slacshan/MIDI-Projects/Documentation/S25/Images/hex switch.jpg

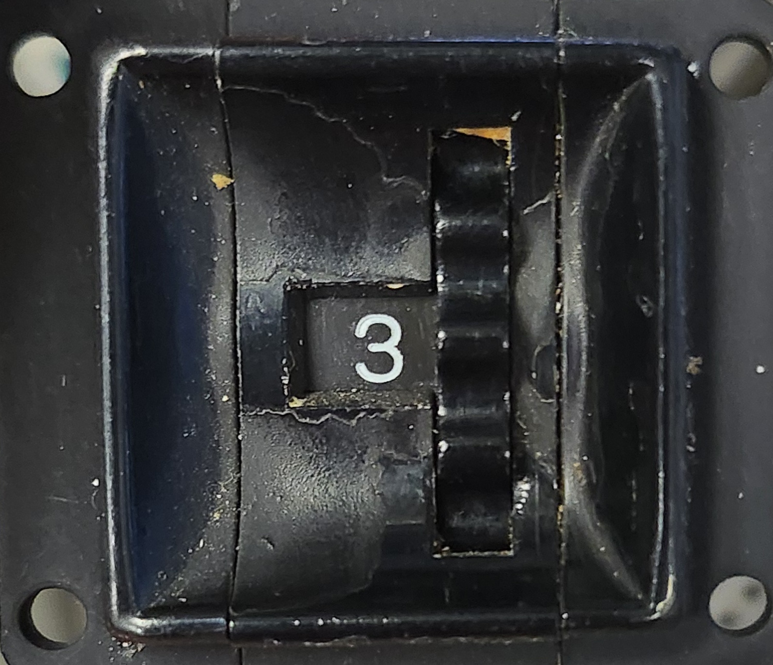
Documentation/S25/Images/hex switch.jpg
