slacshan/MIDI-Projects/Documentation/F25/BOMPt1.pdf

Category | Item Name | Quantity | Unit | Price | Subtotal | CWT Price
| Diode, 0805 | 27 | Each | 0.20 $ | 5.40 $ | 540.00 $
| Diode, LED, 0805 | 37 | Each | 0.91 $ | 33.67 $ | 3,367.00 $
| Diode, IR LED, | 4 | Each | 2.83 $ | 11.32 $ | 1,132.00 $
| Connector, RJ11 | 8 | Each | 1.02 $ | 8.16 $ | 816.00 $
| Connector, MIDI, DIN 5 | 4 | Each | 4.98 $ | 19.92 $ | 1,992.00 $
| Connector, Locking 2 Pin Molex, Board THT F | 53 | Each | 1.67 $ | 88.51 $ | 8,851.00 $
| Connector, Locking 2 Pin Molex, Crimp F | 12 | Each | 0.33 $ | 3.96 $ | 396.00 $
| Connector, Locking 2 Pin Molex, Crimp M | 46 | Each | 0.34 $ | 15.64 $ | 1,564.00 $
| Connector, Locking 8 Pin Molex, Board SMD F | 14 | Each | 3.69 $ | 51.66 $ | 5,166.00 $
| Connector, Locking 8 Pin Molex, Crimp M | 12 | Each | 0.54 $ | 6.48 $ | 648.00 $
| Pin, Molex, F | 188 | Each | 0.10 $ | 18.80 $ | 1,880.00 $
| Pin, Molex, M | 24 | Each | 0.10 $ | 2.40 $ | 240.00 $
| Capacitor, 10µF, Radial THT | 3 | Each | 0.29 $ | 0.87 $ | 87.00 $
| Header, 100mils | 28 | Row of 30 | 4.51 $ | 4.51 $ | 451.00 $
| Resistor, 2Ω, 2W | 8 | Each | 5.87 $ | 46.96 $ | 4,696.00 $
| Resistor, 330Ω, 0805 | 5 | Each | 0.33 $ | 1.65 $ | 165.00 $
| Resistor, 330Ω, SIP | 4 | Each | 4.28 $ | 17.12 $ | 1,712.00 $
| Resistor, 1KΩ, 0805 | 48 | Each | 0.25 $ | 12.00 $ | 1,200.00 $
| Resistor, 1KΩ, SIP | 1 | Each | 2.43 $ | 2.43 $ | 243.00 $
| Resistor, 2.2KΩ, 0805 | 6 | Each | 0.10 $ | 0.60 $ | 60.00 $
| Resistor, 10KΩ, 0805 | 4 | Each | 0.49 $ | 1.96 $ | 196.00 $
| Resistor, 10KΩ, SIP | 1 | Each | 2.53 $ | 2.53 $ | 253.00 $
| MOSFET, IRF540N, TO-220 | 24 | Each | 1.75 $ | 42.00 $ | 4,200.00 $
| MOSFET, MCP14E3, SOIC | 2 | Each | 2.35 $ | 4.70 $ | 470.00 $
| Switch, Push Button, THT | 3 | Each | 0.31 $ | 0.93 $ | 93.00 $
| Switch, SPST, 8 Pin DIP | 2 | Each | 0.59 $ | 1.18 $ | 118.00 $
| Crystal, 1MHz, DIP | 1 | Each | 3.45 $ | 3.45 $ | 345.00 $
| Opto-Isolator, LTV-247 | 6 | Each | 1.10 $ | 6.60 $ | 660.00 $
| Microprocessor, PIC16F1788, SOIC | 3 | Each | 2.63 $ | 7.89 $ | 789.00 $
| Wire, 22AWG, Solid | 110 | Feet | 1.17 $ | 128.70 $ | $ 12,870.00
| PCB, Universal Master | 1 | Each | 3.36 $ | 3.36 $ | 336.00 $
| | 2 | Each | 2.99 $ | 5.98 $ | 598.00 $

PCB, Universal Slave Electrical Page 89
