slacshan/MIDI-Projects/Documentation/F25/BOMPt2.pdf

Category | Item Name | Quantity | Unit | Price | Subtotal | CWT Price
| PCB, Universal Solenoid Relay | 6 | Each | 3.14 $ | 18.84 $ | 1,884.00 $
| PCB, MIDI IR Tx | 1 | Each | 3.79 $ | 3.79 $ | 379.00 $
| 2020 Extrusion Aluminnium, Black | 14 | Feet | 4.50 $ | 63.00 $ | 6,300.00 $
| Bolt, M5 x 10mm | 72 | Pack of 25 | 9.96 $ | 29.88 $ | 2,988.00 $
| Nut, M5 2020 extrusion nut | 72 | Pack of 100 | 9.99 $ | 9.99 $ | 999.00 $
| Bolt, M4 x 6mm | 48 | Pack of 100 | 11.71 $ | 11.71 $ | 585.50 $
| Bolt, M3 x 5mm | 24 | Pack of 100 | 11.91 $ | 11.91 $ | 297.75 $
| Insert, M3 | 40 | Pack of 100 | 20.44 $ | 20.44 $ | 1,022.00 $
| Insert, 1/4"-20 | 4 | Pack of 25 | 6.67 $ | 6.67 $ | 133.40 $
| Bolt, 1/4"-20 x 3/4" | 4 | Pack of 100 | 6.90 $ | 6.90 $ | 34.50 $
| Solenoid, 25N | 24 | Each | 28.44 $ | 682.56 $ | $ 68,256.00
| Solenoid, 5N | 12 | Each | 5.00 $ | 60.00 $ | 6,000.00 $
| Bass Guitar | 1 | Each | 122.99 $ | 122.99 $ | $ 12,299.00
| Payden Hardware Filament, 1.75mm | 324 | Grams, 1Kg Spool | 15.99 $ | 15.99 $ | 1,599.00 $
| Bolt, M2 x 12mm | 24 | Pack of 100 | 16.79 $ | 16.79 $ | 402.96 $
| Nut, M2 | 24 | Pack of 50 | 7.35 $ | 7.35 $ | 367.50 $
| Weather stripping, 3/8" | 3.5 | Feet, 20ft Roll | 9.49 $ | 9.49 $ | 56.94 $
| | 3 | Feet, 1000ft Roll | 364.86 $ | 364.86 $ | 364.86 $
| Cable, 4 Wire, 18 AWG Labor Justin | 174 | Hours | 50.00 $ | $ 8,700.00 | $ 8,700.00
| Brandon | 66 | Hours | 50.00 $ | $ 3,300.00 | $ 3,300.00
| Jason | 84 | Hours | 50.00 $ | $ 4,200.00 | $ 4,200.00
| | 104 | Hours | 50.00 $ | $ 5,200.00 | $ 5,200.00

Electrical Page 90
