slacshan/MIDI-Projects/BassGuitar/Programming/F25/Pluck&MuteFlowCharts.png

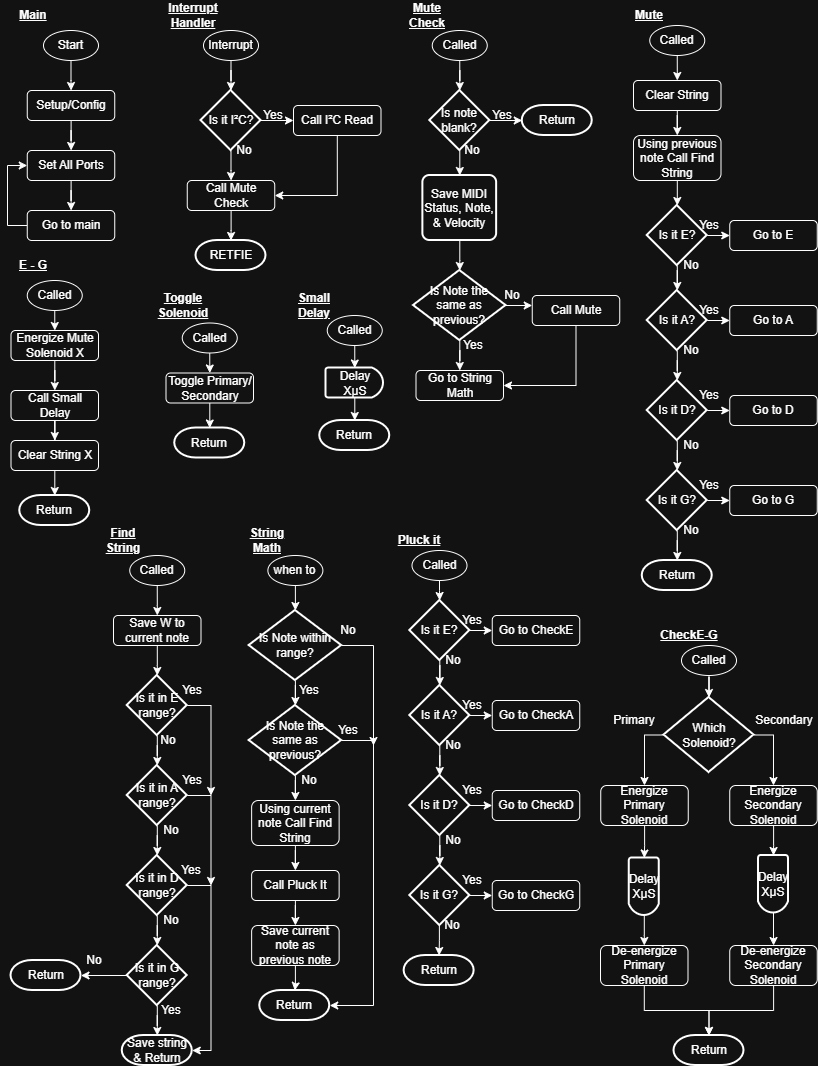
BassGuitar/Programming/F25/Pluck&MuteFlowCharts.png
