slacshan/MIDI-Projects/Documentation/F25/Time Sheet Jason Permann.png

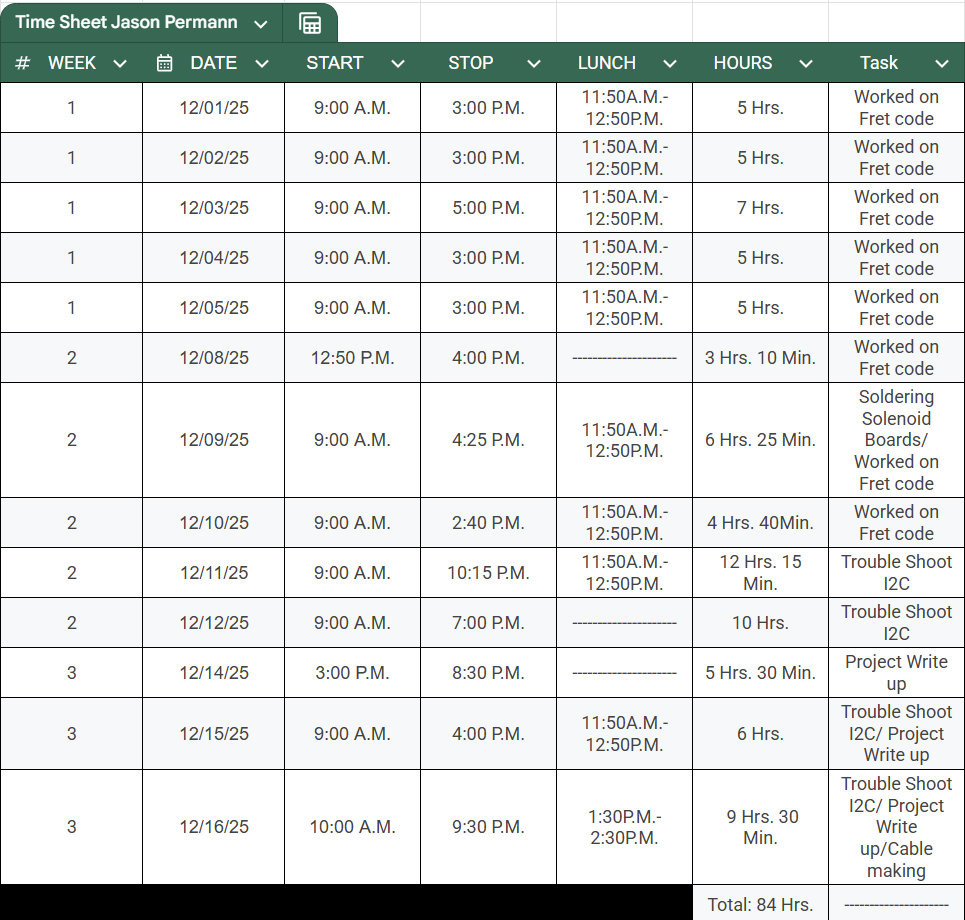
Documentation/F25/Time Sheet Jason Permann.png
