slacshan/MIDI-Projects/Documentation/S25/Images/I2C TP.png

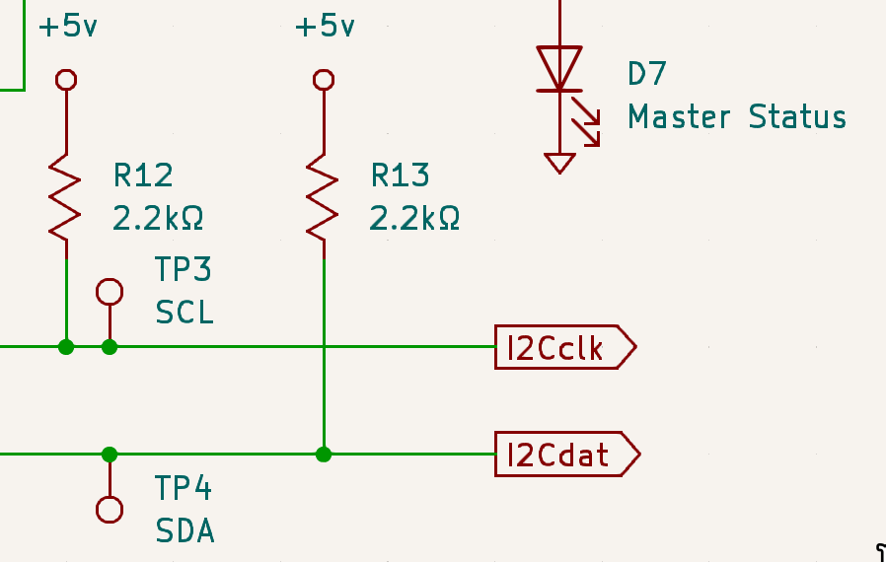
Documentation/S25/Images/I2C TP.png
