slacshan/MIDI-Projects/Documentation/S25/Images/I2C waveform.jpg

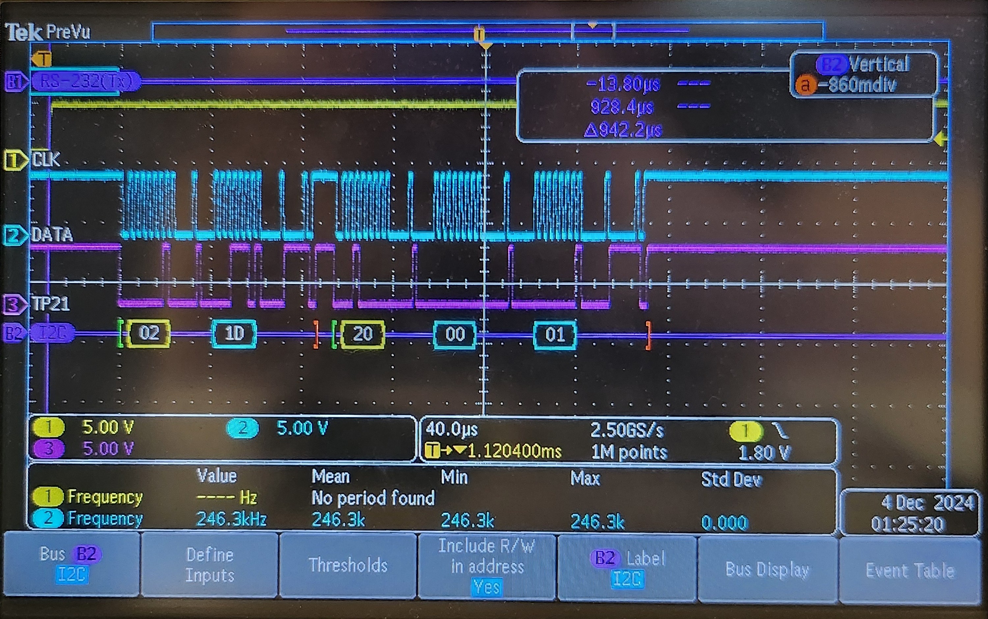
Documentation/S25/Images/I2C waveform.jpg
