slacshan/MIDI-Projects/Documentation/S25/Images/MIDI TP.png

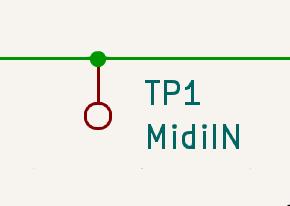
Documentation/S25/Images/MIDI TP.png
