slacshan/MIDI-Projects/Documentation/S25/Images/Midi Waveform.jpg

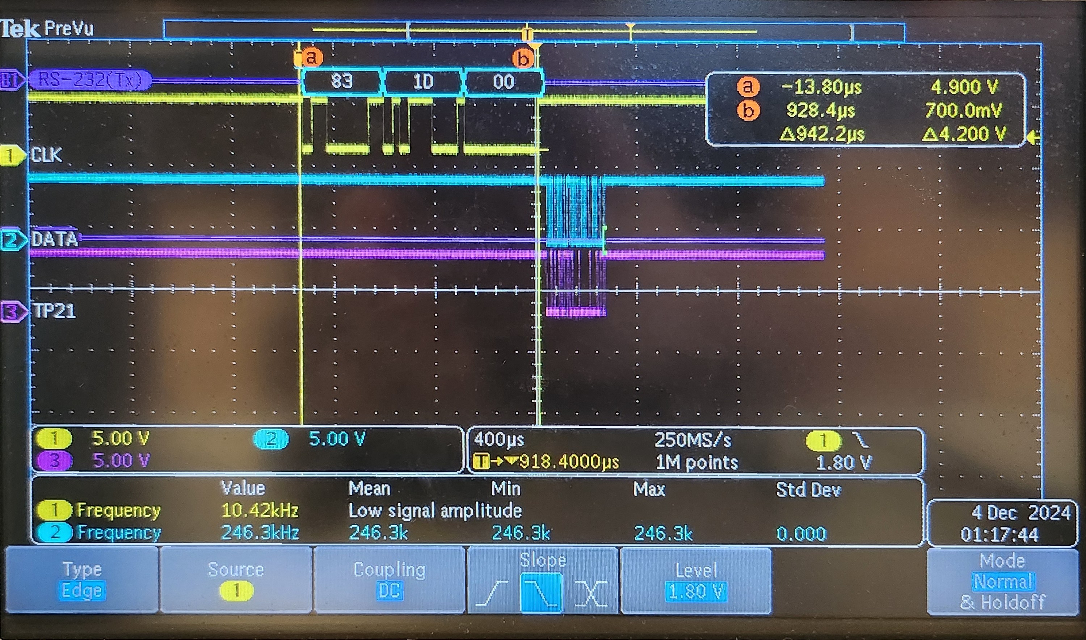
Documentation/S25/Images/Midi Waveform.jpg
