slacshan/MIDI-Projects/Documentation/S25/Images/P-bass CAD asm.png

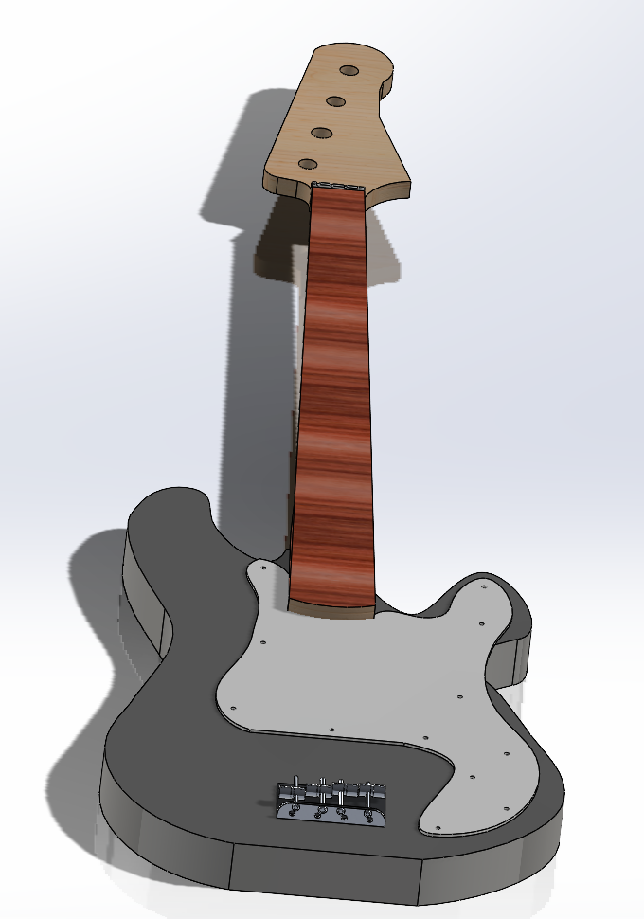
Documentation/S25/Images/P-bass CAD asm.png
