slacshan/MIDI-Projects/Documentation/S25/Images/Plucking Output.png

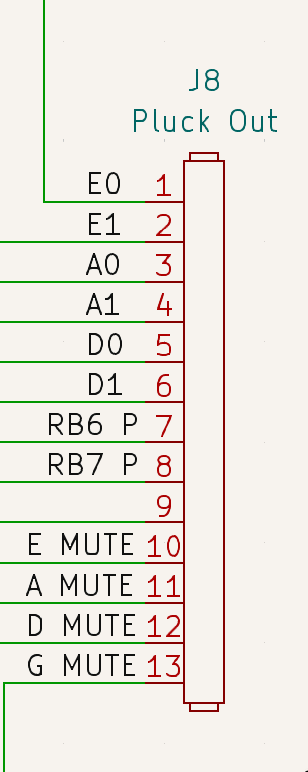
Documentation/S25/Images/Plucking Output.png
