slacshan/MIDI-Projects/Documentation/S25/Images/Plucking Program Flowchart.png

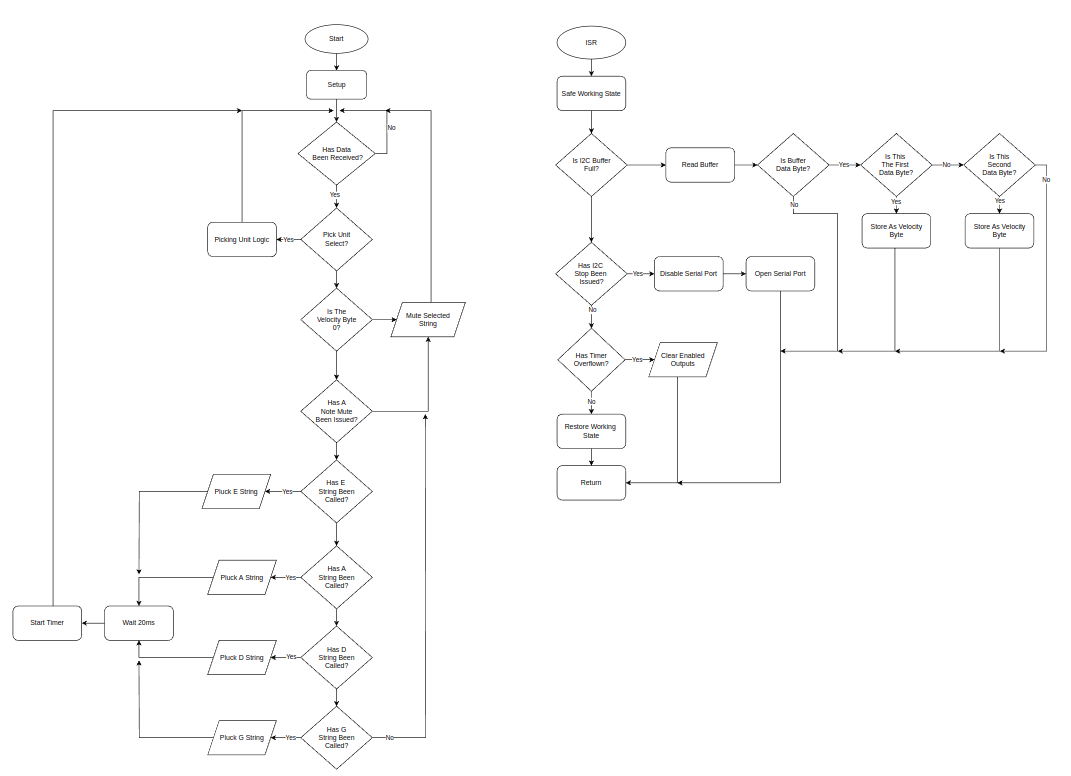
Documentation/S25/Images/Plucking Program Flowchart.png
