slacshan/MIDI-Projects/Documentation/S25/Images/Plucking Unit Flowchart.png

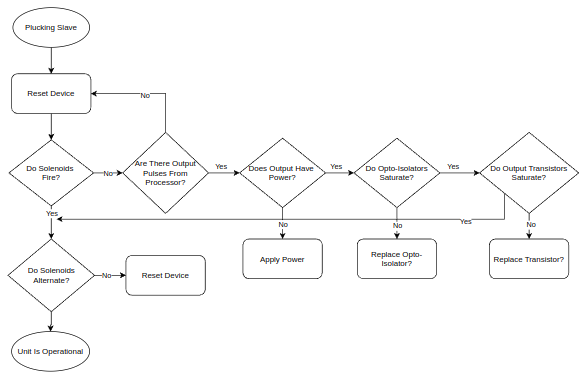
Documentation/S25/Images/Plucking Unit Flowchart.png
