slacshan/MIDI-Projects/Documentation/S25/Images/String Output.png

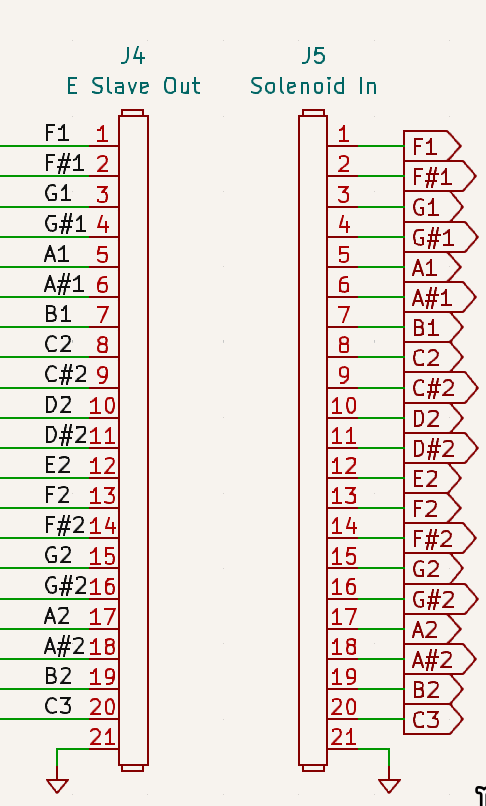
Documentation/S25/Images/String Output.png
