slacshan/MIDI-Projects/Documentation/S25/Images/String Slave Flowchart.png

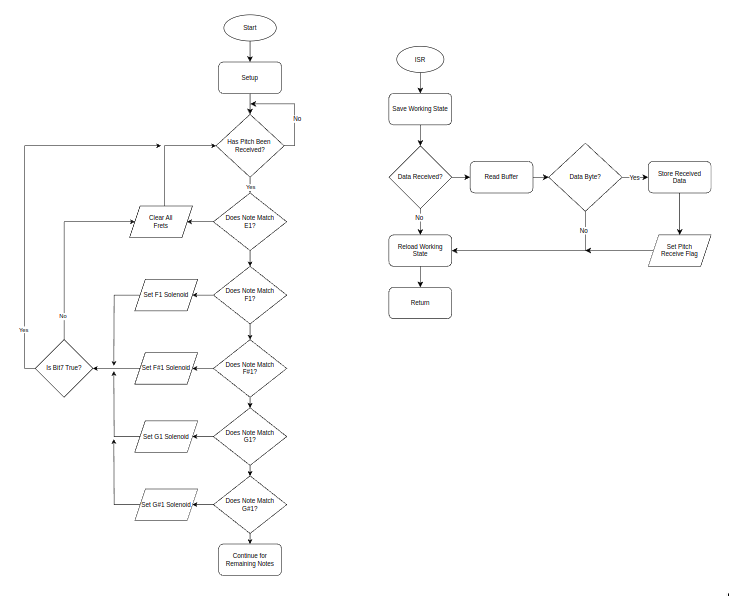
Documentation/S25/Images/String Slave Flowchart.png
