slacshan/MIDI-Projects/Documentation/F25/BOM.xlsx

Sheet: Sheet1
Category | Item Name | Quantity | Unit | Price | Subtotal | CWT Price | Vender Name/ID | Vendor | Item Link
 | Diode, 0805 | 27 | Each | $0.20 | $5.40 | $540.00 | 478-SD0805S040S1R0CT-ND | Digikey | https://www.digikey.com/en/products/detail/kyocera-avx/SD0805S040S1R0/13557251
 | Diode, LED, 0805 | 37 | Each | $0.91 | $33.67 | $3367.00 | 607-CMDA5AR7D1S | Mouser | https://www.mouser.com/ProductDetail/VCC/CMDA5AR7D1S?qs=sGAEpiMZZMvVL5Kk7ZYykXsk1Jcl2Lhjdx6FZebcgbk%3D
 | Diode, IR LED, | 4 | Each | $2.83 | $11.32 | $1132.00 | 78-VSMA1094250 | Mouser | https://www.mouser.com/ProductDetail/Vishay-Semiconductors/VSMA1094250?qs=pBJMDPsKWf2rcBfgrt%252BzqQ%3D%3D
 | Connector, RJ11 | 8 | Each | $1.02 | $8.16 | $816.00 | 710-615004141121 | Mouser | https://www.mouser.com/ProductDetail/710-615004141121
 | Connector, MIDI, DIN 5 | 4 | Each | $4.98 | $19.92 | $1992.00 | 502-57PC5F | Mouser | https://www.mouser.com/ProductDetail/Switchcraft/57PC5F?qs=MW%252B0w7tSdpkWuZd7MBoFPA%3D%3D
 | Connector, Locking 2 Pin Molex, Board THT F | 53 | Each | $1.67 | $88.51 | $8851.00 | WM1819-ND | Digikey | https://www.digikey.com/en/products/detail/molex/0430450202/252532
 | Connector, Locking 2 Pin Molex, Crimp F | 12 | Each | $0.33 | $3.96 | $396.00 | WM2761-ND | Digikey | https://www.digikey.com/en/products/detail/molex/0430200201/1132437
 | Connector, Locking 2 Pin Molex, Crimp M | 46 | Each | $0.34 | $15.64 | $1564.00 | WM1783-ND | Digikey | https://www.digikey.com/en/products/detail/molex/0430250200/252496
 | Connector, Locking 8 Pin Molex, Board SMD F | 14 | Each | $3.69 | $51.66 | $5166.00 | WM1828CT-ND | Digikey | https://www.digikey.com/en/products/detail/molex/0430450809/3660014
 | Connector, Locking 8 Pin Molex, Crimp M | 12 | Each | $0.54 | $6.48 | $648.00 | WM1786-ND | Digikey | https://www.digikey.com/en/products/detail/molex/0430250800/252499
 | Pin, Molex, F | 188 | Each | $0.10 | $18.80 | $1880.00 | WM1837CT-ND | Digikey | https://www.digikey.com/en/products/detail/molex/0430300001/467796
 | Pin, Molex, M | 24 | Each | $0.10 | $2.40 | $240.00 | WM1841CT-ND | Digikey | https://www.digikey.com/en/products/detail/molex/0430310001/467798?s=N4IgTCBcDaIOoFkCMAOALEgwgFQLQDkAREAXQF8g
 | Capacitor, 10µF, Radial THT | 3 | Each | $0.29 | $0.87 | $87.00 | 1189-2322-ND | Digikey | https://www.digikey.com/en/products/detail/rubycon/50YXJ10M5X11/3562914
 | Header, 100mils | 28 | Row of 30 | $4.51 | $4.51 | $451.00 | 612-TS-130-T-A-1-ND | Digikey | https://www.digikey.com/en/products/detail/samtec-inc/TS-130-T-A-1/9774113
Electrical | Resistor, 2Ω, 2W | 8 | Each | $5.87 | $46.96 | $4696.00 | 652-PWR220T-20-2R00F | Mouser | https://www.mouser.com/ProductDetail/Bourns/PWR220T-20-2R00F?qs=sGAEpiMZZMtlubZbdhIBIIFas8kKGM5fidmq4iLVFG8%3D
 | Resistor, 330Ω, 0805 | 5 | Each | $0.33 | $1.65 | $165.00 | 594-MCU08050C3300FP5 | Mouser | https://www.mouser.com/ProductDetail/Vishay-Beyschlag/MCU08050C3300FP500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
 | Resistor, 330Ω, SIP | 4 | Each | $4.28 | $17.12 | $1712.00 | 652-4309R-1LF-330 | Mouser | https://www.mouser.com/ProductDetail/Bourns/4309R-101-331LF?qs=RXY66VkWzhTIgmSSRT6%2FDg%3D%3D
 | Resistor, 1KΩ, 0805 | 48 | Each | $0.25 | $12.00 | $1200.00 | 667-ERA-6AED102V | Mouser | https://www.mouser.com/ProductDetail/Panasonic/ERA-6AED102V
 | Resistor, 1KΩ, SIP | 1 | Each | $2.43 | $2.43 | $243.00 | 71-CSC09A011K00FEK | Mouser | https://www.mouser.com/ProductDetail/Vishay-Dale/CSC09A011K00FEK?qs=OgjFRtkRU9G%252B5xvKRBL7NA%3D%3D
 | Resistor, 2.2KΩ, 0805 | 6 | Each | $0.10 | $0.60 | $60.00 | 667-ERA-6AED222V | Mouser | https://www.mouser.com/ProductDetail/Panasonic/ERA-6AED222V?qs=sGAEpiMZZMvdGkrng054t5mej2KPdPuFyxnSeBnKqrg%3D
 | Resistor, 10KΩ, 0805 | 4 | Each | $0.49 | $1.96 | $196.00 | 594-MCU0805MD1002BP5 | Mouser | https://www.mouser.com/ProductDetail/Vishay-Beyschlag/MCU0805MD1002BP500
 | Resistor, 10KΩ, SIP | 1 | Each | $2.53 | $2.53 | $253.00 | 71-CSC09A0110K0GEK | Mouser | https://www.mouser.com/ProductDetail/Vishay-Dale/CSC09A0110K0GEK?qs=Jzz%252BfO4IBMfusae2i1IhQQ%3D%3D | For Presentation
 | MOSFET, IRF540N, TO-220 | 24 | Each | $1.75 | $42.00 | $4200.00 | IRF540NPBF-ND | Digikey | https://www.digikey.com/en/products/detail/infineon-technologies/IRF540NPBF/811869 | Electronics | $583.97
 | MOSFET, MCP14E3, SOIC | 2 | Each | $2.35 | $4.70 | $470.00 | MCP14E3-E/SN-ND | Digikey | https://www.digikey.com/en/products/detail/microchip-technology/MCP14E3-E-SN/1680842 | Hardware | $1440.53
 | Switch, Push Button, THT | 3 | Each | $0.31 | $0.93 | $93.00 | 506-FSM2JSMAATR | Mouser | https://www.mouser.com/ProductDetail/TE-Connectivity-Alcoswitch/FSM2JSMAATR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 | Labor | $21400.00
 | Switch, SPST, 8 Pin DIP | 2 | Each | $0.59 | $1.18 | $118.00 | CT2104MS-ND | Digikey | https://www.digikey.com/en/products/detail/cts-electrocomponents/210-4MS/2503781 | Total | $23424.50
 | Crystal, 1MHz, DIP | 1 | Each | $3.45 | $3.45 | $345.00 | 110-MXO45HST-3C-1M000000-ND | Digikey | https://www.digikey.com/en/products/detail/cts-frequency-controls/MXO45HST-3C-1M000000/1801908
 | Opto-Isolator, LTV-247 | 6 | Each | $1.10 | $6.60 | $660.00 | 160-2255-1-ND | Digikey | https://www.digikey.com/en/products/detail/liteon/LTV-247/4307982?s=N4IgTCBcDaIDYBcBuBaMAWA7CAugXyA
 | Microprocessor, PIC16F1788, SOIC | 3 | Each | $2.63 | $7.89 | $789.00 | PIC16F1788-I/SO-ND | Digikey | https://www.digikey.com/en/products/detail/microchip-technology/PIC16F1788-I-SO/4080106
 | Wire, 22AWG, Solid | 110 | Feet | $1.17 | $128.70 | $12870.00 | 566-83049-100-06 | Mouser | https://www.mouser.com/ProductDetail/Belden-Wire-Cable/83049-006100?qs=OVCqYLLnee0zC1gM5G5Wqw%3D%3D
 | PCB, Universal Master | 1 | Each | $3.36 | $3.36 | $336.00 | JB_MIDI_Master | All PCB | N/A
 | PCB, Universal Slave | 2 | Each | $2.99 | $5.98 | $598.00 | JB_MIDI_Slave | PCB way | N/A
 | PCB, Universal Solenoid Relay | 6 | Each | $3.14 | $18.84 | $1884.00 | JB_Solenoid | PCB way | N/A
 | PCB, MIDI IR Tx | 1 | Each | $3.79 | $3.79 | $379.00 | JB_IR_Tx | PCB way | N/A
Hardware | 2020 Extrusion Aluminnium, Black | 14 | Feet | $4.50 | $63.00 | $6300.00 | B08Y8M383Q | Amazon | https://www.amazon.com/Aluminum-Extrusion-European-Standard-15-75inch/dp/B08Y8M383Q
 | Bolt, M5 x 10mm | 72 | Pack of 25 | $9.96 | $29.88 | $2988.00 | 92137A414 | McMASTER-CARR | https://www.mcmaster.com/92137A414/
 | Nut, M5 2020 extrusion nut | 72 | Pack of 100 | $9.99 | $9.99 | $999.00 |  | Amazon | https://www.amazon.com/Yaocom-European-Standard-Aluminum-Extrusion/dp/B0DX7B5ZNN
 | Bolt, M4 x 6mm | 48 | Pack of 100 | $11.71 | $11.71 | $585.50 | 91290A139 | McMASTER-CARR | https://www.mcmaster.com/91290A139/
 | Bolt, M3 x 5mm | 24 | Pack of 100 | $11.91 | $11.91 | $297.75 | 91290A110 | McMASTER-CARR | https://www.mcmaster.com/91290A110/
 | Insert, M3 | 40 | Pack of 100 | $20.44 | $20.44 | $1022.00 | 94180A331 | McMASTER-CARR | https://www.mcmaster.com/94180A331/
 | Insert, 1/4"-20 | 4 | Pack of 25 | $6.67 | $6.67 | $133.40 | 92105A208 | McMASTER-CARR | https://www.mcmaster.com/92105A208/
 | Bolt, 1/4"-20 x 3/4" | 4 | Pack of 100 | $6.90 | $6.90 | $34.50 | 91309A540 | McMASTER-CARR | https://www.mcmaster.com/91309A540/
 | Solenoid, 25N | 24 | Each | $28.44 | $682.56 | $68256.00 | B0DJVL6MHG | Amazon | https://www.amazon.com/AARTERZZA-JF-1039B-Push-Pull-Solenoid-Electromagnet/dp/B0DJVL6MHG?th=1
 | Solenoid, 5N | 12 | Each | $5.00 | $60.00 | $6000.00 | B07V3JRDLJ | Amazon | https://www.amazon.com/JF-0530B-gangbei-0530B-Electromagnet-keepping-Solenoid/dp/B07V3JRDLJ?th=1
 | Bass Guitar | 1 | Each | $122.99 | $122.99 | $12299.00 | B09CTHDSCM | Amazon | https://www.amazon.com/GLARRY-Electric-Beginner-Exquisite-Accessories/dp/B09CTHDSCM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
 | Filament, 1.75mm | 324 | Grams, 1Kg Spool | $15.99 | $15.99 | $1599.00 | B0C3J1X41K | Amazon | https://www.amazon.com/SUNLU-Printer-Filament-Dimensional-Clear/dp/B0C3J1X41K
 | Bolt, M2 x 12mm | 24 | Pack of 100 | $16.79 | $16.79 | $402.96 | 91290A019 | McMASTER-CARR | https://www.mcmaster.com/91290A019/
 | Nut, M2 | 24 | Pack of 50 | $7.35 | $7.35 | $367.50 | 90593A024 | McMASTER-CARR | https://www.mcmaster.com/90593A024/
 | Weather stripping, 3/8" | 3.5 | Feet, 20ft Roll | $9.49 | $9.49 | $56.94 | B0DHZ3M2PP | Amazon | https://www.amazon.com/Weather-Stripping-Adhesive-Silicone-Shaped/dp/B0DHZ3M2PP
 | Cable, 4 Wire, 18 AWG | 3 | Feet, 1000ft Roll | $364.86 | $364.86 | $364.86 | CE2204SN-41-1000-ND | Digikey | https://www.digikey.com/en/products/detail/encore-wire/E2204S-41-86/618553
Labor | Justin | 174 | Hours | $50.00 | $8700.00 | $8700.00 | N/A | N/A | N/A
 | Brandon | 66 | Hours | $50.00 | $3300.00 | $3300.00 | N/A | N/A | N/A
 | Jason | 84 | Hours | $50.00 | $4200.00 | $4200.00 | N/A | N/A | N/A
 | Payden | 104 | Hours | $50.00 | $5200.00 | $5200.00 | N/A | N/A | N/A

Sheet: Print1
Page 89 | Category | Item Name | Quantity | Unit | Price | Subtotal | CWT Price
 | Electrical | Diode, 0805 | 27 | Each | $0.20 | $5.40 | $540.00
 |  | Diode, LED, 0805 | 37 | Each | $0.91 | $33.67 | $3367.00
 |  | Diode, IR LED, | 4 | Each | $2.83 | $11.32 | $1132.00
 |  | Connector, RJ11 | 8 | Each | $1.02 | $8.16 | $816.00
 |  | Connector, MIDI, DIN 5 | 4 | Each | $4.98 | $19.92 | $1992.00
 |  | Connector, Locking 2 Pin Molex, Board THT F | 53 | Each | $1.67 | $88.51 | $8851.00
 |  | Connector, Locking 2 Pin Molex, Crimp F | 12 | Each | $0.33 | $3.96 | $396.00
 |  | Connector, Locking 2 Pin Molex, Crimp M | 46 | Each | $0.34 | $15.64 | $1564.00
 |  | Connector, Locking 8 Pin Molex, Board SMD F | 14 | Each | $3.69 | $51.66 | $5166.00
 |  | Connector, Locking 8 Pin Molex, Crimp M | 12 | Each | $0.54 | $6.48 | $648.00
 |  | Pin, Molex, F | 188 | Each | $0.10 | $18.80 | $1880.00
 |  | Pin, Molex, M | 24 | Each | $0.10 | $2.40 | $240.00
 |  | Capacitor, 10µF, Radial THT | 3 | Each | $0.29 | $0.87 | $87.00
 |  | Header, 100mils | 28 | Row of 30 | $4.51 | $4.51 | $451.00
 |  | Resistor, 2Ω, 2W | 8 | Each | $5.87 | $46.96 | $4696.00
 |  | Resistor, 330Ω, 0805 | 5 | Each | $0.33 | $1.65 | $165.00
 |  | Resistor, 330Ω, SIP | 4 | Each | $4.28 | $17.12 | $1712.00
 |  | Resistor, 1KΩ, 0805 | 48 | Each | $0.25 | $12.00 | $1200.00
 |  | Resistor, 1KΩ, SIP | 1 | Each | $2.43 | $2.43 | $243.00
 |  | Resistor, 2.2KΩ, 0805 | 6 | Each | $0.10 | $0.60 | $60.00
 |  | Resistor, 10KΩ, 0805 | 4 | Each | $0.49 | $1.96 | $196.00
 |  | Resistor, 10KΩ, SIP | 1 | Each | $2.53 | $2.53 | $253.00
 |  | MOSFET, IRF540N, TO-220 | 24 | Each | $1.75 | $42.00 | $4200.00
 |  | MOSFET, MCP14E3, SOIC | 2 | Each | $2.35 | $4.70 | $470.00
 |  | Switch, Push Button, THT | 3 | Each | $0.31 | $0.93 | $93.00
 |  | Switch, SPST, 8 Pin DIP | 2 | Each | $0.59 | $1.18 | $118.00
 |  | Crystal, 1MHz, DIP | 1 | Each | $3.45 | $3.45 | $345.00
 |  | Opto-Isolator, LTV-247 | 6 | Each | $1.10 | $6.60 | $660.00
 |  | Microprocessor, PIC16F1788, SOIC | 3 | Each | $2.63 | $7.89 | $789.00
 |  | Wire, 22AWG, Solid | 110 | Feet | $1.17 | $128.70 | $12870.00
 |  | PCB, Universal Master | 1 | Each | $3.36 | $3.36 | $336.00
 |  | PCB, Universal Slave | 2 | Each | $2.99 | $5.98 | $598.00

Sheet: Print2
Page 90
 | Category | Item Name | Quantity | Unit | Price | Subtotal | CWT Price
 | Electrical | PCB, Universal Solenoid Relay | 6 | Each | $3.14 | $18.84 | $1884.00
 |  | PCB, MIDI IR Tx | 1 | Each | $3.79 | $3.79 | $379.00
 | Hardware | 2020 Extrusion Aluminnium, Black | 14 | Feet | $4.50 | $63.00 | $6300.00
 |  | Bolt, M5 x 10mm | 72 | Pack of 25 | $9.96 | $29.88 | $2988.00
 |  | Nut, M5 2020 extrusion nut | 72 | Pack of 100 | $9.99 | $9.99 | $999.00
 |  | Bolt, M4 x 6mm | 48 | Pack of 100 | $11.71 | $11.71 | $585.50
 |  | Bolt, M3 x 5mm | 24 | Pack of 100 | $11.91 | $11.91 | $297.75
 |  | Insert, M3 | 40 | Pack of 100 | $20.44 | $20.44 | $1022.00
 |  | Insert, 1/4"-20 | 4 | Pack of 25 | $6.67 | $6.67 | $133.40
 |  | Bolt, 1/4"-20 x 3/4" | 4 | Pack of 100 | $6.90 | $6.90 | $34.50
 |  | Solenoid, 25N | 24 | Each | $28.44 | $682.56 | $68256.00
 |  | Solenoid, 5N | 12 | Each | $5.00 | $60.00 | $6000.00
 |  | Bass Guitar | 1 | Each | $122.99 | $122.99 | $12299.00
 |  | Filament, 1.75mm | 324 | Grams, 1Kg Spool | $15.99 | $15.99 | $1599.00
 |  | Bolt, M2 x 12mm | 24 | Pack of 100 | $16.79 | $16.79 | $402.96
 |  | Nut, M2 | 24 | Pack of 50 | $7.35 | $7.35 | $367.50
 |  | Weather stripping, 3/8" | 3.5 | Feet, 20ft Roll | $9.49 | $9.49 | $56.94
 |  | Cable, 4 Wire, 18 AWG | 3 | Feet, 1000ft Roll | $364.86 | $364.86 | $364.86
 | Labor | Justin | 174 | Hours | $50.00 | $8700.00 | $8700.00
 |  | Brandon | 66 | Hours | $50.00 | $3300.00 | $3300.00
 |  | Jason | 84 | Hours | $50.00 | $4200.00 | $4200.00
 |  | Payden | 104 | Hours | $50.00 | $5200.00 | $5200.00
