slacshan/MIDI-Projects/BassGuitar/Circuitry/S25/MotherBoard/KicadBOM.ods

Reference | Value | Datasheet | Footprint | Qty | DNP
C1,C2,C3,C4,C5,C6 | 10uF |  | Capacitor_SMD:C_0805_2012Metric_Pad1.18x1.45mm_HandSolder | 6
C7,C9 | 100uF |  |  | 2
C8,C10 | 0.1uF |  |  | 2
D1 | LED | ~ | Diode_SMD:D_0805_2012Metric_Pad1.15x1.40mm_HandSolder | 1
D2 | 8 | ~ | Diode_SMD:D_0805_2012Metric_Pad1.15x1.40mm_HandSolder | 1
D3 | 4 | ~ | Diode_SMD:D_0805_2012Metric_Pad1.15x1.40mm_HandSolder | 1
D4 | 2 | ~ | Diode_SMD:D_0805_2012Metric_Pad1.15x1.40mm_HandSolder | 1
D5,D8,D11,D14,D17,D20 | 4148 |  | Diode_SMD:D_0805_2012Metric_Pad1.15x1.40mm_HandSolder | 6
D6 | 1 | ~ | Diode_SMD:D_0805_2012Metric_Pad1.15x1.40mm_HandSolder | 1
D7 | Master Status | ~ | Diode_SMD:D_0805_2012Metric_Pad1.15x1.40mm_HandSolder | 1
D9 | E Status | ~ | Diode_SMD:D_0805_2012Metric_Pad1.15x1.40mm_HandSolder | 1
D10 | E Active | ~ | Diode_SMD:D_0805_2012Metric_Pad1.15x1.40mm_HandSolder | 1
D12 | Pluck Status | ~ | Diode_SMD:D_0805_2012Metric_Pad1.15x1.40mm_HandSolder | 1
D13 | Pluck Active | ~ | Diode_SMD:D_0805_2012Metric_Pad1.15x1.40mm_HandSolder | 1
D15 | A Status | ~ | Diode_SMD:D_0805_2012Metric_Pad1.15x1.40mm_HandSolder | 1
D16 | A Active | ~ | Diode_SMD:D_0805_2012Metric_Pad1.15x1.40mm_HandSolder | 1
D18 | D Status | ~ | Diode_SMD:D_0805_2012Metric_Pad1.15x1.40mm_HandSolder | 1
D19 | D Active | ~ | Diode_SMD:D_0805_2012Metric_Pad1.15x1.40mm_HandSolder | 1
D21 | G Status | ~ | Diode_SMD:D_0805_2012Metric_Pad1.15x1.40mm_HandSolder | 1
D22 | G Active | ~ | Diode_SMD:D_0805_2012Metric_Pad1.15x1.40mm_HandSolder | 1
J1 | DIN-5 | http://www.mouser.com/ds/2/18/40_c091_abd_e-75918.pdf |  | 1
J2 | Master ISCP |  | Connector_PinHeader_2.54mm:PinHeader_1x06_P2.54mm_Vertical | 1
J3 | E SLAVE ISCP |  | Connector_PinHeader_2.54mm:PinHeader_1x06_P2.54mm_Vertical | 1
J4 | E Slave Out |  |  | 1
J5 | Solenoid In |  |  | 1
J6,J10 | A SLAVE ISCP |  | Connector_PinHeader_2.54mm:PinHeader_1x06_P2.54mm_Vertical | 2
J7 | Pick Unit |  |  | 1
J8 | Pluck Out |  |  | 1
J9 | Pluck IN |  |  | 1
J11 | D SLAVE ISCP |  | Connector_PinHeader_2.54mm:PinHeader_1x06_P2.54mm_Vertical | 1
J12 | G SLAVE ISCP |  | Connector_PinHeader_2.54mm:PinHeader_1x06_P2.54mm_Vertical | 1
J13 | Power In |  |  | 1
L1,L2,L3,L4,L5,L6,L7,L8,L9,L10,L11,L12,L13,L14,L15,L16,L17,L18,L19,L20,L21,L22,L23,L24,L25,L26,L27,L28,L29,L30,L31,L32,L33,L34,L35,L36,L37,L38,L39,L40,L41,L42,L43,L44,L45,L46,L47,L48,L49,L50,L51,L52,L53,L54,L55,L56,L57,L58,L59,L60,L61,L62,L63,L64,L65,L66,L67,L68,L69,L70,L71,L72,L73,L74,L75,L76,L77,L78,L79,L80,L81,L82,L83,L84,L85,L86,L87,L88,L89,L90,L91,L92 | Solenoid | ~ |  | 92
L93 | 10uH | ~ |  | 1
Q1,Q2,Q3,Q4,Q5,Q6,Q7,Q8,Q9,Q10,Q11,Q12,Q13,Q14,Q15,Q16,Q17,Q18,Q19,Q20,Q21,Q22,Q23,Q24,Q25,Q26,Q27,Q28,Q29,Q30,Q31,Q32,Q33,Q34,Q35,Q36,Q37,Q38,Q39,Q40,Q41,Q42,Q43,Q44,Q45,Q46,Q47,Q48,Q49,Q50,Q51,Q52,Q53,Q54,Q55,Q56,Q57,Q58,Q59,Q60,Q61,Q62,Q63,Q64,Q65,Q66,Q67,Q68,Q69,Q70,Q71,Q72,Q73,Q74,Q75,Q76,Q77,Q78,Q79,Q80,Q81,Q82,Q83,Q84,Q85,Q86,Q87,Q88,Q89,Q90,Q91,Q92 | BDW93C | ~ | Package_TO_SOT_THT:TO-220-3_Vertical | 92
R1,R15,R58,R62,R66 | 10Ω |  | Resistor_SMD:R_0805_2012Metric_Pad1.20x1.40mm_HandSolder | 5
R2,R26,R27,R28,R29,R30,R31,R32,R33,R38,R39,R40,R41,R42,R43,R44,R45,R50,R51,R52,R53,R54,R55,R56,R57,R76,R77,R78,R79,R80,R81,R82,R83,R84,R85,R86,R87,R94,R95,R96,R97,R98,R99,R100,R101,R102,R103,R104,R105,R110,R111,R112,R113,R114,R115,R116,R117,R122,R123,R124,R125,R126,R127,R128,R129,R136,R137,R138,R139,R140,R141,R142,R143,R144,R145,R146,R147,R154,R155,R156,R157,R158,R159,R160,R161,R162,R163,R164,R165,R170,R171,R172,R173,R174,R175,R176,R177,R182,R183,R184,R185,R186,R187,R188,R189,R196,R197,R198,R199,R200,R201,R202,R203,R204,R205,R206,R207,R214,R215,R216,R217,R218,R219,R220,R221,R222,R223,R224,R225,R230,R231,R232,R233,R234,R235,R236,R237,R242,R243,R244,R245,R246,R247,R248,R249,R256,R257,R258,R259,R260,R261,R262,R263,R264,R265,R266,R267,R274,R275,R276,R277,R278,R279,R280,R281,R282,R283,R284,R285,R290,R291,R292,R293,R294,R295,R296,R297,R302,R303,R304,R305,R306,R307,R308,R309 | 1kΩ |  | Resistor_SMD:R_0805_2012Metric_Pad1.20x1.40mm_HandSolder | 185
R3,R4,R8,R11,R14,R17,R18,R20,R21,R60,R61,R64,R65,R68,R69 | 330Ω |  | Resistor_SMD:R_0805_2012Metric_Pad1.20x1.40mm_HandSolder | 15
R5,R6,R7,R9,R10,R16,R19,R59,R63,R67 | 10kΩ |  | Resistor_SMD:R_0805_2012Metric_Pad1.20x1.40mm_HandSolder | 10
R12,R13 | 2.2kΩ |  | Resistor_SMD:R_0805_2012Metric_Pad1.20x1.40mm_HandSolder | 2
R22,R23,R24,R25,R34,R35,R36,R37,R46,R47,R48,R49,R70,R71,R72,R73,R74,R75,R88,R89,R90,R91,R92,R93,R106,R107,R108,R109,R118,R119,R120,R121,R130,R131,R132,R133,R134,R135,R148,R149,R150,R151,R152,R153,R166,R167,R168,R169,R178,R179,R180,R181,R190,R191,R192,R193,R194,R195,R208,R209,R210,R211,R212,R213,R226,R227,R228,R229,R238,R239,R240,R241,R250,R251,R252,R253,R254,R255,R268,R269,R270,R271,R272,R273,R286,R287,R288,R289,R298,R299,R300,R301 | 4.7kΩ |  | Resistor_SMD:R_0805_2012Metric_Pad1.20x1.40mm_HandSolder | 92
SW1 | ~ |  | Connector_PinHeader_2.54mm:PinHeader_1x05_P2.54mm_Vertical | 1
SW2 | Master Reset | ~ | Button_Switch_THT:SW_PUSH_6mm_H5mm | 1
SW3 | E-slave Reset | ~ |  | 1
SW4 | A-slave Reset | ~ |  | 1
SW5 | D-slave Reset | ~ |  | 1
SW6 | G-slave Reset | ~ |  | 1
TP1 | MidiIN | ~ | Connector_PinHeader_2.54mm:PinHeader_1x01_P2.54mm_Vertical | 1
TP2 | Master CLKOUT | ~ | Connector_PinHeader_2.54mm:PinHeader_1x01_P2.54mm_Vertical | 1
TP3 | SCL | ~ | Connector_PinHeader_2.54mm:PinHeader_1x01_P2.54mm_Vertical | 1
TP4 | SDA | ~ | Connector_PinHeader_2.54mm:PinHeader_1x01_P2.54mm_Vertical | 1
TP5 | E CLKOUT | ~ |  | 1
TP6 | PLUCK CLKOUT | ~ |  | 1
TP7 | A CLKOUT | ~ |  | 1
TP8 | D CLKOUT | ~ |  | 1
TP9 | G CLKOUT | ~ |  | 1
TP10 | P-IN | ~ |  | 1
TP11 | 5v | ~ |  | 1
U1 | PIC16F1788 | http://ww1.microchip.com/downloads/en/DeviceDoc/41291D.pdf | OF footprints:SSOP-28 | 1
U2,U3,U8,U9,U10 | PIC16F1789 |  |  | 5
U4,U5,U6,U7,U11,U12,U13,U14,U15,U16,U17,U18,U19,U20,U21,U22,U23,U24,U25,U26,U27,U28,U29,U30 | LTV-247 | http://optoelectronics.liteon.com/upload/download/DS70-2009-0014/LTV-2X7%20sereis%20Mar17.PDF | Package_SO:SOP-16_4.4x10.4mm_P1.27mm | 24
U31 | LM1117MP-1.8 | http://www.ti.com/lit/ds/symlink/lm1117.pdf | Package_TO_SOT_SMD:SOT-223-3_TabPin2 | 1
