slacshan/MIDI-Projects/Documentation/F25/JustinHours.xlsx

Week# | Date | In | Out | Time | Description
1 | 2025-10-20 | 11:00:00 | 12:00:00 | 1 | IR Tx Board Design
1 | 2025-10-20 | 12:30:00 | 14:50:00 | 2.333 | IR Tx Board Design | Part | Link
1 | 2025-10-21 | 11:00:00 | 11:33:00 | 0.550 | IR Tx Board Design | 2Ω Power Resistor | https://www.mouser.com/ProductDetail/Bourns/PWR220T-20-2R00F?qs=sGAEpiMZZMtlubZbdhIBIIFas8kKGM5fidmq4iLVFG8%3D
1 | 2025-10-21 | 13:00:00 | 16:30:00 | 3.500 | IR Tx Board Design
1 | 2025-10-22 | 11:00:00 | 12:00:00 | 1.000 | IR Rx Circuit Design | 8Pin Molex | 430450810
1 | 2025-10-22 | 13:00:00 | 14:50:00 | 1.833 | IR Rx Circuit Design | 2Pin Molex | 430450200
1 | 2025-10-23 | 13:00:00 | 15:00:00 | 2.000 | IR Tx Board Design
1 | 2025-10-24 | 10:00:00 | 12:00:00 | 2.000 | IR Tx Board Design
2 | 2025-10-27 | 11:00:00 | 12:00:00 | 1.000 | IR Rx Circuit Design
2 | 2025-10-27 | 13:00:00 | 14:30:00 | 1.500 | IR Rx Circuit Design
2 | 2025-10-28 | 10:30:00 | 12:00:00 | 1.500 | IR Rx Circuit Design
2 | 2025-10-28 | 12:30:00 | 14:30:00 | 2.000 | IR Rx Circuit Design
2 | 2025-10-29 | 13:00:00 | 15:00:00 | 2.000 | IR Tx Board Design
2 | 2025-10-29 | 10:00:00 | 12:00:00 | 2.000 | IR Tx Board Design
2 | 2025-10-30 | 11:00:00 | 12:00:00 | 1.000 | IR Rx Circuit Design
2 | 2025-10-30 | 13:00:00 | 14:30:00 | 1.500 | IR Rx Circuit Design
2 | 2025-10-31 | 10:30:00 | 12:00:00 | 1.500 | IR Rx Circuit Design
2 | 2025-10-31 | 12:30:00 | 14:30:00 | 2.000 | IR Rx Circuit Design
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
8 | 2025-12-16 | 18:30:00 | 22:30:00 | 4.000 | Documentation
8 | 2025-12-16 | 13:00:00 | 16:30:00 | 3.500 | Documentation
8 | 2025-12-16 | 18:30:00 | 20:30:00 | 2.000 | Documentation
8 | 2025-12-16 | 22:15:00 | 1:30:00 | 3.250 | Documentation
 |  |  | Total | 173.45
