slacshan/MIDI-Projects/BassGuitar/CAD/F25/Fret/STLs/FretBar.stl

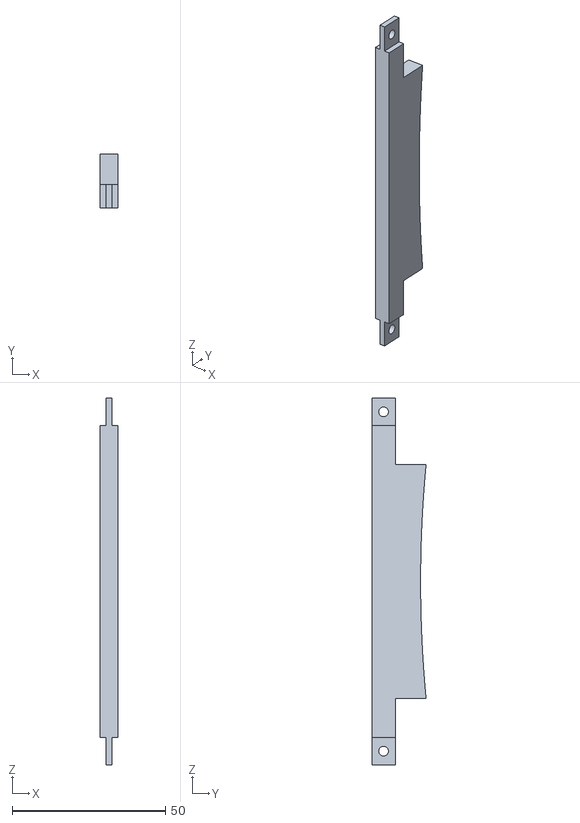
[picture p15: CAD file, 2025-12-16]
BassGuitar/CAD/F25/Fret/STLs/FretBar.stl
5.71 x 17.7 x 119.7
