slacshan/MIDI-Projects/BassGuitar/CAD/F25/PluckMute/STLs/PluckTool.stl

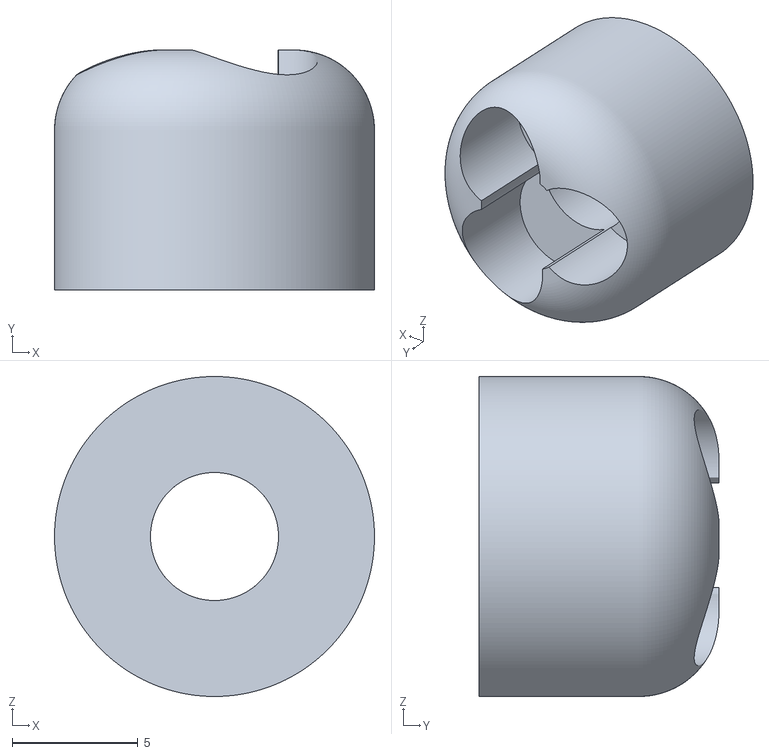
[picture p16: CAD file, 2025-12-16]
BassGuitar/CAD/F25/PluckMute/STLs/PluckTool.stl
12.7 x 9.52 x 12.7
