slacshan/MIDI-Projects/BassGuitar/CAD/S25/Electronics/PCBStandoff.SLDPRT

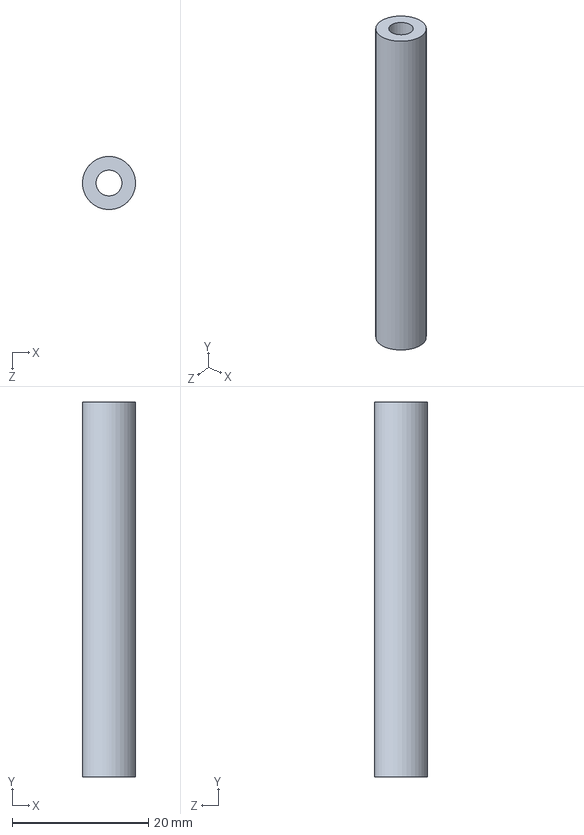
[picture p17: CAD file, 2025-11-19]
BassGuitar/CAD/S25/Electronics/PCBStandoff.SLDPRT
7.79 x 55.0 x 7.80 mm
