slacshan/MIDI-Projects/BassGuitar/CAD/S25/FretBars/10thFretBar.SLDPRT

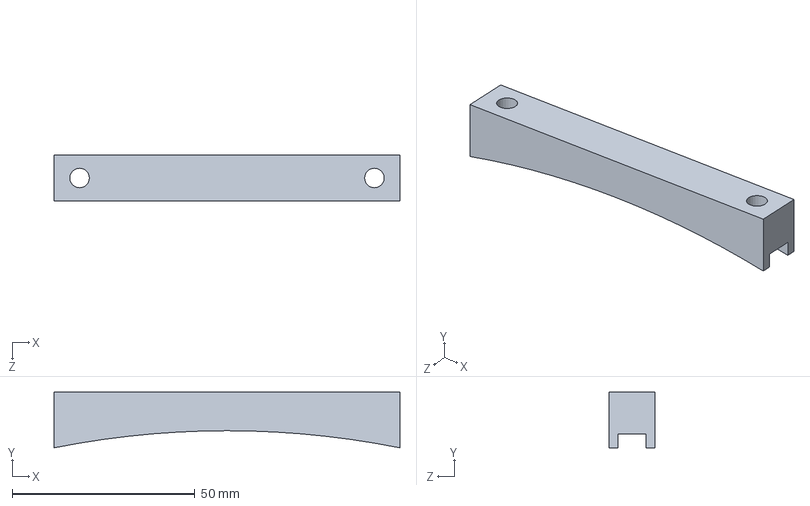
[picture p18: CAD file, 2025-11-19]
BassGuitar/CAD/S25/FretBars/10thFretBar.SLDPRT
94.7 x 15.2 x 12.7 mm
