slacshan/MIDI-Projects/BassGuitar/CAD/S25/STLs/8thFretBar.STL

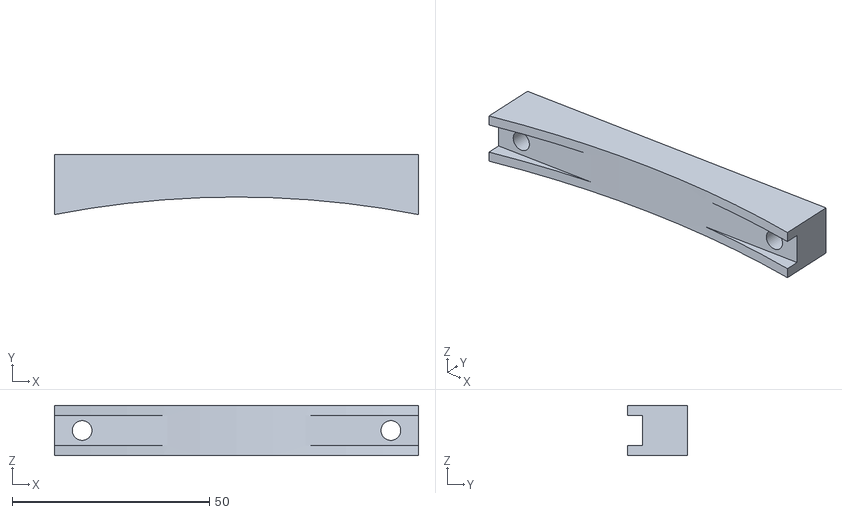
[picture p19: CAD file, 2025-11-19]
BassGuitar/CAD/S25/STLs/8thFretBar.STL
92.2 x 15.2 x 12.7
