slacshan/MIDI-Projects/BassGuitar/CAD/S25/TopCrossSupport.SLDPRT

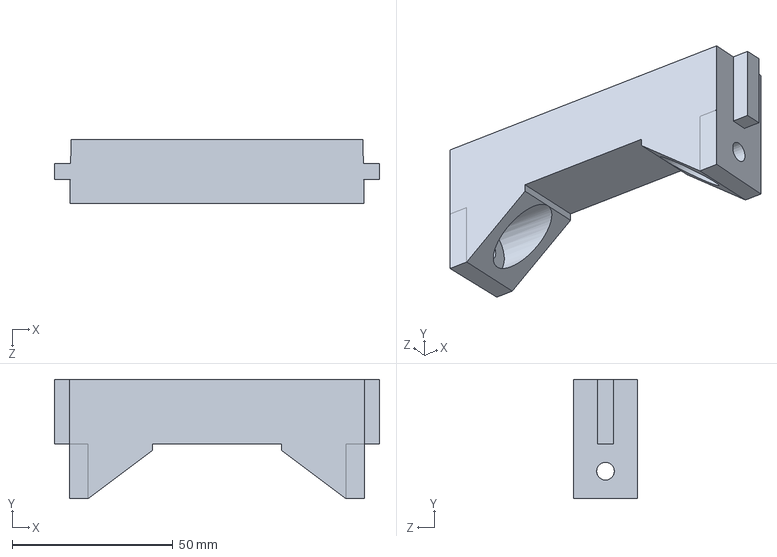
[picture p20: CAD file, 2025-11-19]
BassGuitar/CAD/S25/TopCrossSupport.SLDPRT
100.9 x 37.0 x 20.0 mm
