slacshan/MIDI-Projects/BassGuitar/CAD/F25/Fret/STLs/NeckRest.stl

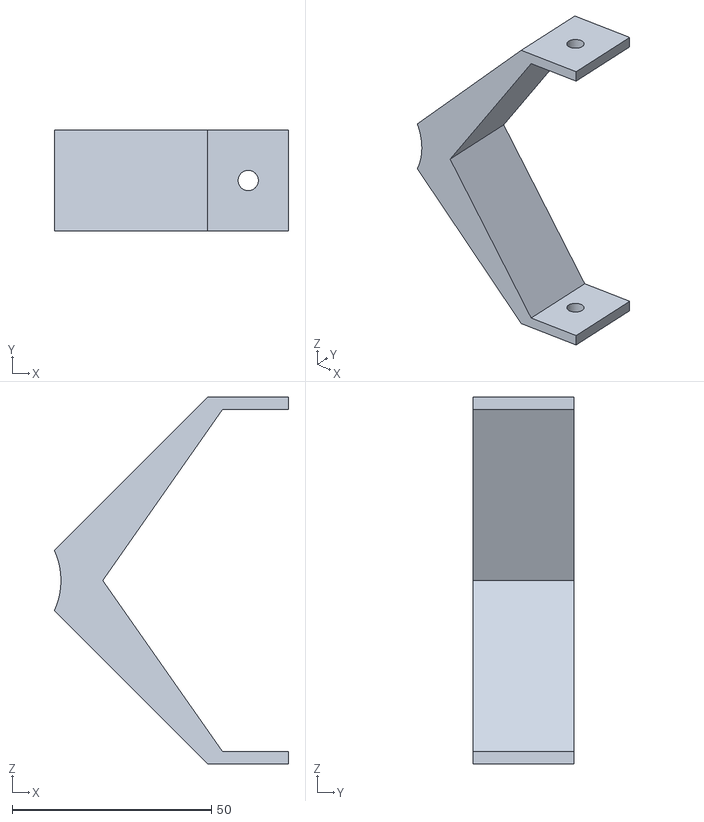
[picture p21: CAD file, 2025-12-08]
BassGuitar/CAD/F25/Fret/STLs/NeckRest.stl
58.8 x 25.4 x 92.1
