slacshan/MIDI-Projects/BassGuitar/CAD/F25/PluckMute/STLs/LongPluckMount.stl

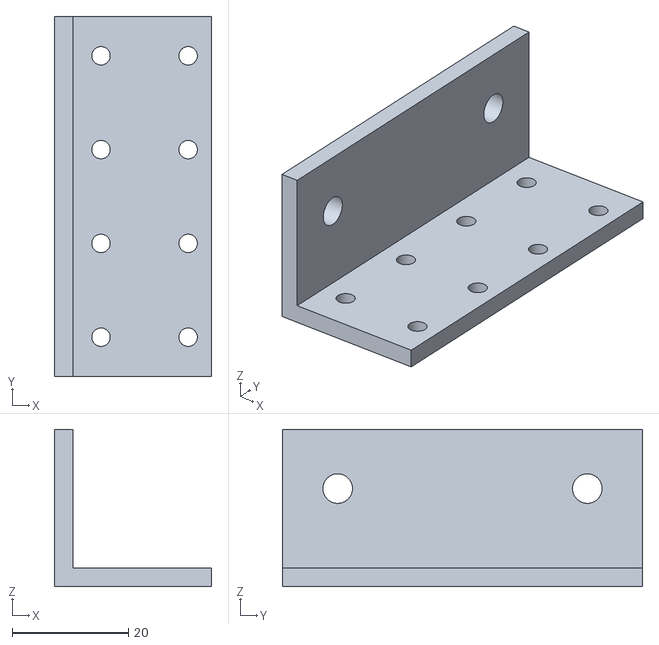
[picture p22: CAD file, 2025-12-08]
BassGuitar/CAD/F25/PluckMute/STLs/LongPluckMount.stl
27.0 x 62.0 x 27.0
