slacshan/MIDI-Projects/BassGuitar/CAD/S25/Electronics/FretBoardCage.SLDPRT

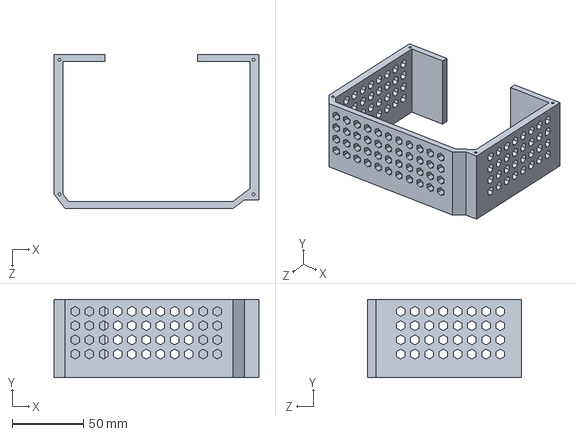
[picture p23: CAD file, 2025-11-19]
BassGuitar/CAD/S25/Electronics/FretBoardCage.SLDPRT
144.1 x 55.0 x 108.4 mm
