slacshan/MIDI-Projects/BassGuitar/CAD/S25/FretBars/SpongeBlank.SLDPRT

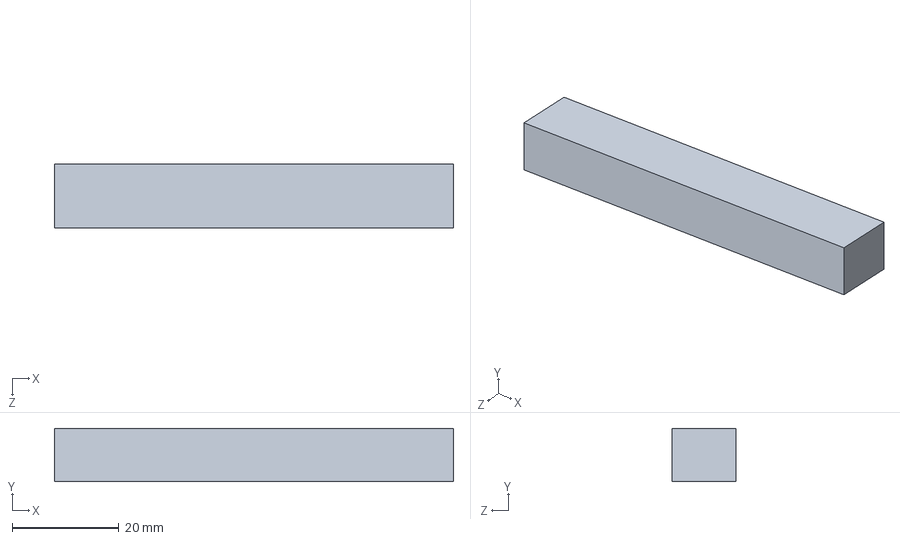
[picture p24: CAD file, 2025-11-19]
BassGuitar/CAD/S25/FretBars/SpongeBlank.SLDPRT
74.8 x 10.0 x 12.0 mm
