slacshan/MIDI-Projects/BassGuitar/CAD/S25/STLs/SolenoidHoriMount.STL

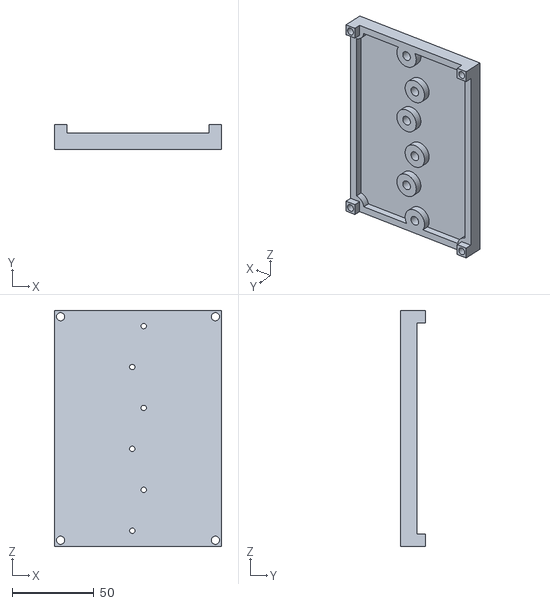
[picture p25: CAD file, 2025-11-19]
BassGuitar/CAD/S25/STLs/SolenoidHoriMount.STL
102.2 x 15.0 x 144.1
