slacshan/MIDI-Projects/BassGuitar/CAD/F25/2020DoubleT.stl

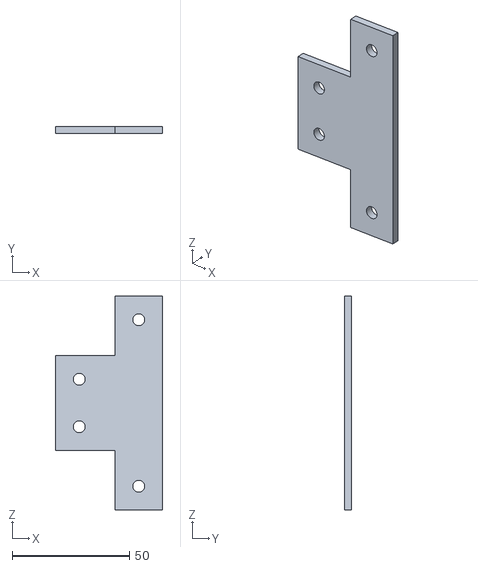
[picture p26: CAD file, 2025-12-09]
BassGuitar/CAD/F25/2020DoubleT.stl
45.7 x 3.17 x 91.4
