slacshan/MIDI-Projects/BassGuitar/CAD/F25/Fret/STLs/SolenoidMount.stl

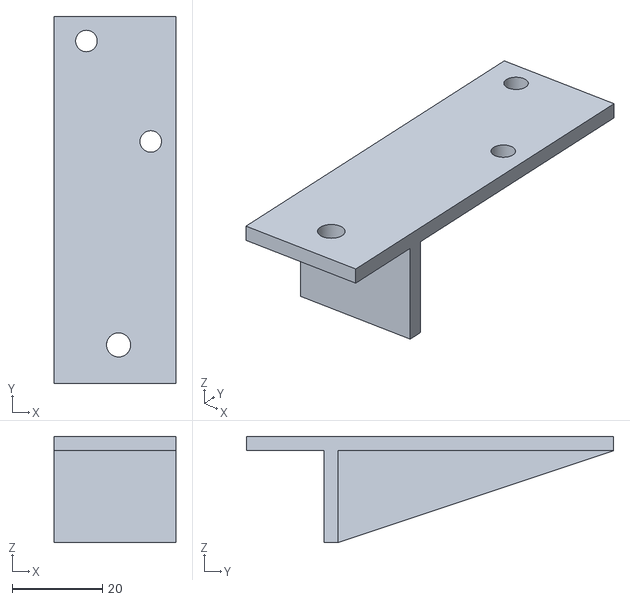
[picture p27: CAD file, 2025-12-01]
BassGuitar/CAD/F25/Fret/STLs/SolenoidMount.stl
27.0 x 81.3 x 23.5
