slacshan/MIDI-Projects/BassGuitar/CAD/F25/PluckMute/STLs/PluckMount.stl

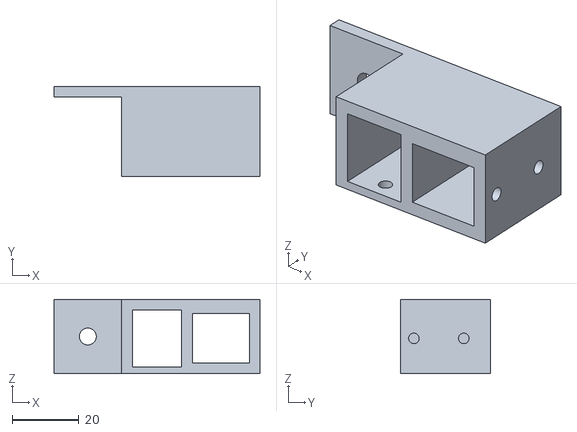
[picture p28: CAD file, 2025-12-08]
BassGuitar/CAD/F25/PluckMute/STLs/PluckMount.stl
61.8 x 27.0 x 22.4
