slacshan/MIDI-Projects/BassGuitar/CAD/S25/Electronics/2.54mmHeaderSingle.SLDPRT

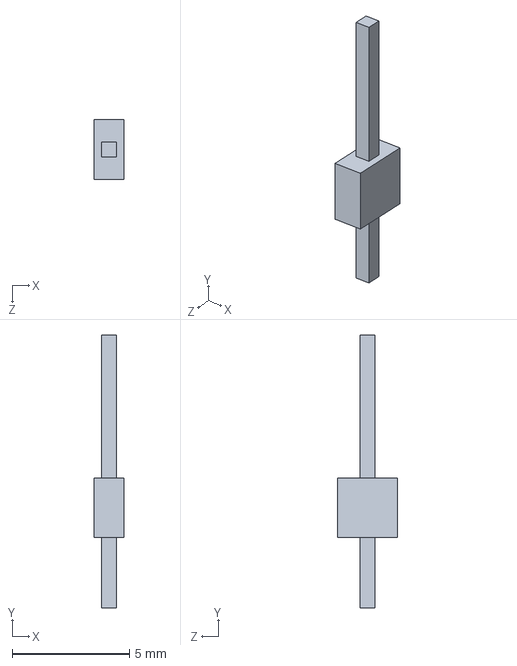
[picture p29: CAD file, 2025-11-19]
BassGuitar/CAD/S25/Electronics/2.54mmHeaderSingle.SLDPRT
1.27 x 11.6 x 2.54 mm
