slacshan/MIDI-Projects/BassGuitar/CAD/S25/FretBars/4thFretBar.SLDPRT

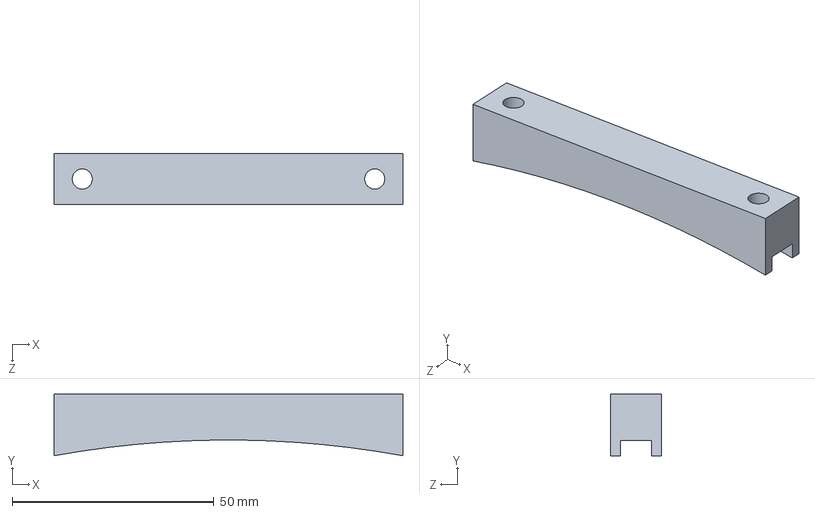
[picture p30: CAD file, 2025-11-19]
BassGuitar/CAD/S25/FretBars/4thFretBar.SLDPRT
86.4 x 15.2 x 12.7 mm
