slacshan/MIDI-Projects/BassGuitar/CAD/S25/Solenoid2020Mount.SLDPRT

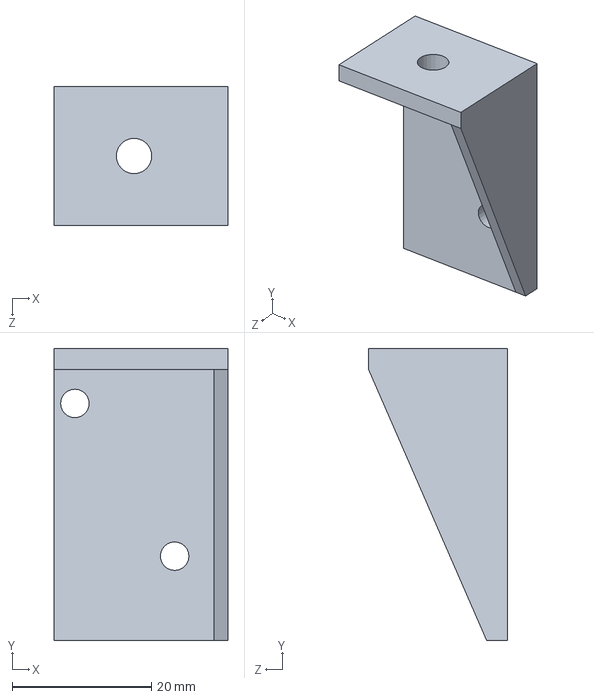
[picture p31: CAD file, 2025-11-19]
BassGuitar/CAD/S25/Solenoid2020Mount.SLDPRT
25.0 x 42.0 x 20.0 mm
