slacshan/MIDI-Projects/BassGuitar/CAD/F25/2020T.stl

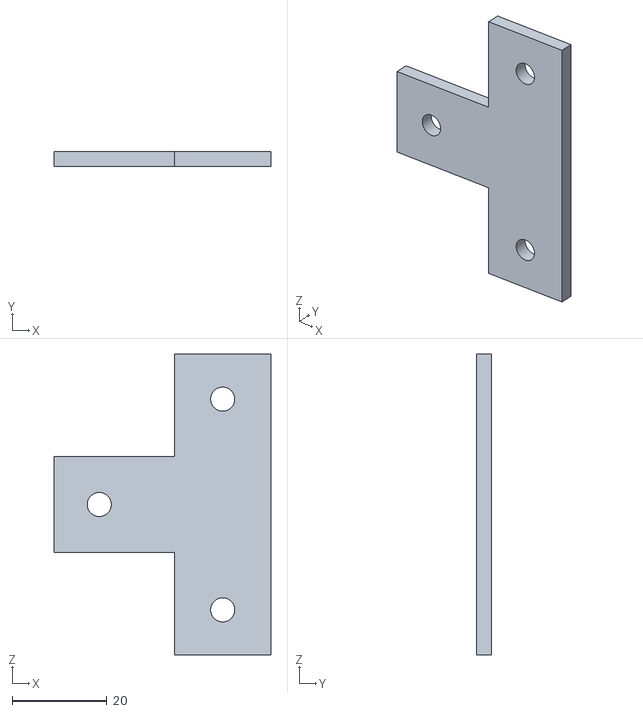
[picture p32: CAD file, 2025-12-08]
BassGuitar/CAD/F25/2020T.stl
45.7 x 3.17 x 63.5
