slacshan/MIDI-Projects/BassGuitar/CAD/F25/Fret/STLs/GenrealBar.stl

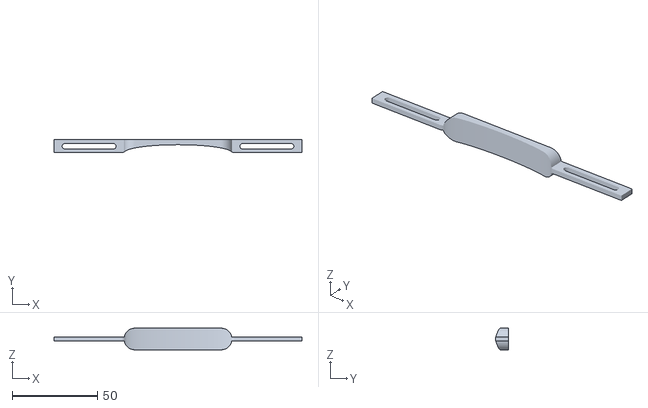
[picture p33: CAD file, 2025-11-19]
BassGuitar/CAD/F25/Fret/STLs/GenrealBar.stl
145.7 x 7.92 x 12.7
