slacshan/MIDI-Projects/BassGuitar/CAD/F25/PluckMute/STLs/MuteMount.stl

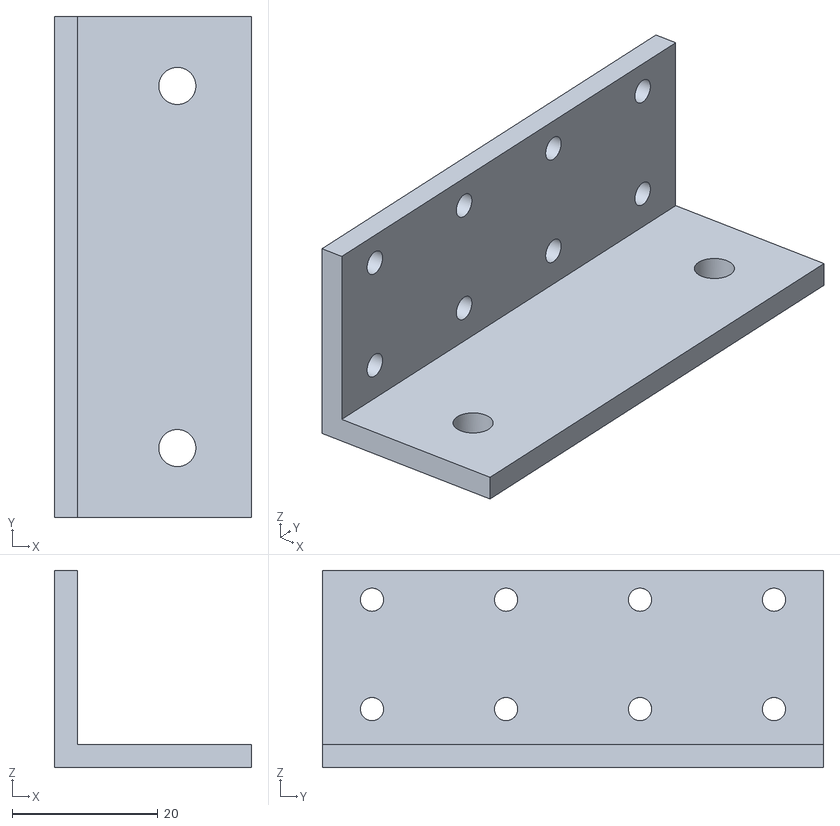
[picture p34: CAD file, 2025-12-01]
BassGuitar/CAD/F25/PluckMute/STLs/MuteMount.stl
27.0 x 68.7 x 27.0
