slacshan/MIDI-Projects/BassGuitar/CAD/S25/Electronics/SolenoidPCBBlank.SLDPRT

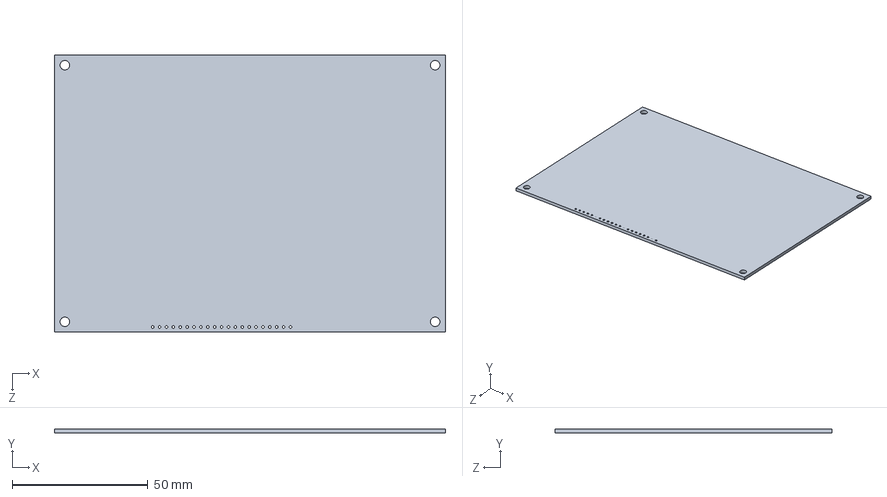
[picture p35: CAD file, 2025-11-19]
BassGuitar/CAD/S25/Electronics/SolenoidPCBBlank.SLDPRT
144.1 x 1.60 x 102.2 mm
