slacshan/MIDI-Projects/BassGuitar/CAD/S25/FretBars/18thFretBar.SLDPRT

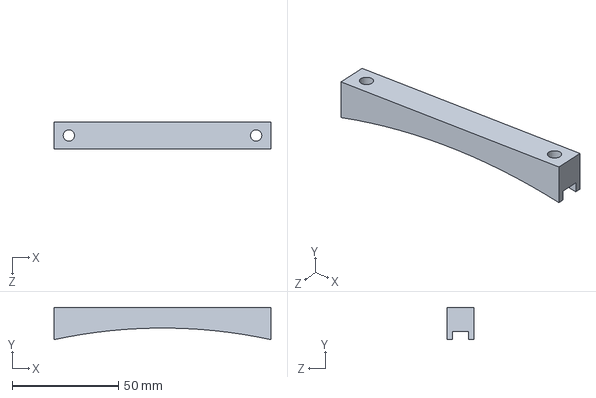
[picture p36: CAD file, 2025-11-19]
BassGuitar/CAD/S25/FretBars/18thFretBar.SLDPRT
102.3 x 15.2 x 12.7 mm
