slacshan/MIDI-Projects/BassGuitar/CAD/S25/P-BassBody.SLDPRT

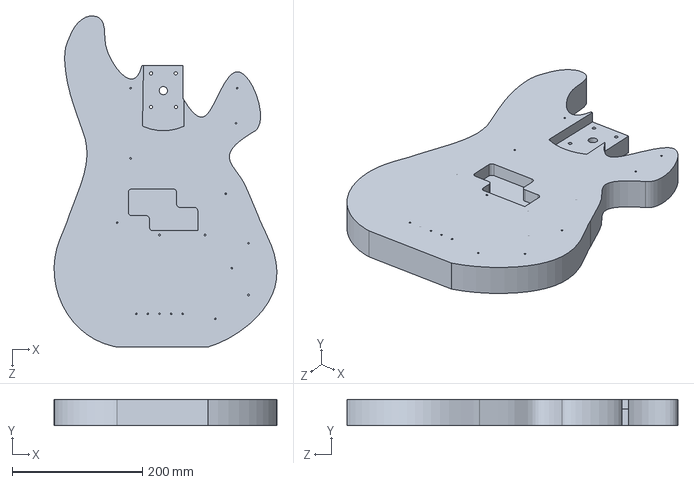
[picture p37: CAD file, 2025-11-19]
BassGuitar/CAD/S25/P-BassBody.SLDPRT
341.8 x 40.0 x 507.9 mm
