slacshan/MIDI-Projects/BassGuitar/CAD/S25/Electronics/DINMountingRail.SLDPRT

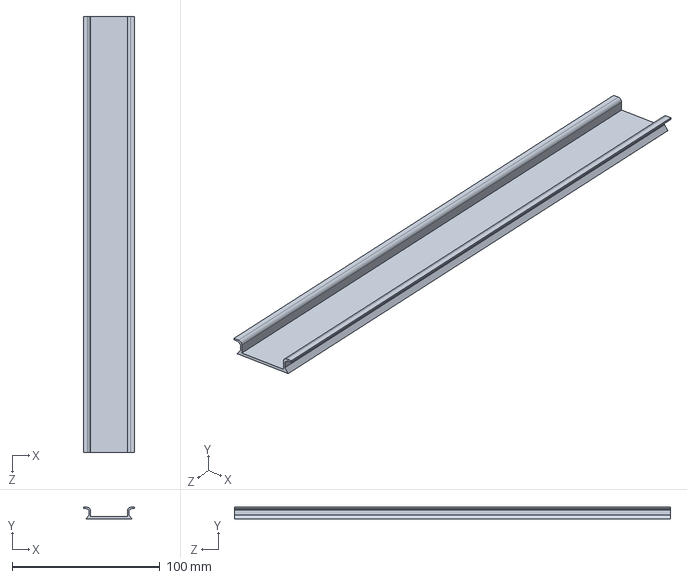
[picture p38: CAD file, 2025-11-19]
BassGuitar/CAD/S25/Electronics/DINMountingRail.SLDPRT
34.8 x 7.82 x 295.0 mm
