slacshan/MIDI-Projects/BassGuitar/CAD/S25/FretBars/12thFretBar.SLDPRT

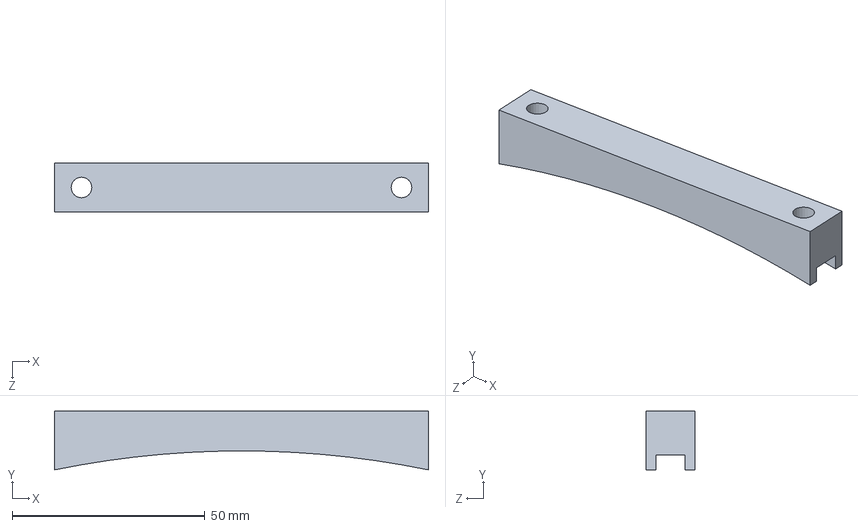
[picture p39: CAD file, 2025-11-19]
BassGuitar/CAD/S25/FretBars/12thFretBar.SLDPRT
97.0 x 15.2 x 12.7 mm
