slacshan/MIDI-Projects/BassGuitar/CAD/S25/SmallMountingBracketD.SLDPRT

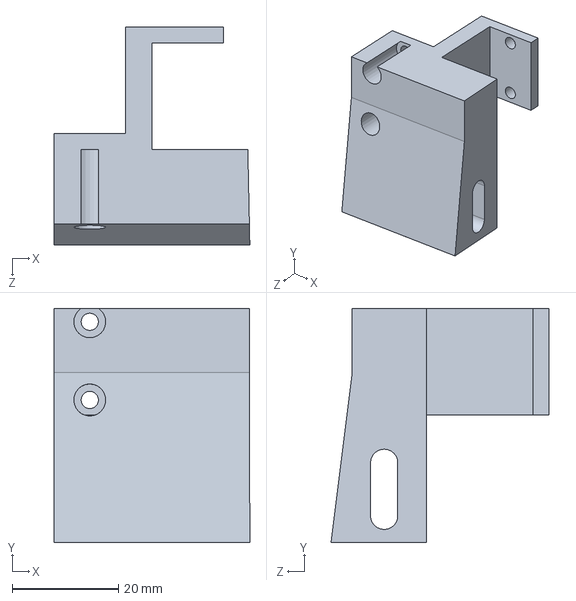
[picture p40: CAD file, 2025-11-19]
BassGuitar/CAD/S25/SmallMountingBracketD.SLDPRT
36.8 x 44.0 x 41.0 mm
