slacshan/MIDI-Projects/BassGuitar/CAD/S25/STLs/6thFretBar.STL

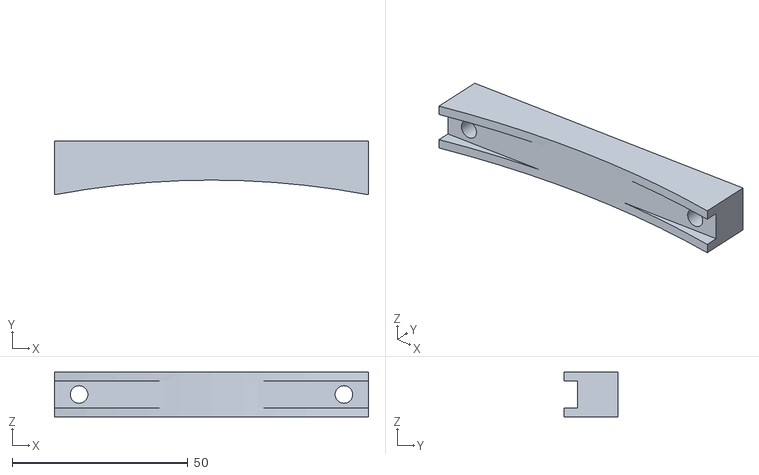
[picture p41: CAD file, 2025-11-19]
BassGuitar/CAD/S25/STLs/6thFretBar.STL
89.4 x 15.2 x 12.7
