slacshan/MIDI-Projects/BassGuitar/CAD/S25/4nSolenoidBody.SLDPRT

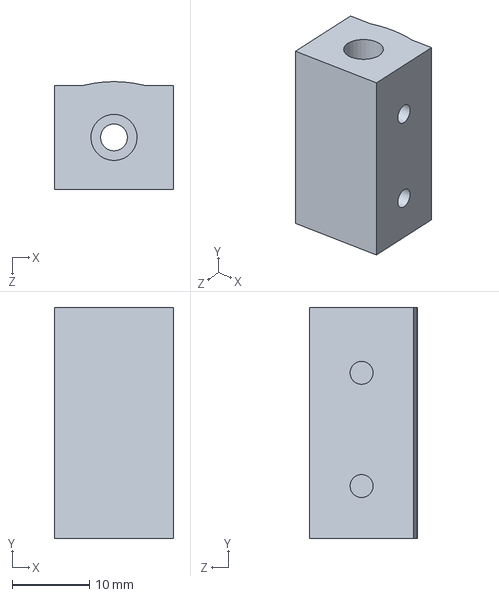
[picture p42: CAD file, 2025-11-19]
BassGuitar/CAD/S25/4nSolenoidBody.SLDPRT
15.5 x 30.0 x 14.0 mm
