slacshan/MIDI-Projects/BassGuitar/CAD/S25/STLs/DINRailMounts.STL

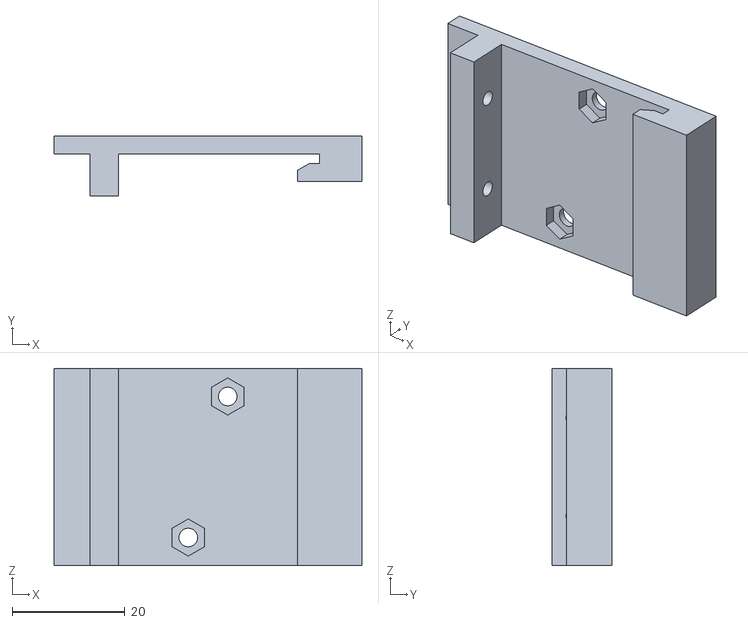
[picture p43: CAD file, 2025-11-19]
BassGuitar/CAD/S25/STLs/DINRailMounts.STL
54.6 x 10.7 x 35.0
