slacshan/MIDI-Projects/BassGuitar/CAD/S25/BassMountLeft.SLDPRT

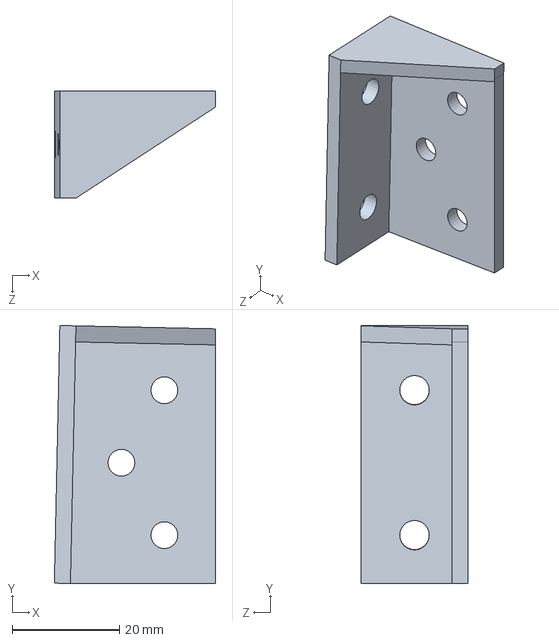
[picture p44: CAD file, 2025-11-19]
BassGuitar/CAD/S25/BassMountLeft.SLDPRT
30.1 x 48.1 x 20.0 mm
