slacshan/MIDI-Projects/BassGuitar/CAD/S25/Electronics/PCBMount.SLDPRT

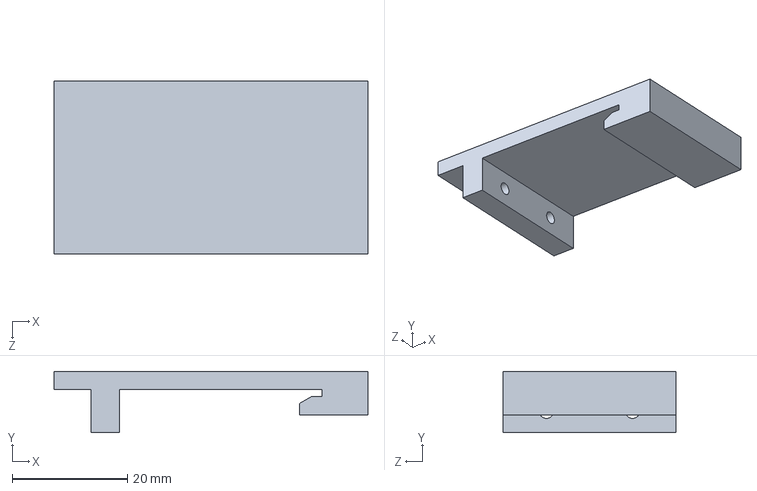
[picture p45: CAD file, 2025-11-19]
BassGuitar/CAD/S25/Electronics/PCBMount.SLDPRT
54.6 x 10.7 x 30.0 mm
