slacshan/MIDI-Projects/BassGuitar/CAD/S25/2020ExtrusionShort.SLDPRT

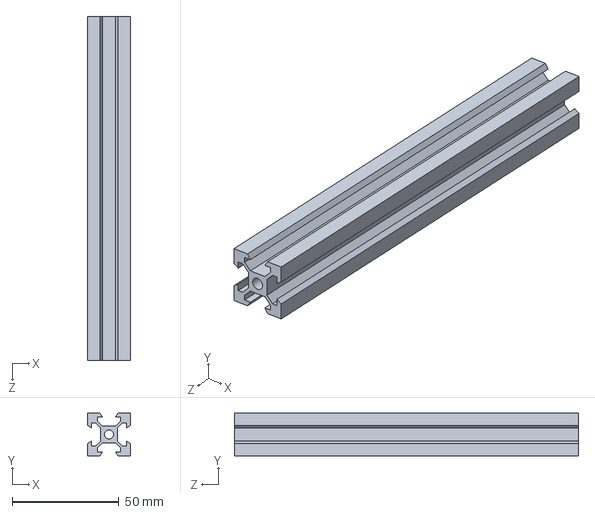
[picture p46: CAD file, 2025-11-19]
BassGuitar/CAD/S25/2020ExtrusionShort.SLDPRT
20.0 x 20.0 x 161.5 mm
