slacshan/MIDI-Projects/BassGuitar/CAD/S25/Electronics/2.54mmHeader21-pin.SLDPRT

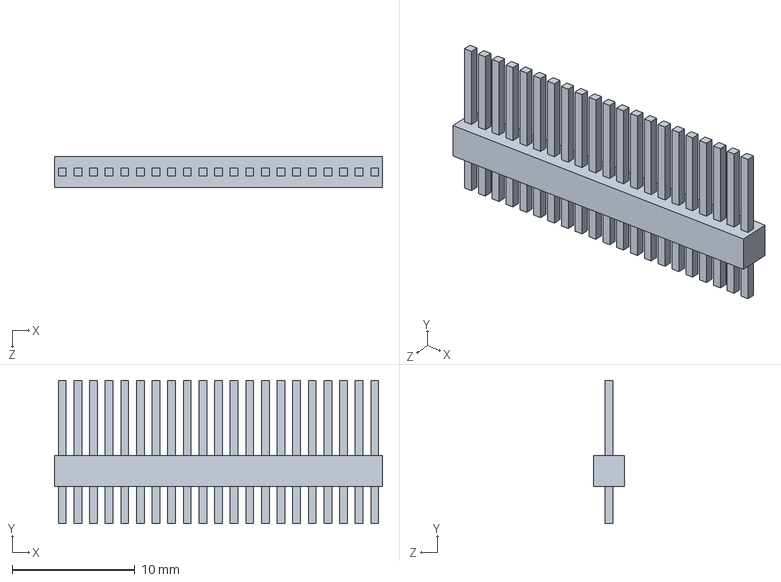
[picture p47: CAD file, 2025-11-19]
BassGuitar/CAD/S25/Electronics/2.54mmHeader21-pin.SLDPRT
26.7 x 11.6 x 2.54 mm
