slacshan/MIDI-Projects/BassGuitar/CAD/S25/FretBars/3rdFretBar.SLDPRT

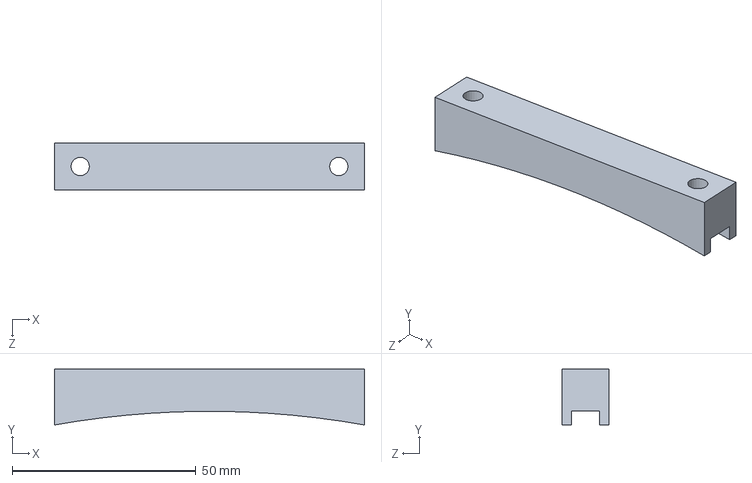
[picture p48: CAD file, 2025-11-19]
BassGuitar/CAD/S25/FretBars/3rdFretBar.SLDPRT
84.4 x 15.2 x 12.7 mm
