slacshan/MIDI-Projects/BassGuitar/CAD/S25/STLs/7thFretBar.STL

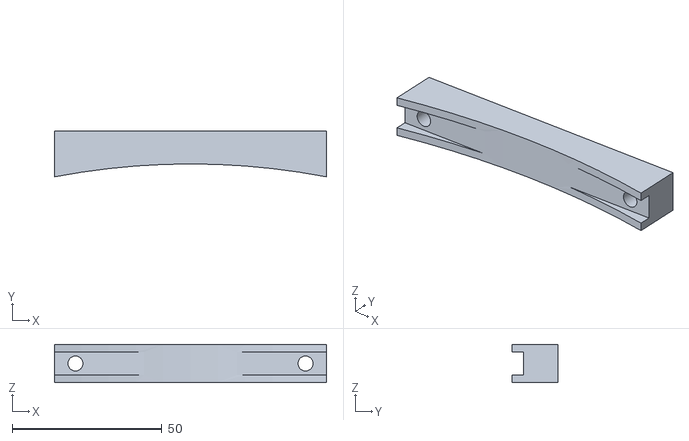
[picture p49: CAD file, 2025-11-19]
BassGuitar/CAD/S25/STLs/7thFretBar.STL
90.8 x 15.2 x 12.7
