slacshan/MIDI-Projects/BassGuitar/CAD/S25/90Angle2020Bracket.SLDPRT

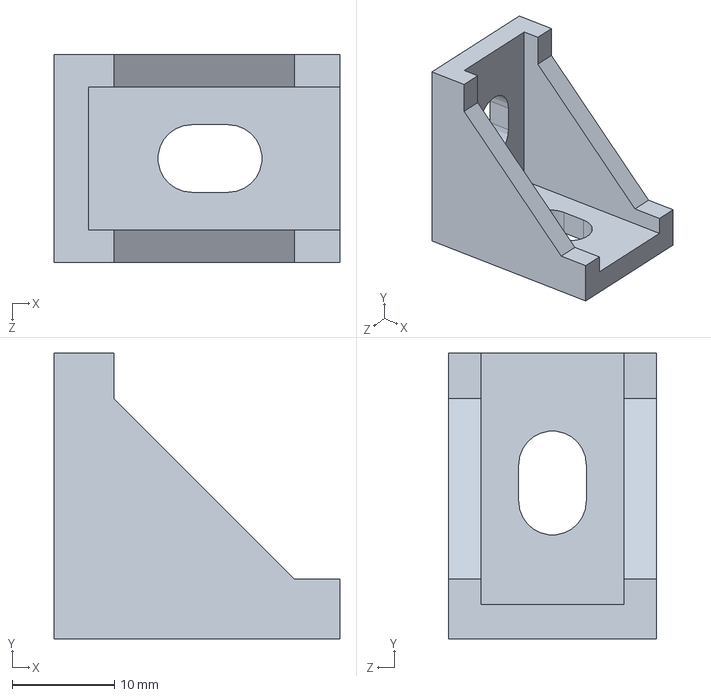
[picture p50: CAD file, 2025-11-19]
BassGuitar/CAD/S25/90Angle2020Bracket.SLDPRT
27.9 x 27.9 x 20.3 mm
