slacshan/MIDI-Projects/BassGuitar/CAD/S25/Electronics/MotherboardPCBBLANK.SLDPRT

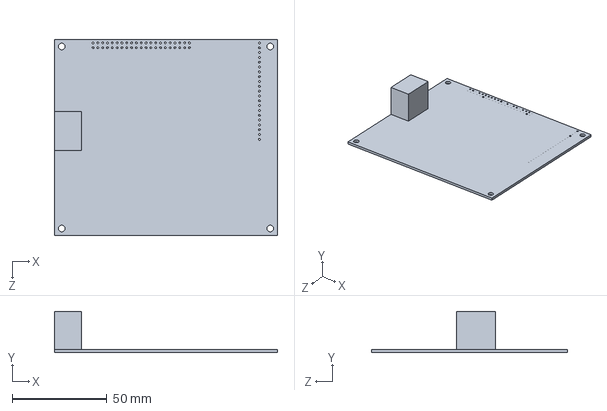
[picture p51: CAD file, 2025-11-19]
BassGuitar/CAD/S25/Electronics/MotherboardPCBBLANK.SLDPRT
117.5 x 21.6 x 103.5 mm
