slacshan/MIDI-Projects/BassGuitar/CAD/S25/FretBars/5thFretBar.SLDPRT

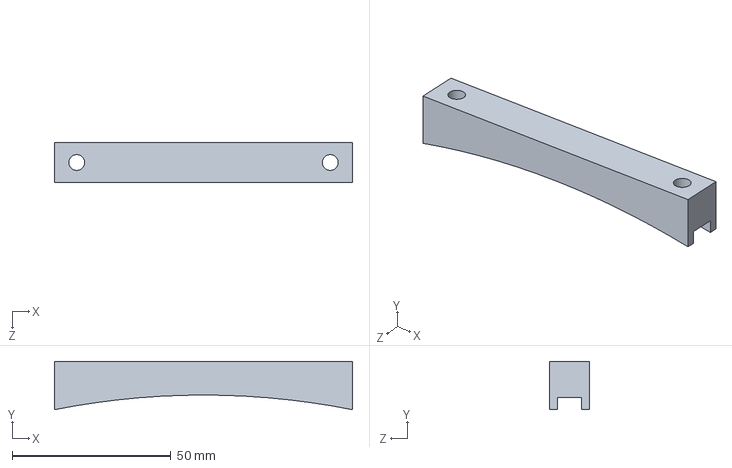
[picture p52: CAD file, 2025-11-19]
BassGuitar/CAD/S25/FretBars/5thFretBar.SLDPRT
93.9 x 15.2 x 12.7 mm
