slacshan/MIDI-Projects/BassGuitar/CAD/S25/STLs/FirstFretBar.STL

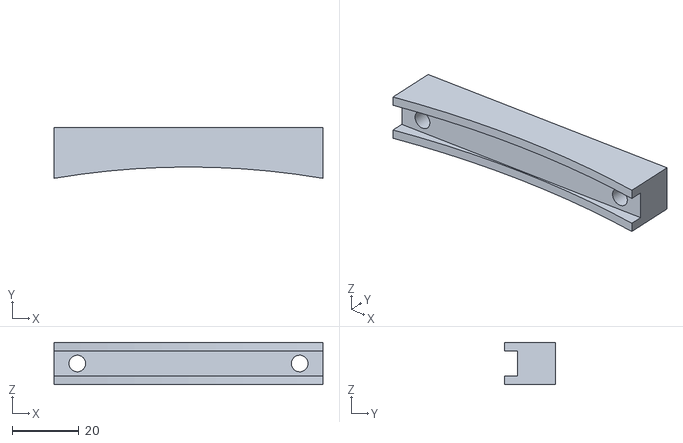
[picture p53: CAD file, 2025-11-19]
BassGuitar/CAD/S25/STLs/FirstFretBar.STL
80.8 x 15.2 x 12.7
