slacshan/MIDI-Projects/BassGuitar/CAD/S25/P-BassNeck.SLDPRT

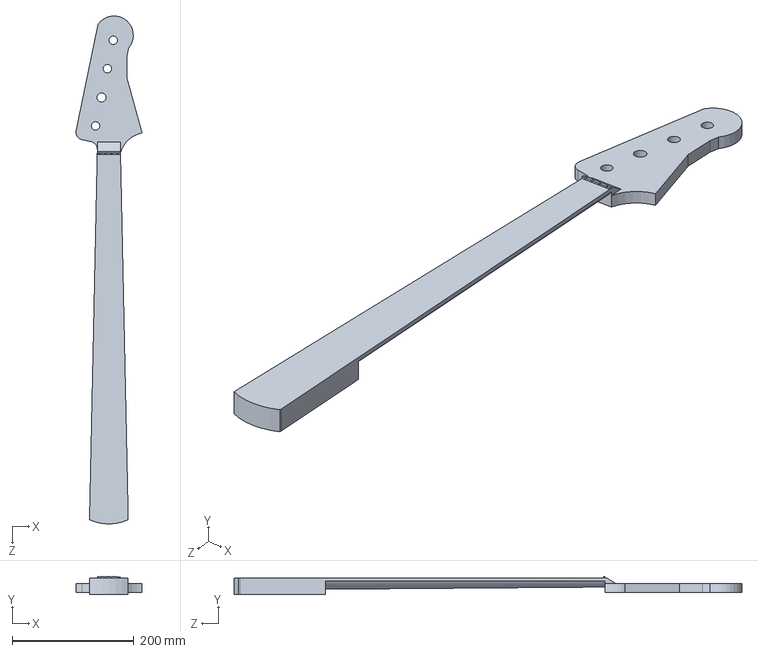
[picture p54: CAD file, 2025-11-19]
BassGuitar/CAD/S25/P-BassNeck.SLDPRT
108.5 x 30.2 x 832.8 mm
