slacshan/MIDI-Projects/BassGuitar/CAD/S25/25nSolenoidSimpleBody.SLDPRT

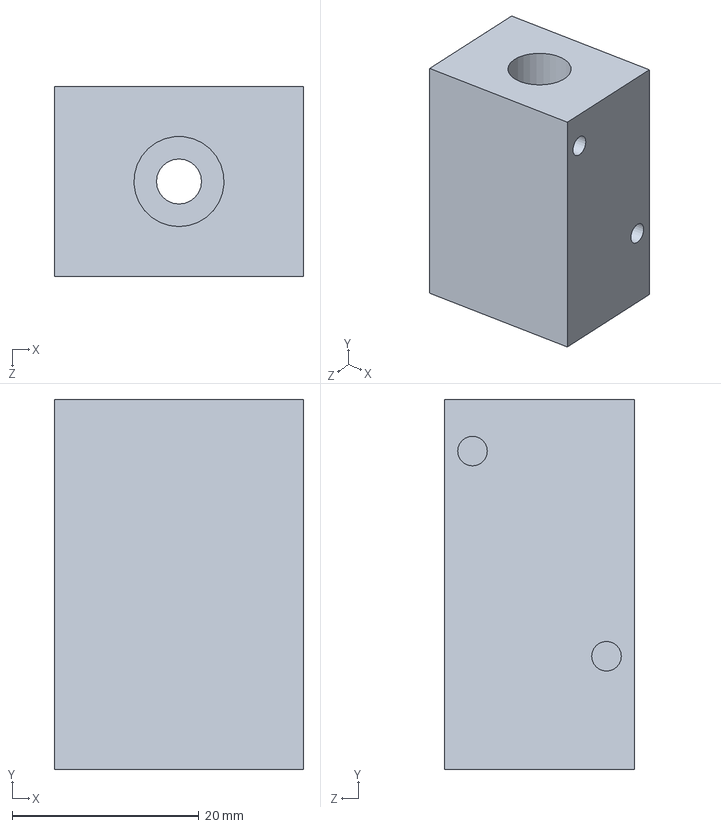
[picture p55: CAD file, 2025-11-19]
BassGuitar/CAD/S25/25nSolenoidSimpleBody.SLDPRT
26.7 x 39.6 x 20.3 mm
