slacshan/MIDI-Projects/BassGuitar/CAD/S25/Electronics/2.54mmRightHeader21-pin2x.SLDPRT

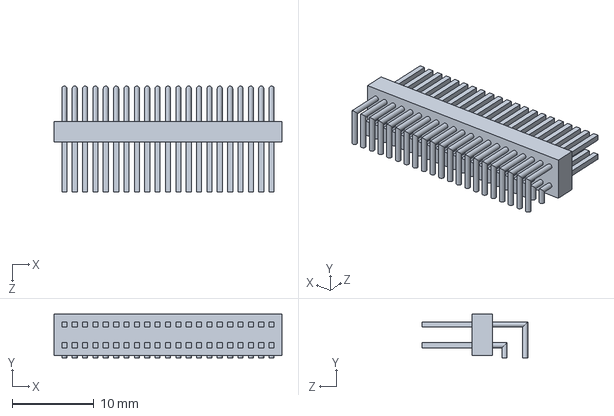
[picture p56: CAD file, 2025-11-19]
BassGuitar/CAD/S25/Electronics/2.54mmRightHeader21-pin2x.SLDPRT
27.9 x 5.38 x 13.0 mm
