slacshan/MIDI-Projects/BassGuitar/CAD/S25/FretBars/9thFretBar.SLDPRT

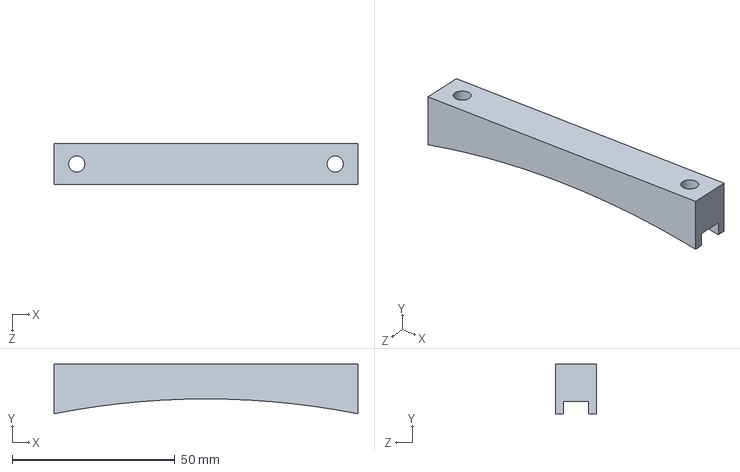
[picture p57: CAD file, 2025-11-19]
BassGuitar/CAD/S25/FretBars/9thFretBar.SLDPRT
93.5 x 15.2 x 12.7 mm
