slacshan/MIDI-Projects/BassGuitar/CAD/S25/STLs/16thFretBar.STL

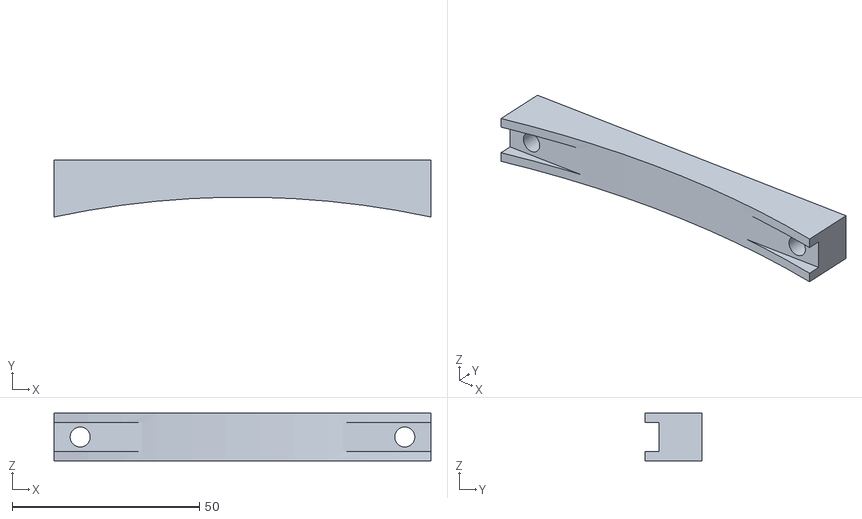
[picture p58: CAD file, 2025-11-19]
BassGuitar/CAD/S25/STLs/16thFretBar.STL
100.7 x 15.2 x 12.7
