slacshan/MIDI-Projects/BassGuitar/CAD/S25/MutingFinger.SLDPRT

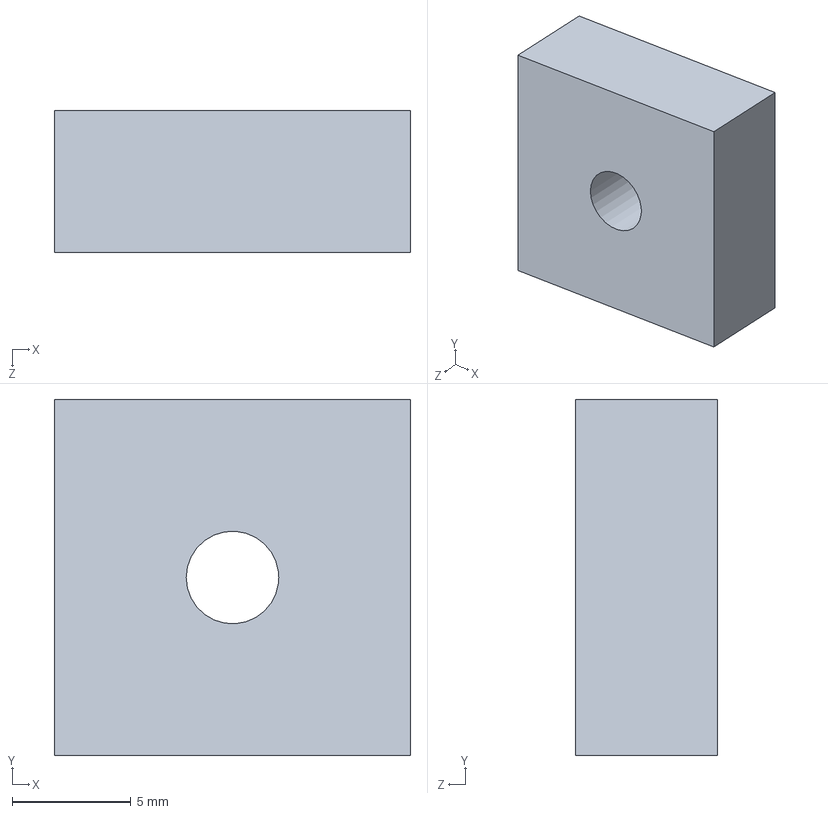
[picture p59: CAD file, 2025-11-19]
BassGuitar/CAD/S25/MutingFinger.SLDPRT
15.0 x 15.0 x 6.00 mm
