slacshan/MIDI-Projects/BassGuitar/CAD/S25/FretBars/2ndFretBar.SLDPRT

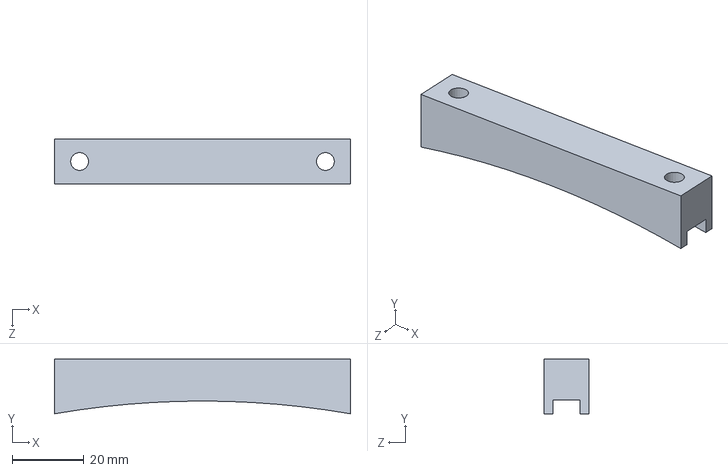
[picture p60: CAD file, 2025-11-19]
BassGuitar/CAD/S25/FretBars/2ndFretBar.SLDPRT
82.6 x 15.2 x 12.7 mm
