slacshan/MIDI-Projects/BassGuitar/CAD/S25/PickGuard.SLDPRT

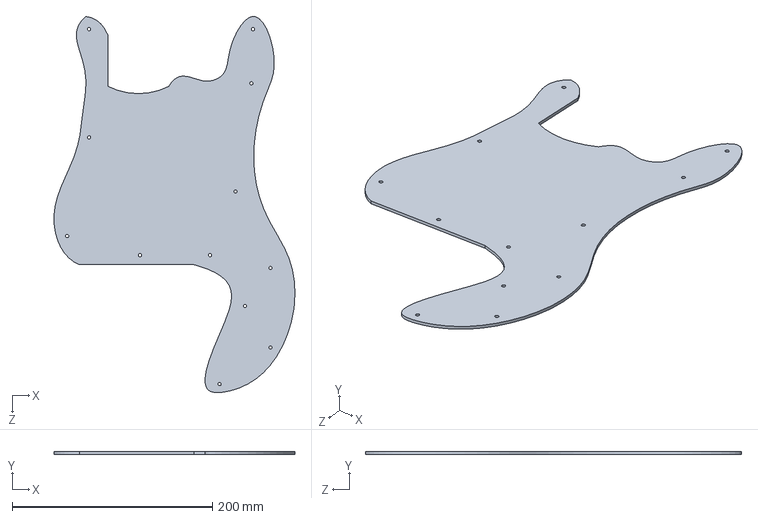
[picture p61: CAD file, 2025-11-19]
BassGuitar/CAD/S25/PickGuard.SLDPRT
240.4 x 2.54 x 375.2 mm
