slacshan/MIDI-Projects/BassGuitar/CAD/S25/STLs/5thFretBar.STL

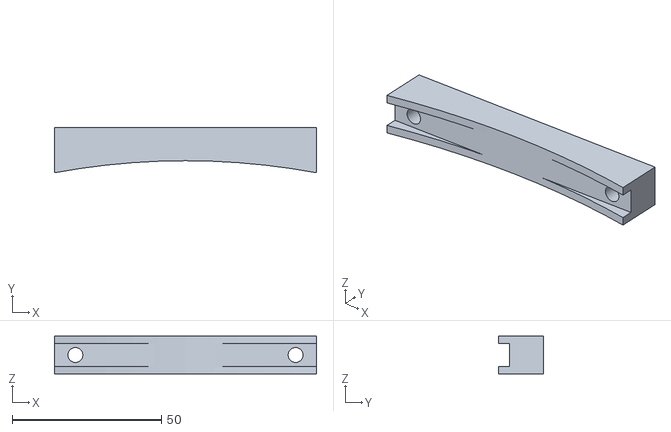
[picture p62: CAD file, 2025-11-19]
BassGuitar/CAD/S25/STLs/5thFretBar.STL
87.8 x 15.2 x 12.7
