slacshan/MIDI-Projects/BassGuitar/CAD/S25/FretBars/14thFretBar.SLDPRT

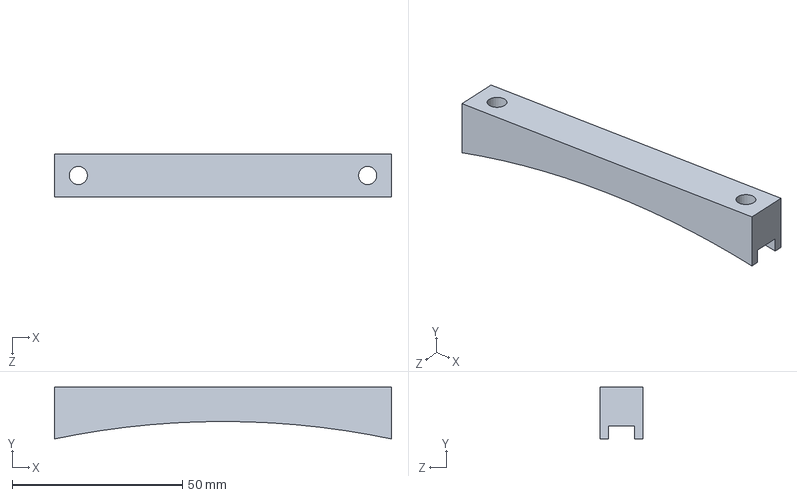
[picture p63: CAD file, 2025-11-19]
BassGuitar/CAD/S25/FretBars/14thFretBar.SLDPRT
98.9 x 15.2 x 12.7 mm
