slacshan/MIDI-Projects/BassGuitar/CAD/S25/MutingBracket.SLDPRT

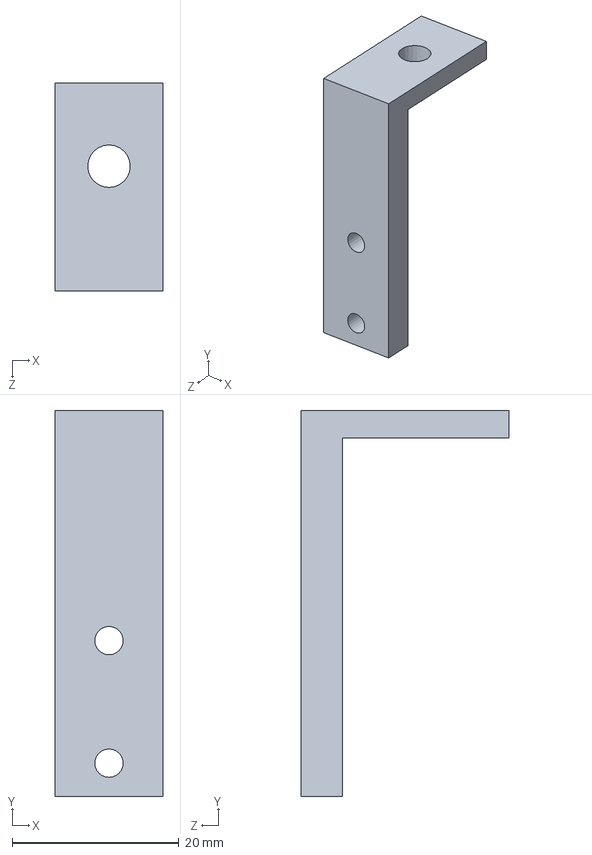
[picture p64: CAD file, 2025-11-19]
BassGuitar/CAD/S25/MutingBracket.SLDPRT
13.0 x 46.3 x 25.0 mm
