slacshan/MIDI-Projects/BassGuitar/CAD/S25/NeckSupportBrace.SLDPRT

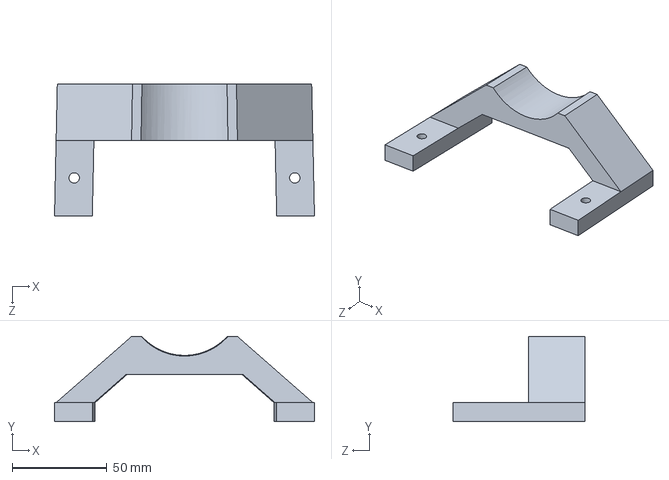
[picture p65: CAD file, 2025-11-19]
BassGuitar/CAD/S25/NeckSupportBrace.SLDPRT
137.5 x 45.0 x 70.0 mm
