slacshan/MIDI-Projects/BassGuitar/CAD/S25/4nSolenoidPin.SLDPRT

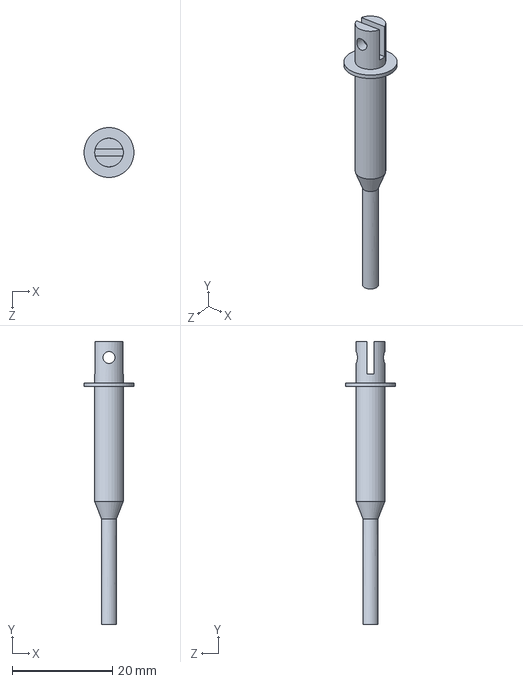
[picture p66: CAD file, 2025-11-19]
BassGuitar/CAD/S25/4nSolenoidPin.SLDPRT
10.0 x 56.6 x 9.97 mm
