slacshan/MIDI-Projects/BassGuitar/CAD/S25/FretBars/11thFretBar.SLDPRT

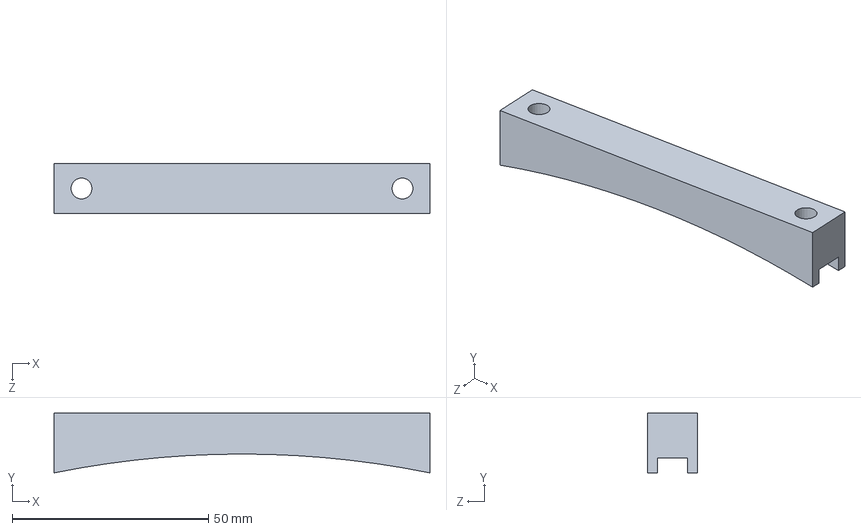
[picture p67: CAD file, 2025-11-19]
BassGuitar/CAD/S25/FretBars/11thFretBar.SLDPRT
95.8 x 15.2 x 12.7 mm
