slacshan/MIDI-Projects/BassGuitar/CAD/S25/SmallMountingBracket.SLDPRT

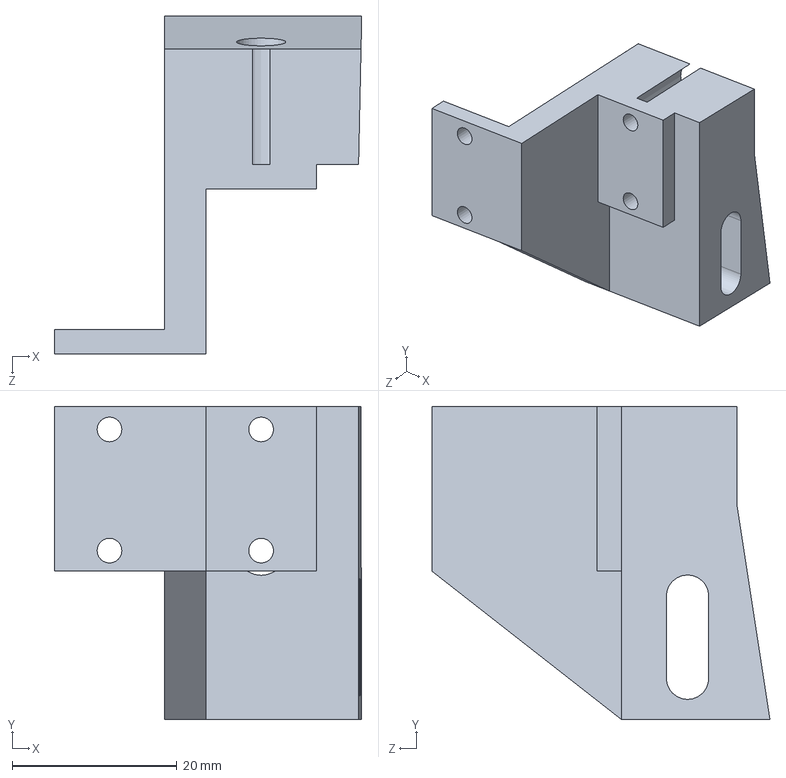
[picture p68: CAD file, 2025-11-19]
BassGuitar/CAD/S25/SmallMountingBracket.SLDPRT
37.3 x 38.0 x 41.0 mm
