slacshan/MIDI-Projects/BassGuitar/CAD/S25/STLs/14thFretBar.STL

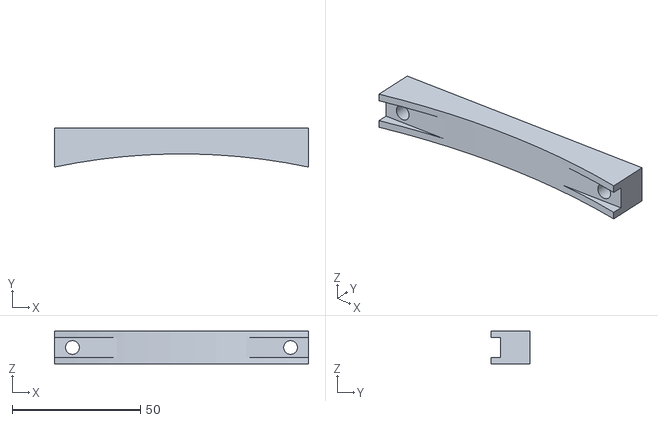
[picture p69: CAD file, 2025-11-19]
BassGuitar/CAD/S25/STLs/14thFretBar.STL
98.9 x 15.2 x 12.7
