slacshan/MIDI-Projects/BassGuitar/CAD/S25/2020Extrusion.SLDPRT

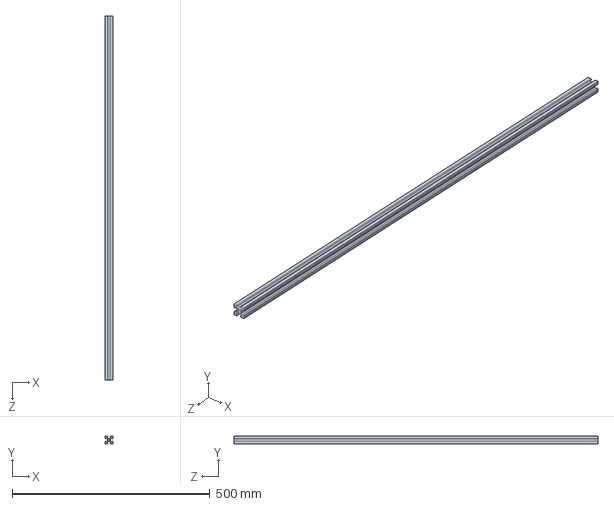
[picture p70: CAD file, 2025-11-19]
BassGuitar/CAD/S25/2020Extrusion.SLDPRT
20.0 x 20.0 x 920.0 mm
