slacshan/MIDI-Projects/BassGuitar/CAD/S25/BridgeSaddle.SLDPRT

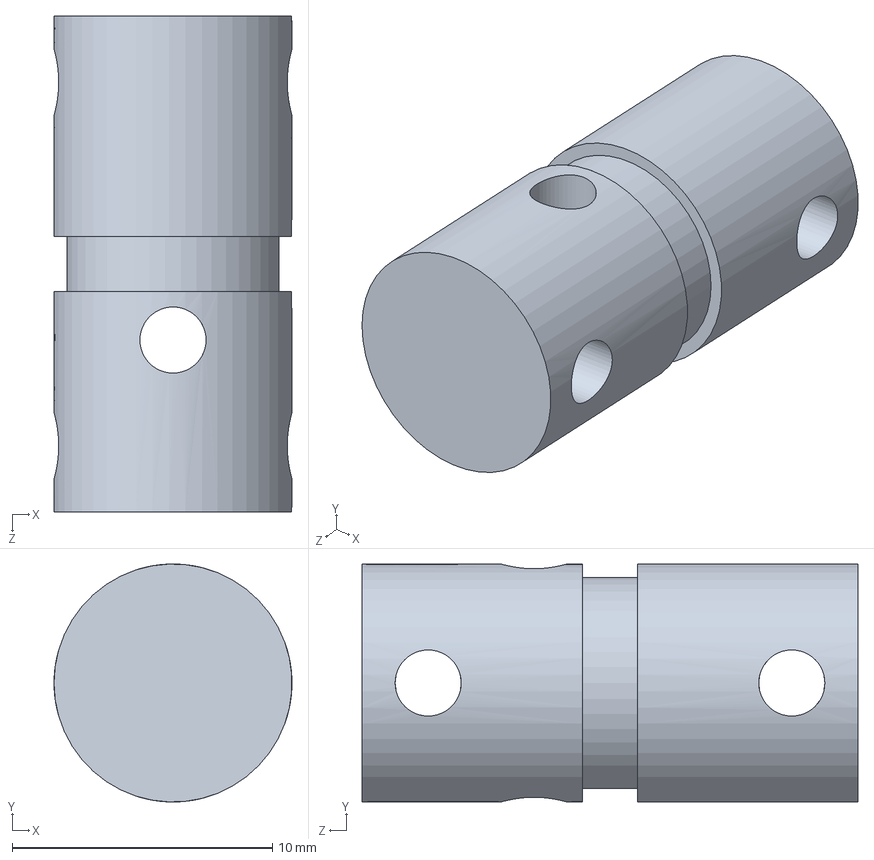
[picture p71: CAD file, 2025-11-19]
BassGuitar/CAD/S25/BridgeSaddle.SLDPRT
9.14 x 9.14 x 19.1 mm
