slacshan/MIDI-Projects/BassGuitar/CAD/S25/SmallMountingBracketG.SLDPRT

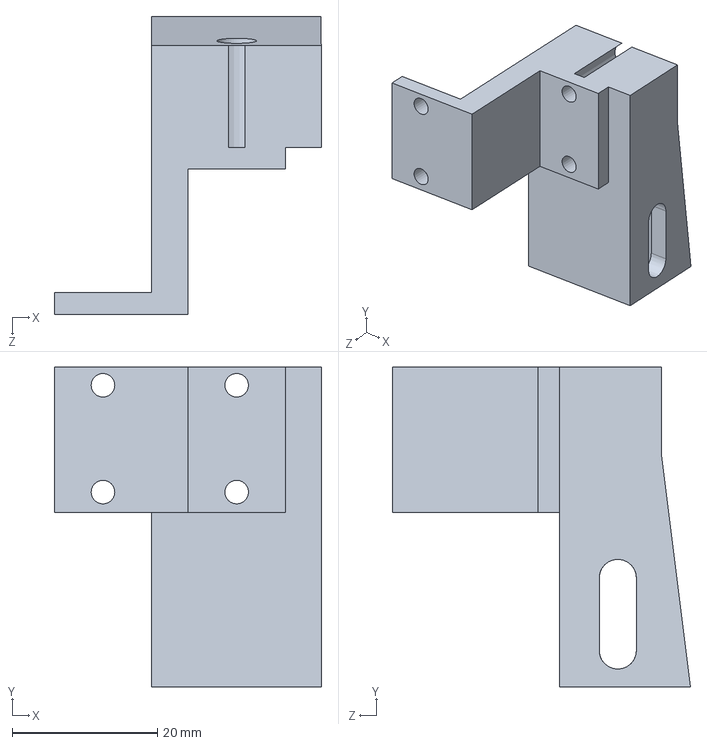
[picture p72: CAD file, 2025-11-19]
BassGuitar/CAD/S25/SmallMountingBracketG.SLDPRT
36.8 x 44.0 x 41.0 mm
