slacshan/MIDI-Projects/BassGuitar/CAD/S25/BottomSupportBracket.SLDPRT

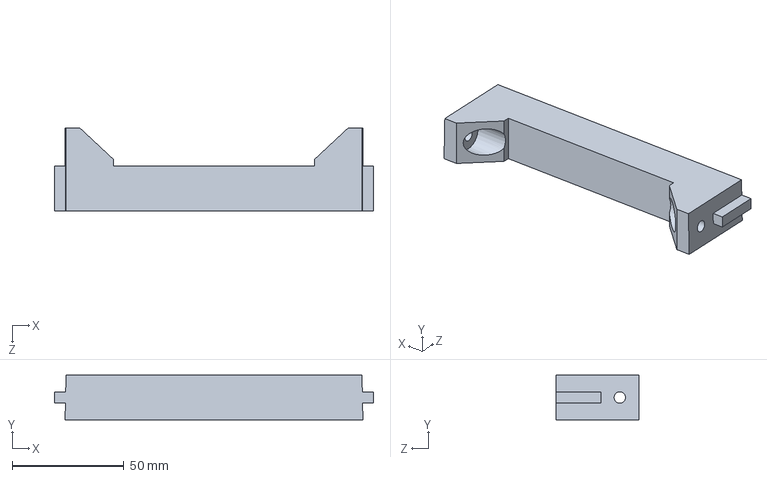
[picture p73: CAD file, 2025-11-19]
BassGuitar/CAD/S25/BottomSupportBracket.SLDPRT
143.0 x 20.0 x 37.0 mm
