slacshan/MIDI-Projects/BassGuitar/CAD/S25/SolenoidFiringPin.SLDPRT

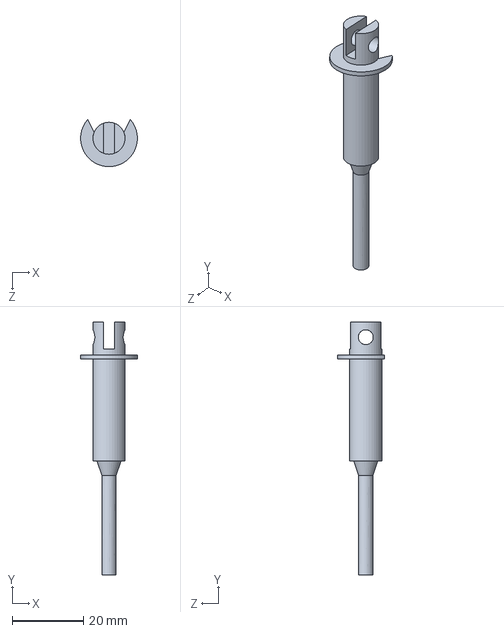
[picture p74: CAD file, 2025-11-19]
BassGuitar/CAD/S25/SolenoidFiringPin.SLDPRT
16.0 x 71.1 x 13.3 mm
