slacshan/MIDI-Projects/BassGuitar/CAD/S25/SimplifiedBridge.SLDPRT

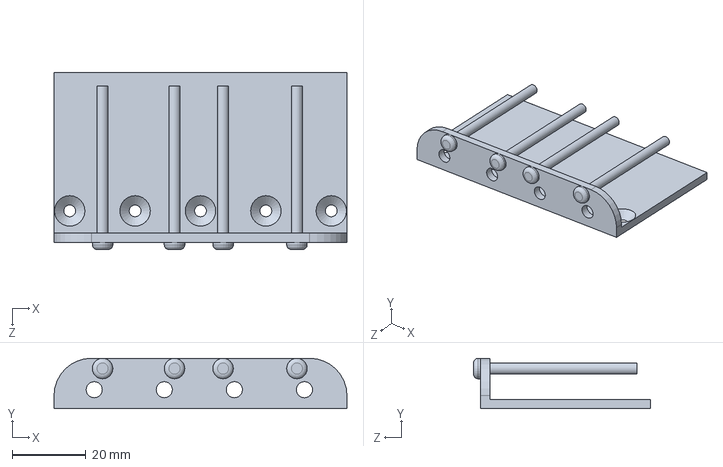
[picture p75: CAD file, 2025-11-19]
BassGuitar/CAD/S25/SimplifiedBridge.SLDPRT
79.7 x 13.7 x 48.1 mm
