slacshan/MIDI-Projects/BassGuitar/CAD/S25/P-Bass.SLDASM

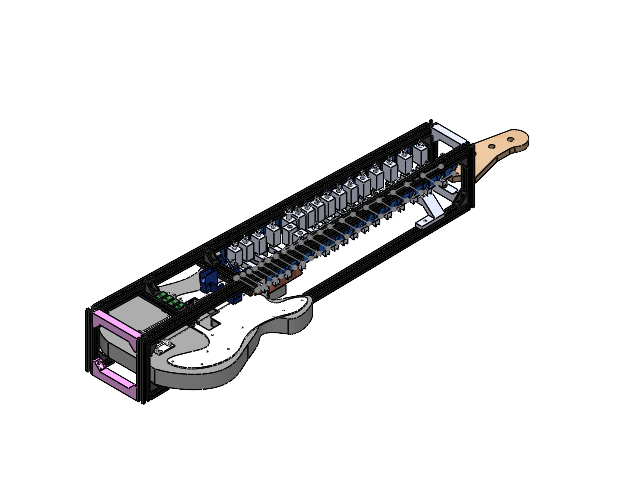
[picture p76: CAD file, 2025-11-19]
BassGuitar/CAD/S25/P-Bass.SLDASM
P-Bass Body
P-Bass Neck
Simplified Bridge
Bridge Saddle x 4
Pick Guard
2020 Extrusion x 4
25n Solenoid Simple Body x 35
Solenoid Firing pin x 34
90 Angle 2020 Bracket x 12
2020 Extrusion Short x 6
First Fret Bar
Top Cross Support x 2
Sponge Blank
Solenoid 2020 Mount x 33
.105 E String^P-Bass
.87 A String^P-Bass
.70 D String^P-Bass
.50 G String^P-Bass
Bottom Support Bracket x 2
4n Solenoid Body x 6
4n Solenoid Pin x 6
Small Mounting Bracket
Small Mounting Bracket D
Small Mounting Bracket A
Small Mounting Bracket G
Bass Mount left x 3
Neck Support Brace
2nd Fret Bar
3rd Fret Bar
4th Fret Bar
5th Fret Bar
6th Fret Bar
7th Fret Bar
8th Fret Bar
9th Fret Bar
10th Fret Bar
11th Fret Bar
12th Fret Bar
14th Fret Bar
16th Fret Bar
18th Fret Bar
20th Fret Bar
Muting Bracket x 4
