slacshan/MIDI-Projects/BassGuitar/CAD/S25/Electronics/PCBCaseAssem.SLDASM

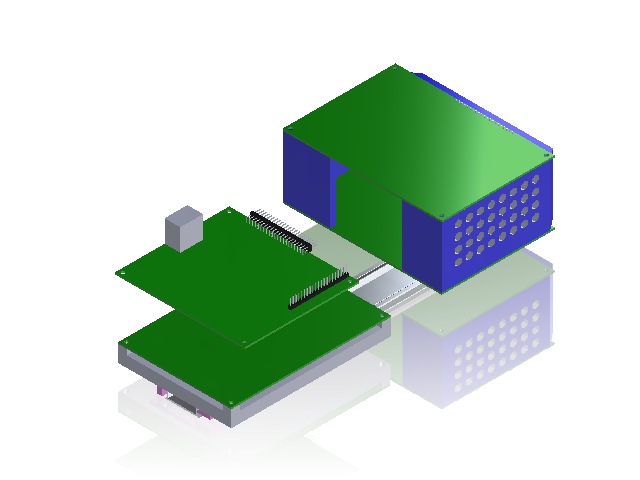
[picture p77: CAD file, 2025-11-19]
BassGuitar/CAD/S25/Electronics/PCBCaseAssem.SLDASM
Motherboard PCB BLANK
Solenoid PCB Blank x 3
2.54mm Header 21-pin x 4
2.54mm Right Header 21-pin 2x
Solenoid Hori Mount
DIN Rail Mounts x 3
DIN Mounting Rail
Fret Board Cage
