slacshan/MIDI-Projects/(list of files, cad)

Other CAD files:
BassGuitar/CAD/F25/PCBMountingPlate.dwg
BassGuitar/CAD/F25/BoarMountingPlate.dwg
BassGuitar/CAD/S25/STLs/PCBStandoff.STL
BassGuitar/CAD/S25/STLs/FretBoardCage.STL
BassGuitar/CAD/S25/Electronics/SolenoidHoriMount.SLDPRT
BassGuitar/CAD/S25/FretBars/8thFretBar.SLDPRT
BassGuitar/CAD/S25/FretBars/6thFretBar.SLDPRT
BassGuitar/CAD/S25/STLs/18thFretBar.STL
BassGuitar/CAD/S25/Electronics/DINRailMounts.SLDPRT
BassGuitar/CAD/S25/FretBars/7thFretBar.SLDPRT
BassGuitar/CAD/S25/STLs/3rdFretBar.STL
BassGuitar/CAD/S25/FretBars/20thFretBar.SLDPRT
BassGuitar/CAD/S25/STLs/12thFretBar.STL
BassGuitar/CAD/S25/SmallMountingBracketA.SLDPRT
BassGuitar/CAD/S25/STLs/2ndFretBar.STL
BassGuitar/CAD/S25/FretBars/FirstFretBar.SLDPRT
BassGuitar/CAD/S25/STLs/9thFretBar.STL
BassGuitar/CAD/S25/FretBars/16thFretBar.SLDPRT
BassGuitar/CAD/S25/STLs/4thFretBar.STL
BassGuitar/CAD/S25/STLs/BassMount.STL
BassGuitar/CAD/S25/STLs/10thFretBar.STL
BassGuitar/CAD/S25/STLs/20thFretBar.STL
BassGuitar/CAD/S25/STLs/11thFretBar.STL
BassGuitar/CAD/F25/2020DoubleT.dwg
BassGuitar/CAD/F25/2020DoubleT.ipt
BassGuitar/CAD/F25/2020T.dwg
BassGuitar/CAD/F25/2020T.ipt
BassGuitar/CAD/F25/Fret/FretBar.dwg
BassGuitar/CAD/F25/Fret/FretBar.ipt
BassGuitar/CAD/F25/Fret/GenrealBar.ipt
BassGuitar/CAD/F25/Fret/NeckRest.dwg
BassGuitar/CAD/F25/Fret/NeckRest.ipt
BassGuitar/CAD/F25/Fret/OldVersions/AllFretBars.0003.ipt
BassGuitar/CAD/F25/Fret/OldVersions/FretBar.0007.ipt
BassGuitar/CAD/F25/Fret/OldVersions/GenrealBar.0006.ipt
BassGuitar/CAD/F25/Fret/OldVersions/NeckRest.0002.dwg
BassGuitar/CAD/F25/Fret/OldVersions/NeckRest.0004.ipt
BassGuitar/CAD/F25/Fret/OldVersions/SolenoidMount.0002.dwg
BassGuitar/CAD/F25/Fret/OldVersions/SolenoidMount.0012.ipt
BassGuitar/CAD/F25/Fret/SolenoidMount.dwg
BassGuitar/CAD/F25/Fret/SolenoidMount.ipt
BassGuitar/CAD/F25/OldVersions/2020DoubleT.0001.ipt
BassGuitar/CAD/F25/OldVersions/2020T.0001.ipt
BassGuitar/CAD/F25/OldVersions/PCBMountingPlate.0001.ipt
BassGuitar/CAD/F25/PCBMountingPlate.ipt
BassGuitar/CAD/F25/PluckMute/LongPluckMount.dwg
BassGuitar/CAD/F25/PluckMute/LongPluckMount.ipt
BassGuitar/CAD/F25/PluckMute/MuteMount.dwg
BassGuitar/CAD/F25/PluckMute/MuteMount.ipt
BassGuitar/CAD/F25/PluckMute/OldVersions/LongPluckMount.0001.ipt
BassGuitar/CAD/F25/PluckMute/OldVersions/LongPluckMount.0002.dwg
BassGuitar/CAD/F25/PluckMute/OldVersions/MuteMount.0004.ipt
BassGuitar/CAD/F25/PluckMute/OldVersions/MuteMount.0006.dwg
BassGuitar/CAD/F25/PluckMute/OldVersions/PluckMount.0001.ipt
BassGuitar/CAD/F25/PluckMute/OldVersions/PluckTool.0007.ipt
BassGuitar/CAD/F25/PluckMute/PluckMount.ipt
BassGuitar/CAD/F25/PluckMute/PluckTool.dwg
BassGuitar/CAD/F25/PluckMute/PluckTool.ipt
BassGuitar/CAD/S25/Drawings/2020Extrusion970mmDrawing.SLDDRW
BassGuitar/CAD/S25/Drawings/2020ExtrusionShortDrawing.SLDDRW
BassGuitar/CAD/S25/Drawings/25nSolenoidSimpleBodyDrawing.SLDDRW
BassGuitar/CAD/S25/Drawings/4nSolenoidBodyDrawing.SLDDRW
BassGuitar/CAD/S25/Drawings/4nSolenoidPinDrawings.SLDDRW
BassGuitar/CAD/S25/Drawings/BassMountDrawing.SLDDRW
BassGuitar/CAD/S25/Drawings/BottomSupportBracketDrawing.SLDDRW
BassGuitar/CAD/S25/Drawings/BridgeSaddleDrawing.SLDDRW
BassGuitar/CAD/S25/Drawings/MutingBracketDrawing.SLDDRW
BassGuitar/CAD/S25/Drawings/NeckSupportBraceDrawing.SLDDRW
BassGuitar/CAD/S25/Drawings/P-BassBodyDrawing.SLDDRW
BassGuitar/CAD/S25/Drawings/P-BassNeckDrawing.SLDDRW
BassGuitar/CAD/S25/Drawings/PickGuardDrawing.SLDDRW
BassGuitar/CAD/S25/Drawings/SimplifiedBridgeDrawing.SLDDRW
BassGuitar/CAD/S25/Drawings/SmallMountingBracketDrawing.SLDDRW
BassGuitar/CAD/S25/Drawings/Solenoid2020MountDrawing.SLDDRW
BassGuitar/CAD/S25/Drawings/SolenoidFiringPinDrawing.SLDDRW
BassGuitar/CAD/S25/Drawings/TopCrossSupportDrawing.SLDDRW
BassGuitar/CAD/S25/STLs/90Angle2020Bracket.STL
BassGuitar/CAD/S25/STLs/BottomSupportBracket.STL
BassGuitar/CAD/S25/STLs/MutingBracket.STL
BassGuitar/CAD/S25/STLs/MutingFinger.STL
BassGuitar/CAD/S25/STLs/NeckSupportBrace.STL
BassGuitar/CAD/S25/STLs/SmallMountingBracket A.STL
BassGuitar/CAD/S25/STLs/SmallMountingBracket D.STL
BassGuitar/CAD/S25/STLs/SmallMountingBracket G.STL
BassGuitar/CAD/S25/STLs/SmallMountingBracket.STL
BassGuitar/CAD/S25/STLs/Solenoid2020Mount.STL
BassGuitar/CAD/S25/STLs/TopCrossSupport.STL
Infrared/CAD/OldVersions/TxCeilingMount.0001.ipt
Infrared/CAD/TxCeilingMount.ipt
