slacshan/MIDI-Projects/Documentation/S25/Images/High Level Troubleshooting.png

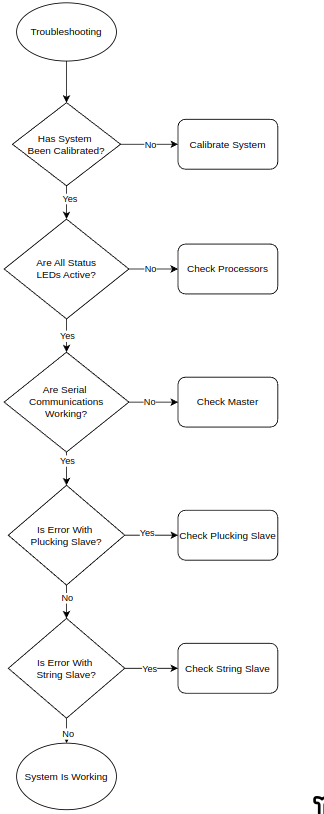
Documentation/S25/Images/High Level Troubleshooting.png
