slacshan/MIDI-Projects/Documentation/S25/Images/Processor Troubleshooting.png

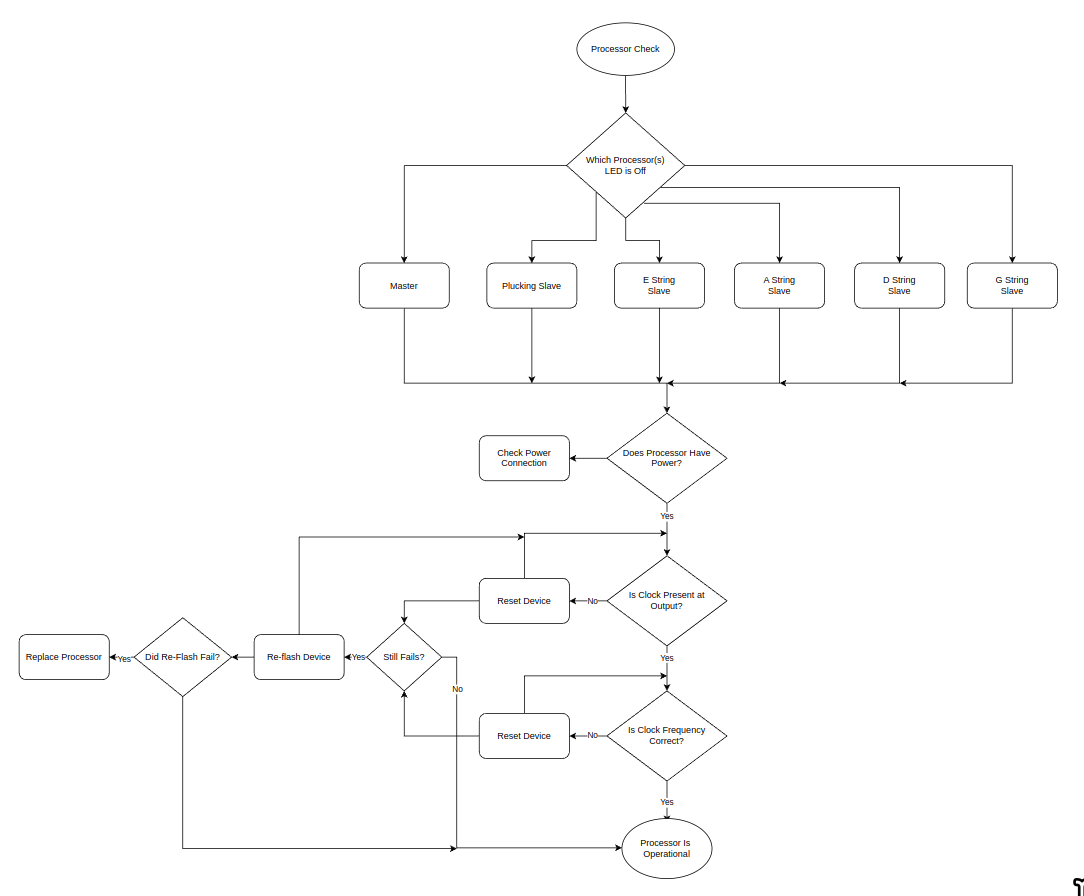
Documentation/S25/Images/Processor Troubleshooting.png
