slacshan/MIDI-Projects/Documentation/S25/Images/Serial Troubleshooting.png

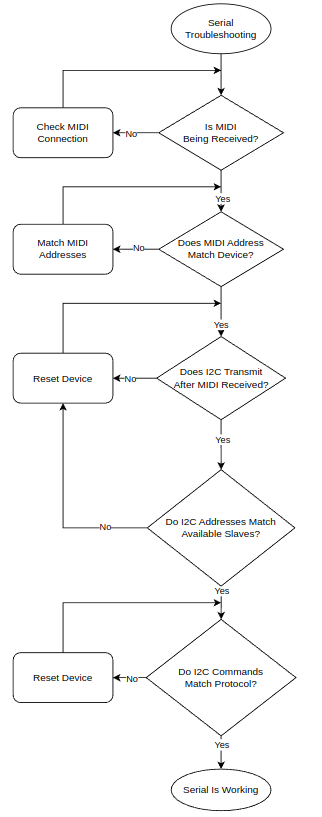
Documentation/S25/Images/Serial Troubleshooting.png
