slacshan/MIDI-Projects/Documentation/S25/Images/String Unit Troubleshooting.png

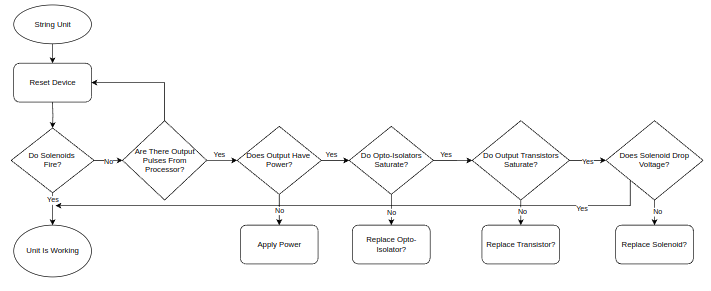
Documentation/S25/Images/String Unit Troubleshooting.png
