slacshan/MIDI-Projects/BassGuitar/CAD/F25/Bass2ChassisMountDrawing.pdf

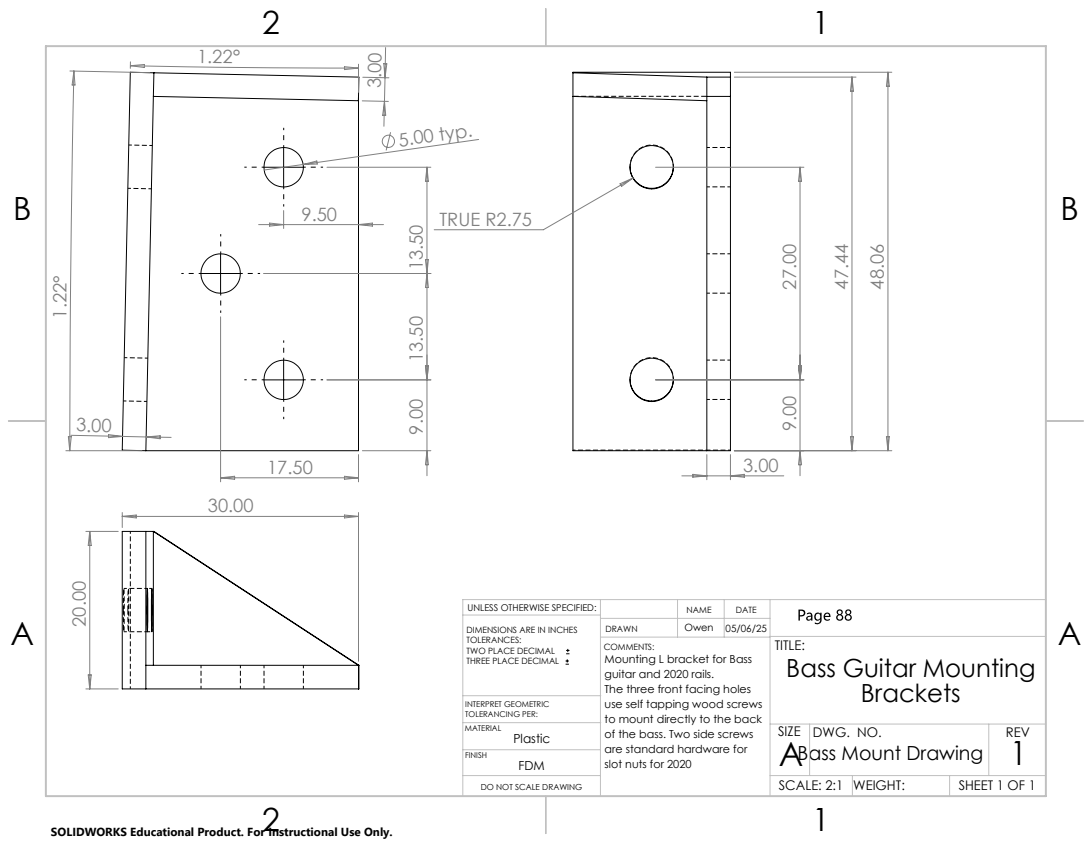
[picture p82: page 1]
5.00 typ.; TRUE R2.75; SHEET 1 OF 1; SCALE: 2:1; WEIGHT:; FDM FINISH; INTERPRET GEOMETRIC TOLERANCING PER:

UNLESS OTHERWISE SPECIFIED: | | NAME | DATE
DIMENSIONS ARE IN INCHES TOLERANCES: TWO PLACE DECIMAL THREE PLACE DECIMAL | DRAWN | Owen | 05/06/25

COMMENTS: Mounting L bracket for Bass guitar and 2020 rails. The three front facing holes use self tapping wood screws to mount directly to the back of the bass. Two side screws are standard hardware for slot nuts for 2020 | | | TITLE: Bass Guitar Mounting Brackets

MATERIAL Plastic | | SIZE A Bass Mount Drawing | DWG. NO. | REV 1

DO NOT SCALE DRAWING

SOLIDWORKS Educational Product. For Instructional Use Only.
