slacshan/MIDI-Projects/BassGuitar/Programming/F25/Flow chart_Fret/Flow Chart Final.drawio.pdf

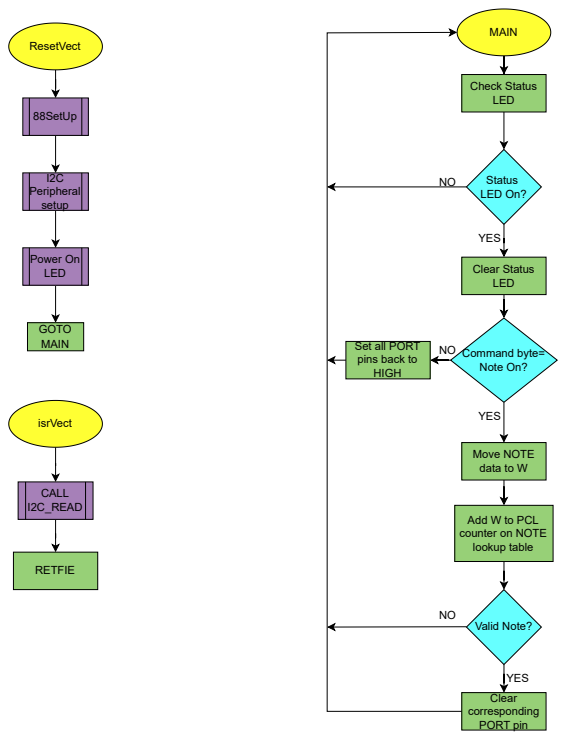
[picture p83: page 1]
MAIN; ResetVect; 88SetUp; I2C Peripheral setup; Power On LED; GOT; O MAIN; Check Status LED; Status LED On?; Clear Status LED; Command byte= Note On?; YES; Move NOTE data to W; Clear corresponding POR; T pin; isrVect; CALL I2C_READ; RETFIE

Set all POR
pins back to
HIGH

Add W to PCL
counter on NOTE
lookup table Valid Note?
