slacshan/MIDI-Projects/BassGuitar/CAD/S25/DrawingPDFs/2020Extrusion970mmDrawing.pdf

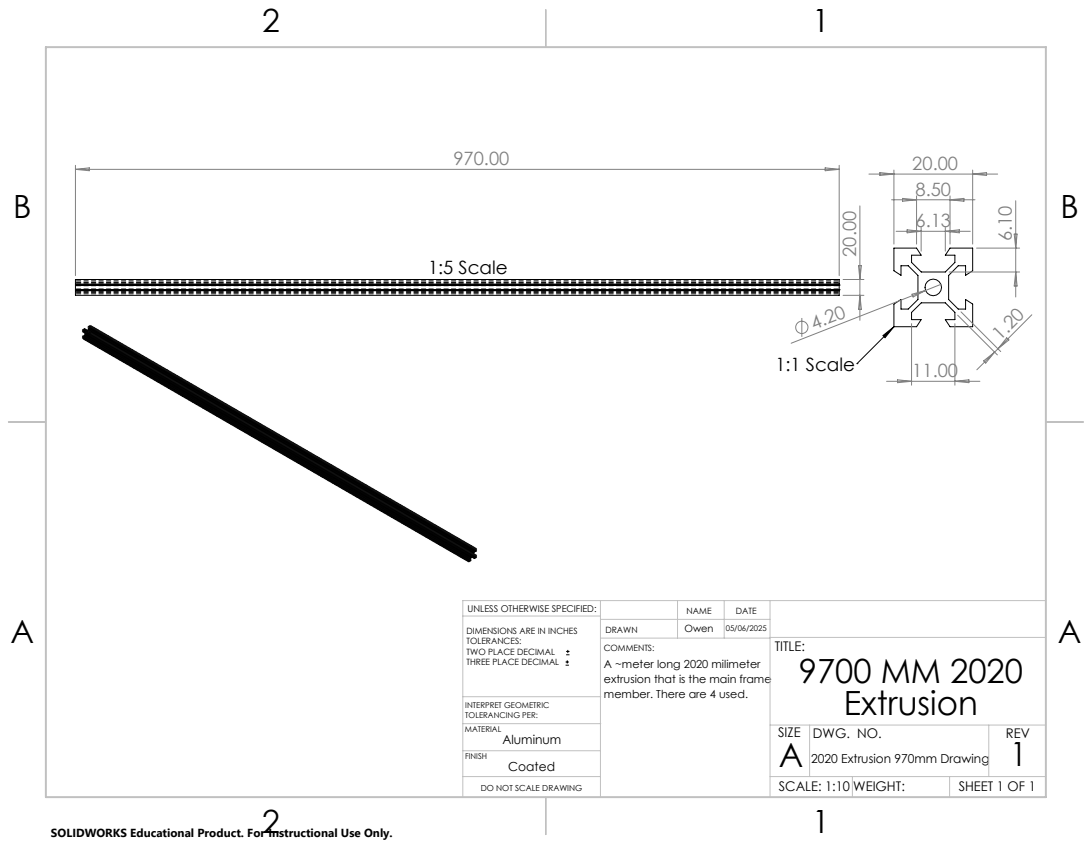
[picture p84: page 1]
1:5 Scale; 1:1 Scale; SHEET 1 OF 1; SCALE: 1:10 WEIGHT:; Coated FINISH; INTERPRET GEOMETRIC TOLERANCING PER:

UNLESS OTHERWISE SPECIFIED: | | NAME | DATE
DIMENSIONS ARE IN INCHES TOLERANCES: TWO PLACE DECIMAL THREE PLACE DECIMAL | DRAWN | Owen | 05/06/2025

COMMENTS: A ~meter long 2020 milimeter extrusion that is the main frame member. There are 4 used. | | | TITLE: 9700 MM 2020 Extrusion

MATERIAL Aluminum | | SIZE A | DWG. NO. 2020 Extrusion 970mm Drawing | REV 1

DO NOT SCALE DRAWING

SOLIDWORKS Educational Product. For Instructional Use Only.
