slacshan/MIDI-Projects/BassGuitar/CAD/S25/DrawingPDFs/2020ExtrusionShortDrawing.pdf

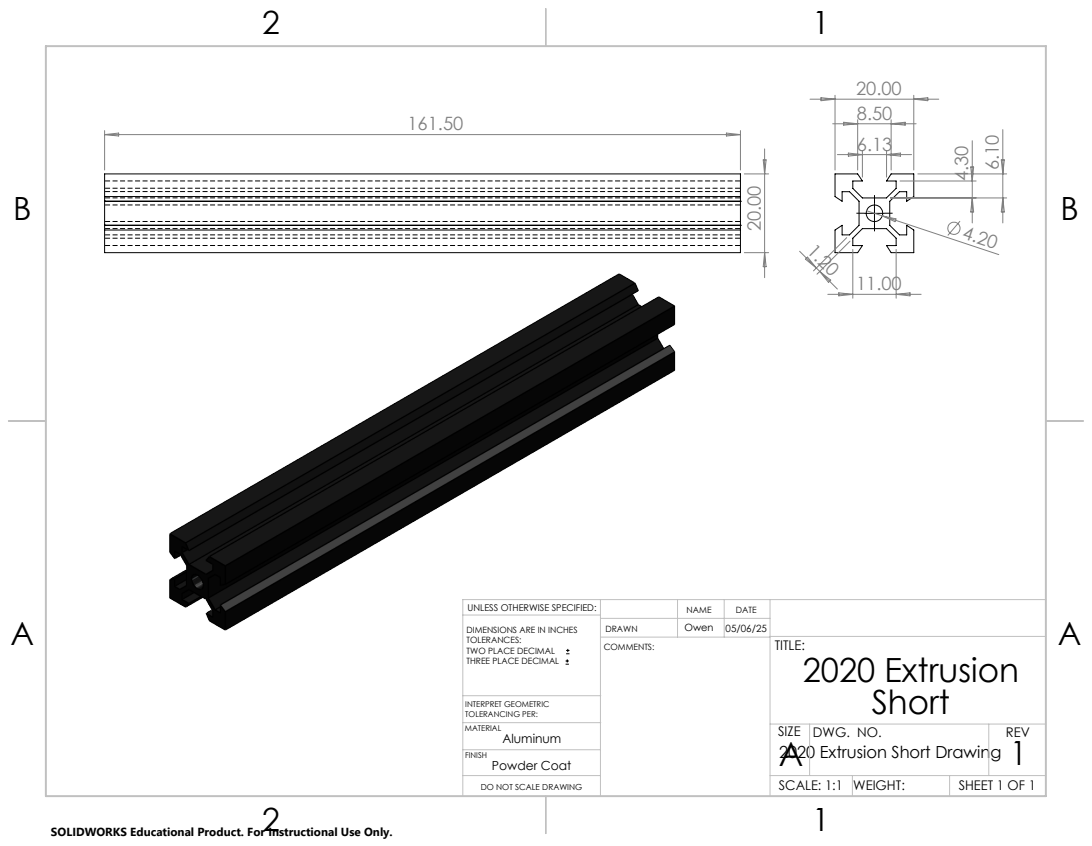
[picture p85: page 1]
SHEET 1 OF 1; SCALE: 1:1; WEIGHT:; INTERPRET GEOMETRIC TOLERANCING PER:

UNLESS OTHERWISE SPECIFIED: | | NAME | DATE
DIMENSIONS ARE IN INCHES TOLERANCES: TWO PLACE DECIMAL THREE PLACE DECIMAL | DRAWN | Owen | 05/06/25
COMMENTS: | | | TITLE: 2020 Extrusion Short

MATERIAL Aluminum | | SIZE A 2020 Extrusion Short Drawing | DWG. NO. | REV 1

Powder Coat FINISH

DO NOT SCALE DRAWING

SOLIDWORKS Educational Product. For Instructional Use Only.
