slacshan/MIDI-Projects/BassGuitar/CAD/S25/DrawingPDFs/4nSolenoidBodyDrawing.pdf

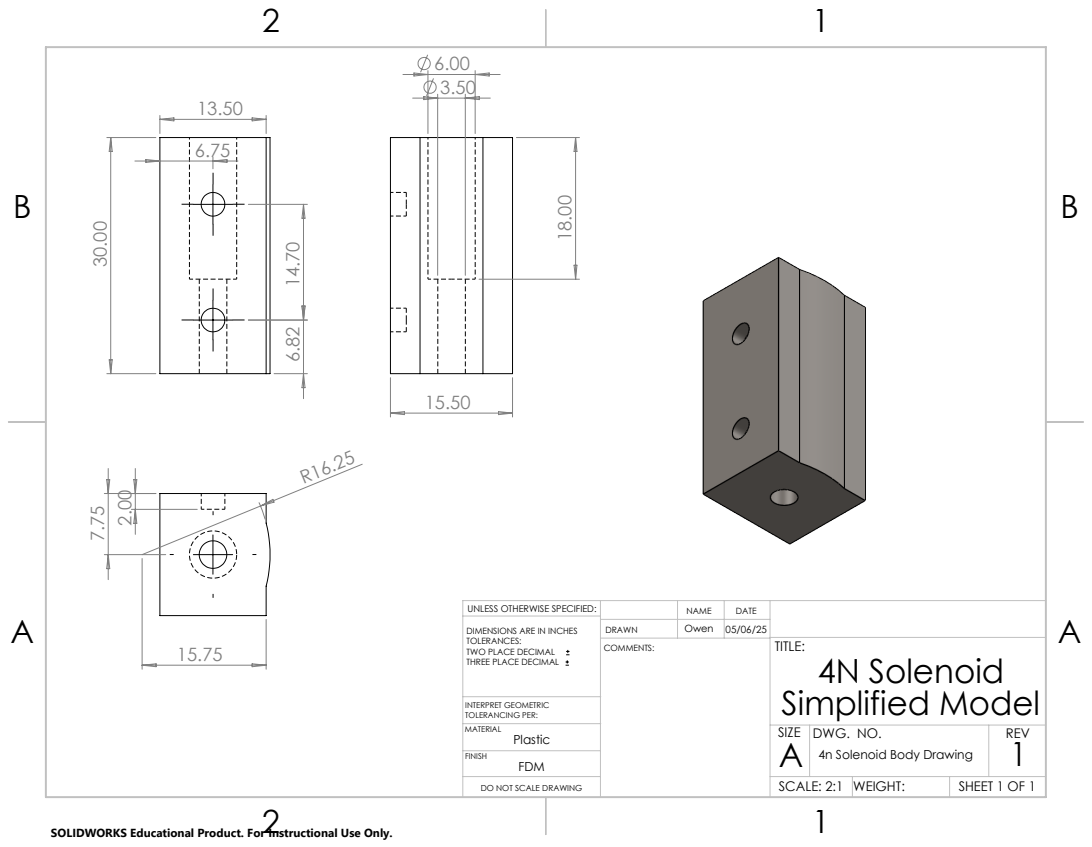
[picture p87: page 1]
SHEET 1 OF 1; SCALE: 2:1; WEIGHT:; FDM FINISH; INTERPRET GEOMETRIC TOLERANCING PER:

UNLESS OTHERWISE SPECIFIED: | | NAME | DATE
DIMENSIONS ARE IN INCHES TOLERANCES: TWO PLACE DECIMAL THREE PLACE DECIMAL | DRAWN | Owen | 05/06/25
COMMENTS: | | | TITLE: 4N Solenoid Simplified Model

MATERIAL Plastic | | SIZE A | DWG. NO. 4n Solenoid Body Drawing | REV 1

DO NOT SCALE DRAWING

SOLIDWORKS Educational Product. For Instructional Use Only.
