slacshan/MIDI-Projects/BassGuitar/CAD/S25/DrawingPDFs/BridgeSaddleDrawing.pdf

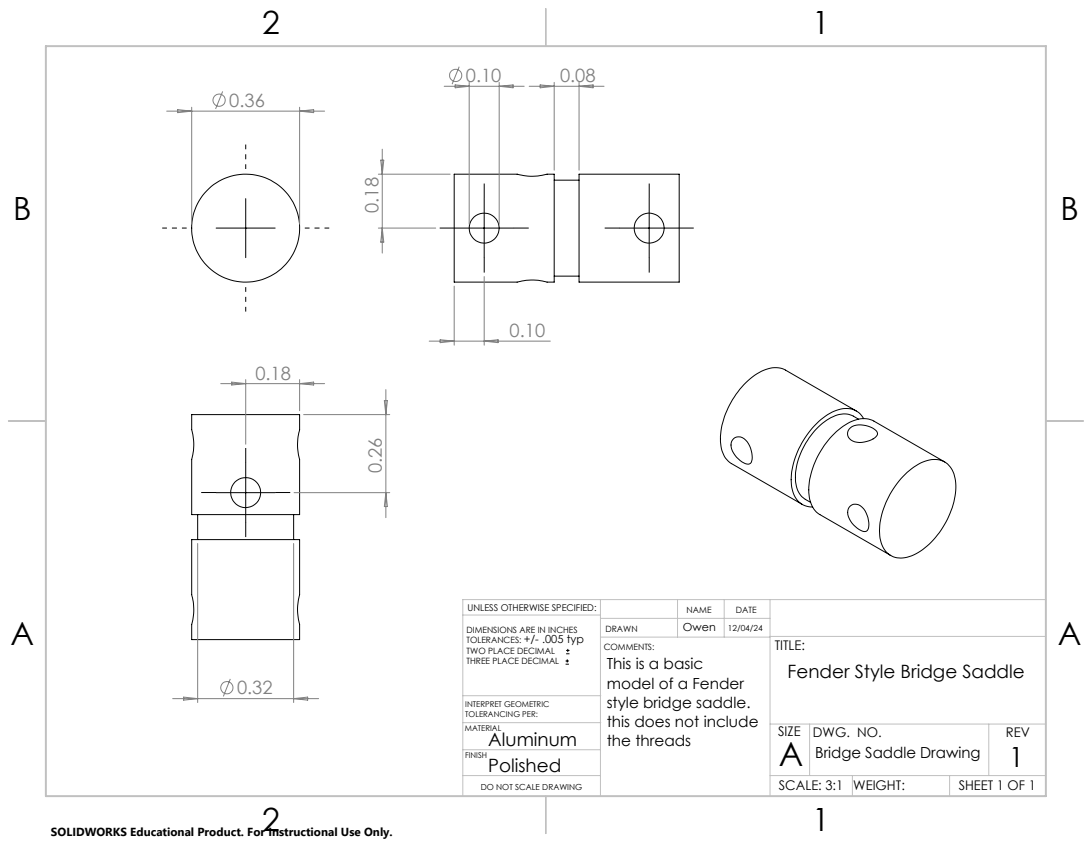
[picture p90: page 1]
SHEET 1 OF 1; SCALE: 3:1; WEIGHT:; INTERPRET GEOMETRIC TOLERANCING PER:

UNLESS OTHERWISE SPECIFIED: | | NAME | DATE
DIMENSIONS ARE IN INCHES TOLERANCES: +/- .005 typ TWO PLACE DECIMAL THREE PLACE DECIMAL | DRAWN | Owen | 12/04/24

COMMENTS: model of a Fender style bridge saddle. this does not include the threads | | | TITLE: Fender Style Bridge Saddle This is a basic

MATERIAL Aluminum | | SIZE A | DWG. NO. Bridge Saddle Drawing | REV 1

DO NOT SCALE DRAWING

SOLIDWORKS Educational Product. For Instructional Use Only.
