slacshan/MIDI-Projects/BassGuitar/CAD/S25/DrawingPDFs/P-BassBodyDrawing.pdf

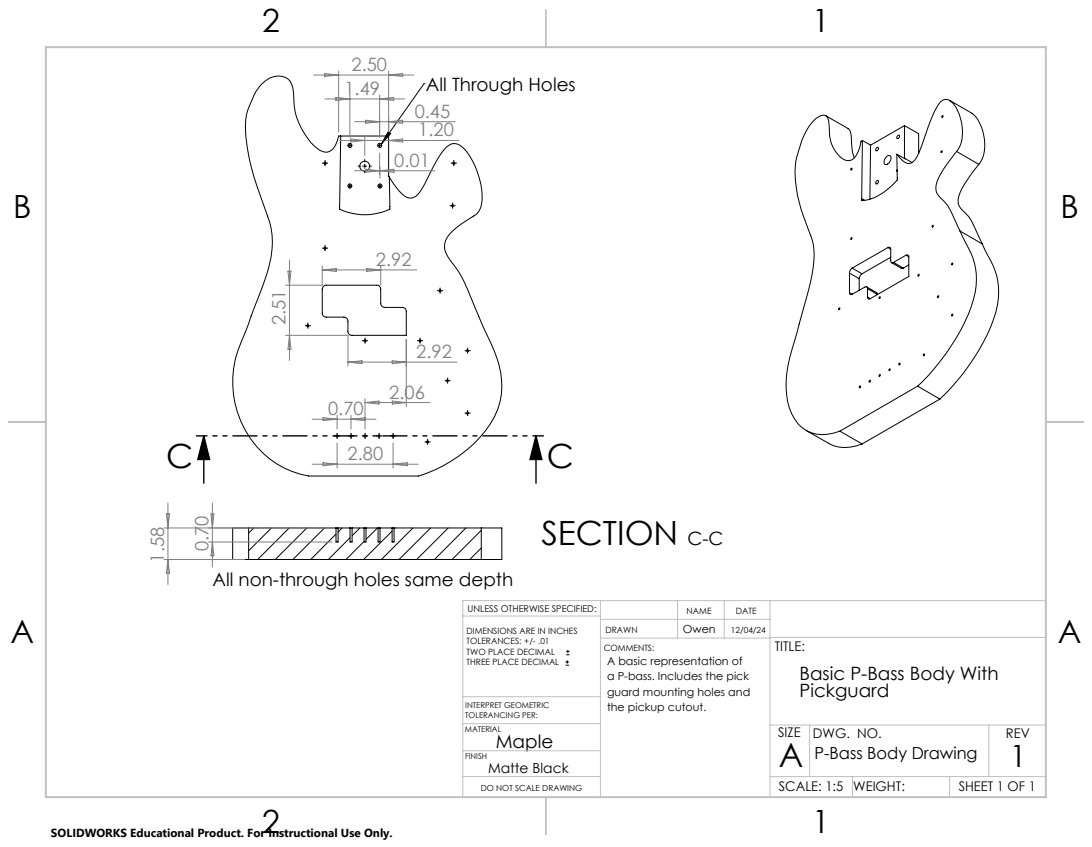
[picture p93: page 1]
All Through Holes; SECTION C-C; SHEET 1 OF 1; SCALE: 1:5; WEIGHT:; INTERPRET GEOMETRIC TOLERANCING PER:

All non-through holes same depth

UNLESS OTHERWISE SPECIFIED: | | NAME | DATE
DIMENSIONS ARE IN INCHES TOLERANCES: +/- .01 TWO PLACE DECIMAL THREE PLACE DECIMAL | DRAWN | Owen | 12/04/24

COMMENTS: A basic representation of a P-bass. Includes the pick guard mounting holes and the pickup cutout. | | | TITLE: Basic P-Bass Body With Pickguard

MATERIAL Maple Matte Black | | SIZE A | DWG. NO. P-Bass Body Drawing | REV 1

DO NOT SCALE DRAWING

SOLIDWORKS Educational Product. For Instructional Use Only.
