slacshan/MIDI-Projects/BassGuitar/CAD/S25/DrawingPDFs/P-BassNeckDrawing.pdf

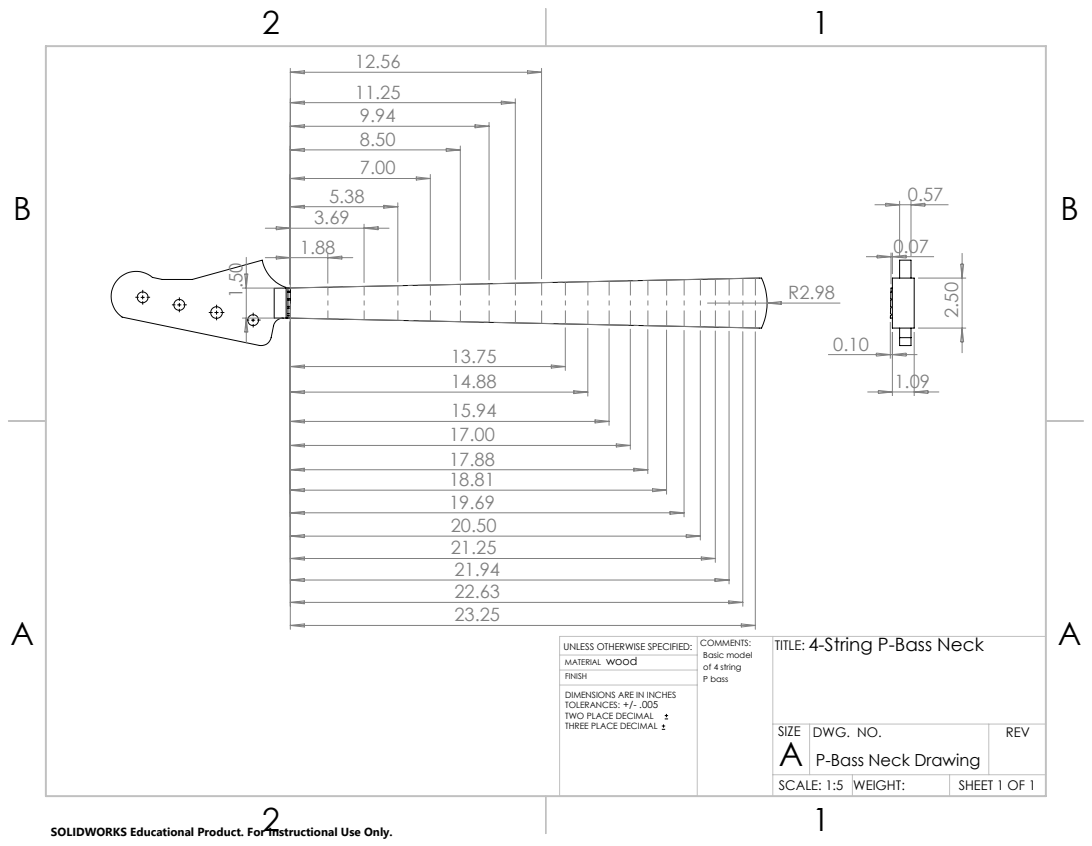
[picture p94: page 1]
of 4 string P bass

4-String P-Bass Neck Basic model
TITLE: COMMENTS:

UNLESS OTHERWISE SPECIFIED:
wood

MATERIAL
FINISH
DIMENSIONS ARE IN INCHES
TOLERANCES:
TWO PLACE DECIMAL
THREE PLACE DECIMAL

SIZE A | DWG. NO. P-Bass Neck Drawing | REV

SCALE: 1:5 | WEIGHT: | SHEET 1 OF 1

SOLIDWORKS Educational Product. For Instructional Use Only.
