slacshan/MIDI-Projects/BassGuitar/CAD/S25/DrawingPDFs/SimplifiedBridgeDrawing.pdf

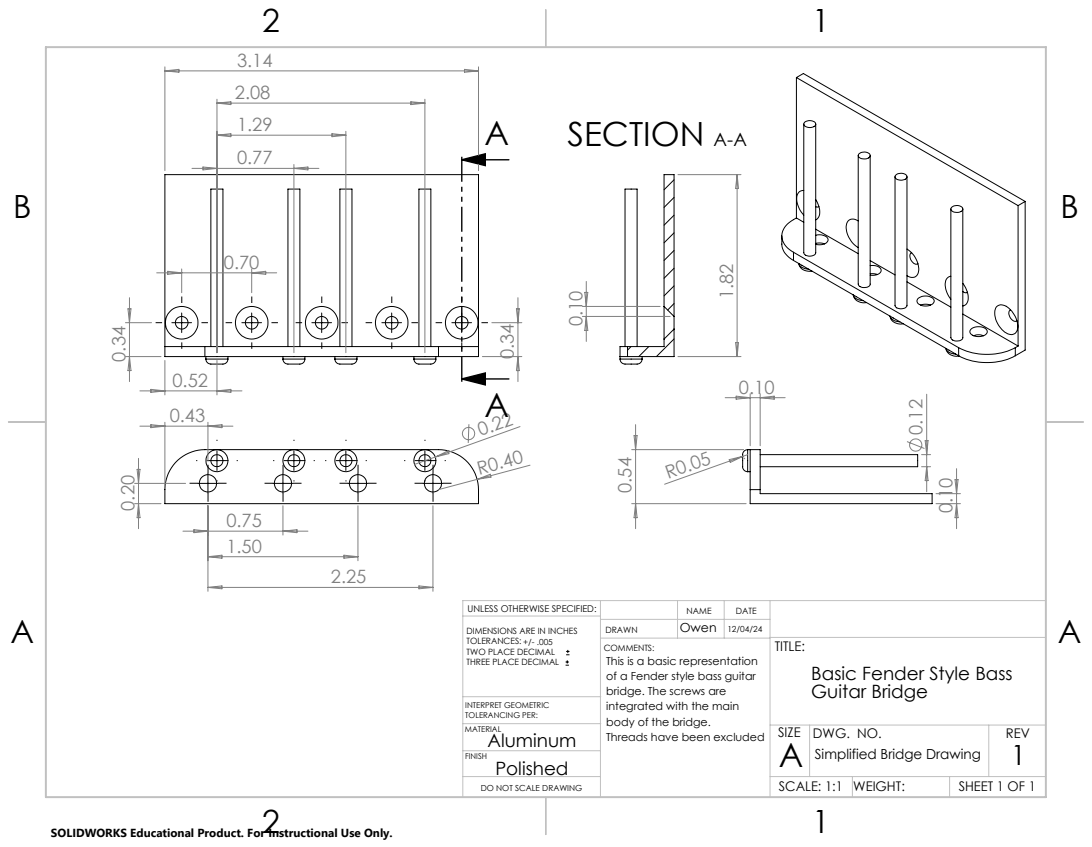
[picture p95: page 1]
SECTION A-A; SHEET 1 OF 1; SCALE: 1:1; WEIGHT:; INTERPRET GEOMETRIC TOLERANCING PER:

UNLESS OTHERWISE SPECIFIED: | | NAME | DATE
DIMENSIONS ARE IN INCHES TOLERANCES: +/- .005 TWO PLACE DECIMAL THREE PLACE DECIMAL | DRAWN | Owen | 12/04/24

COMMENTS: This is a basic representation of a Fender style bass guitar bridge. The screws are integrated with the main body of the bridge. Threads have been excluded | | | TITLE: Basic Fender Style Bass Guitar Bridge

MATERIAL Aluminum | | SIZE A | DWG. NO. Simplified Bridge Drawing | REV 1

DO NOT SCALE DRAWING

SOLIDWORKS Educational Product. For Instructional Use Only.
