slacshan/MIDI-Projects/BassGuitar/CAD/S25/DrawingPDFs/SmallMountingBracketDrawing.pdf

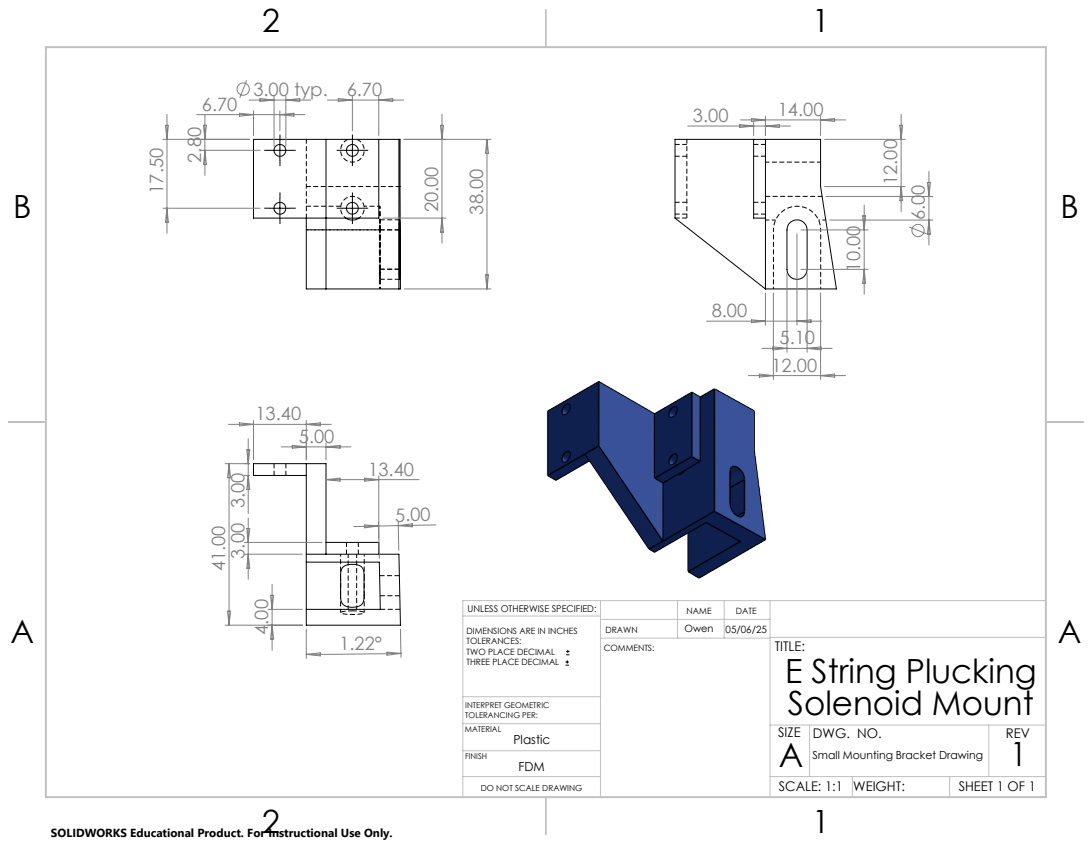
[picture p96: page 1]
3.00 typ.; SHEET 1 OF 1; SCALE: 1:1; WEIGHT:; FDM FINISH; INTERPRET GEOMETRIC TOLERANCING PER:

UNLESS OTHERWISE SPECIFIED: | | NAME | DATE
DIMENSIONS ARE IN INCHES TOLERANCES: TWO PLACE DECIMAL THREE PLACE DECIMAL | DRAWN | Owen | 05/06/25
COMMENTS: | | | TITLE: E String Plucking Solenoid Mount

MATERIAL Plastic | | SIZE A | DWG. NO. Small Mounting Bracket Drawing | REV 1

DO NOT SCALE DRAWING

SOLIDWORKS Educational Product. For Instructional Use Only.
