slacshan/MIDI-Projects/BassGuitar/CAD/S25/DrawingPDFs/Solenoid2020MountDrawing.pdf

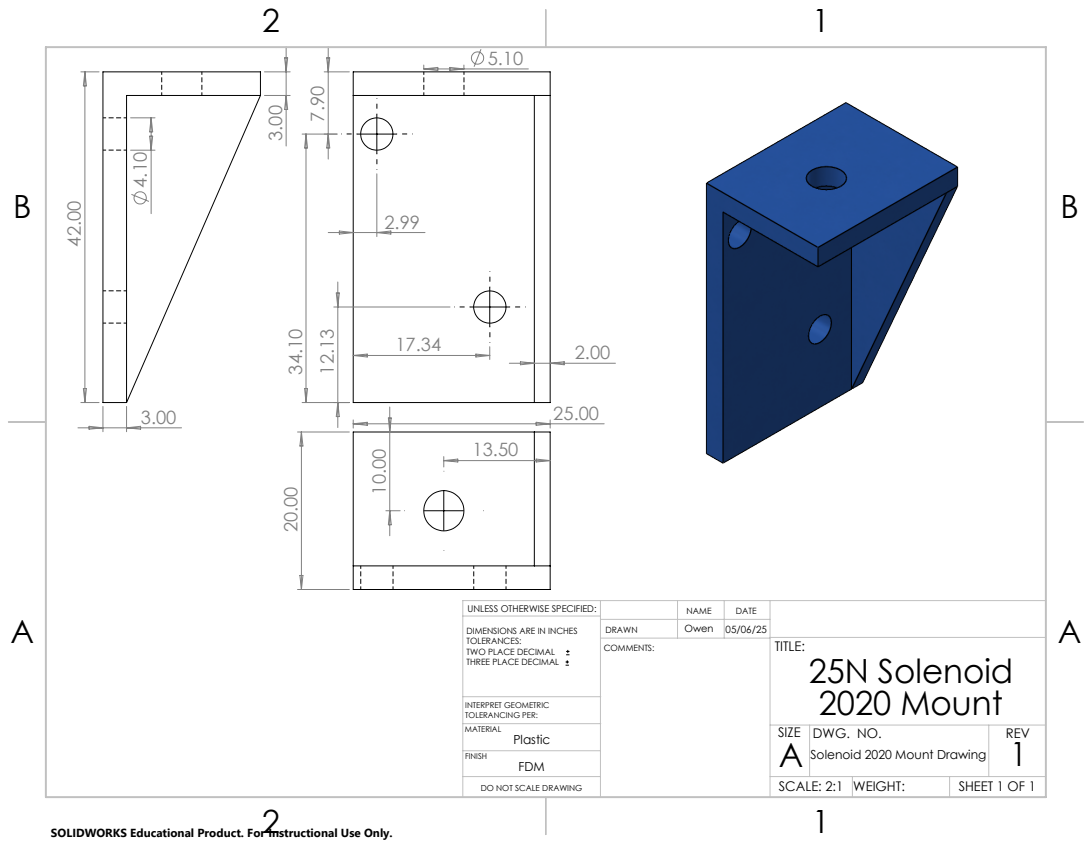
[picture p97: page 1]
SHEET 1 OF 1; SCALE: 2:1; WEIGHT:; FDM FINISH; INTERPRET GEOMETRIC TOLERANCING PER:

UNLESS OTHERWISE SPECIFIED: | | NAME | DATE
DIMENSIONS ARE IN INCHES TOLERANCES: TWO PLACE DECIMAL THREE PLACE DECIMAL | DRAWN | Owen | 05/06/25
COMMENTS: | | | TITLE: 25N Solenoid 2020 Mount

MATERIAL Plastic | | SIZE A | DWG. NO. Solenoid 2020 Mount Drawing | REV 1

DO NOT SCALE DRAWING

SOLIDWORKS Educational Product. For Instructional Use Only.
