slacshan/MIDI-Projects/BassGuitar/CAD/S25/DrawingPDFs/SolenoidFiringPinDrawing.pdf

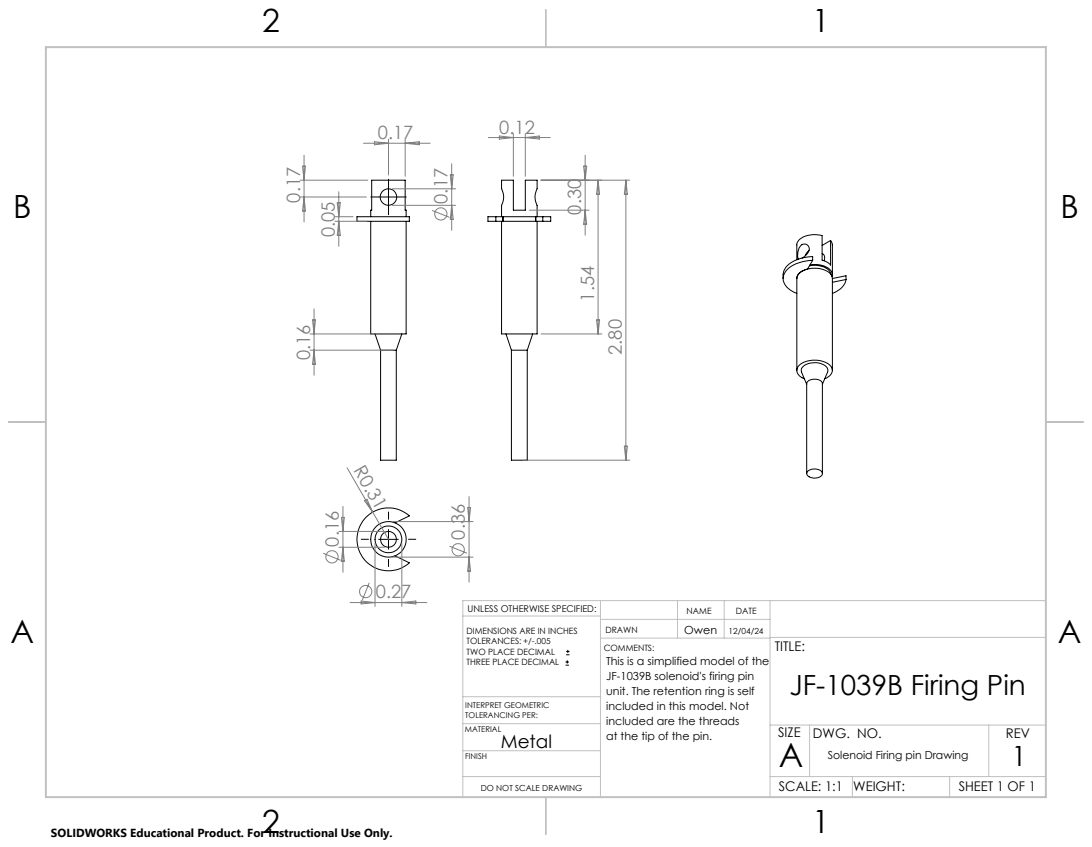
[picture p98: page 1]
SHEET 1 OF 1; SCALE: 1:1; WEIGHT:; INTERPRET GEOMETRIC TOLERANCING PER:

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

COMMENTS: This is a simplified model of the JF-1039B solenoid's firing pin unit. The retention ring is self included in this model. Not included are the threads at the tip of the pin. | | | TITLE: JF-1039B Firing Pin

MATERIAL Metal | | SIZE A | DWG. NO. Solenoid Firing pin Drawing | REV 1

DO NOT SCALE DRAWING

SOLIDWORKS Educational Product. For Instructional Use Only.
