slacshan/MIDI-Projects/BassGuitar/CAD/F25/Fret/PDFs/SolenoidMount.pdf

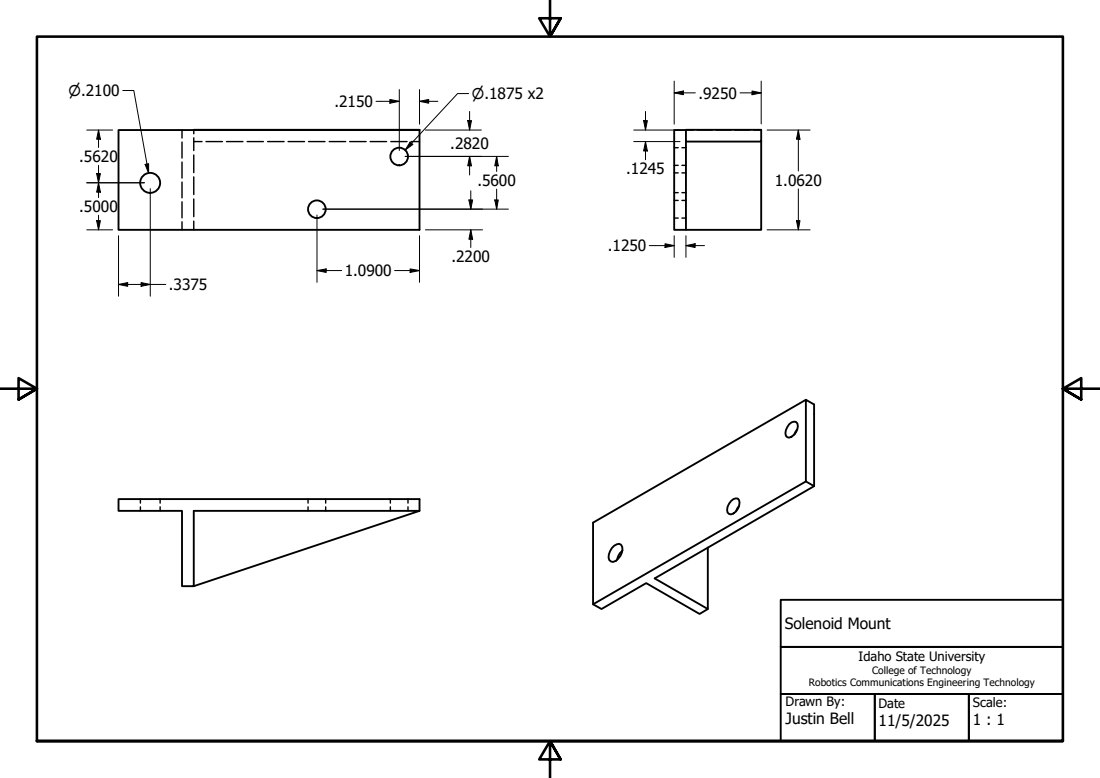
[picture p100: page 1]
Solenoid Mount

Idaho State University
College of Technology

Robotics Communications Engineering Technology
Drawn By:
Justin Bell
