slacshan/MIDI-Projects/BassGuitar/CAD/F25/PluckMute/PDFs/MuteMount.pdf

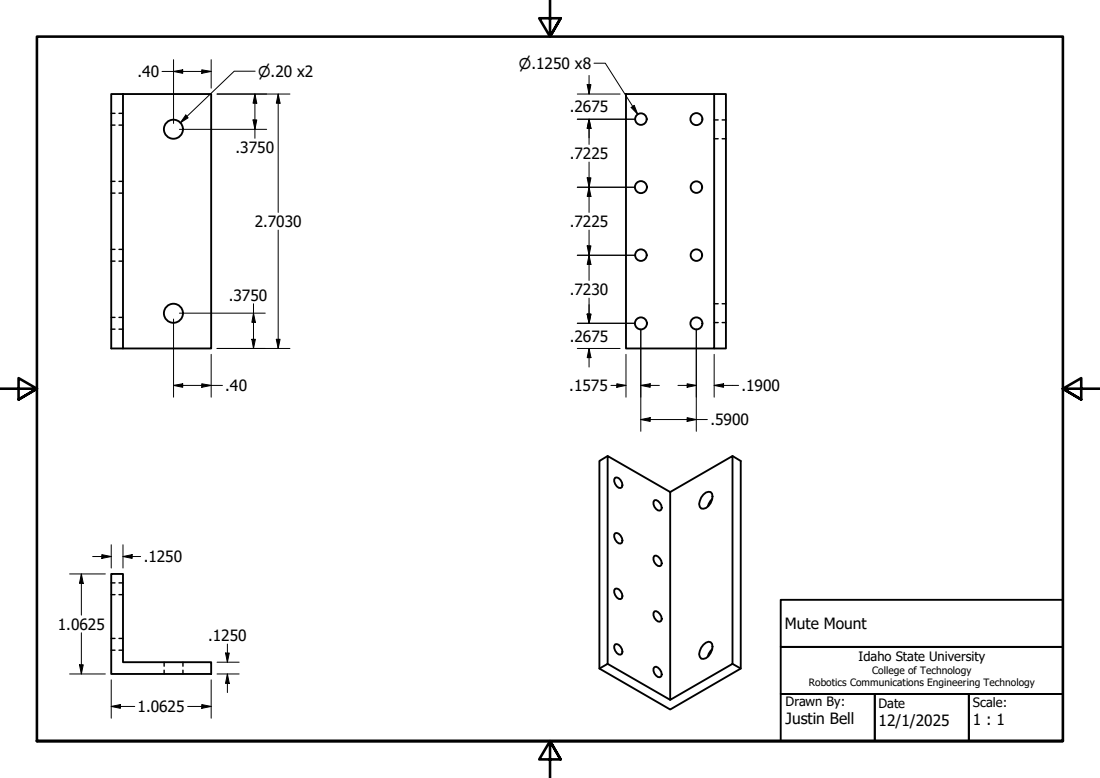
[picture p101: page 1]
Mute Mount

Idaho State University
College of Technology

Robotics Communications Engineering Technology
Drawn By:
Justin Bell
