slacshan/MIDI-Projects/Infrared/Rx/PDFs/IR_MIDI_Rx_Schematic_RevB.pdf

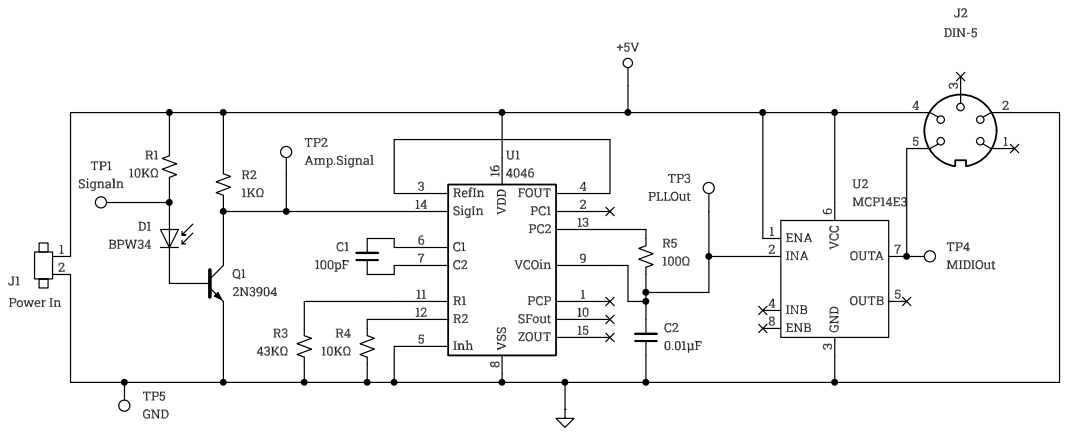
[picture p102: page 1]
