slacshan/MIDI-Projects/Infrared/Tx/PDFs/IR_MIDI_Tx_Schematic_RevC.pdf

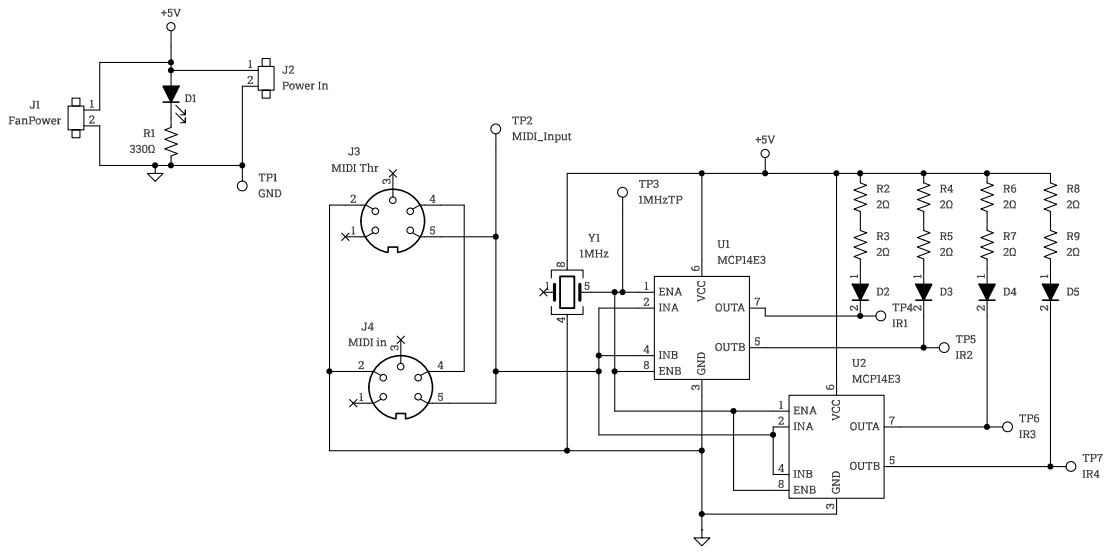
[picture p103: page 1]
