slacshan/MIDI-Projects/Universals/Master/PDFs/UniversalMasterSchematicRevA.pdf

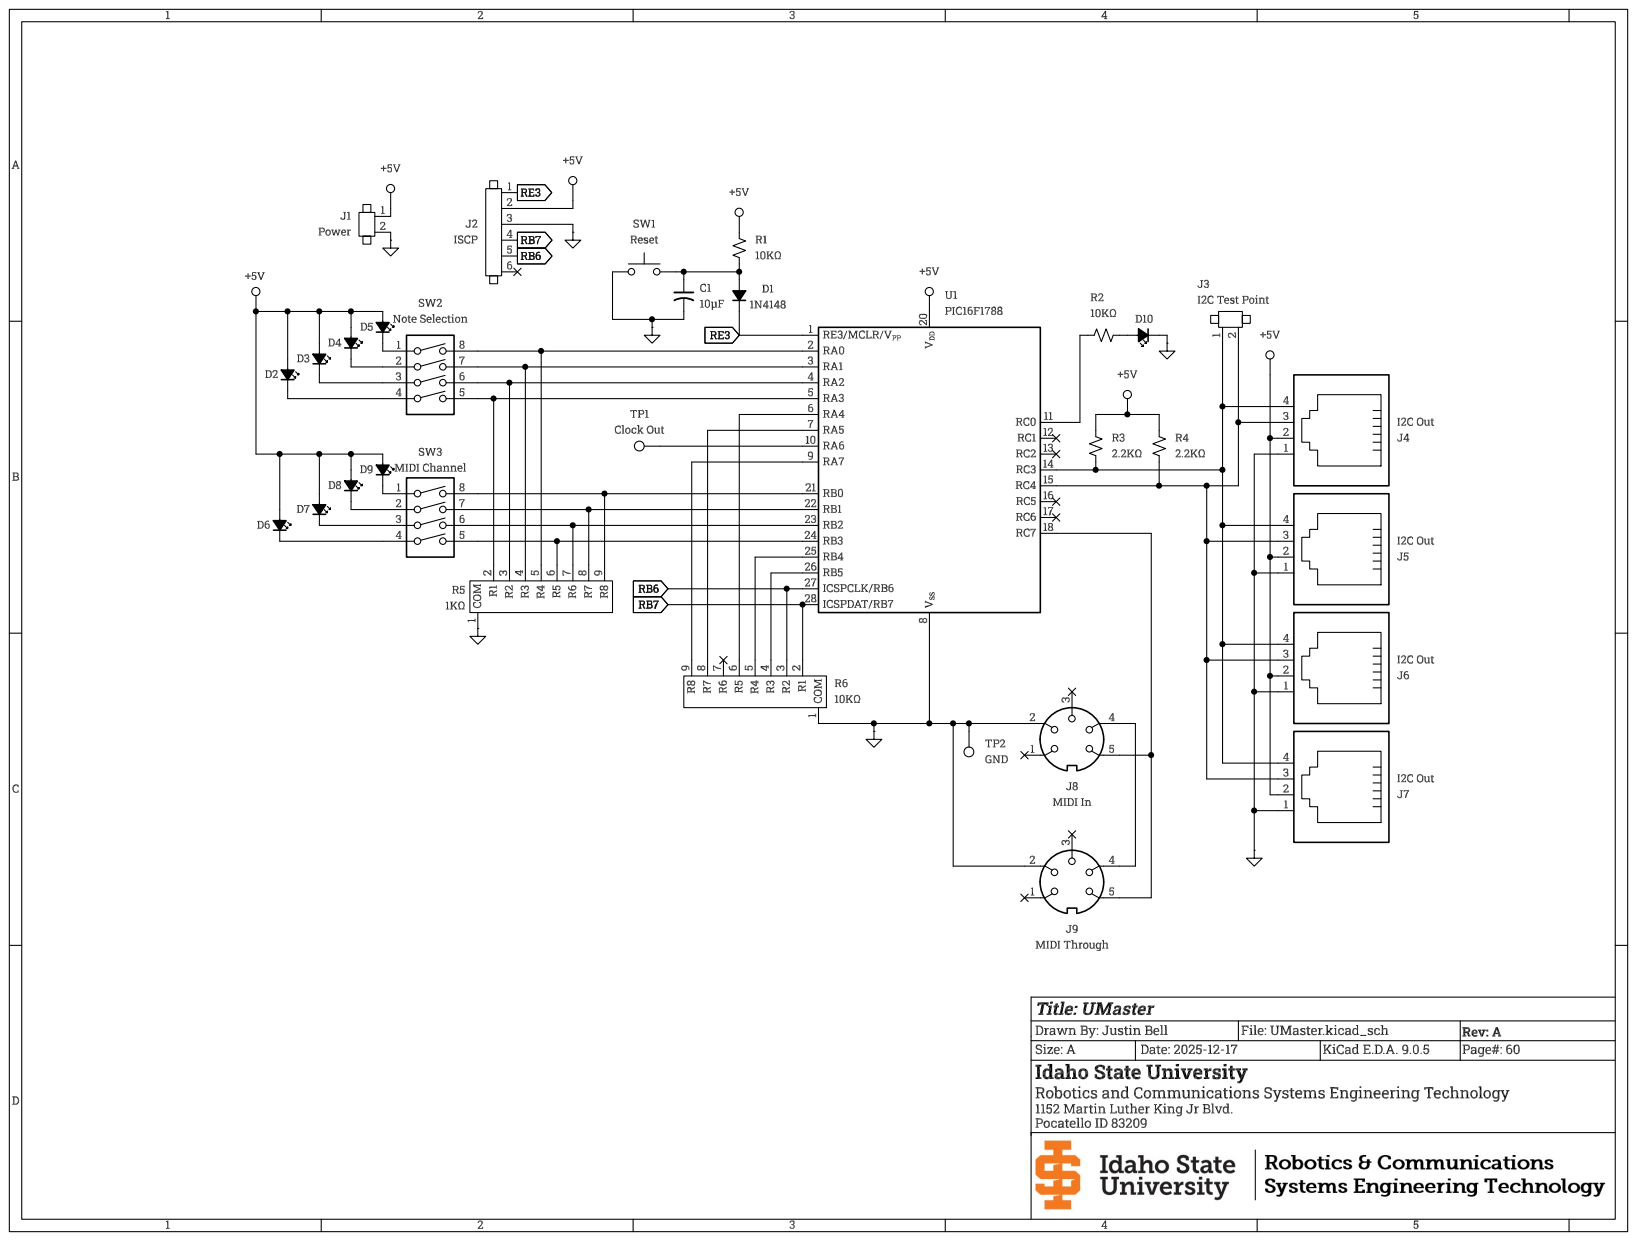
[picture p104: page 1]
