slacshan/MIDI-Projects/Universals/Slave/PDFs/UniversalSlaveSchematicRevA.pdf

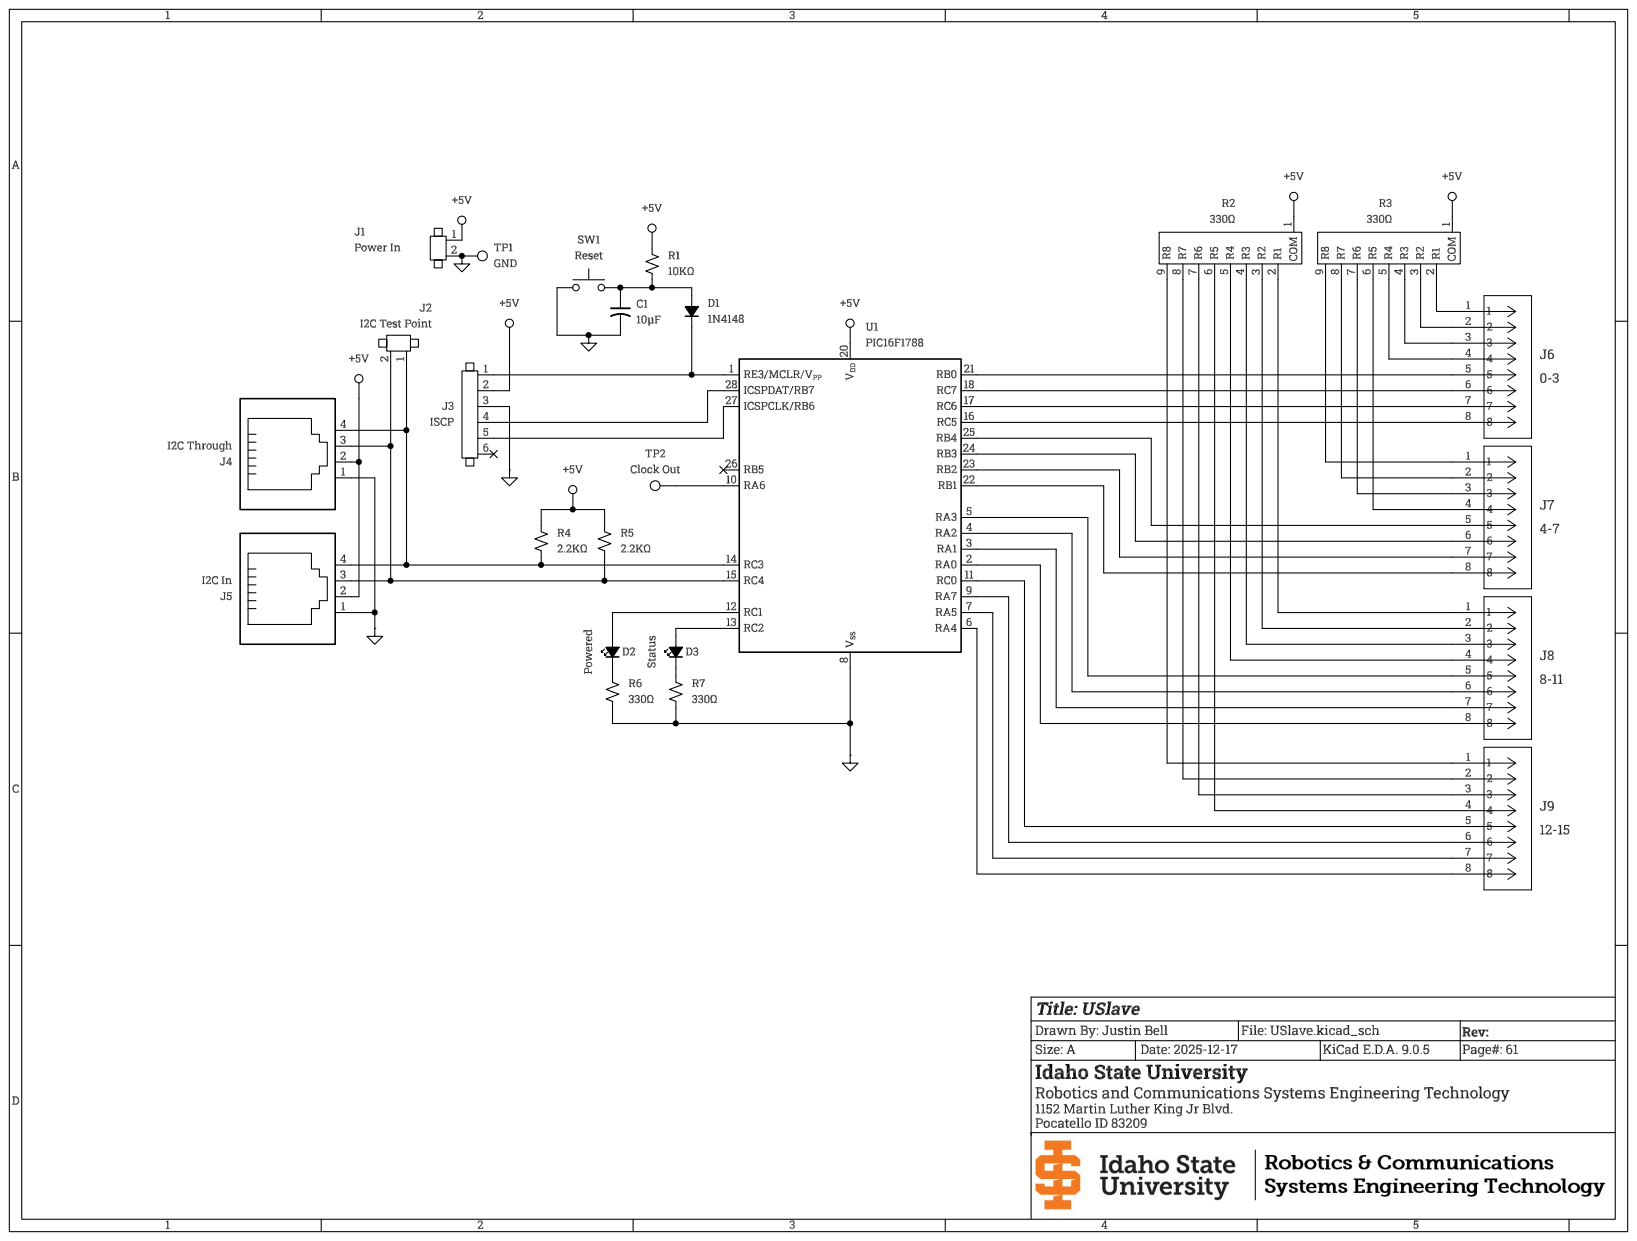
[picture p105: page 1]
