slacshan/MIDI-Projects/Universals/SolenoidRelay/PDFs/UniversalSolenoidRelaySchematicRevA.pdf

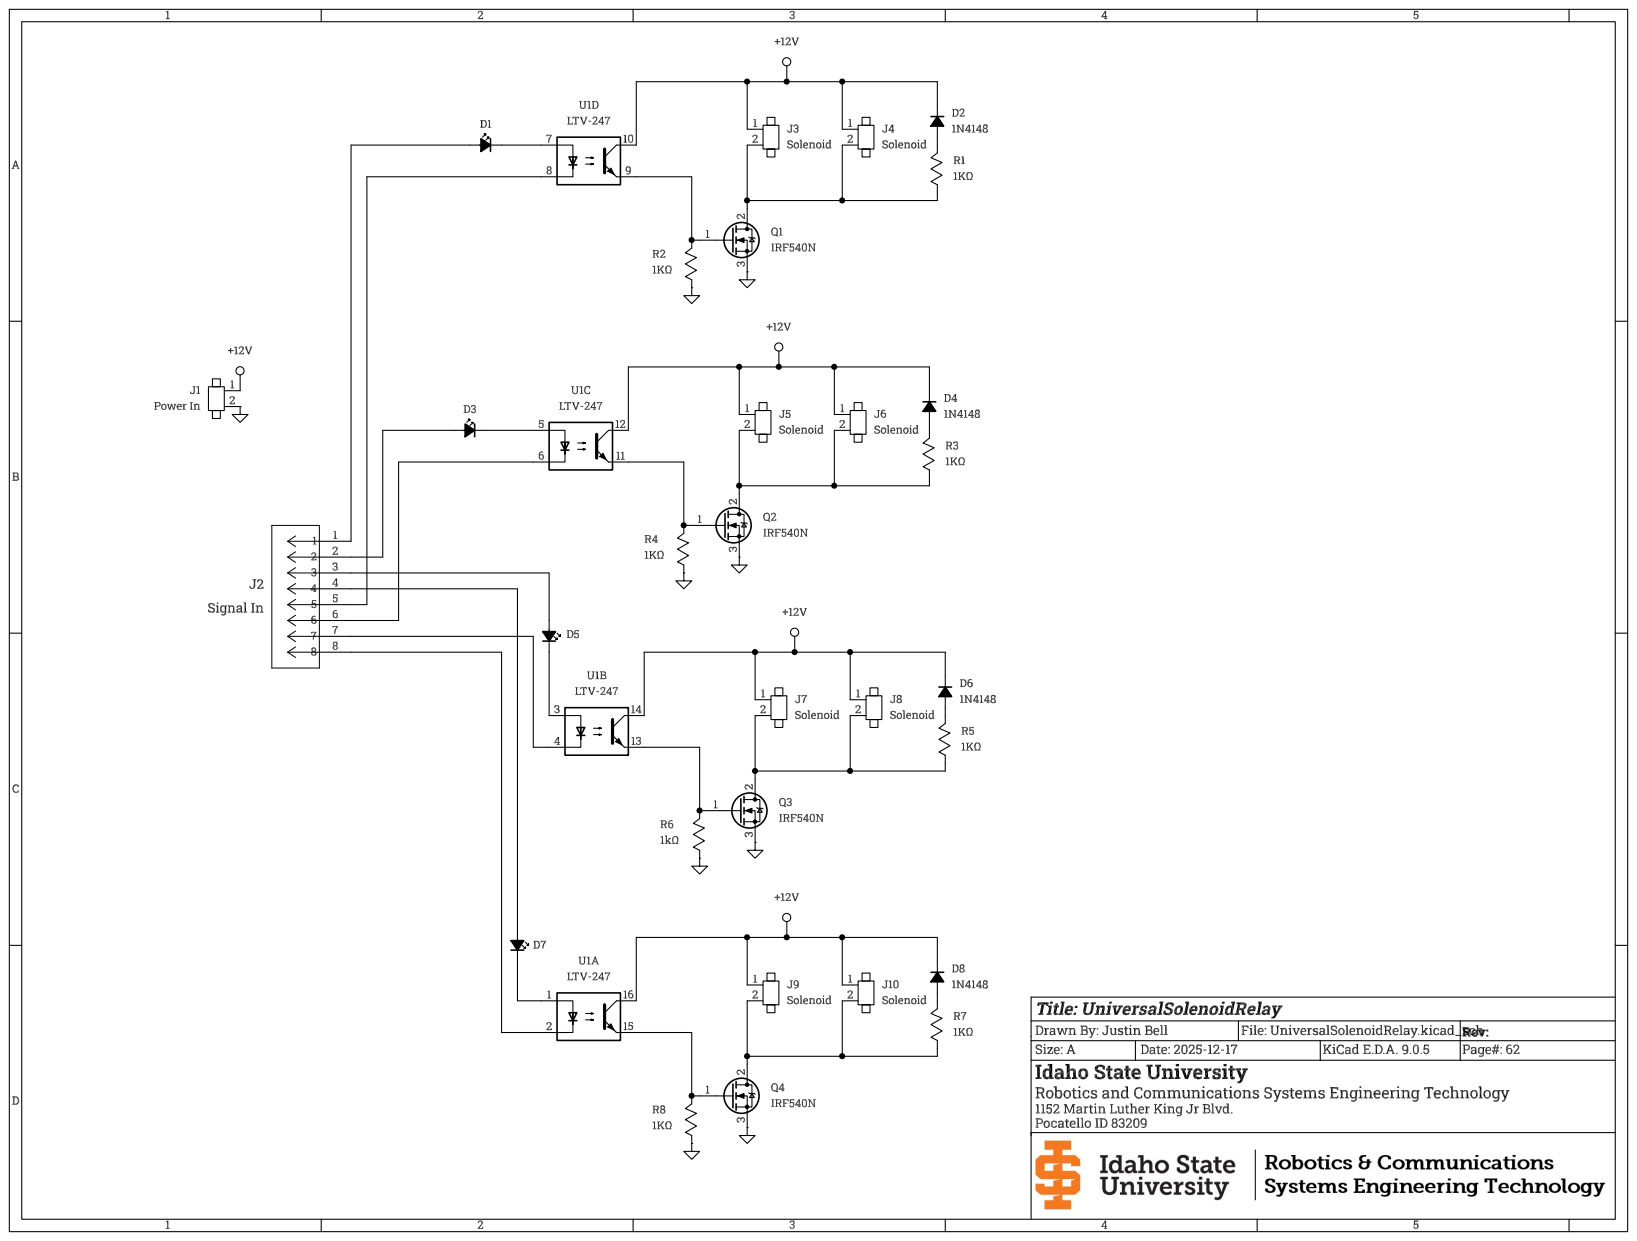
[picture p106: page 1]
