slacshan/MIDI-Projects/Infrared/Tx/PDFs/IR_MIDI_Tx_PCBBack_RevA.pdf

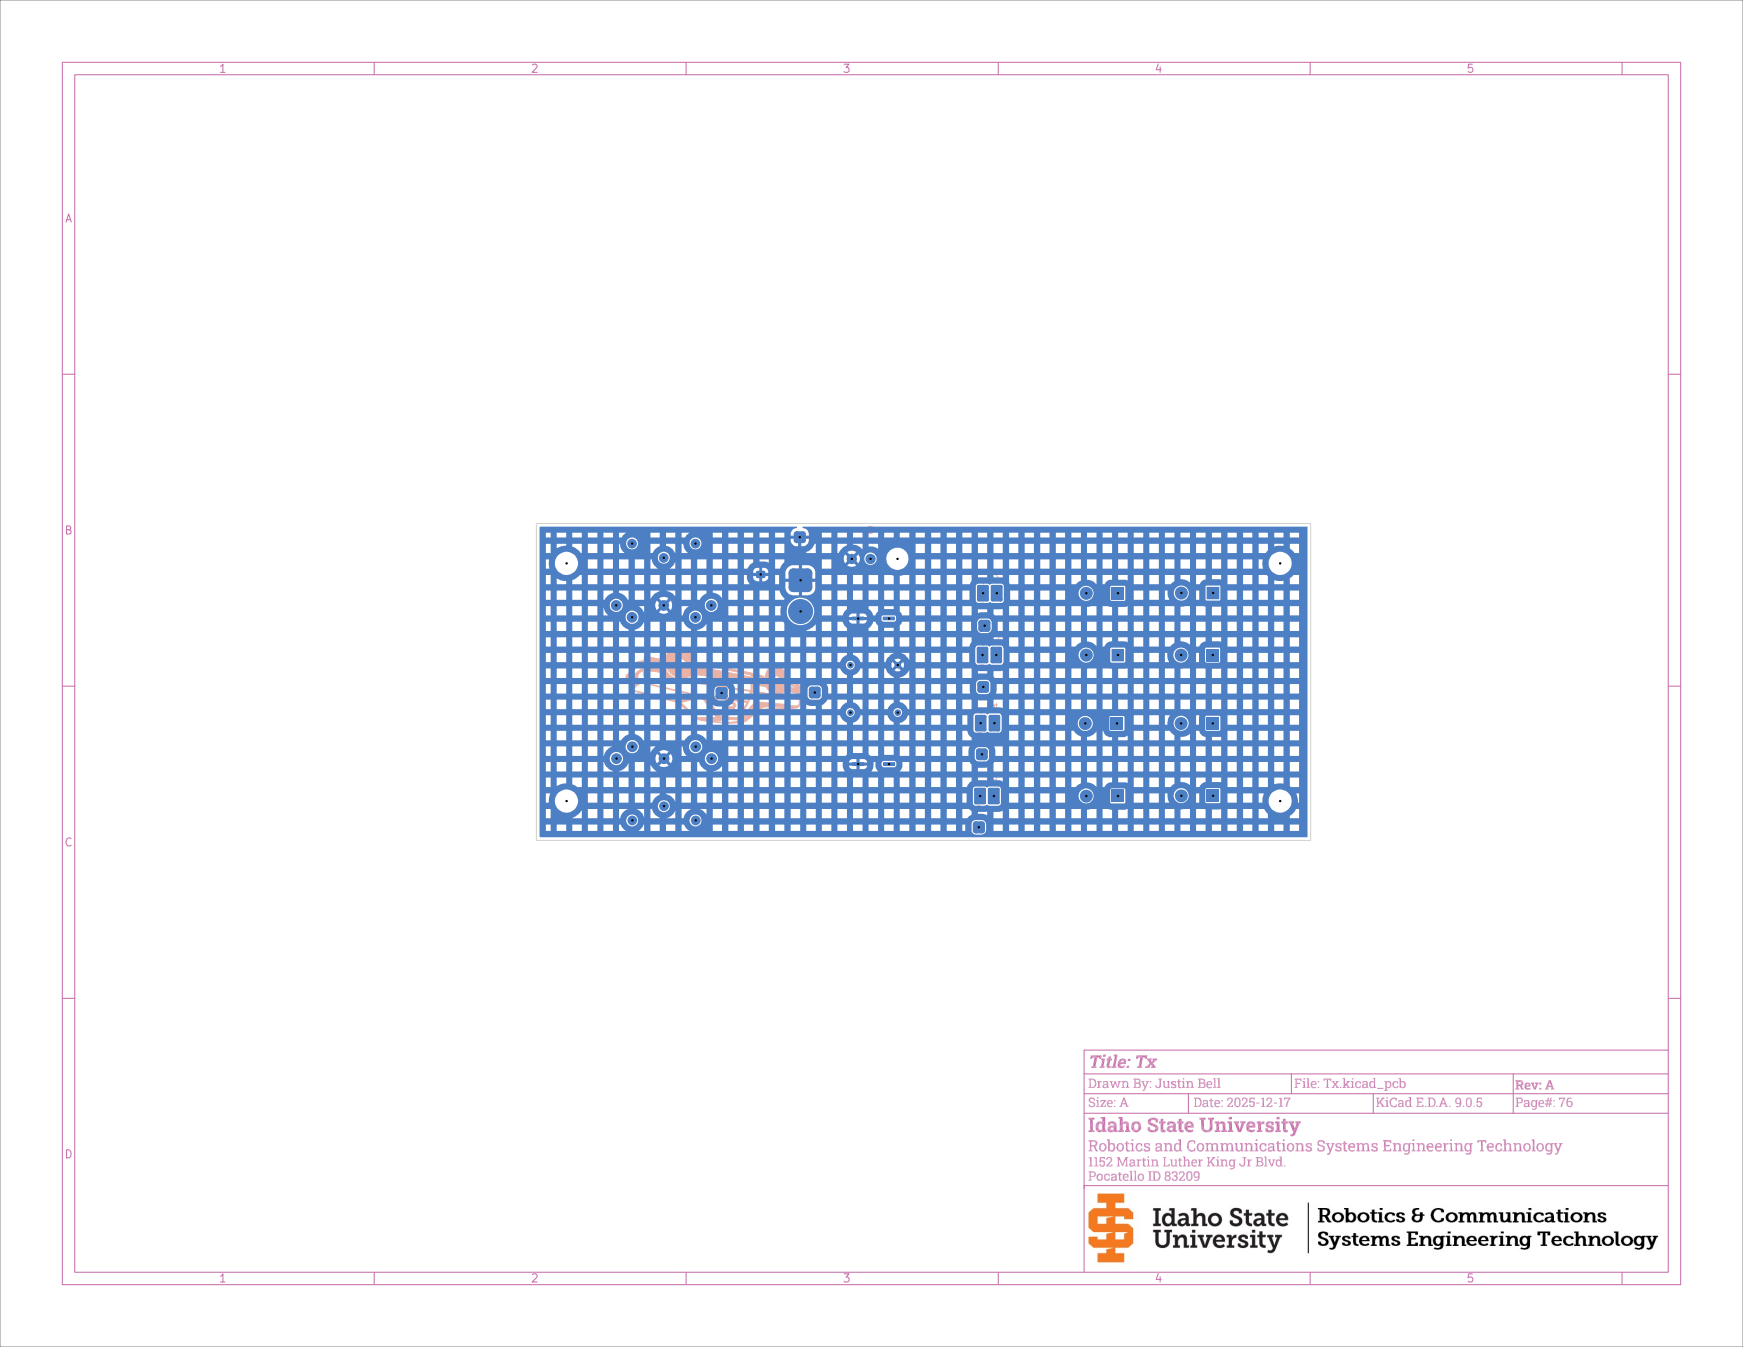
[picture p107: page 1]
