slacshan/MIDI-Projects/Infrared/Tx/PDFs/IR_MIDI_Tx_PCBDimensions_RevA.pdf

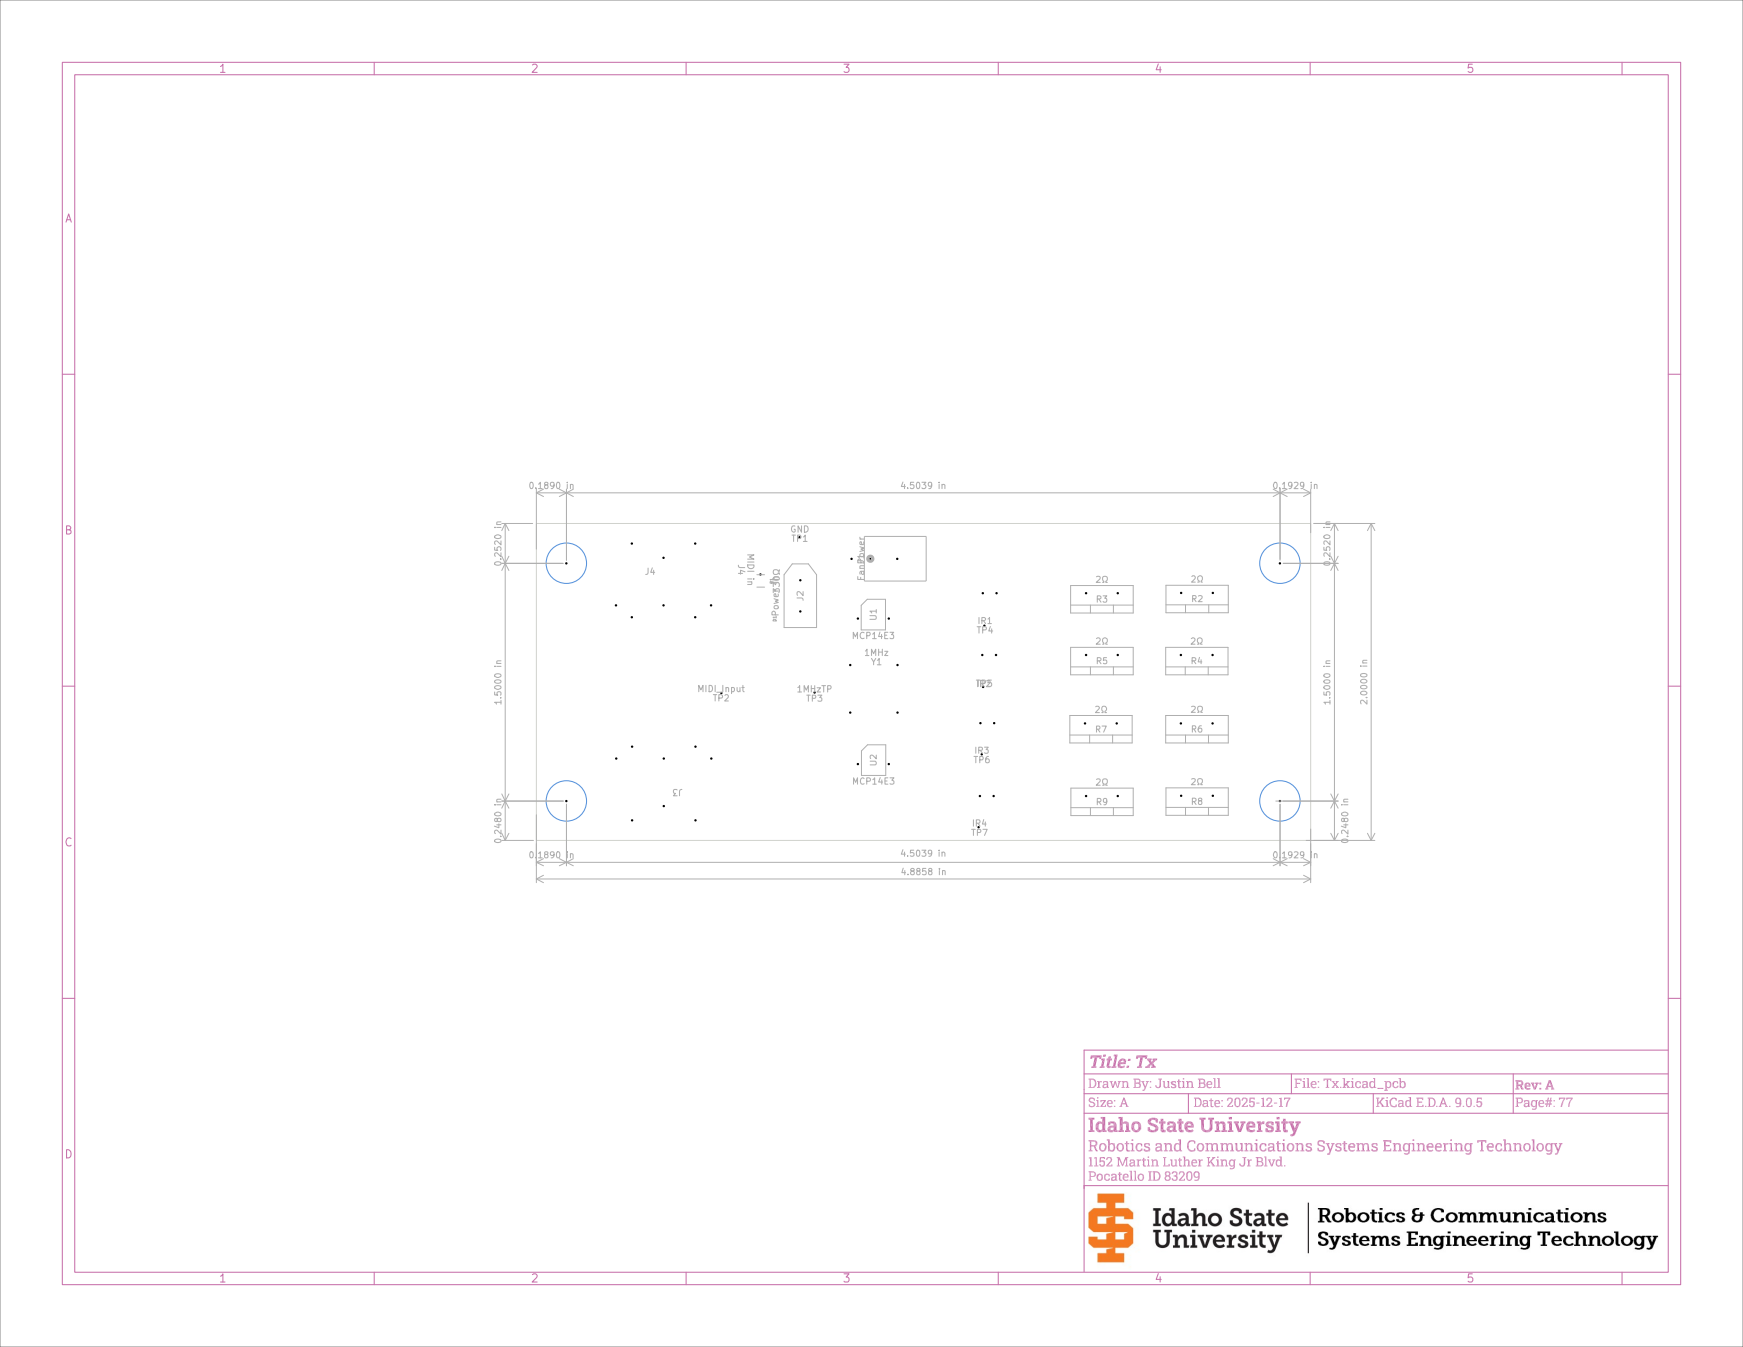
[picture p108: page 1]
