slacshan/MIDI-Projects/Infrared/Tx/PDFs/IR_MIDI_Tx_PCBFront_RevA.pdf

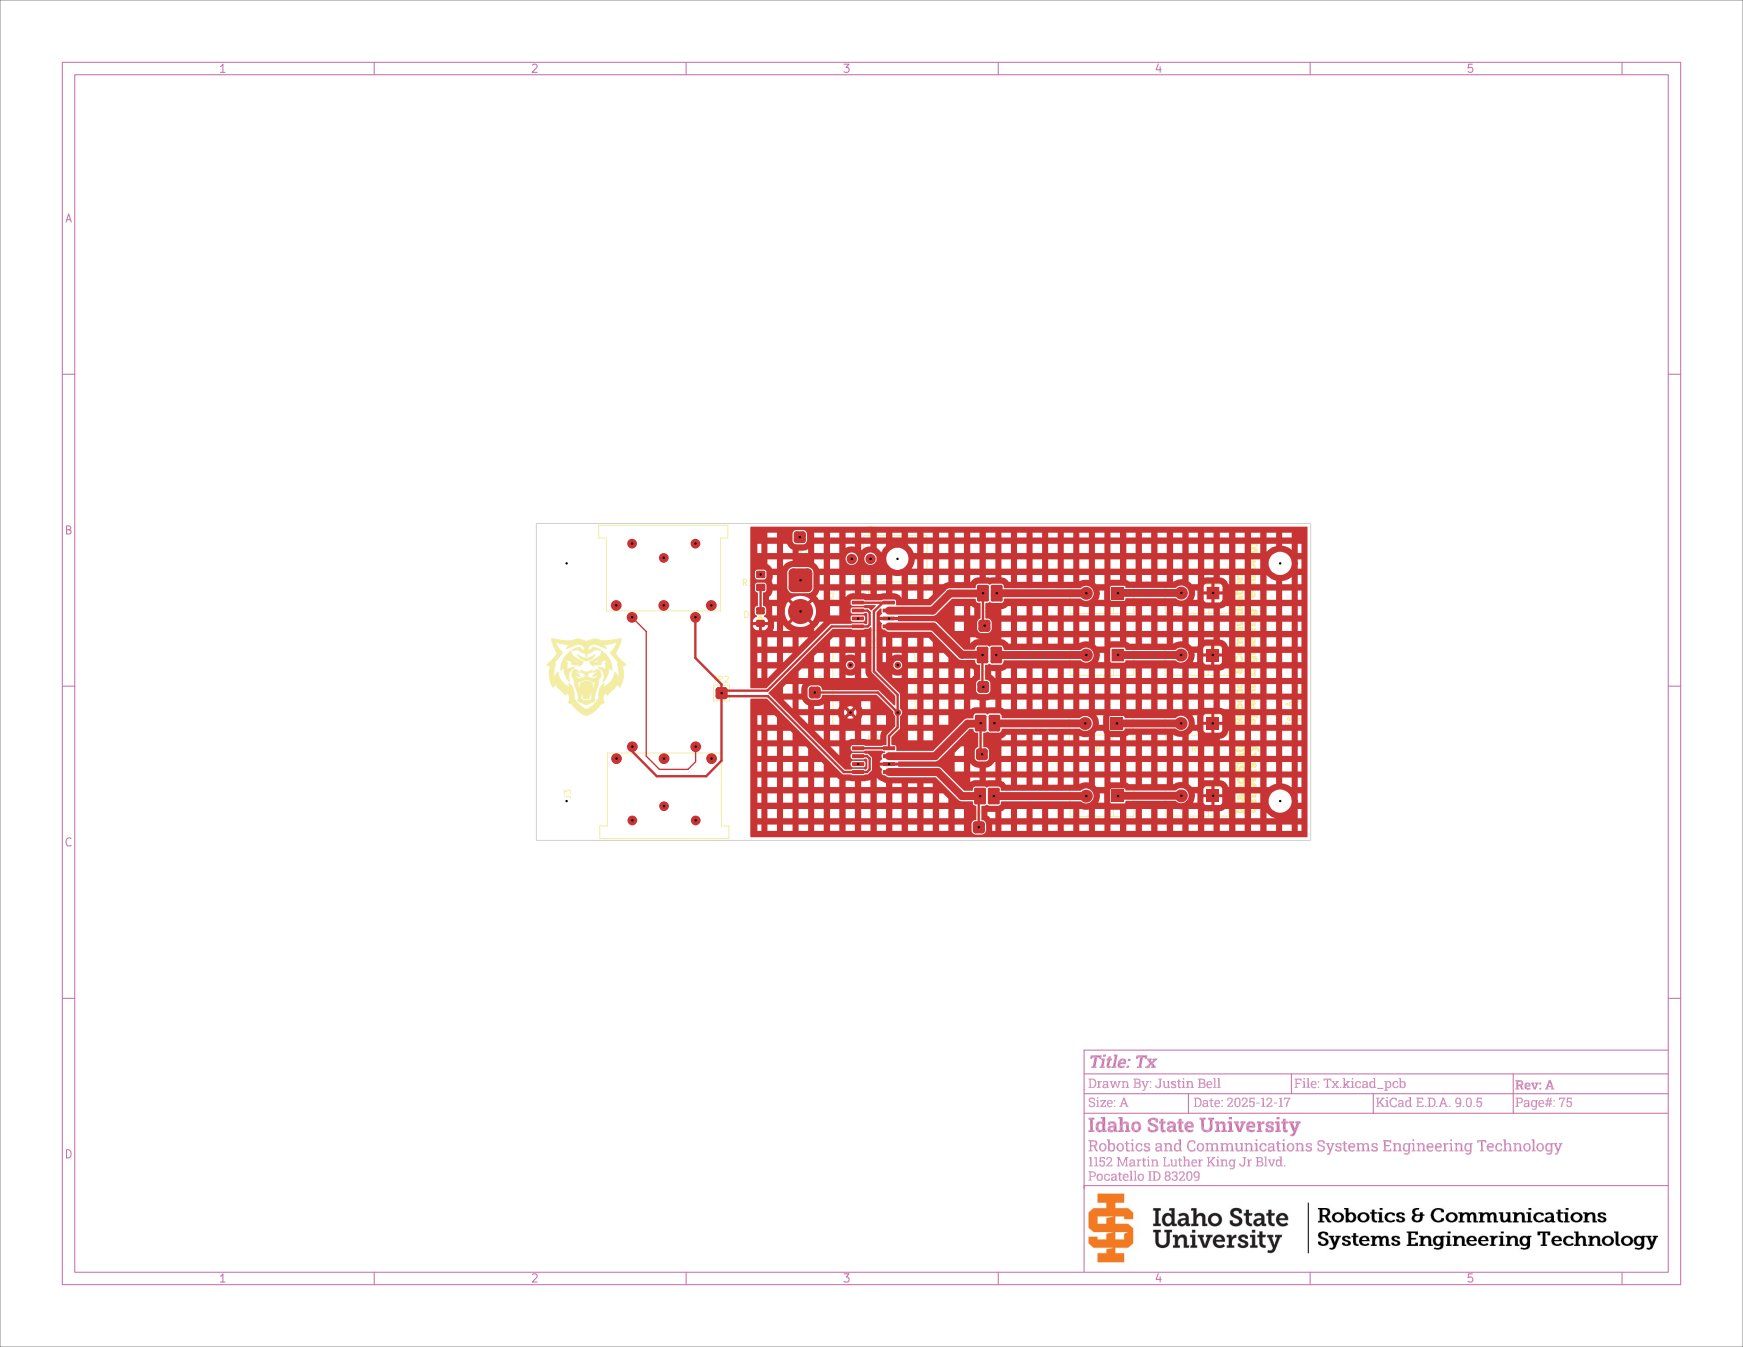
[picture p109: page 1]
