slacshan/MIDI-Projects/Universals/Master/PDFs/UniversalMasterPCBBackRevA.pdf

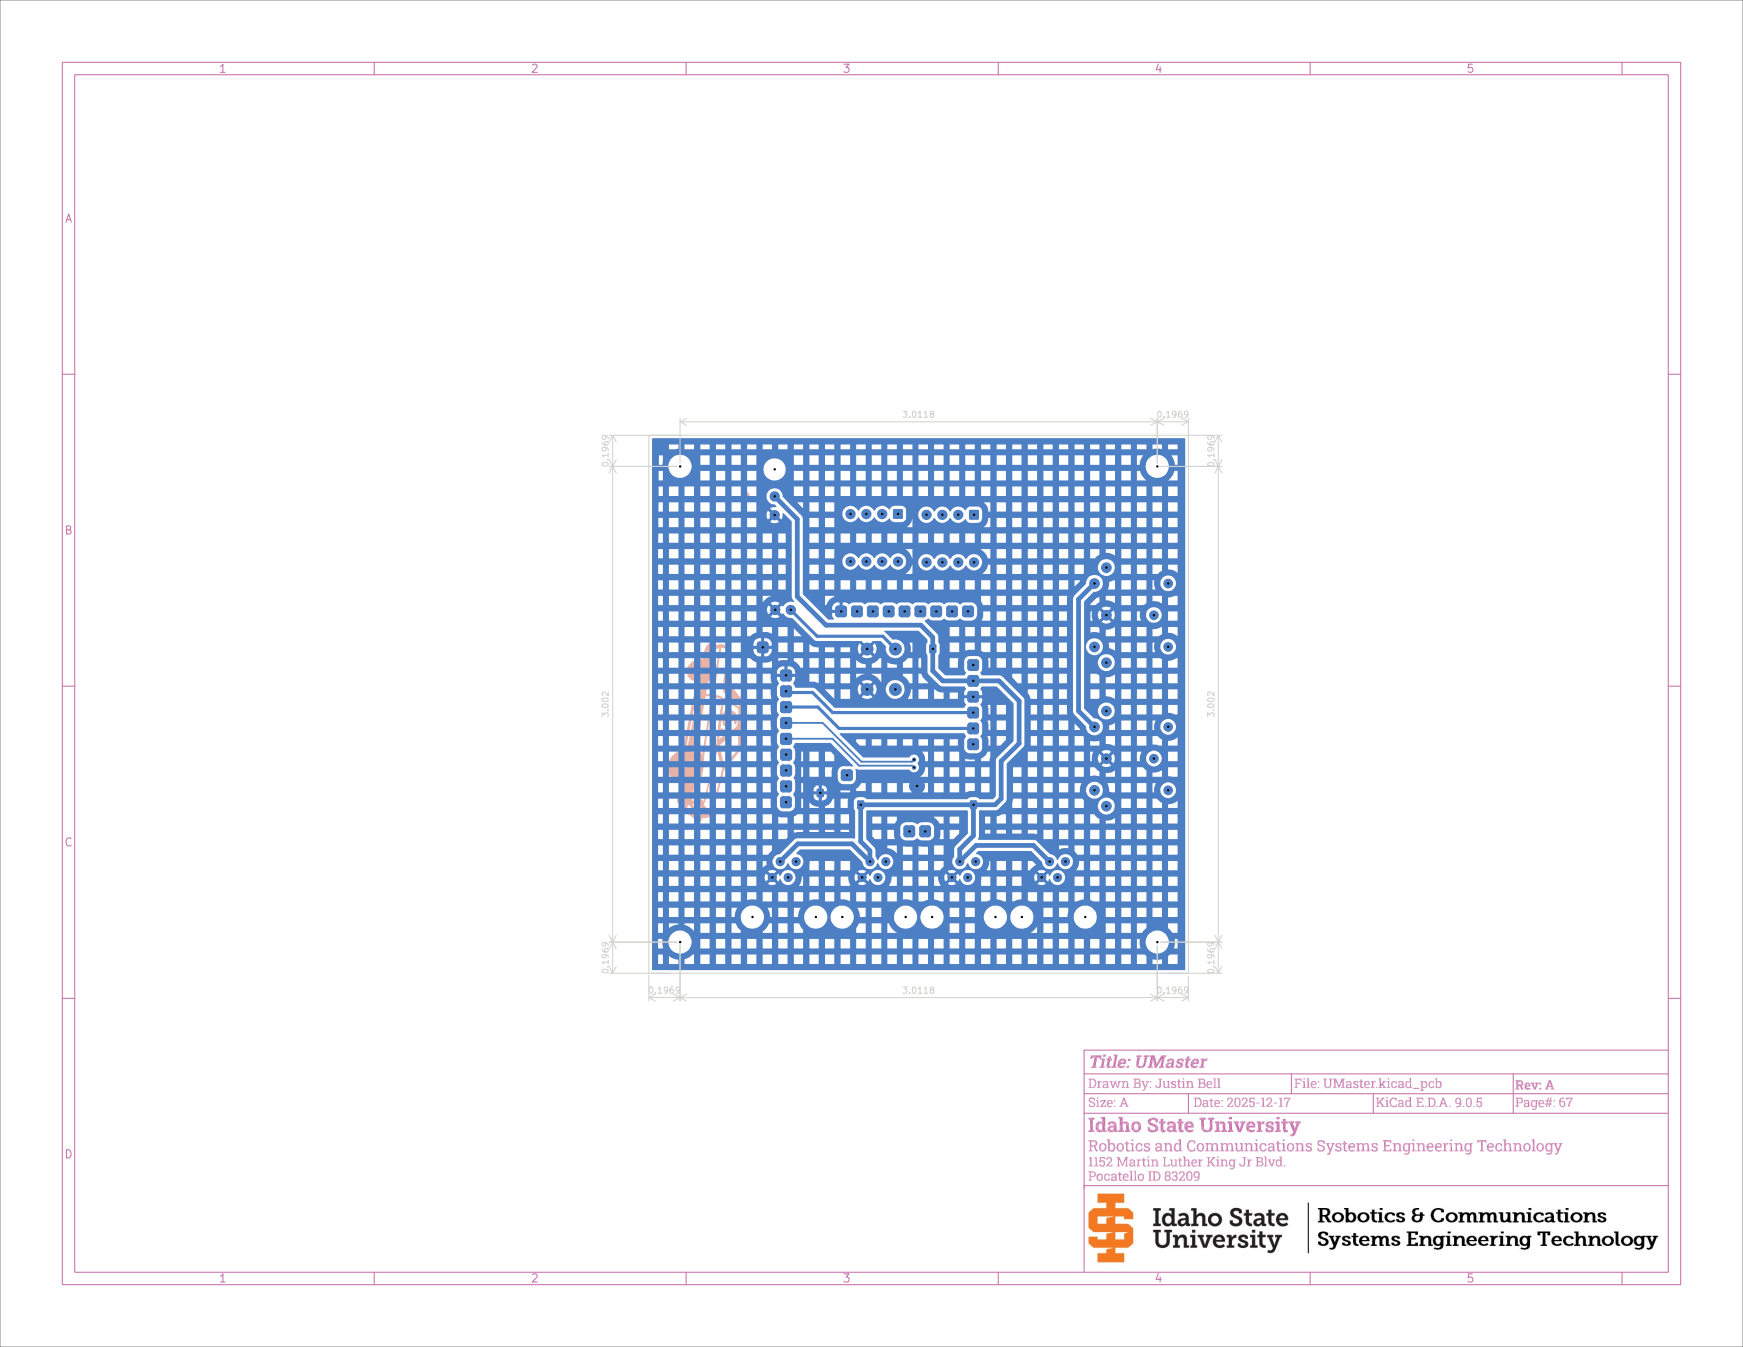
[picture p110: page 1]
