slacshan/MIDI-Projects/Universals/Master/PDFs/UniversalMasterPCBDimentionsRevA.pdf

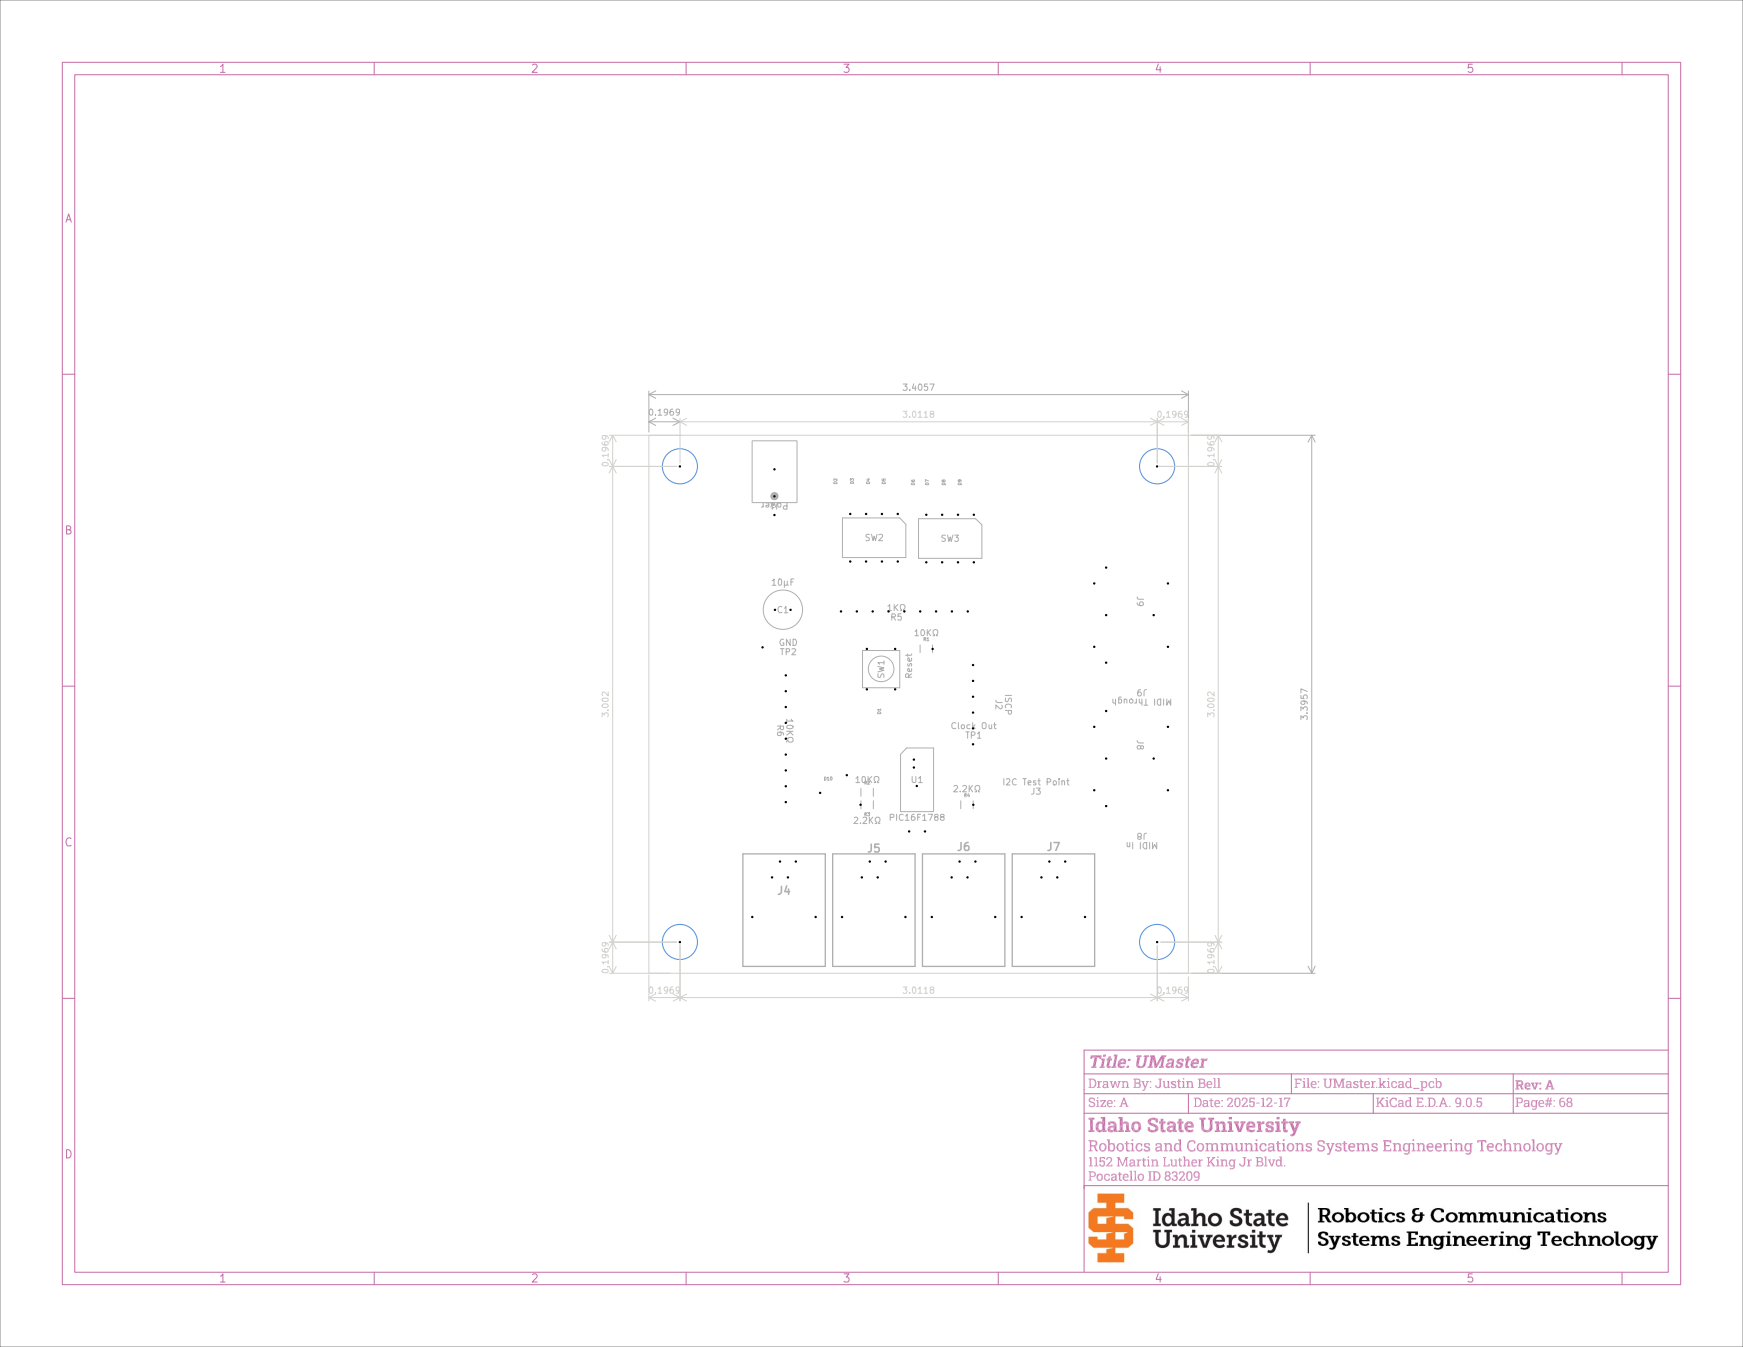
[picture p111: page 1]
