slacshan/MIDI-Projects/Universals/Master/PDFs/UniversalMasterPCBFrontRevA.pdf

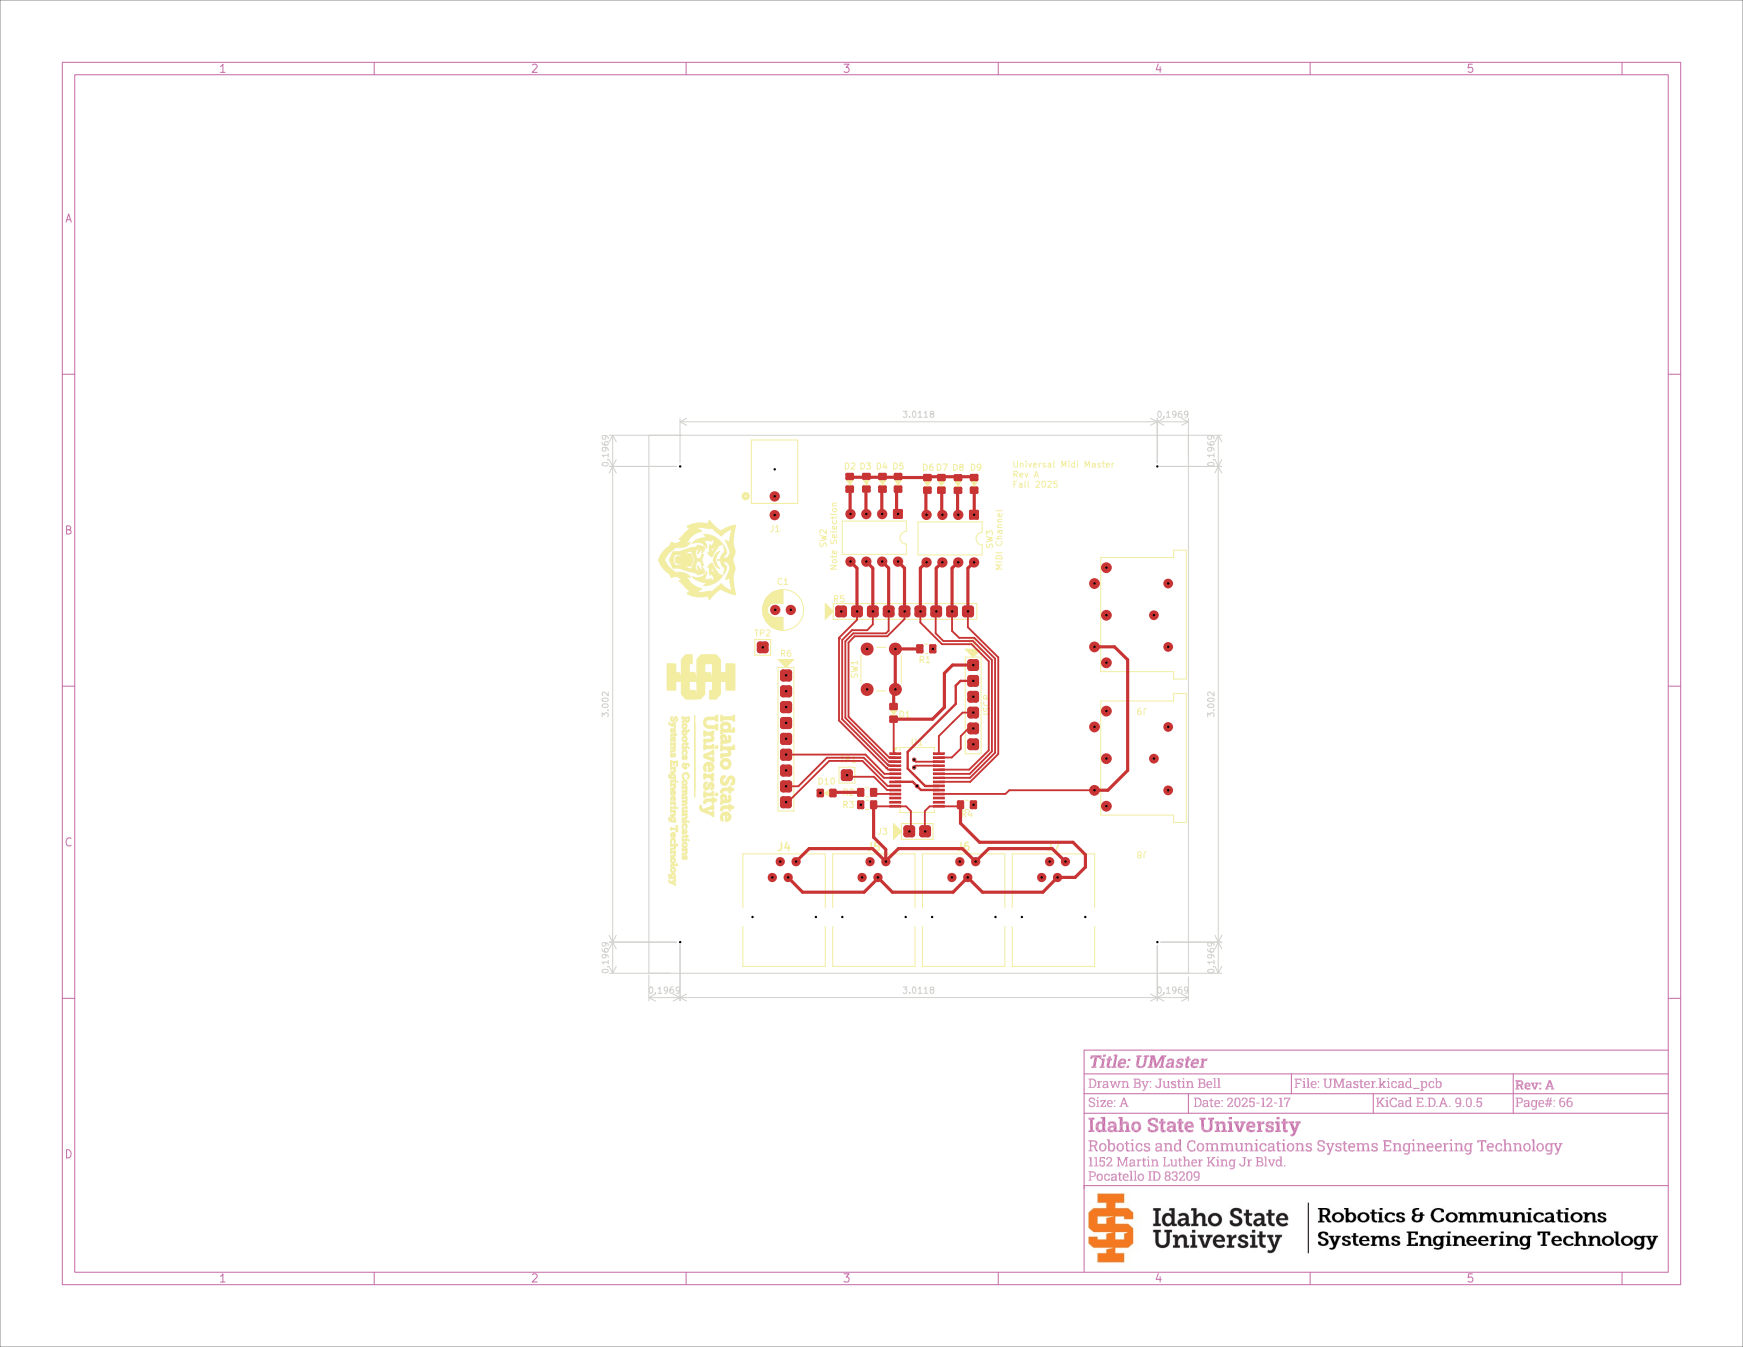
[picture p112: page 1]
