slacshan/MIDI-Projects/Universals/Slave/PDFs/UniversalSlavePCBBackRevA.pdf

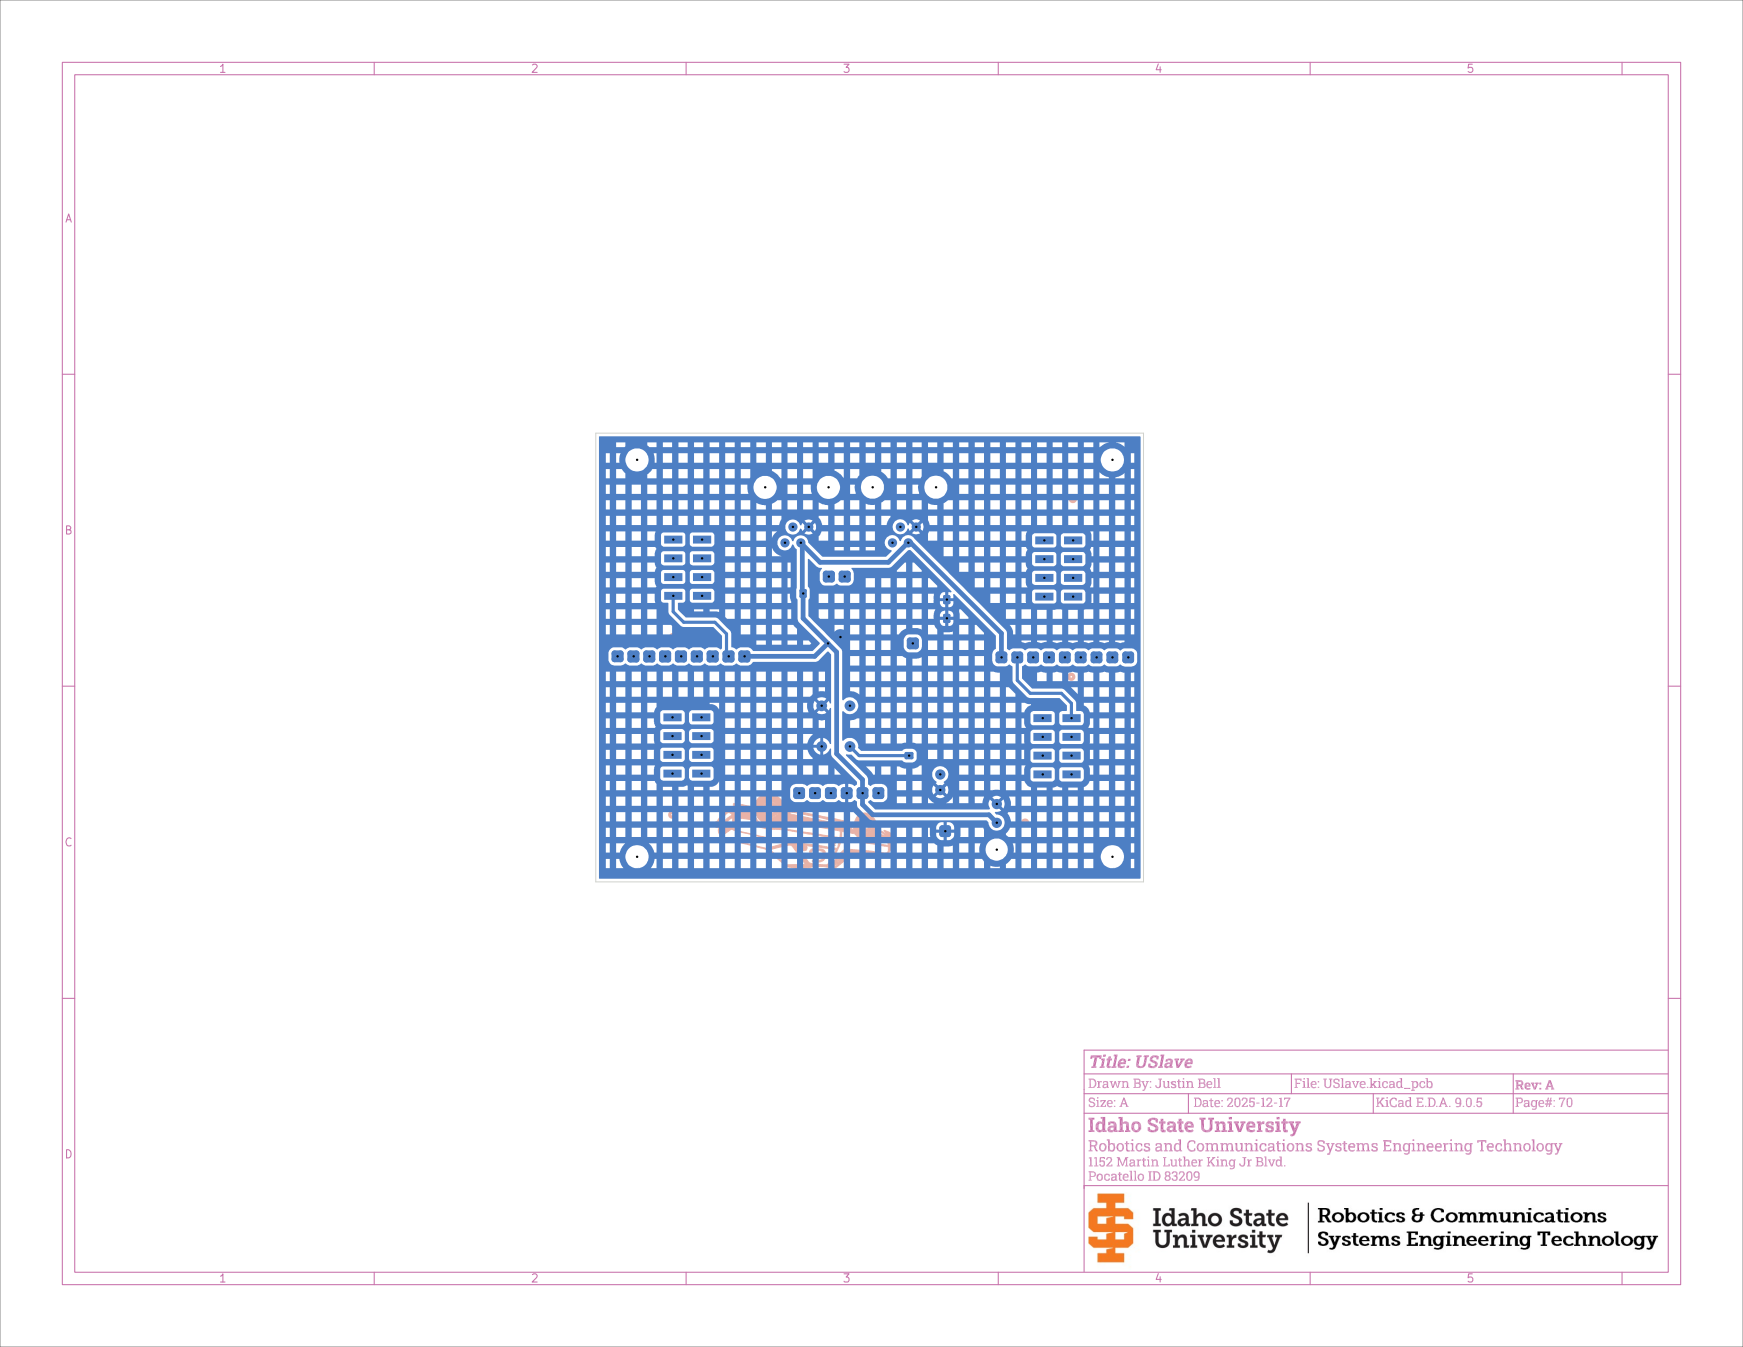
[picture p113: page 1]
