slacshan/MIDI-Projects/Universals/Slave/PDFs/UniversalSlavePCBDimensionsRevA.pdf

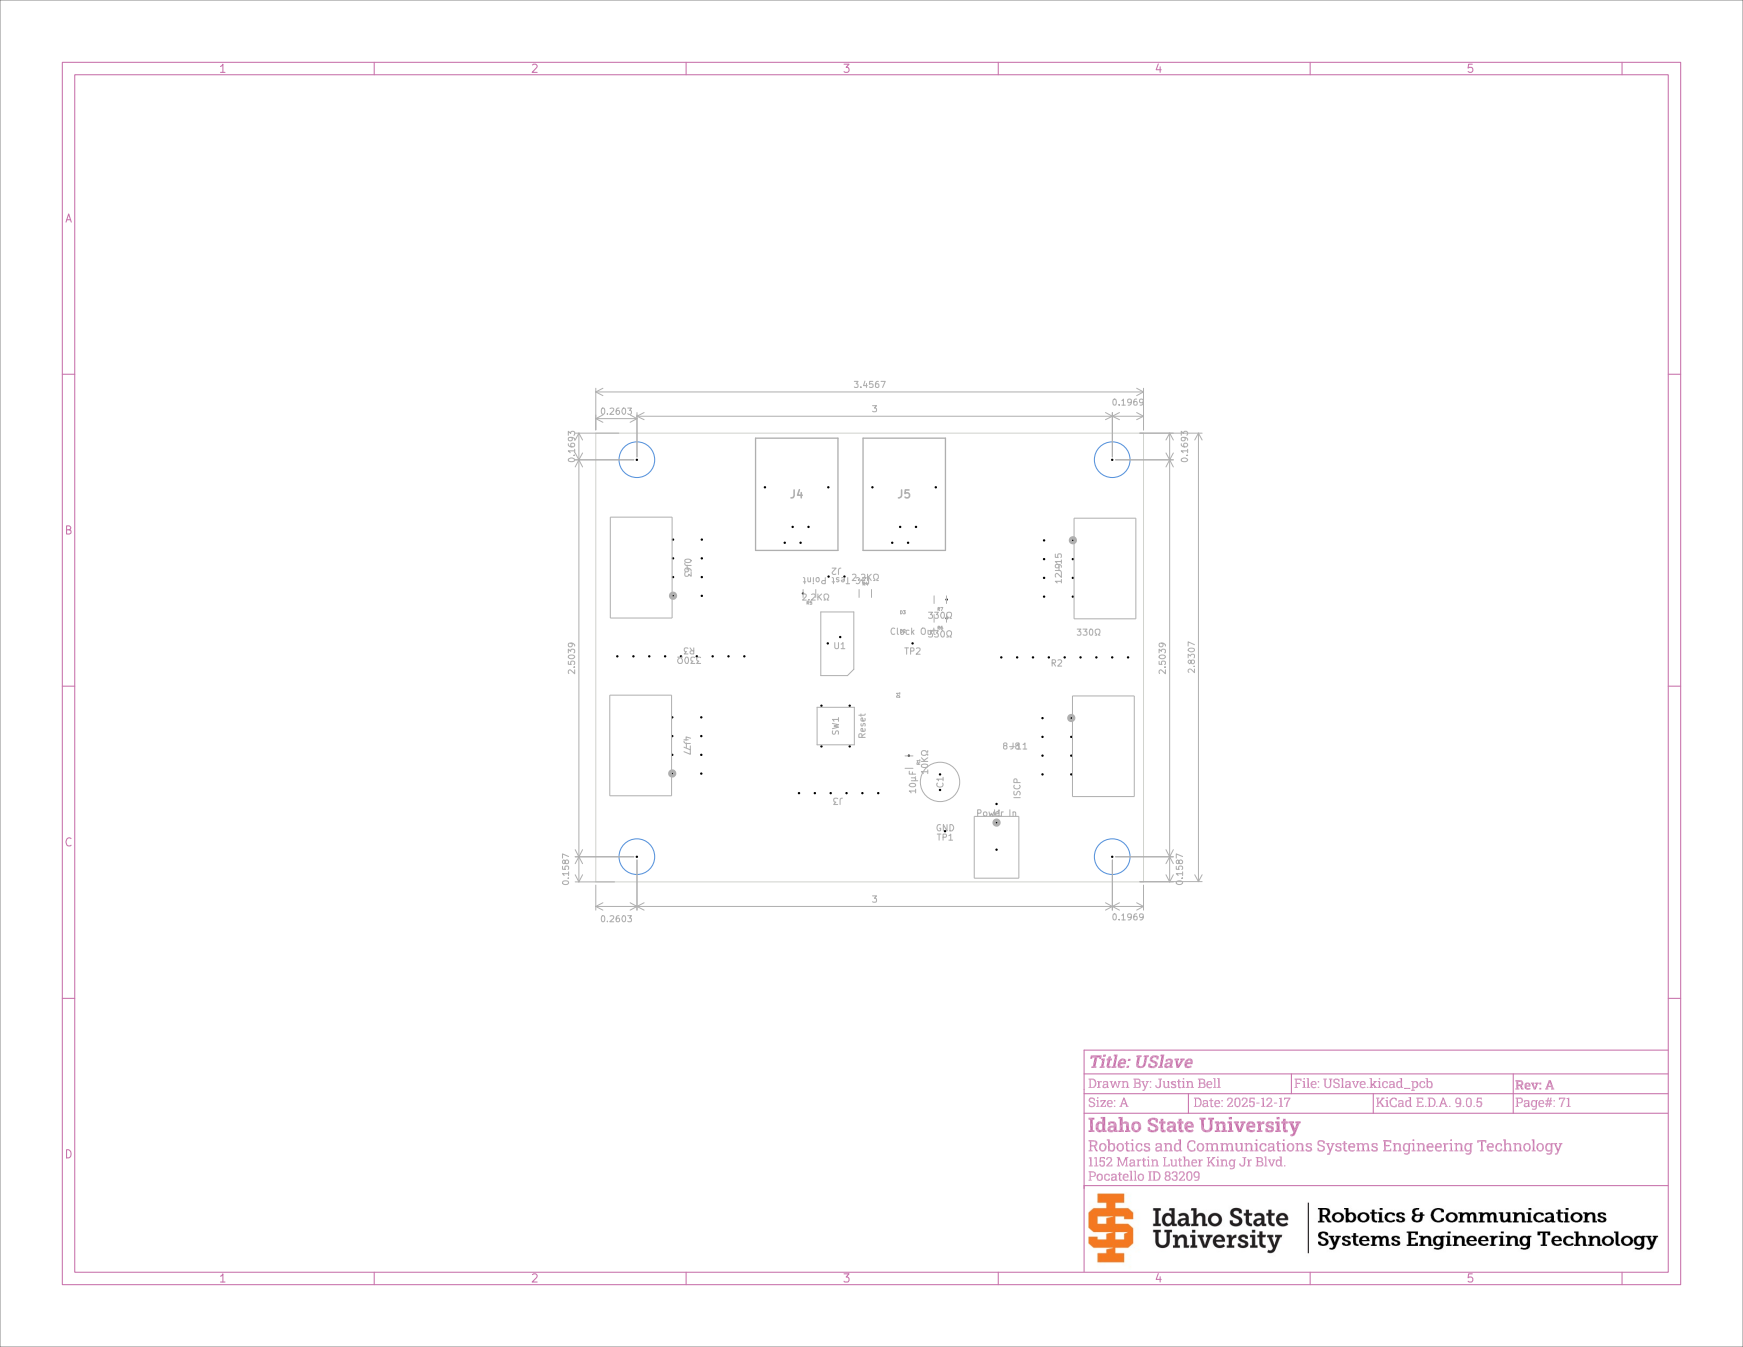
[picture p114: page 1]
