slacshan/MIDI-Projects/Universals/Slave/PDFs/UniversalSlavePCBFrontRevA.pdf

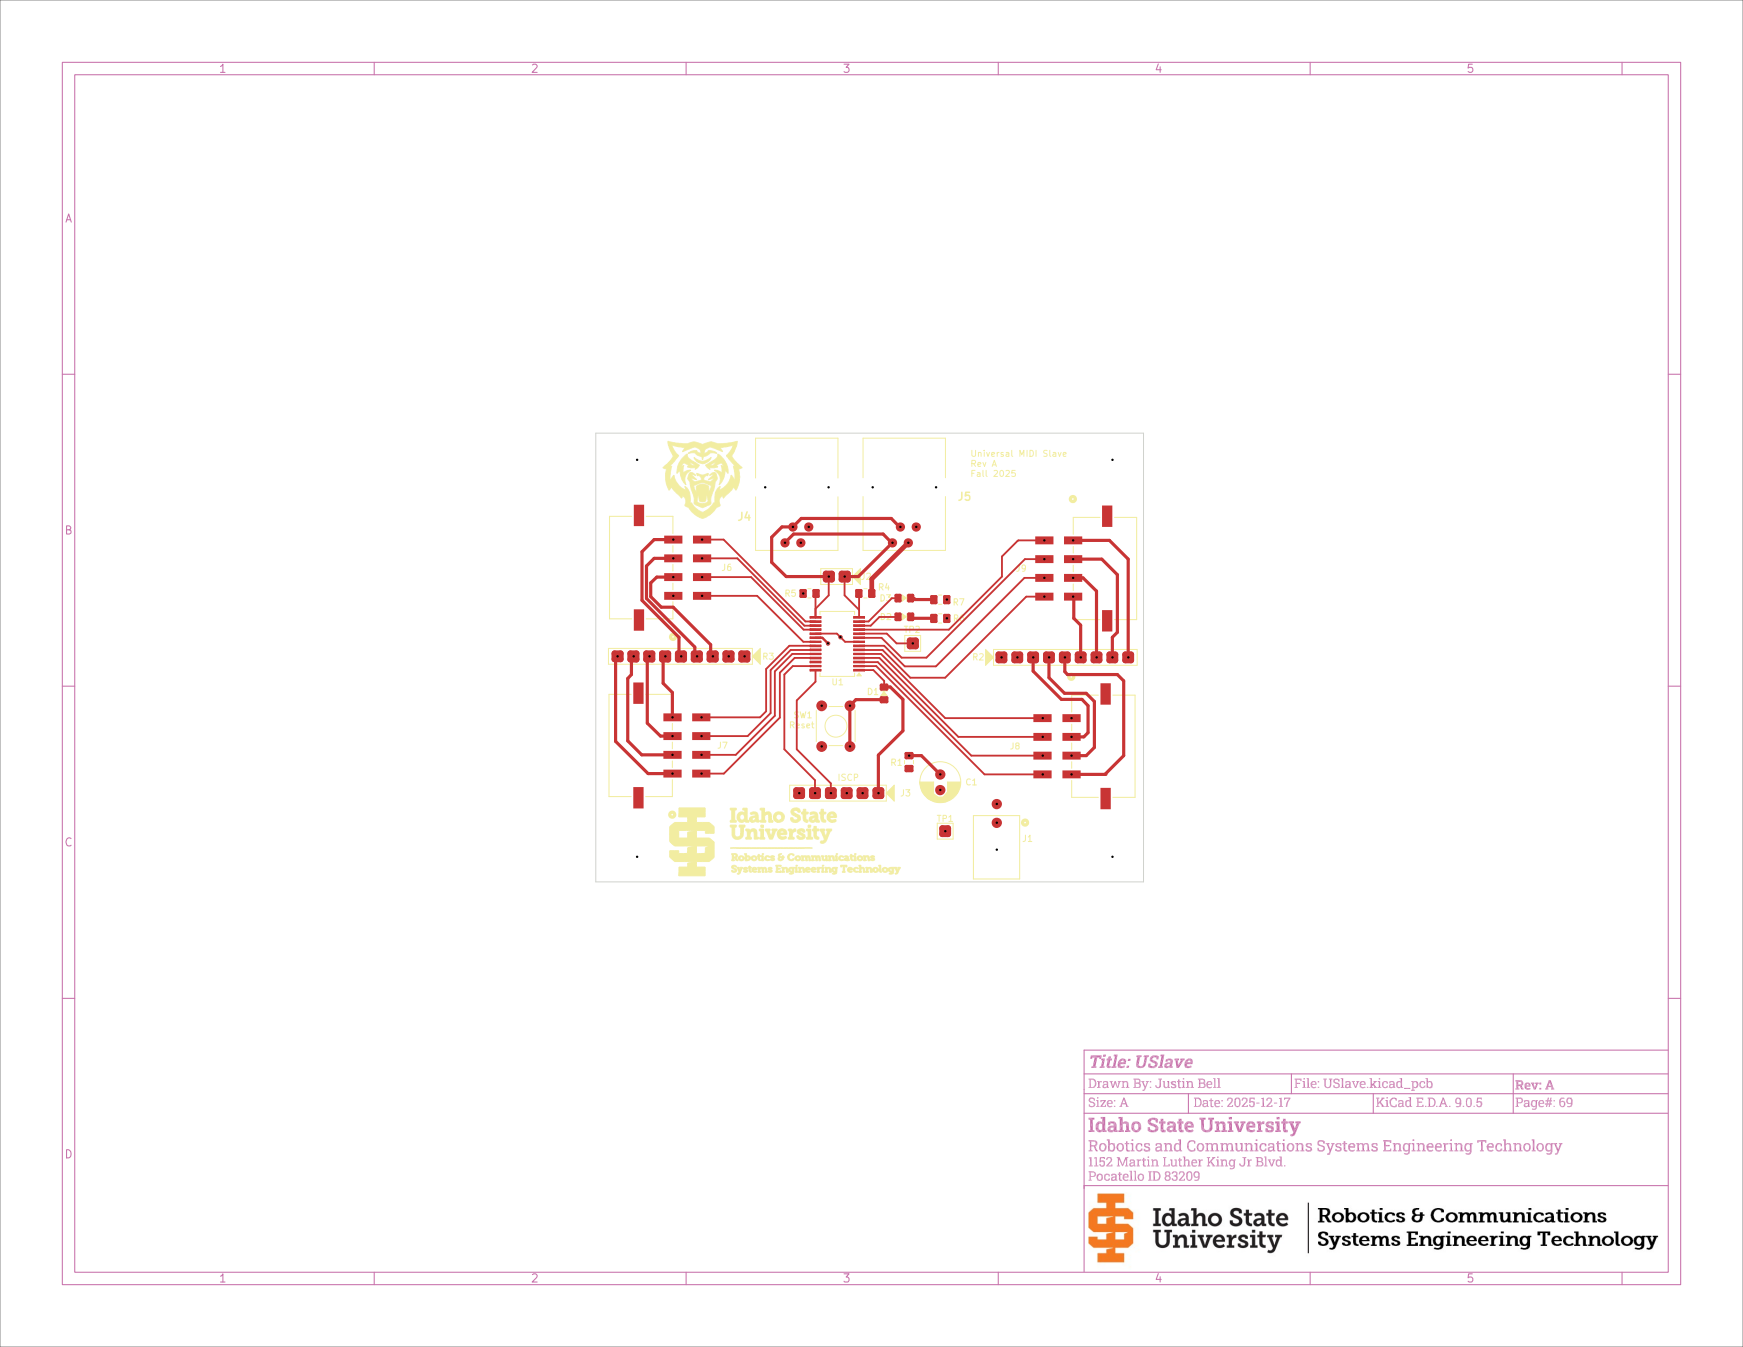
[picture p115: page 1]
