slacshan/MIDI-Projects/Universals/SolenoidRelay/PDFs/UniversalSolenoidRelayPCBBackRevA.pdf

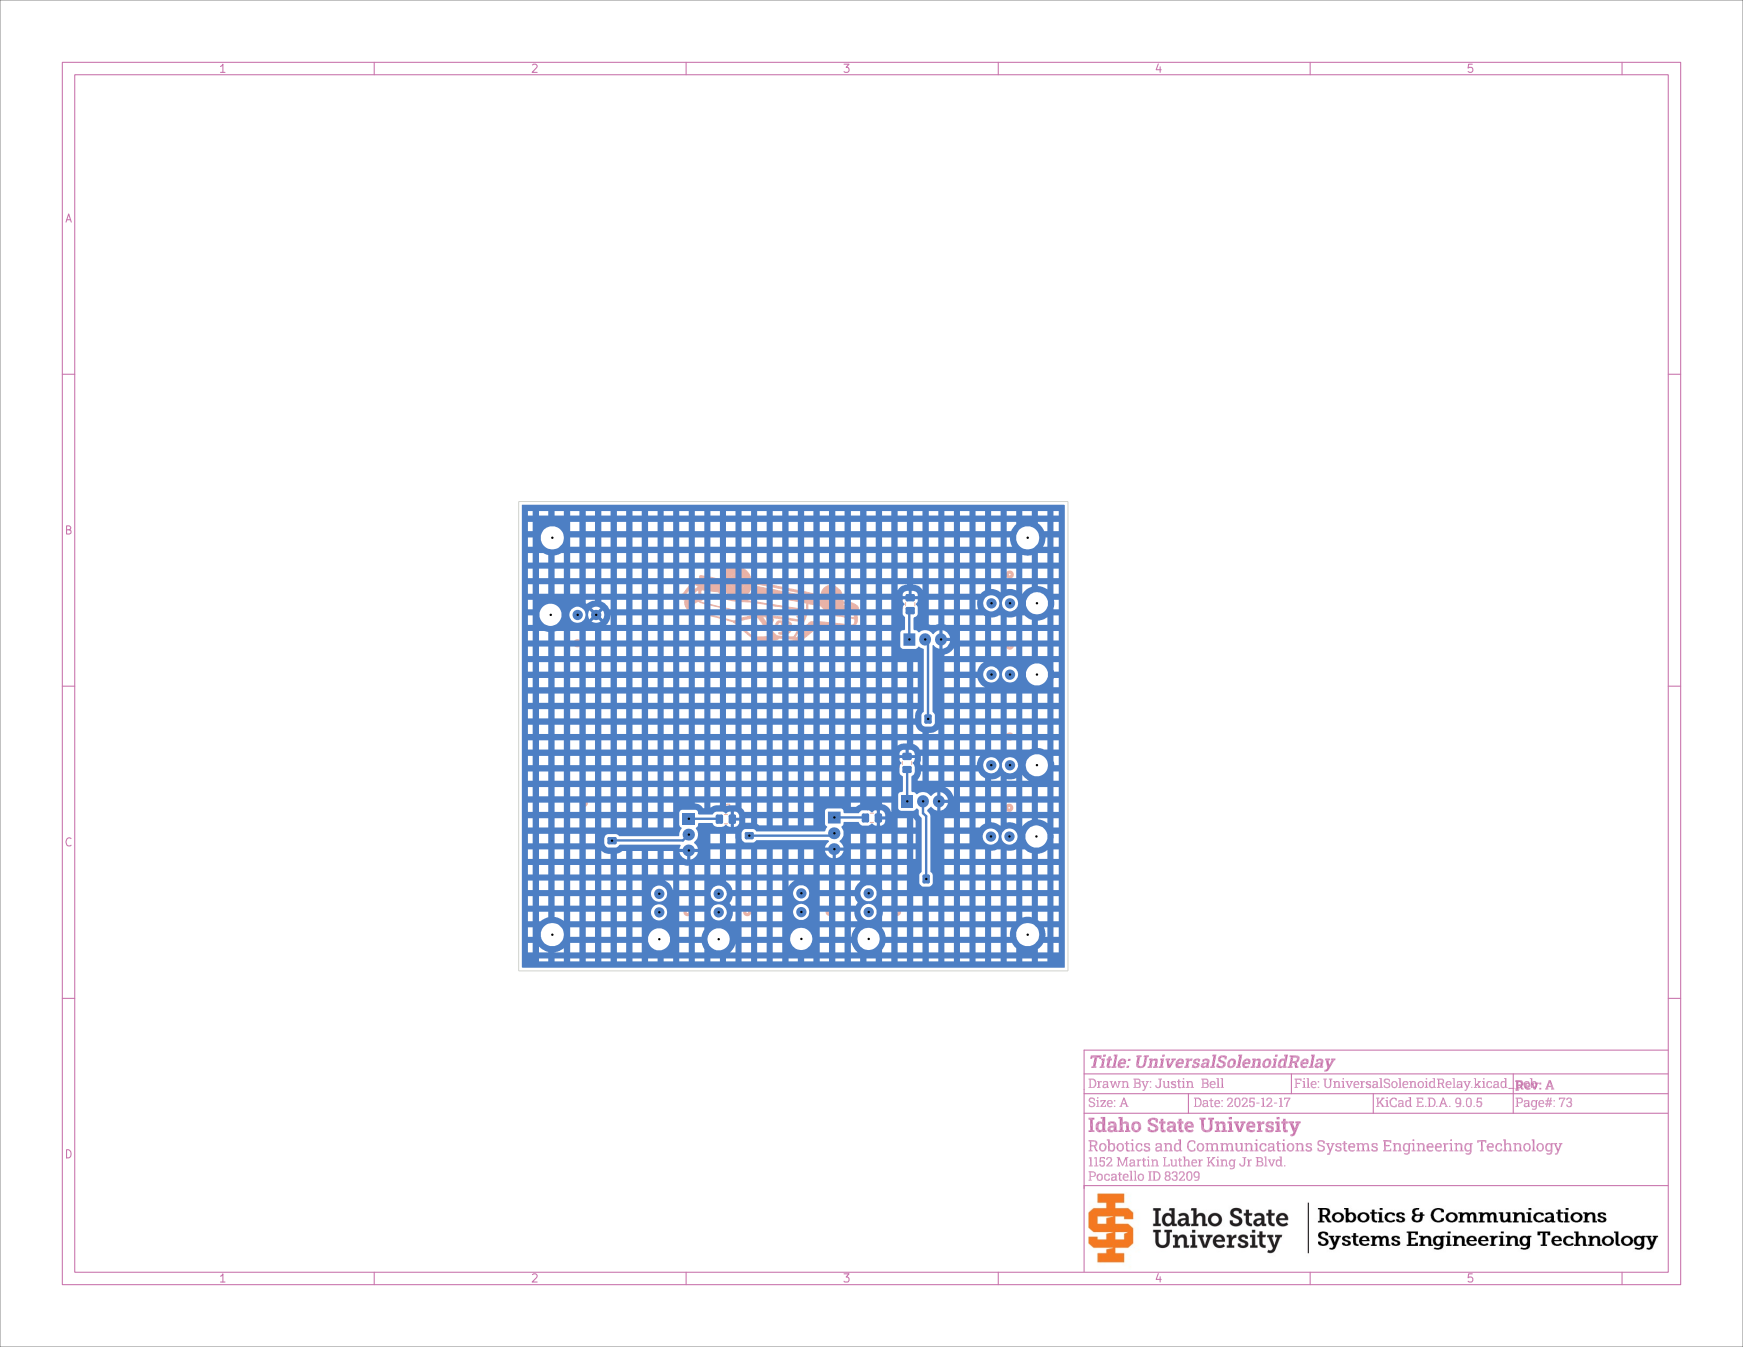
[picture p116: page 1]
