slacshan/MIDI-Projects/Universals/SolenoidRelay/PDFs/UniversalSolenoidRelayPCBDimensionsRevA.pdf

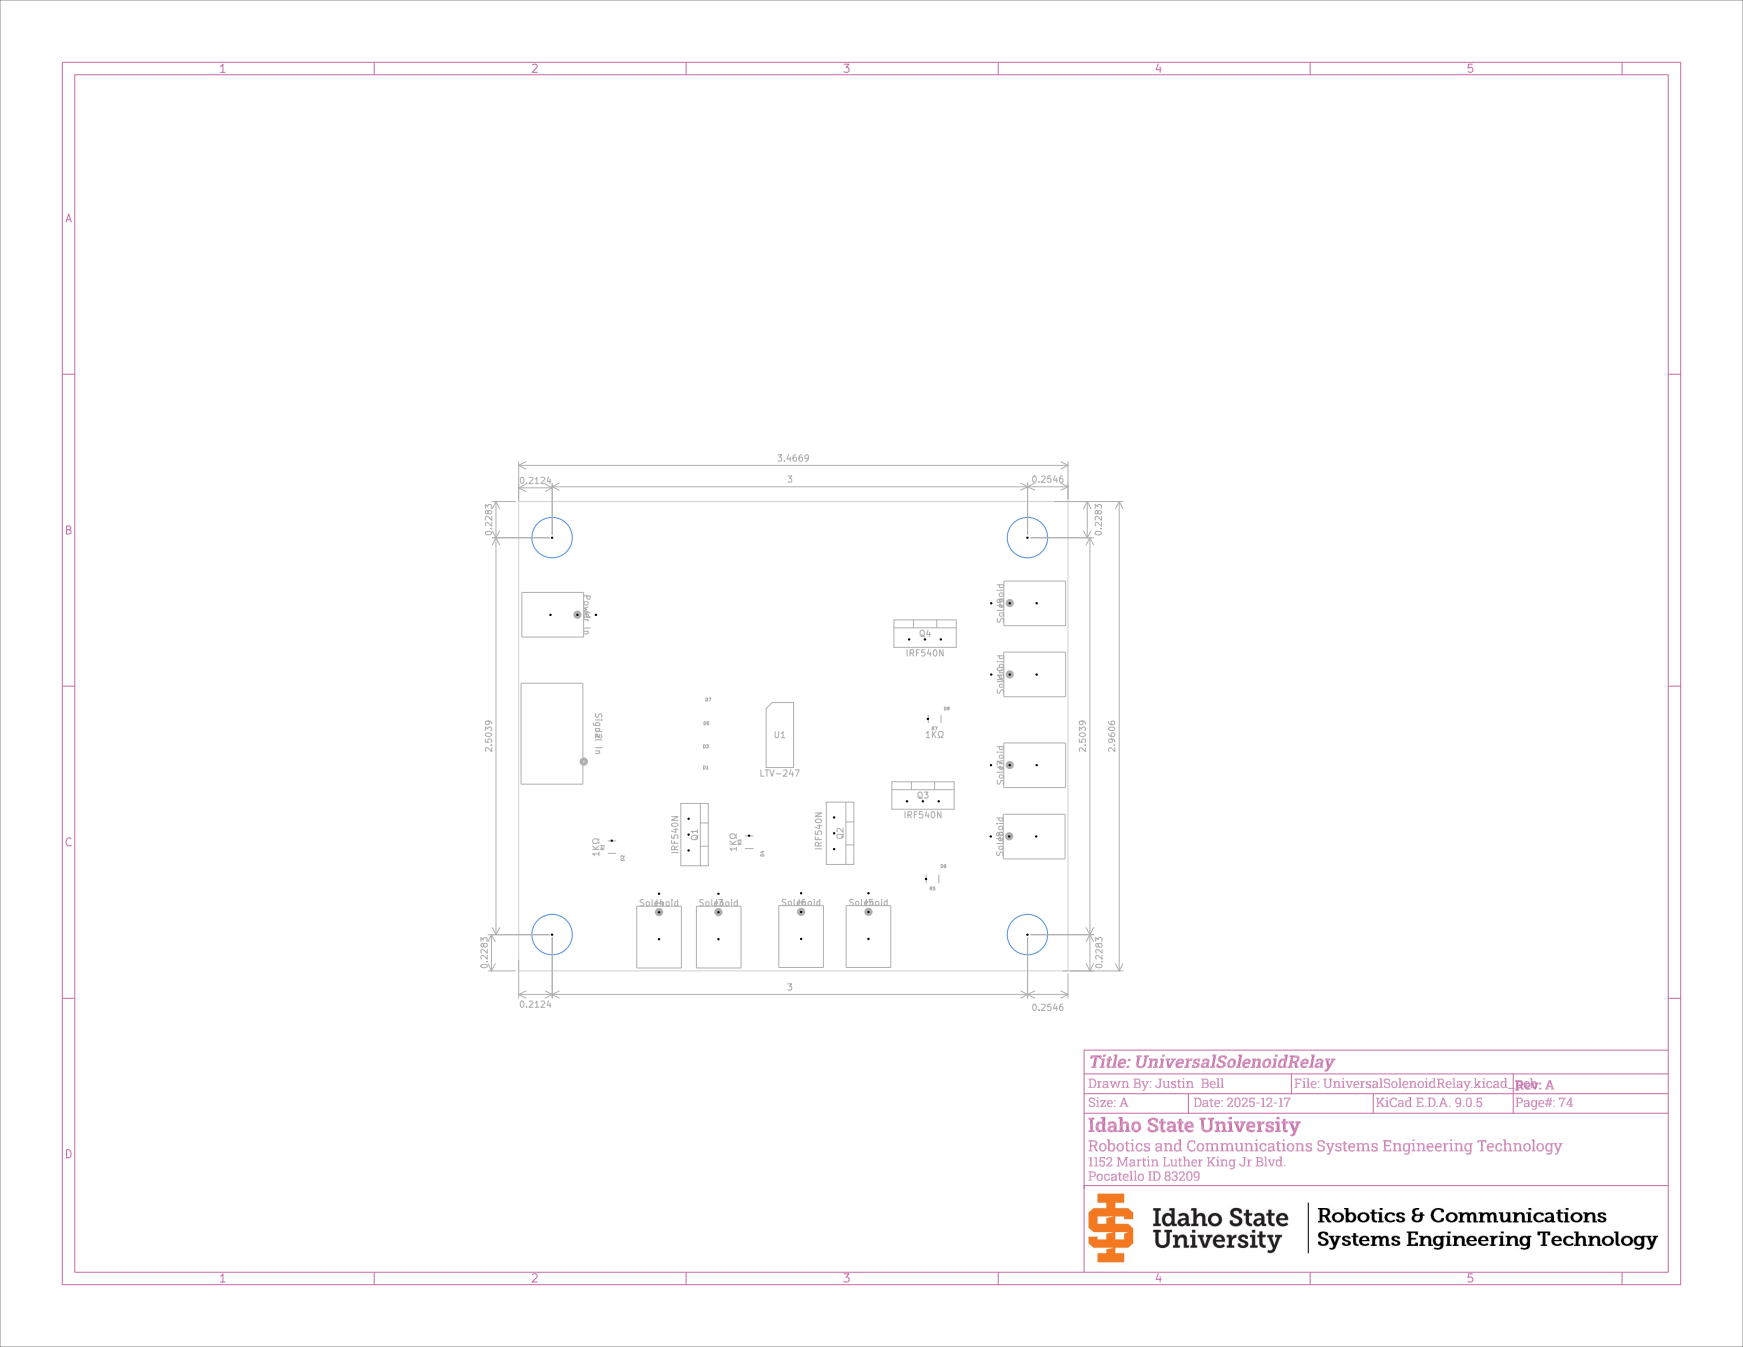
[picture p117: page 1]
