slacshan/MIDI-Projects/Universals/SolenoidRelay/PDFs/UniversalSolenoidRelayPCBFrontRevA.pdf

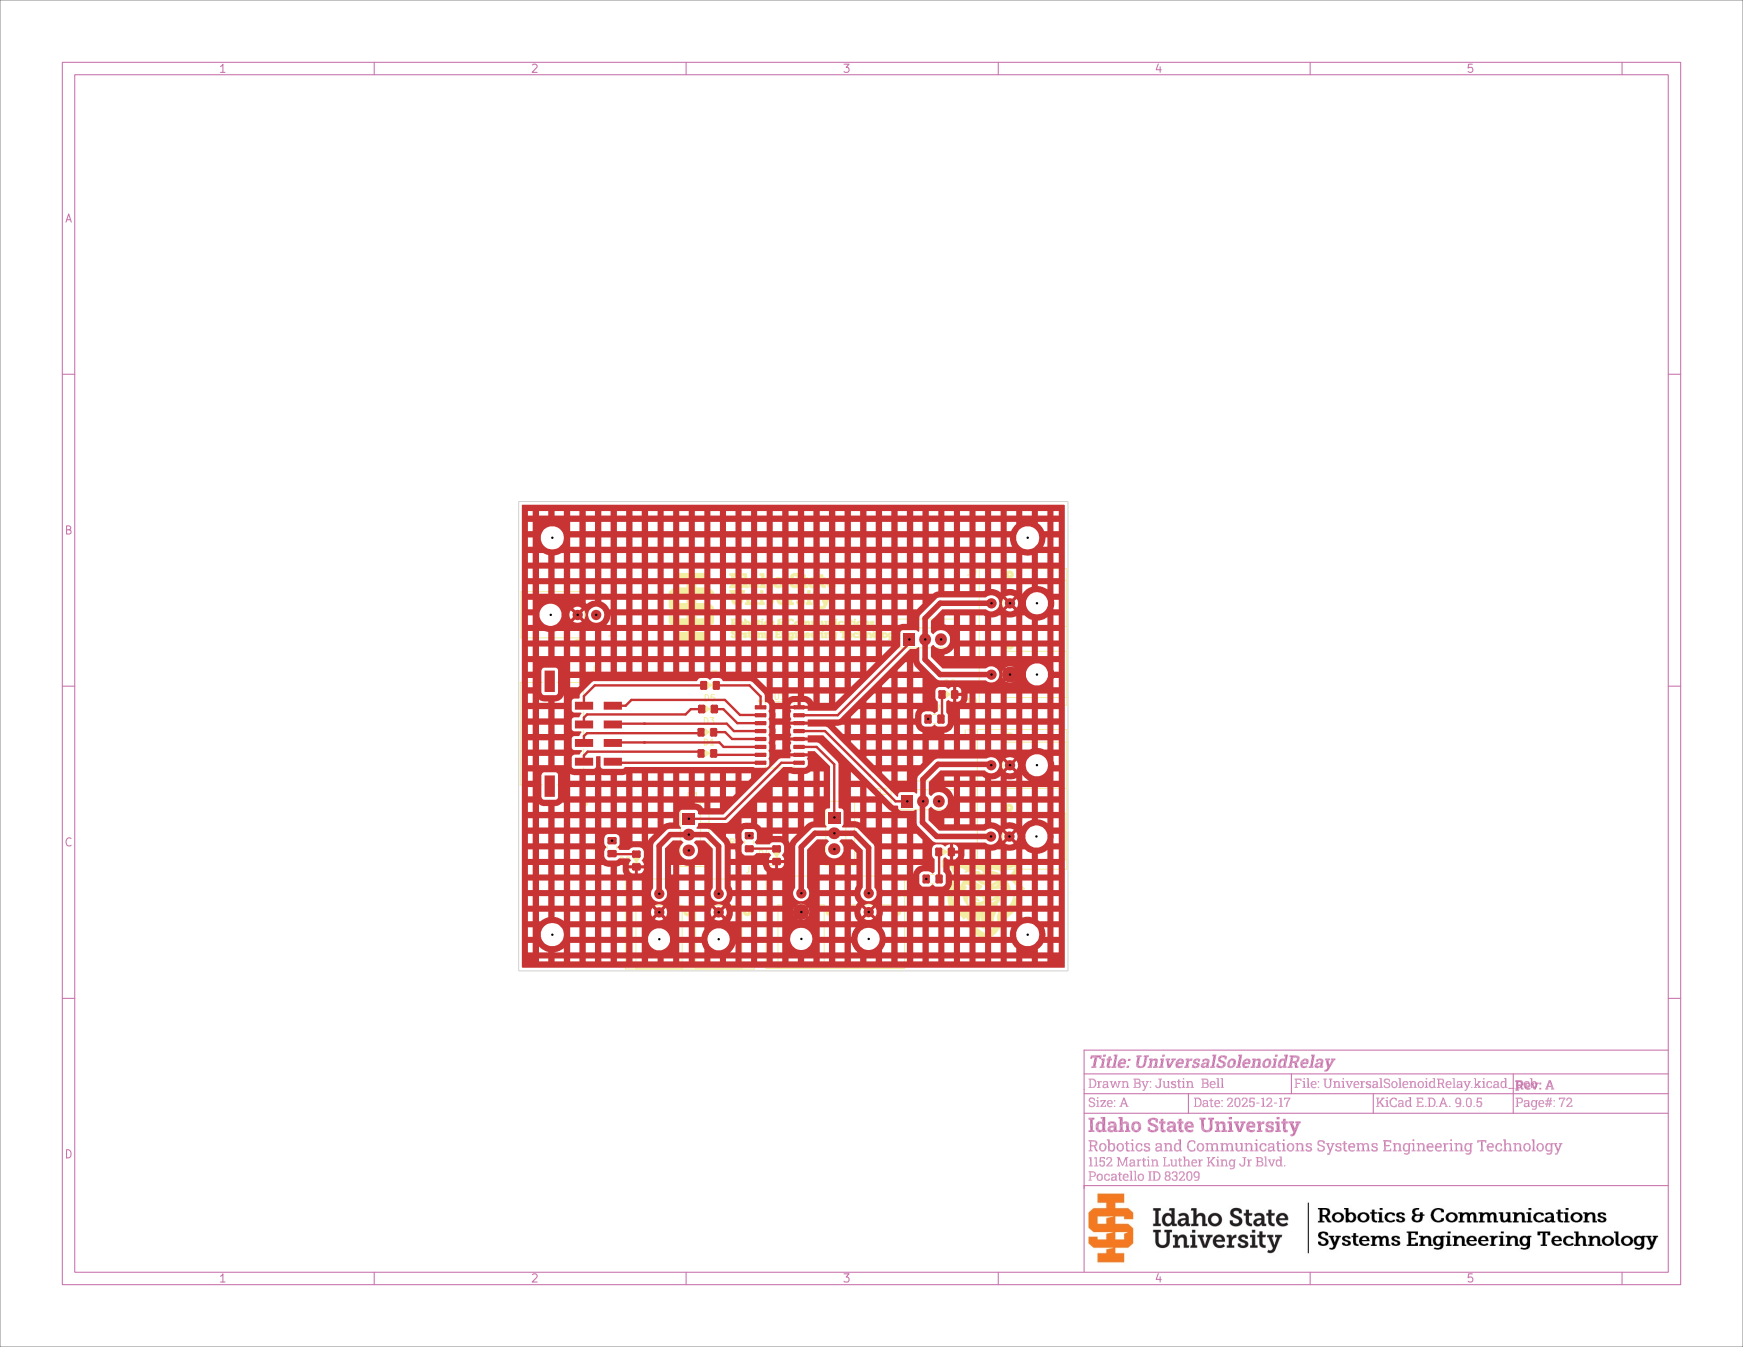
[picture p118: page 1]
