slacshan/MIDI-Projects/BassGuitar/CAD/F25/2020DoubleT.pdf

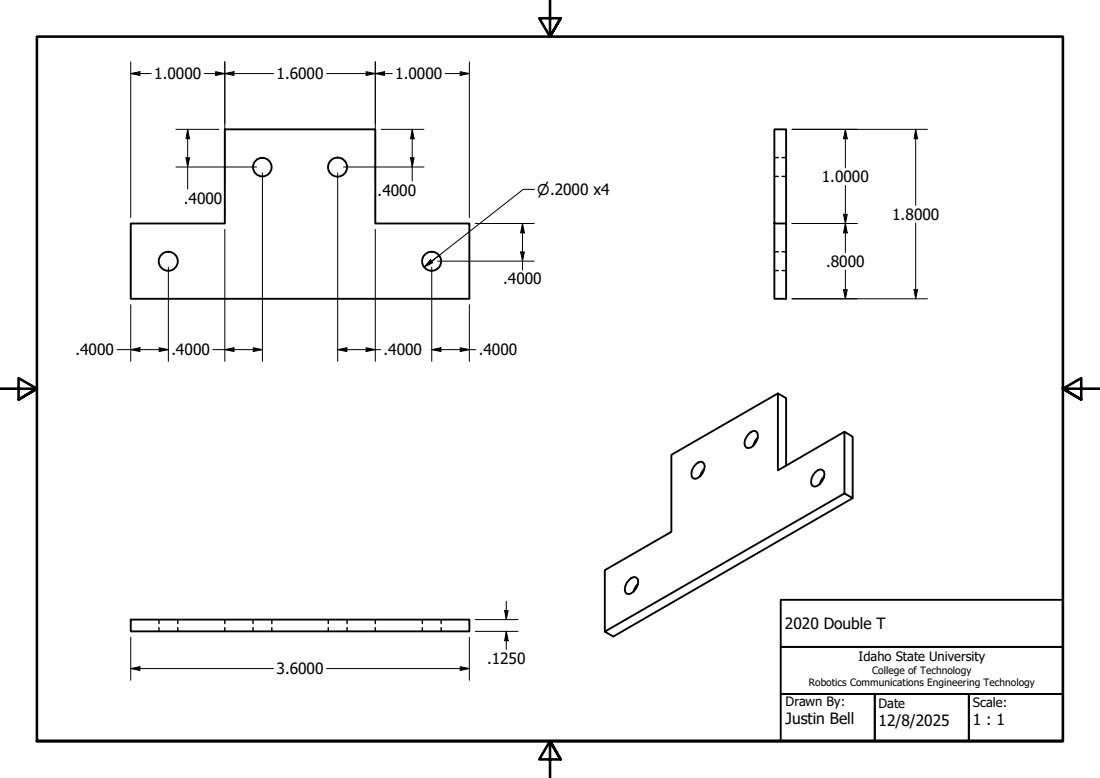
[picture p119: page 1]
2020 Double T

Idaho State University
College of Technology

Robotics Communications Engineering Technology
Drawn By:
Justin Bell
