slacshan/MIDI-Projects/BassGuitar/Circuitry/S25/FullSch.pdf

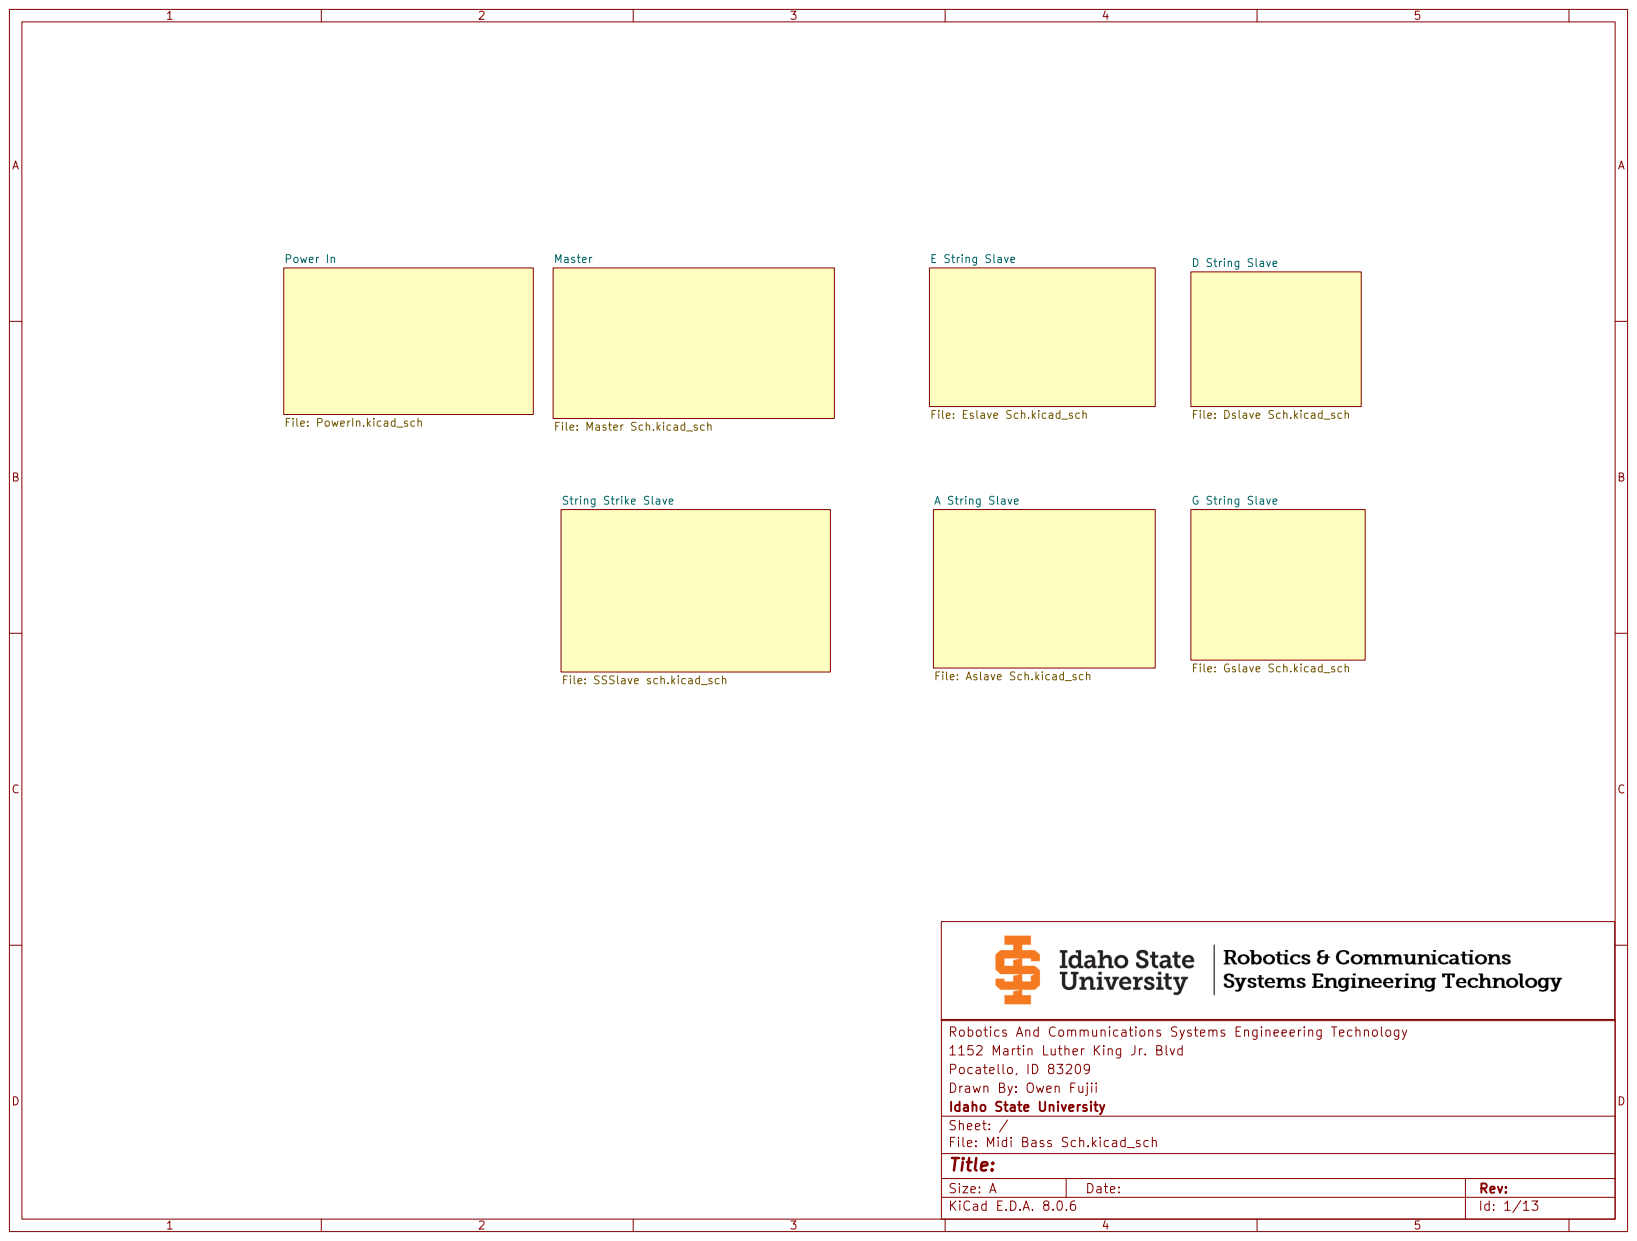
[picture p120: page 1]

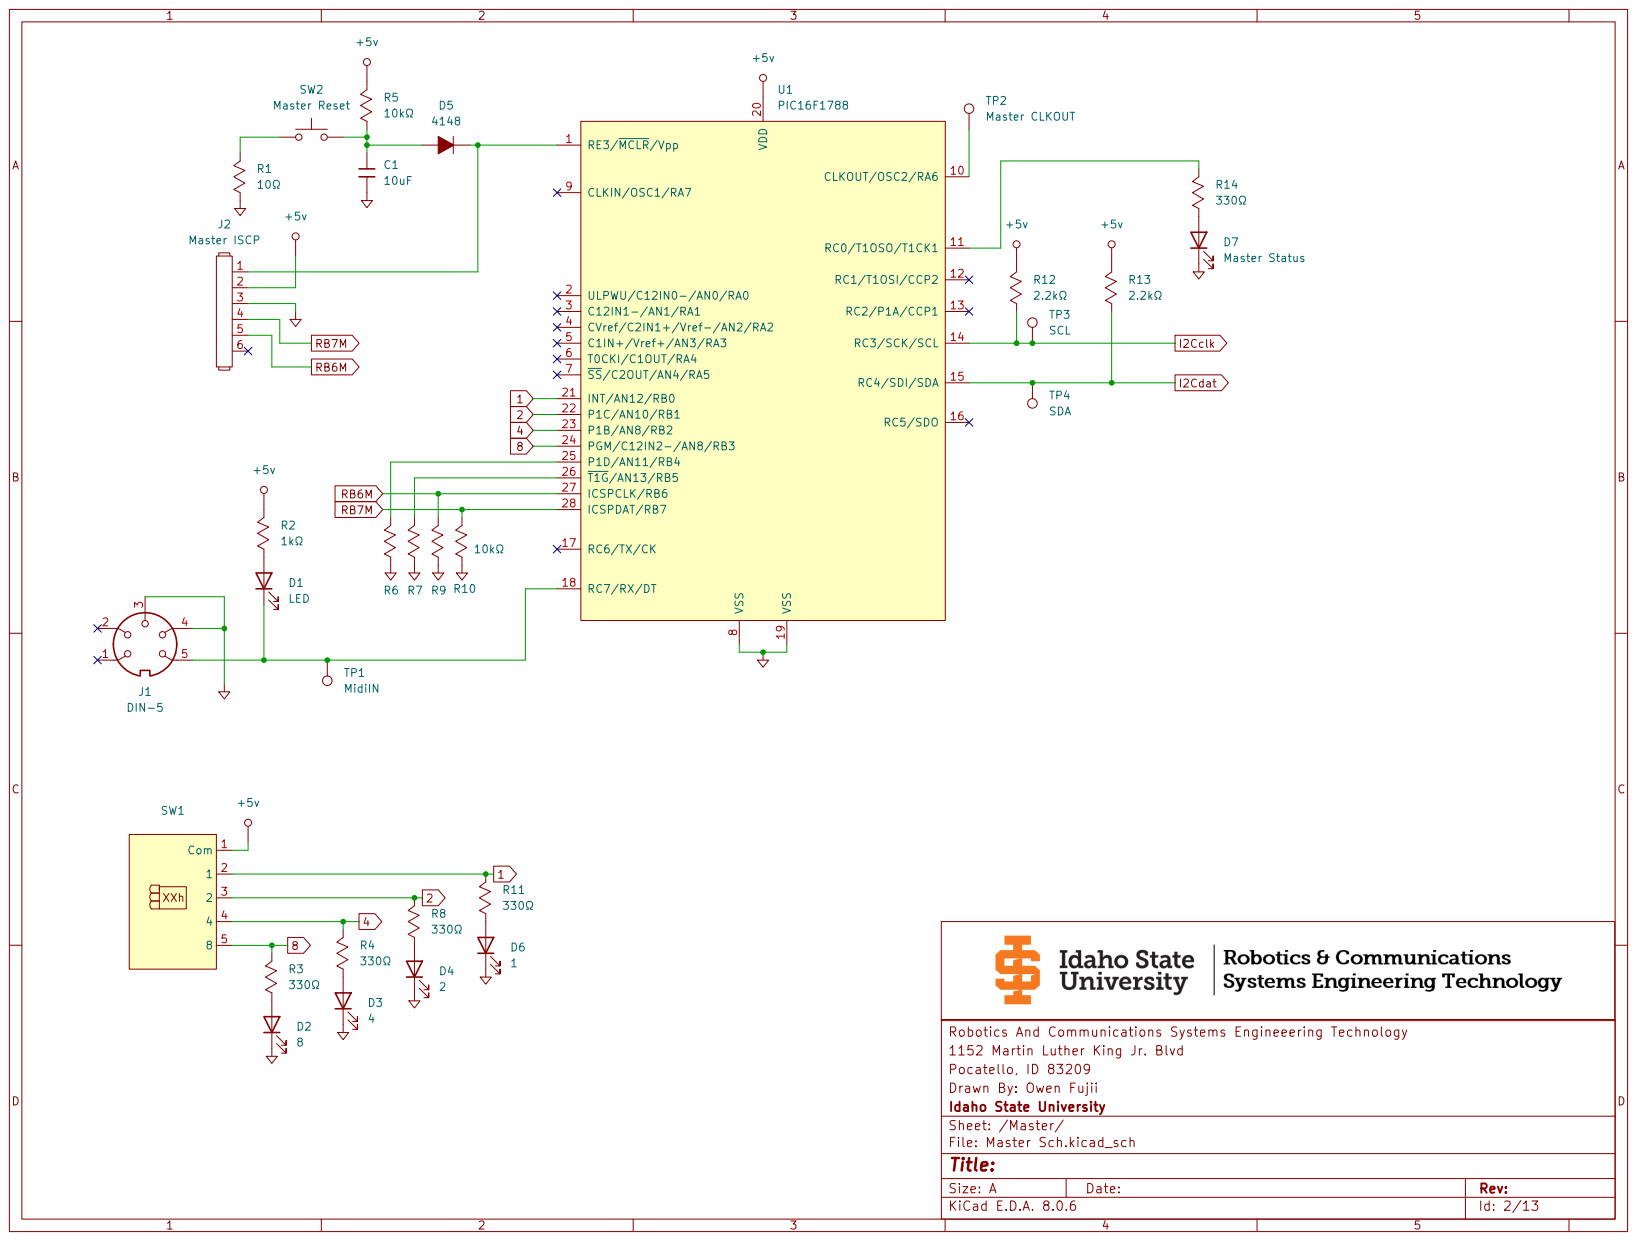
[picture p121: page 2]

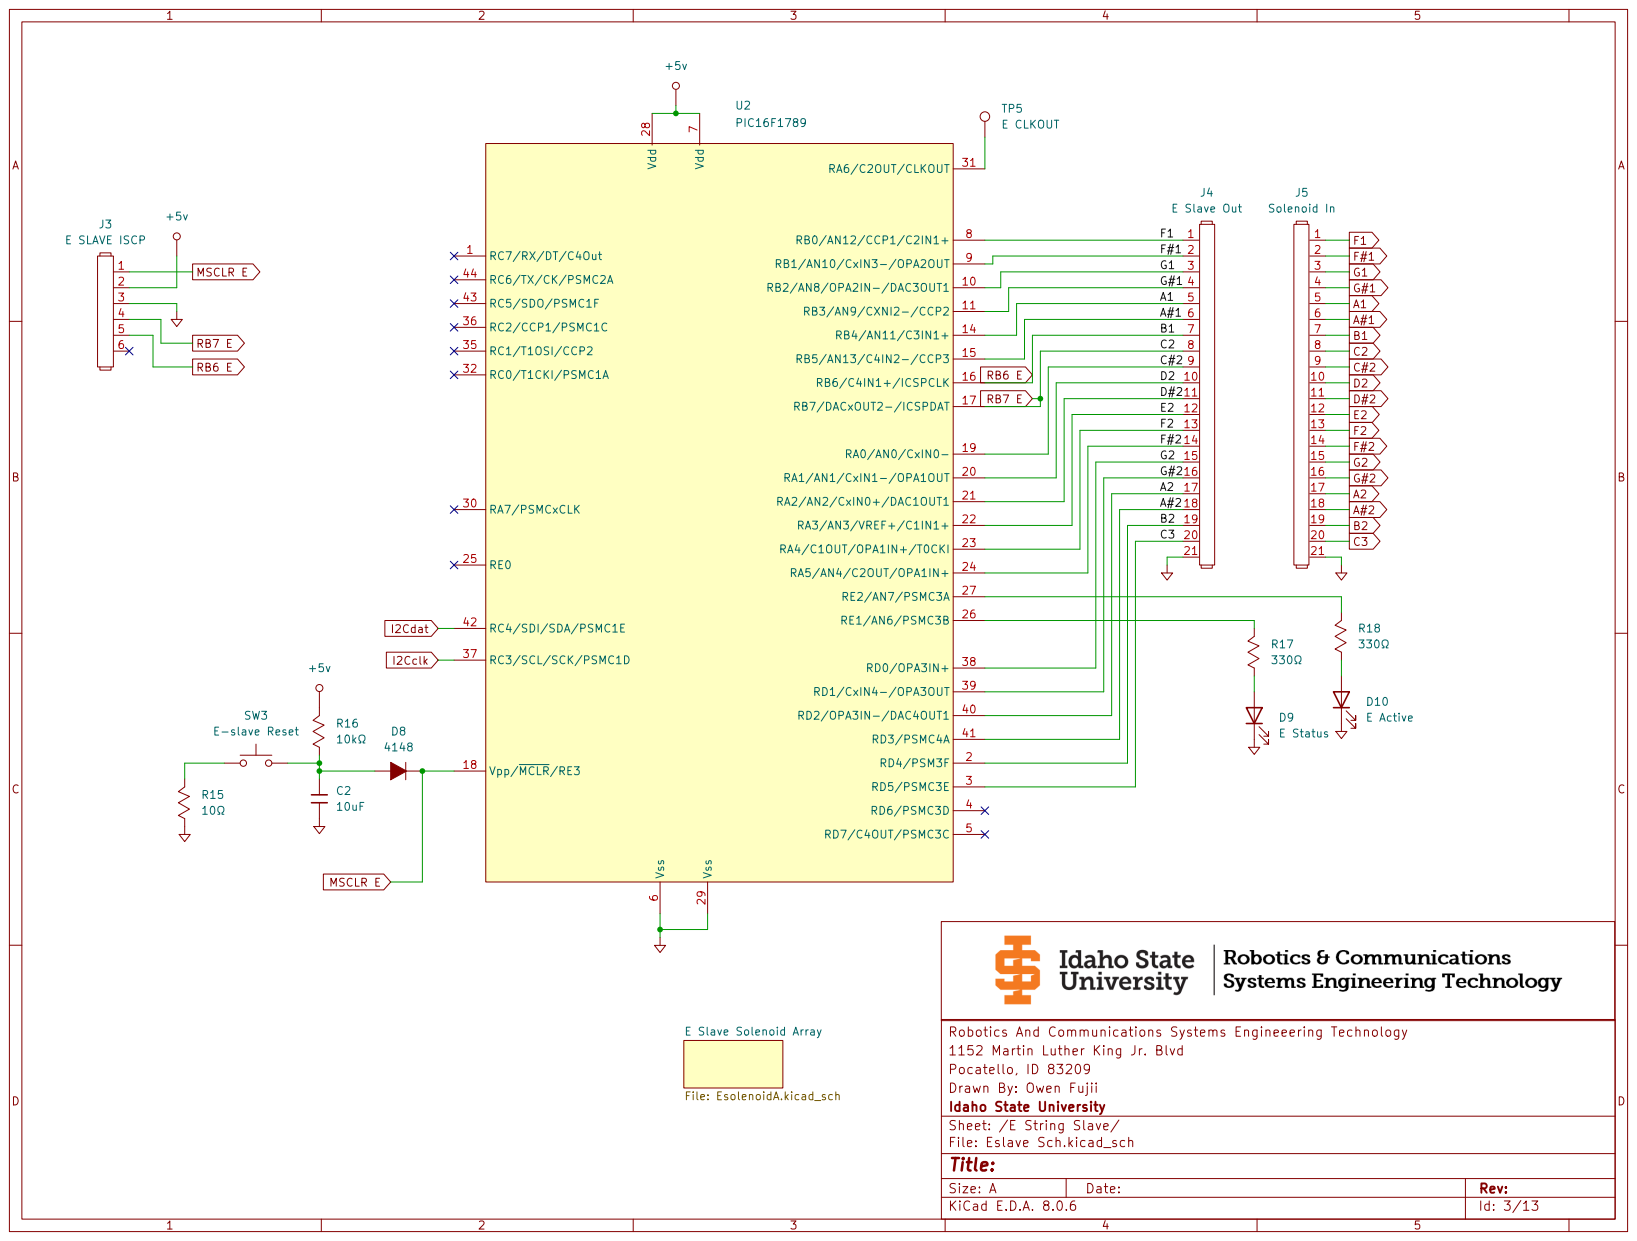
[picture p122: page 3]

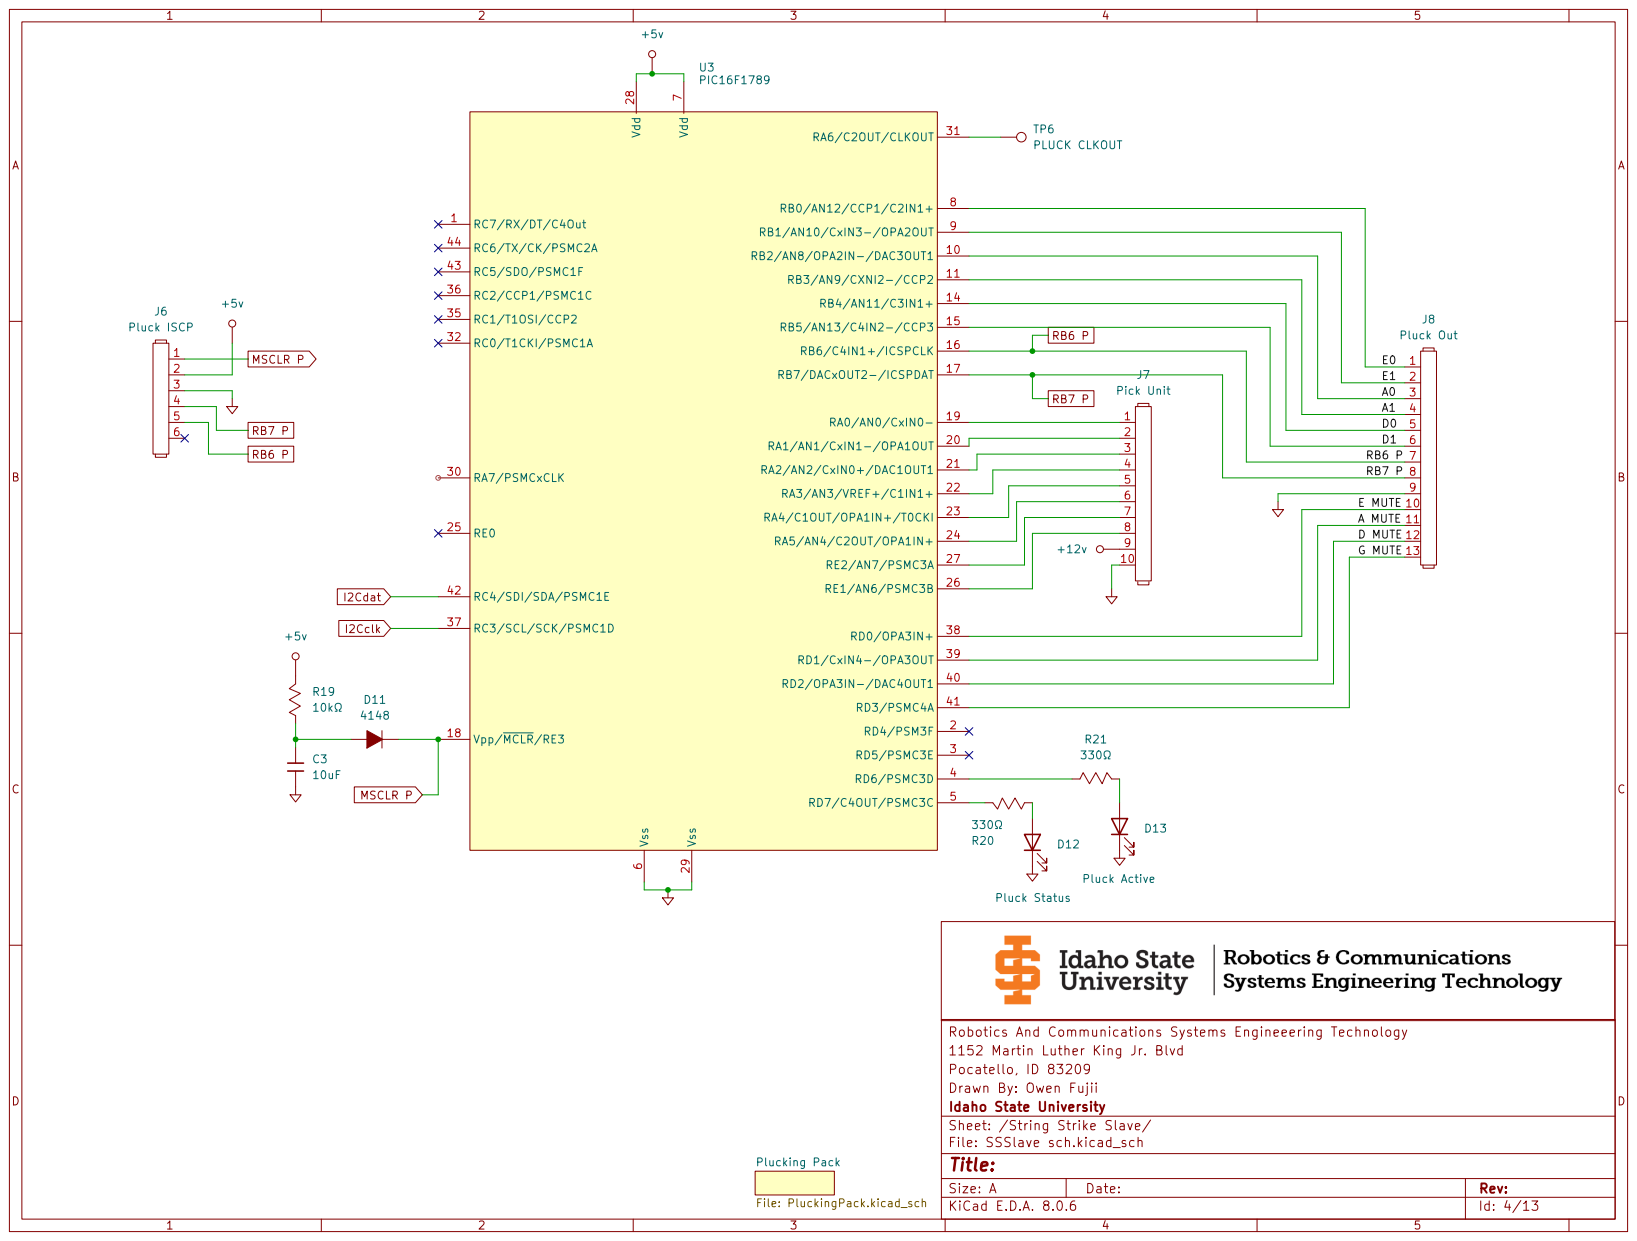
[picture p123: page 4]

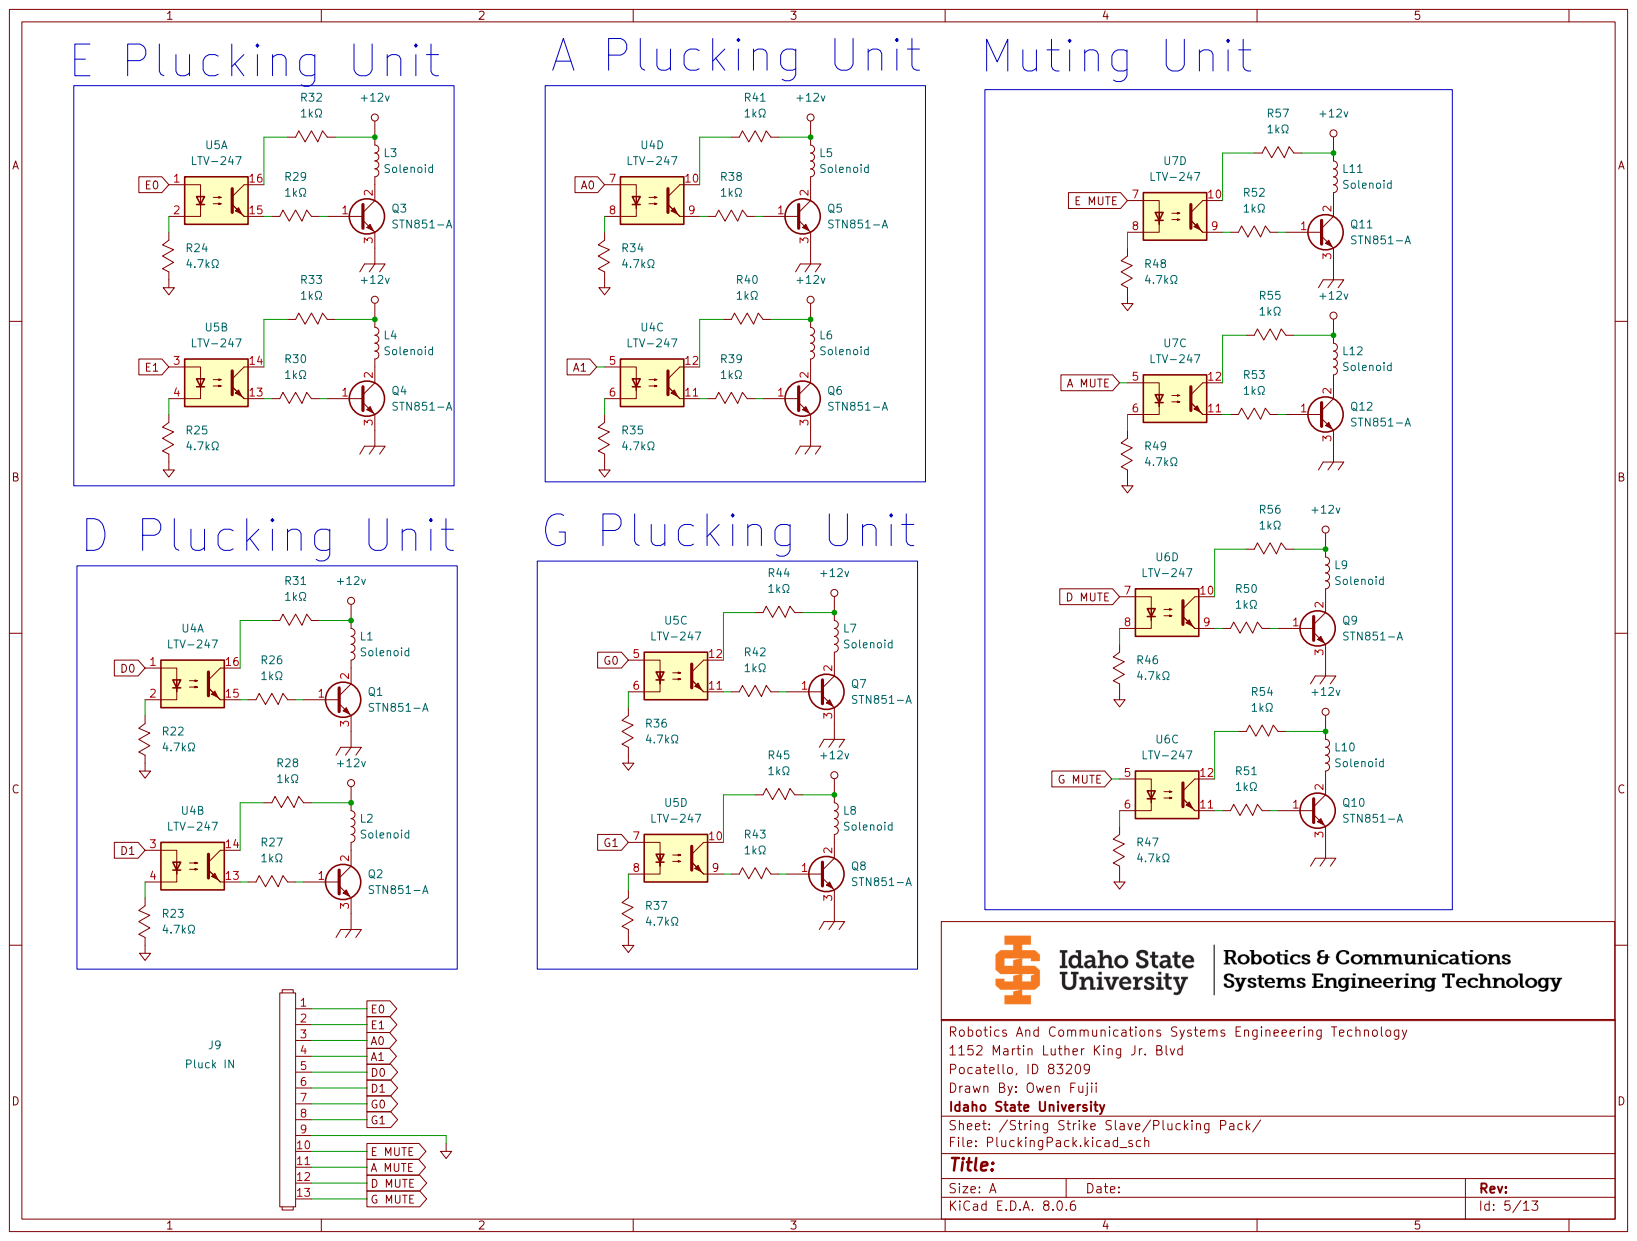
[picture p124: page 5]

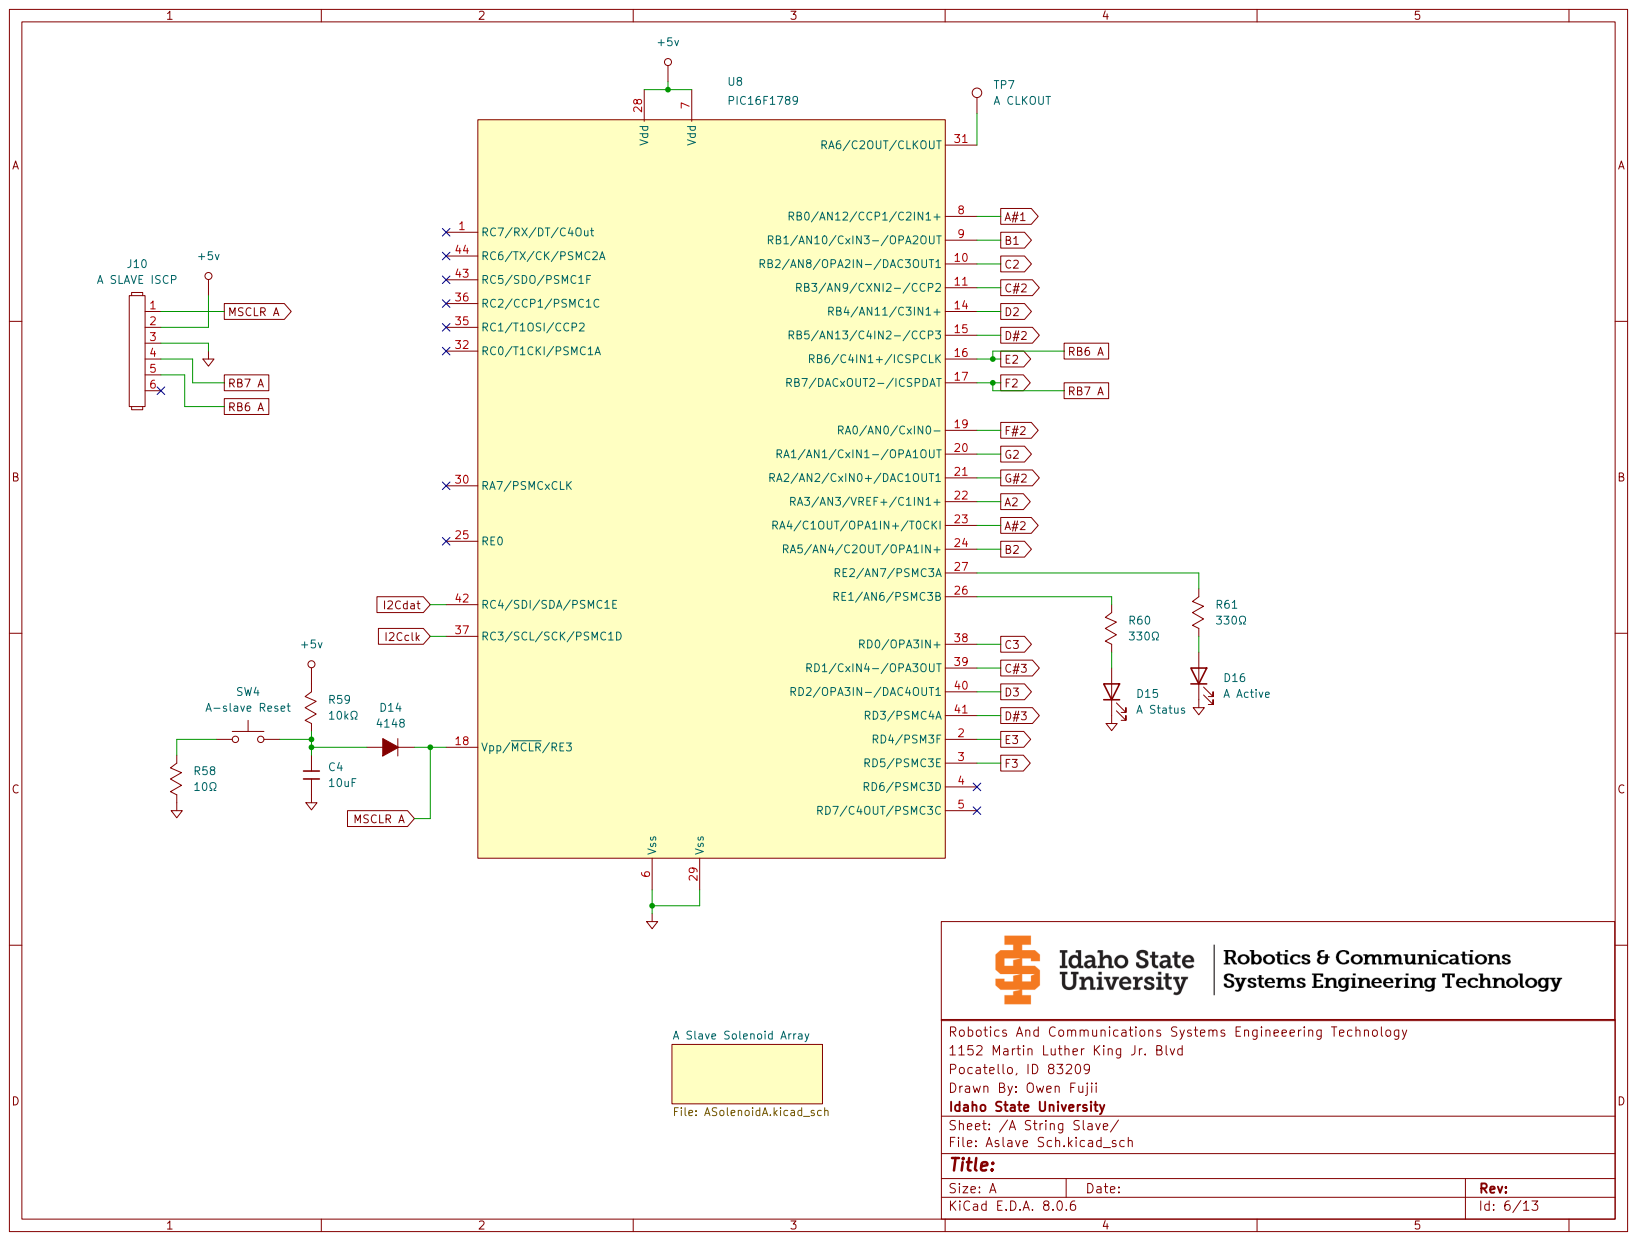
[picture p125: page 6]

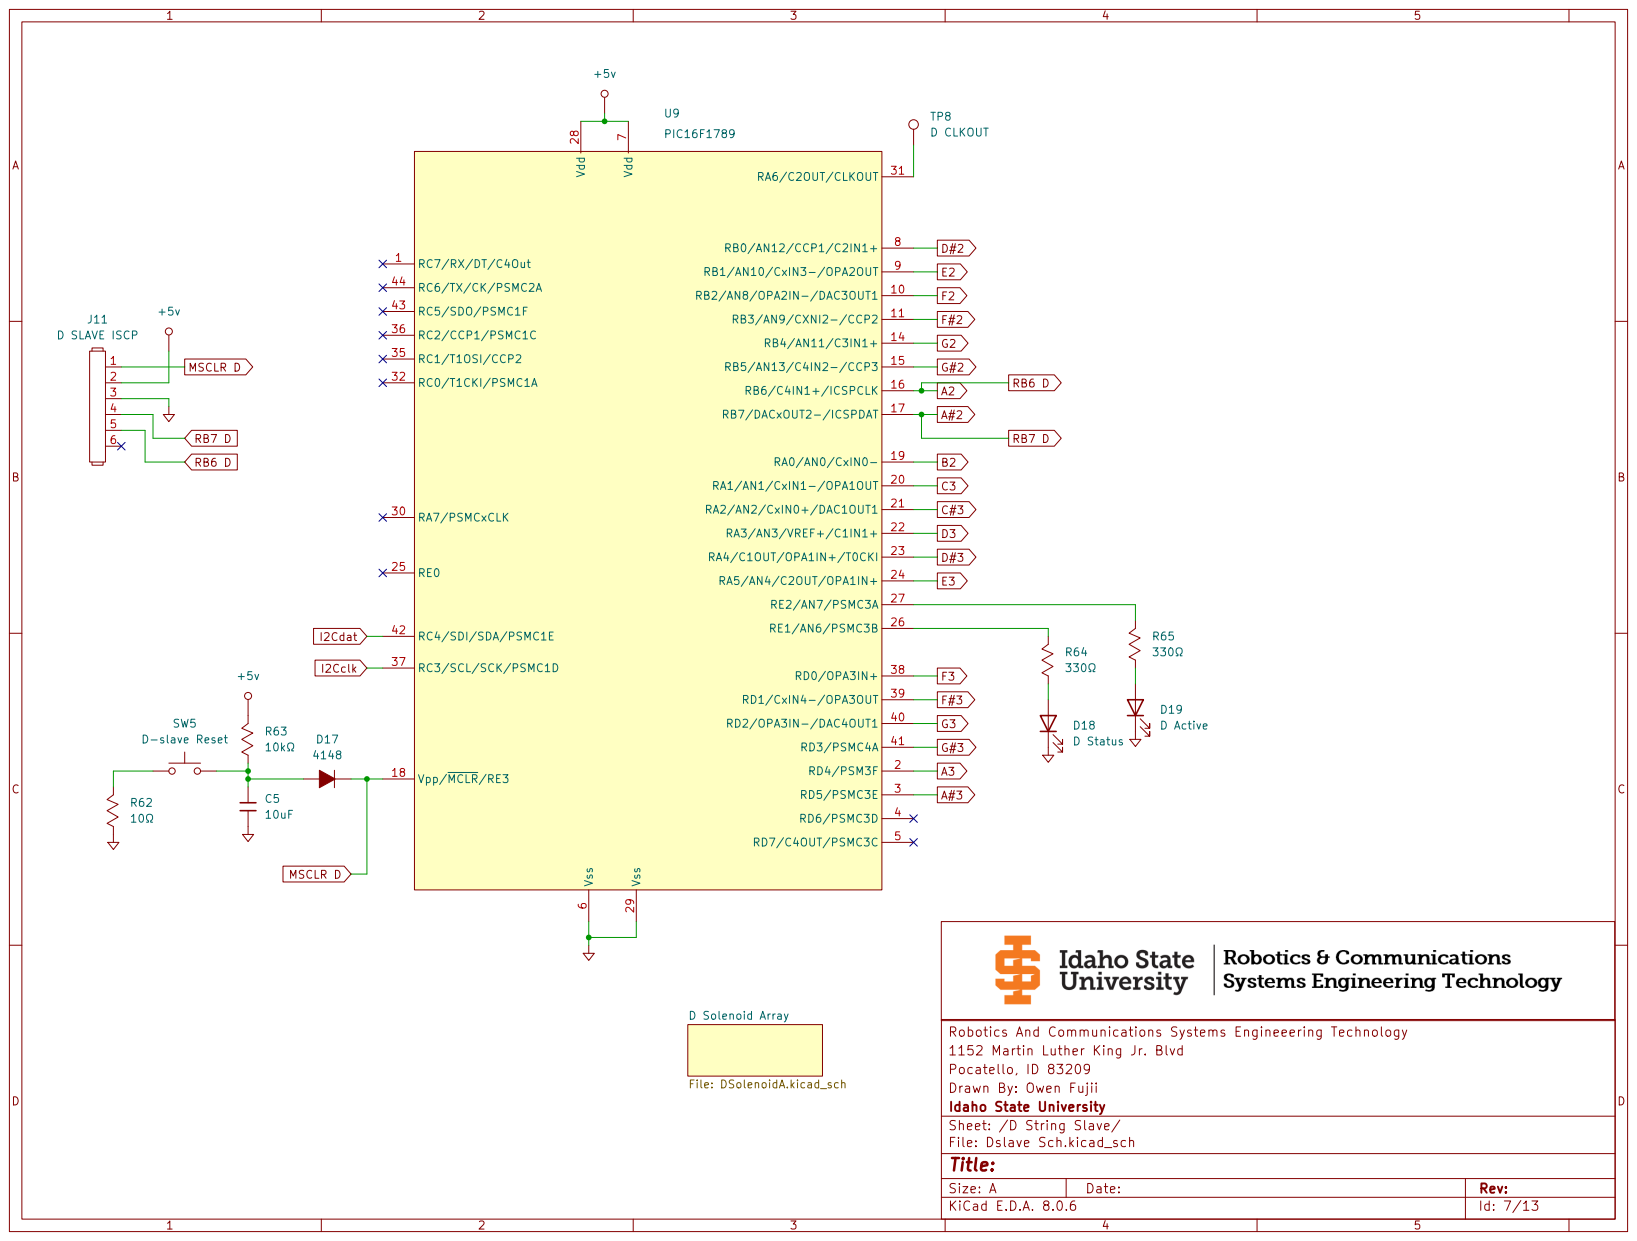
[picture p126: page 7]

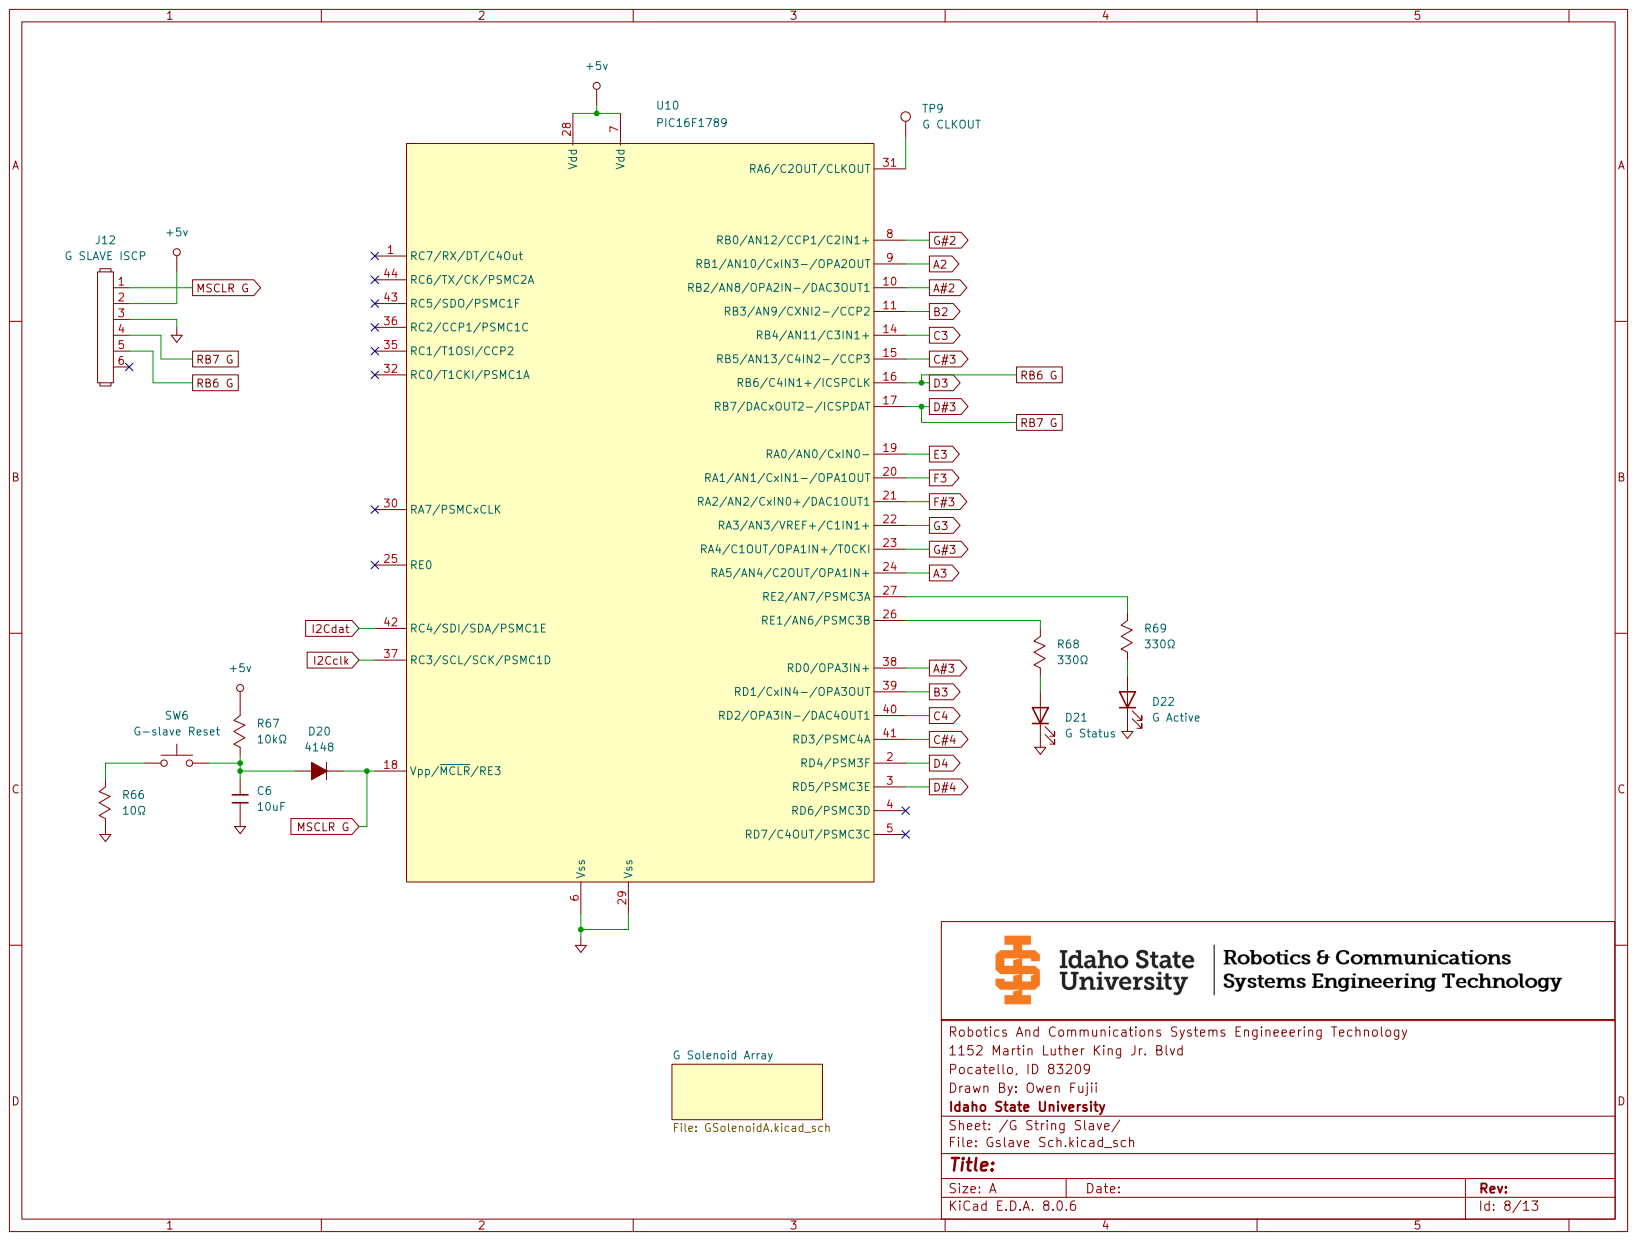
[picture p127: page 8]

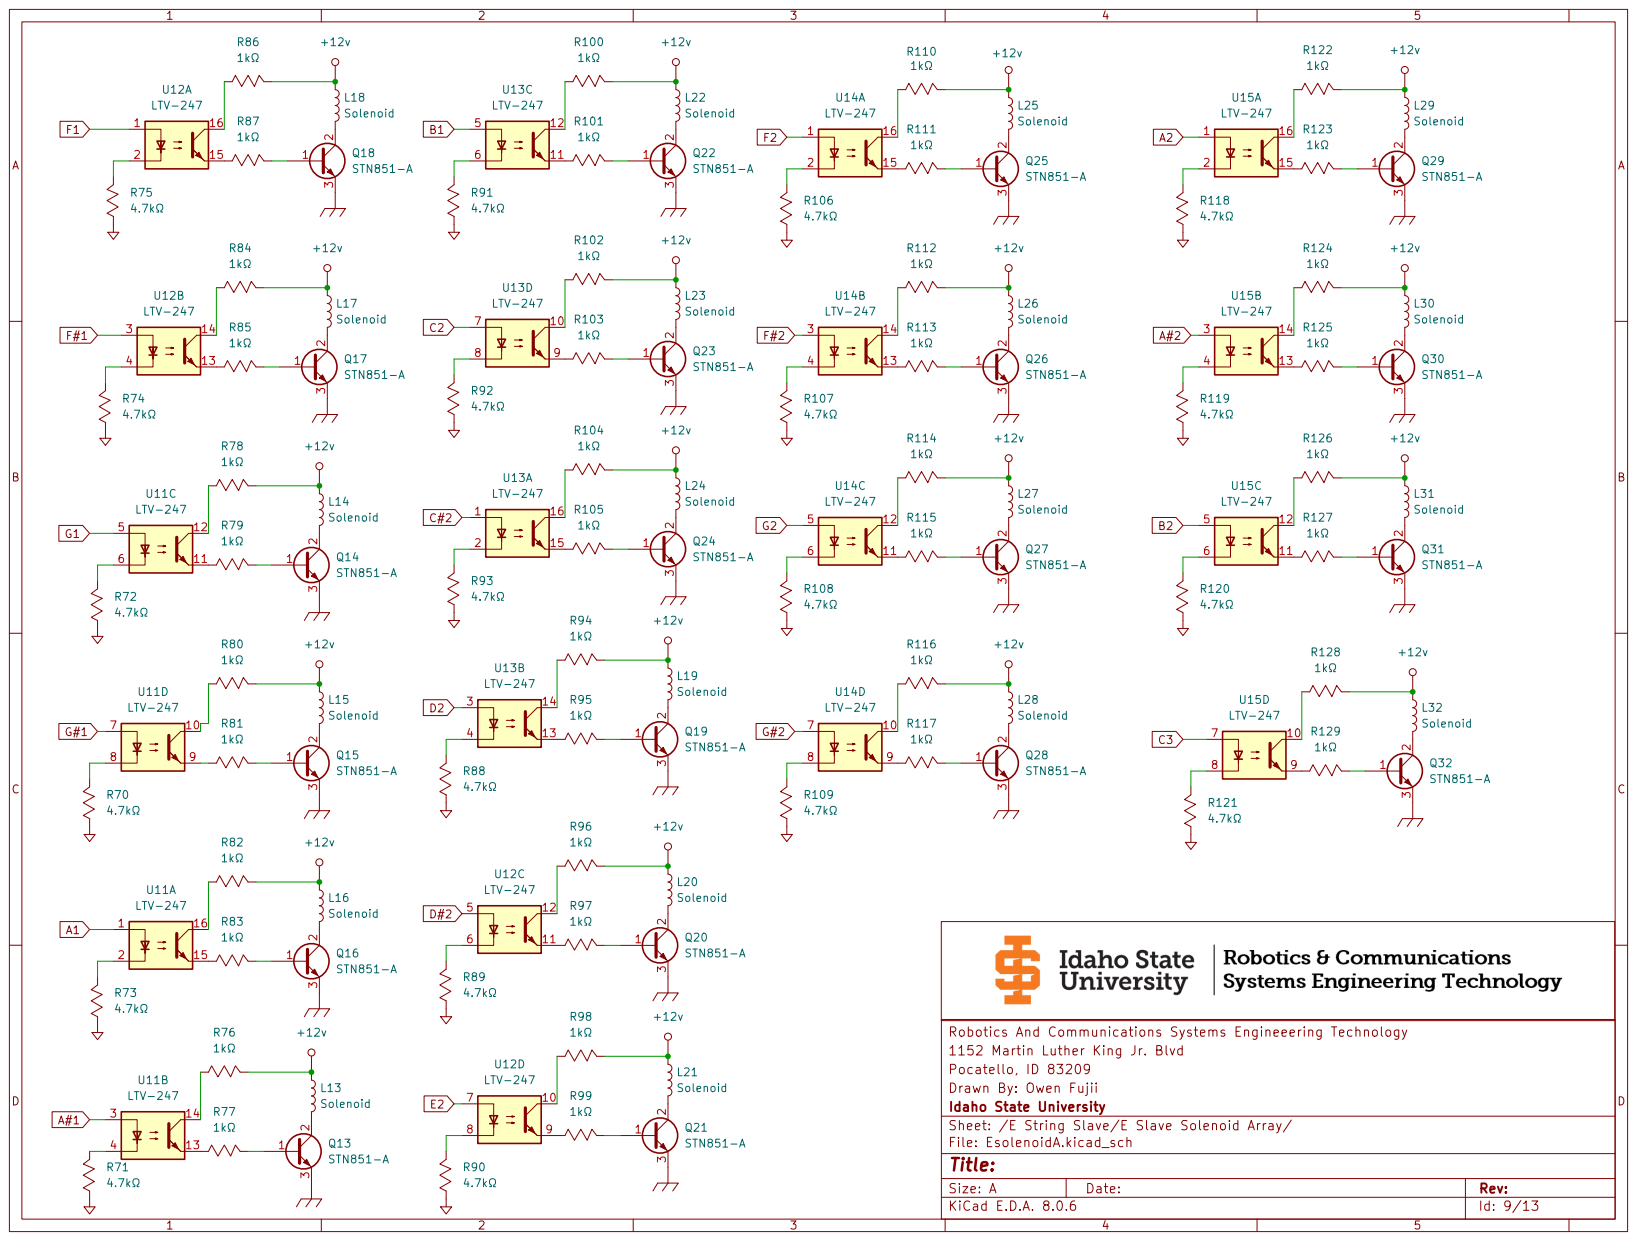
[picture p128: page 9]

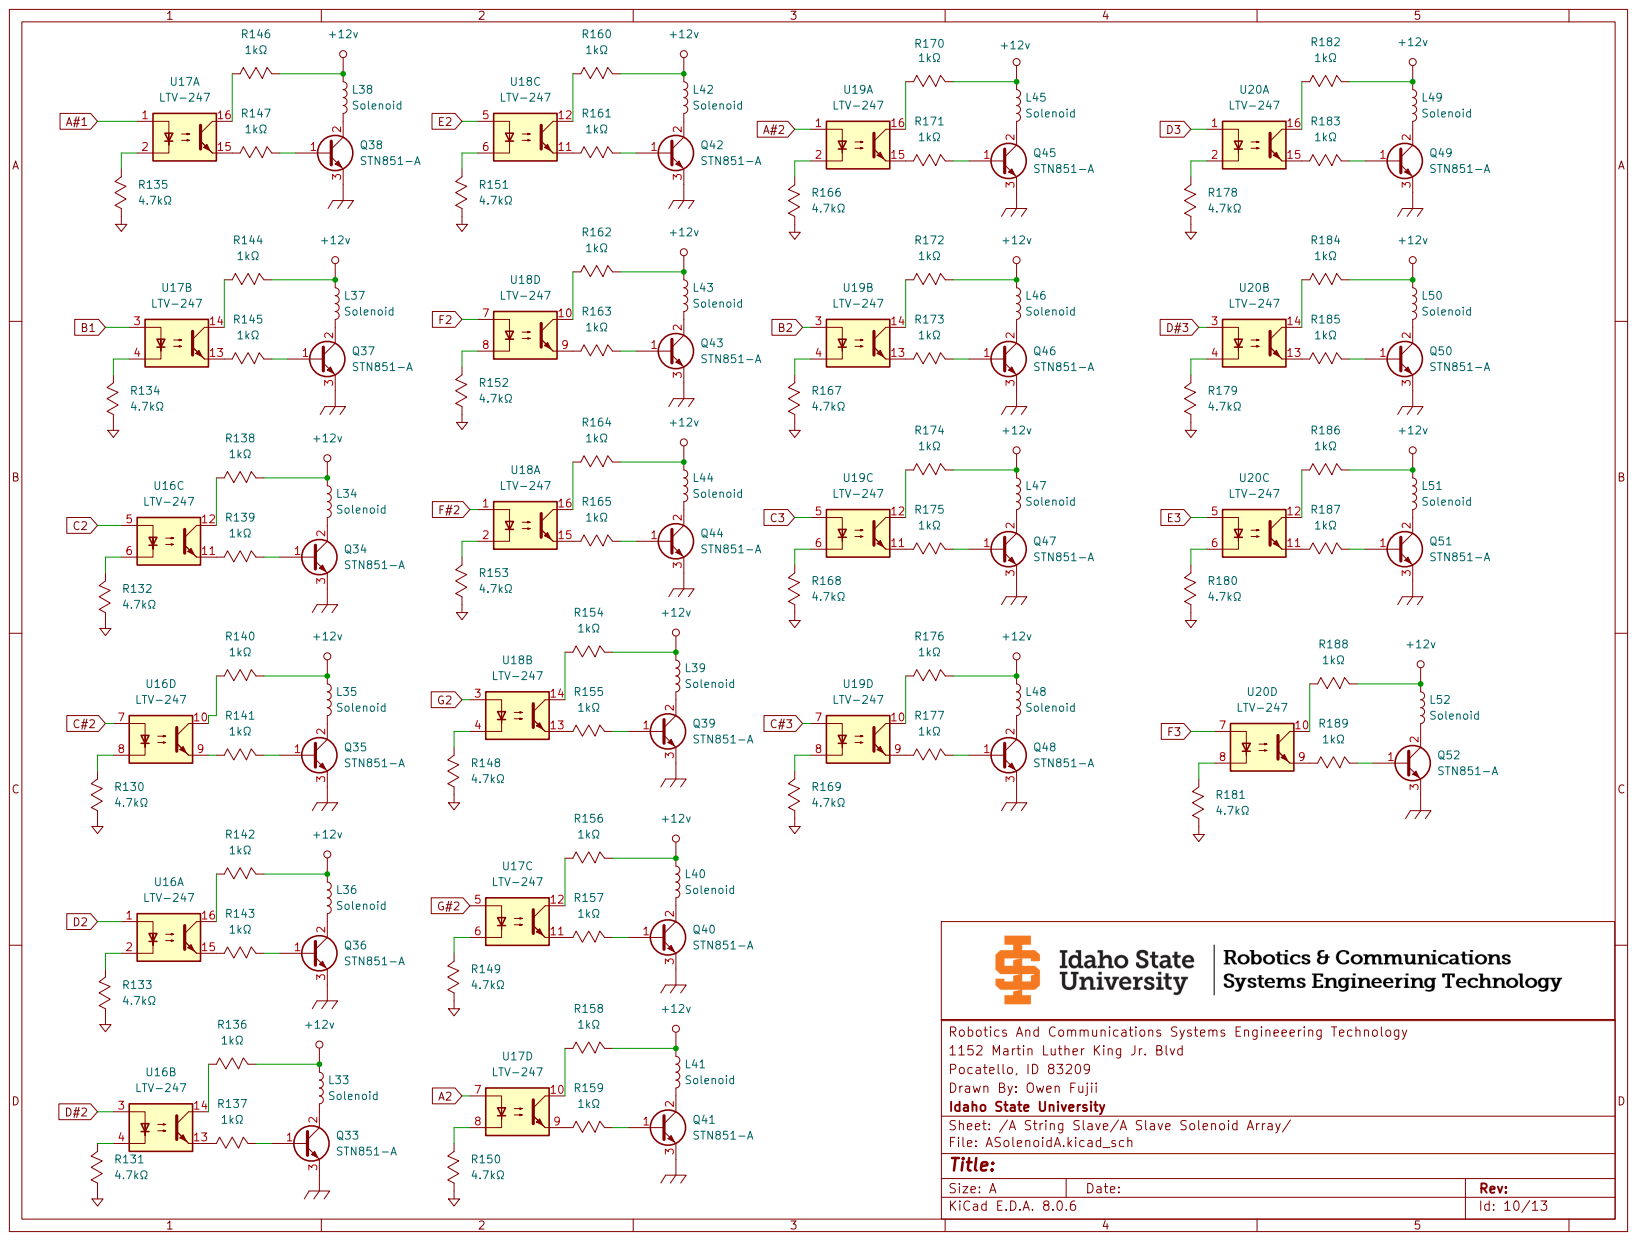
[picture p129: page 10]

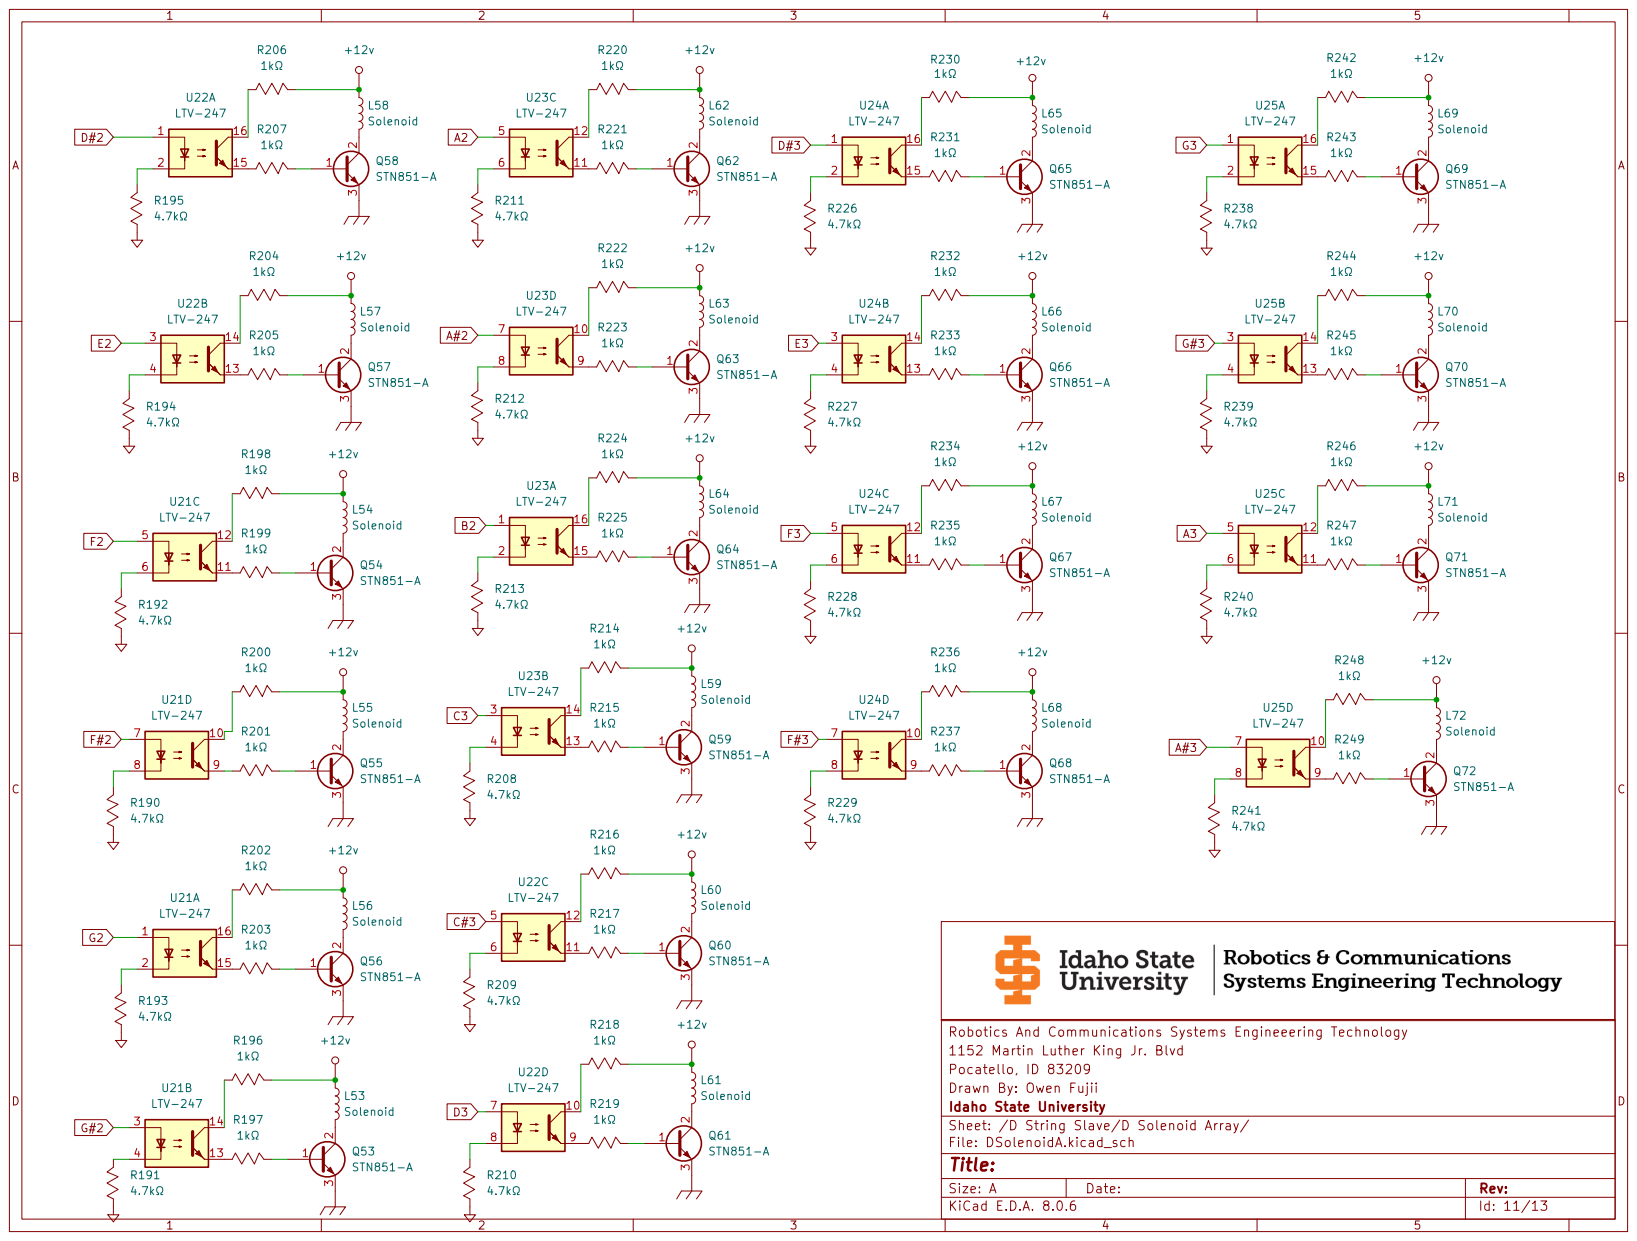
[picture p130: page 11]

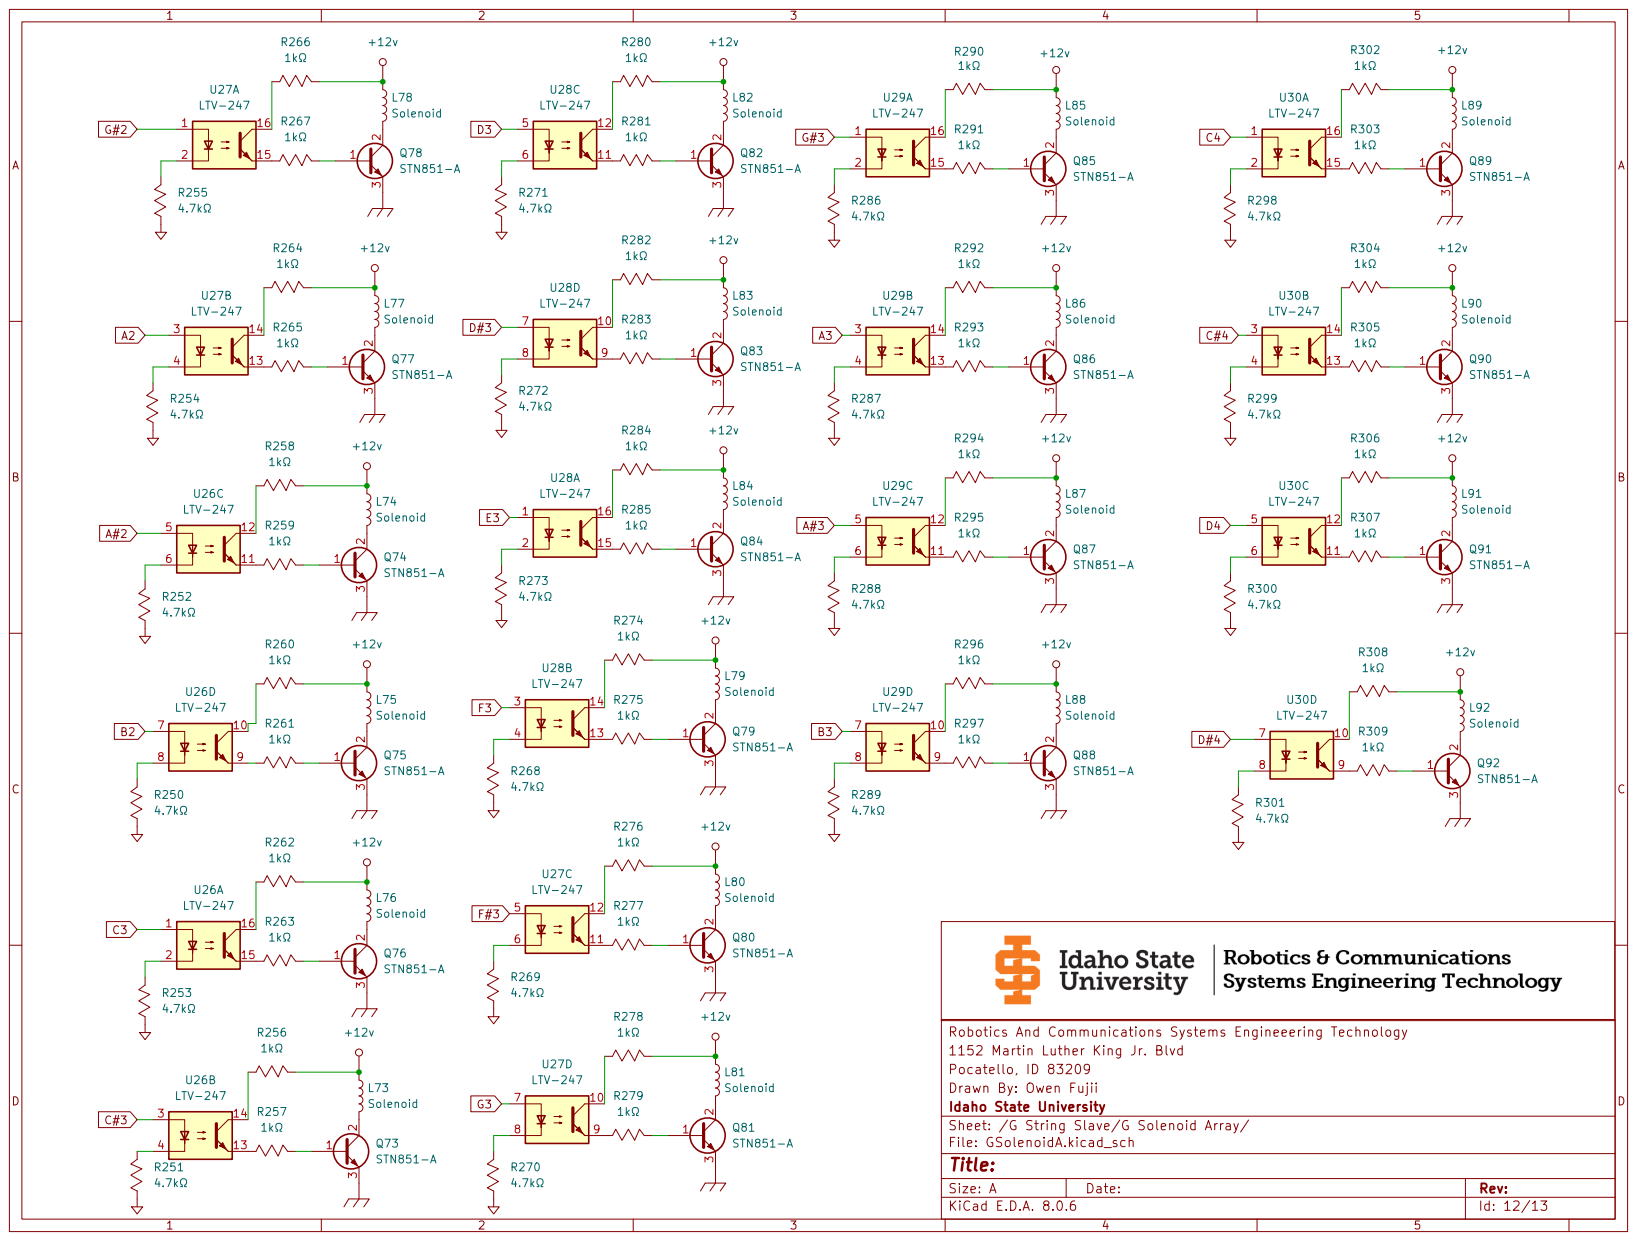
[picture p131: page 12]

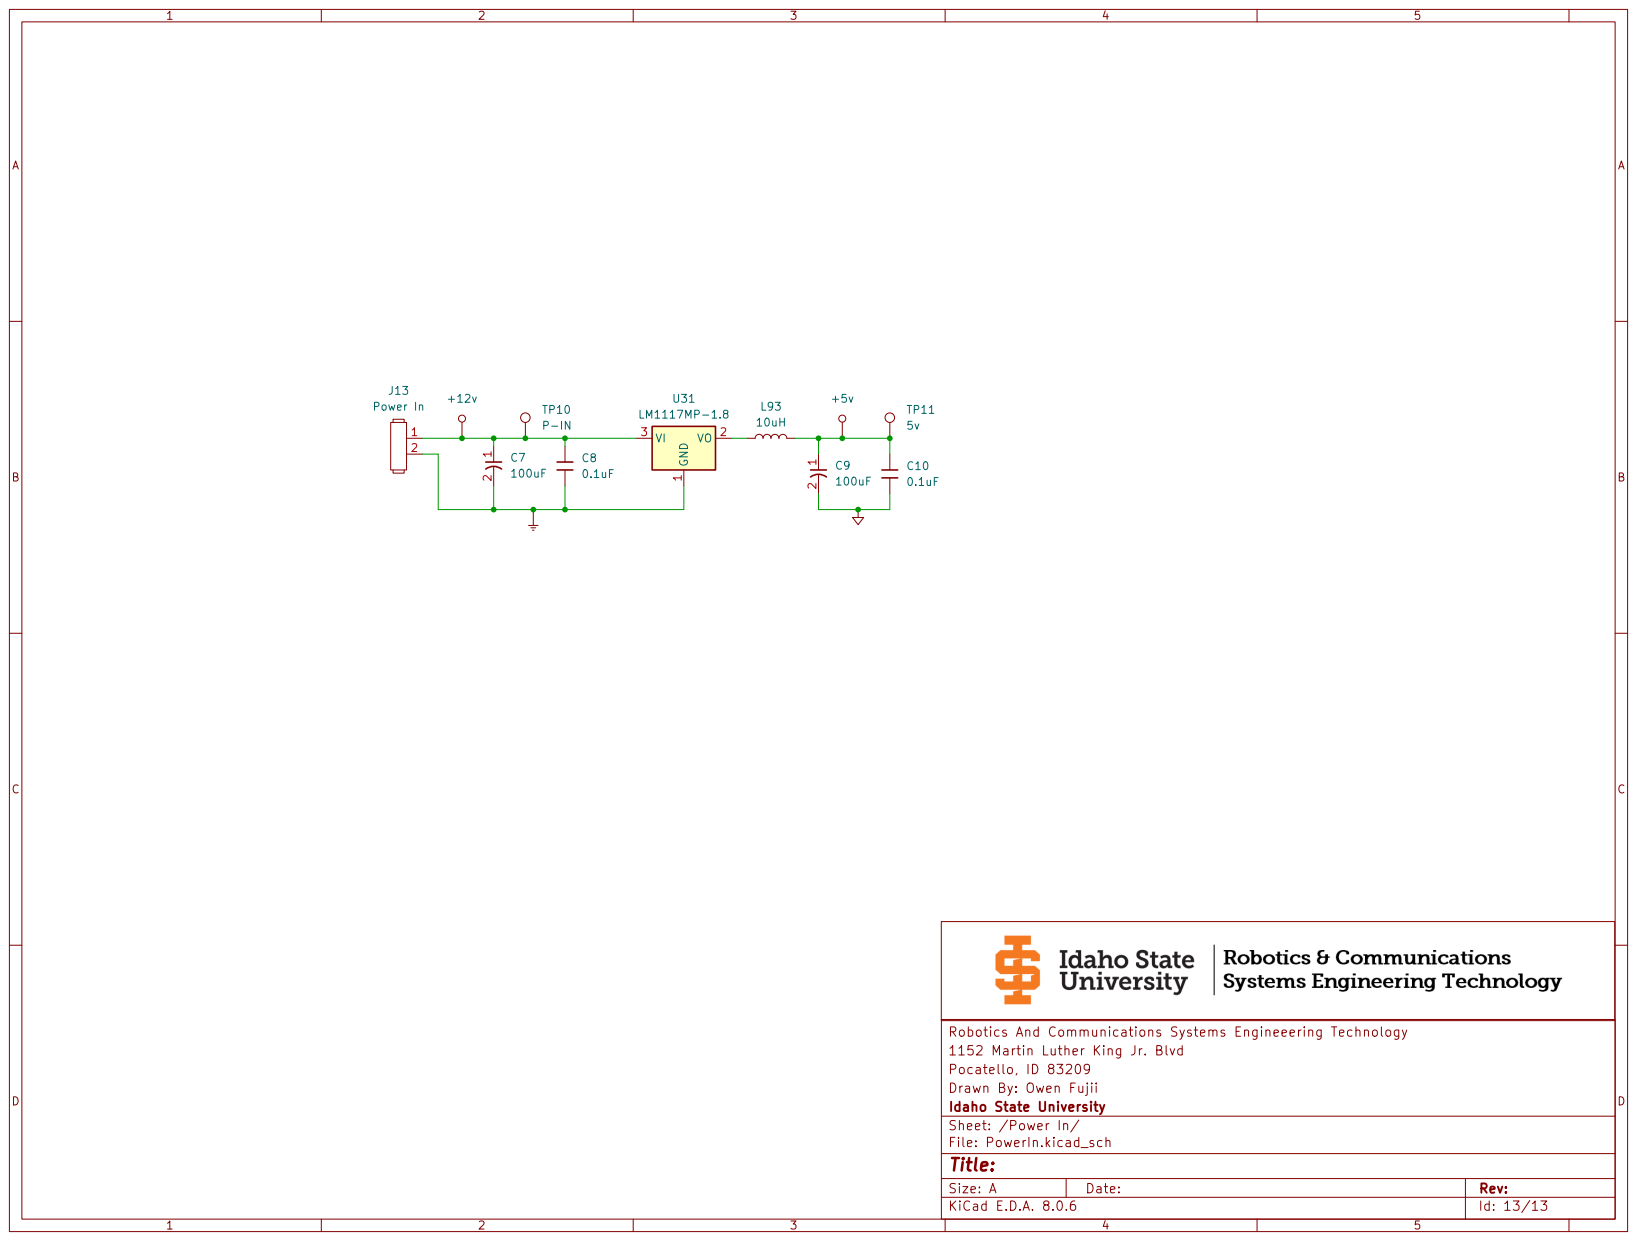
[picture p132: page 13]
