slacshan/MIDI-Projects/BassGuitar/Circuitry/F25/UniversalMaster/UniversalMaster_RevA.pdf

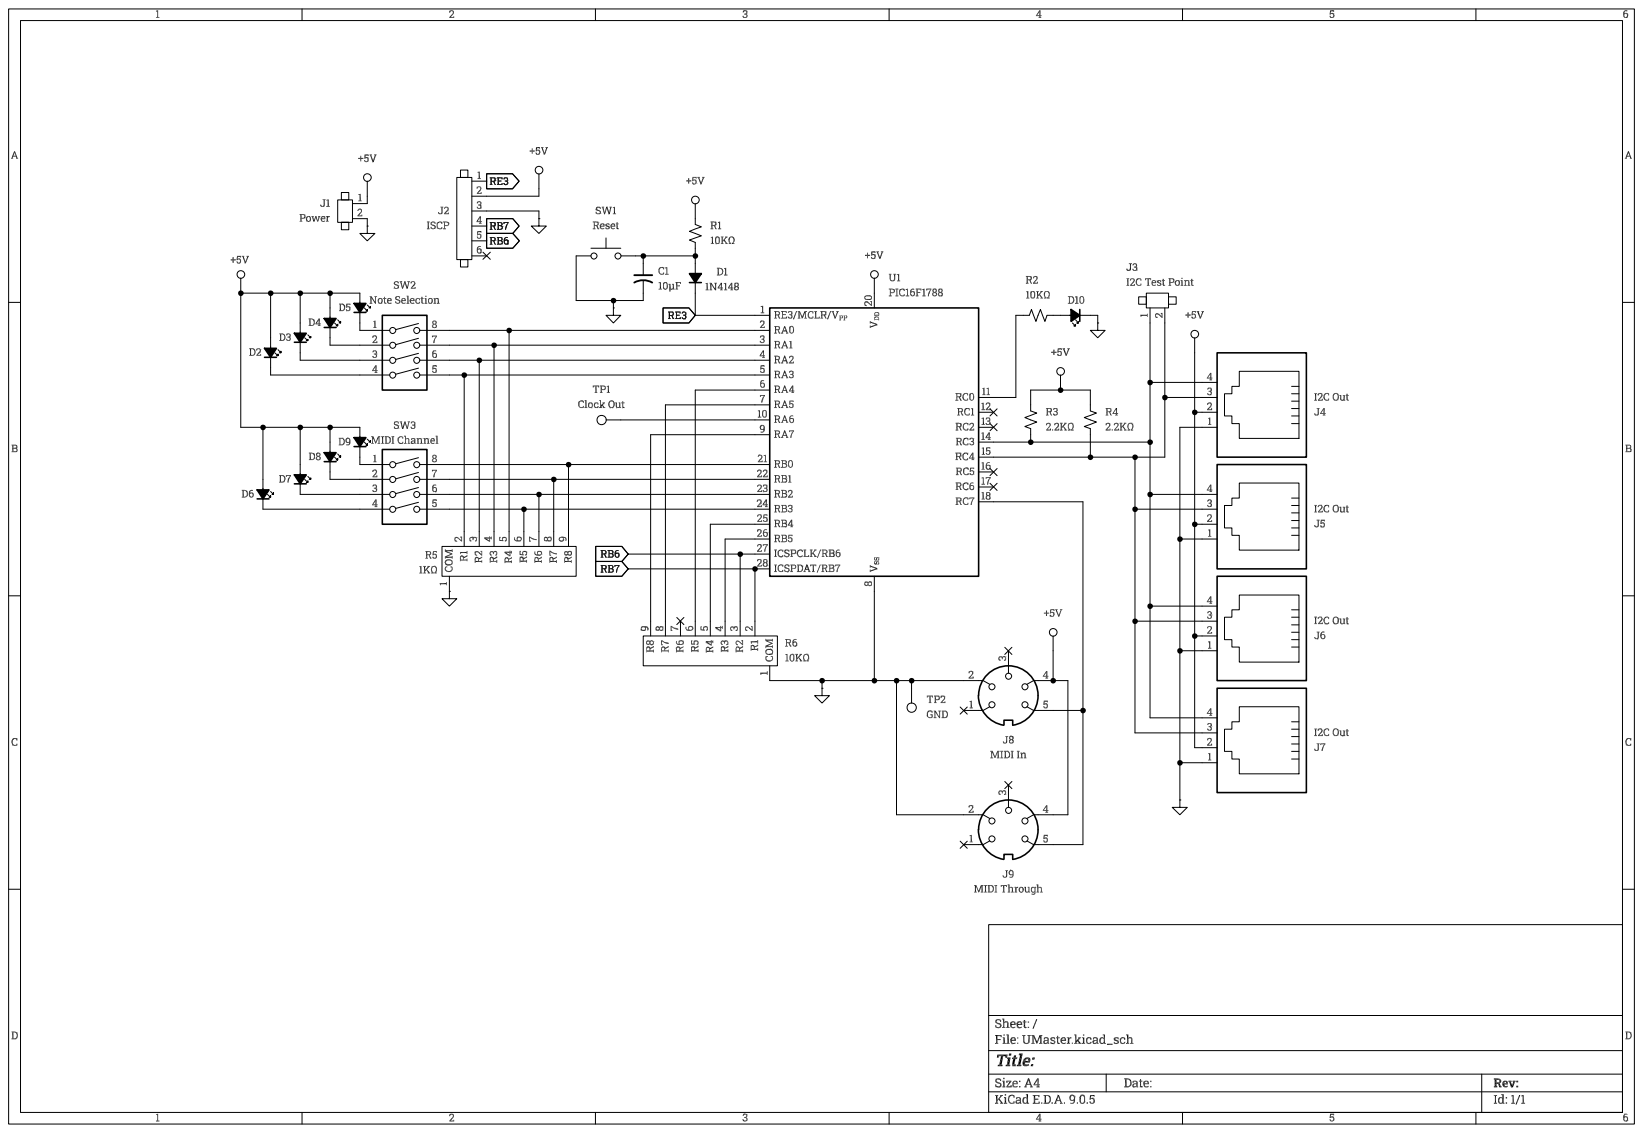
[picture p133: page 1]
