slacshan/MIDI-Projects/BassGuitar/Circuitry/F25/UniversalSlave/UniversalSlave_RevA.pdf

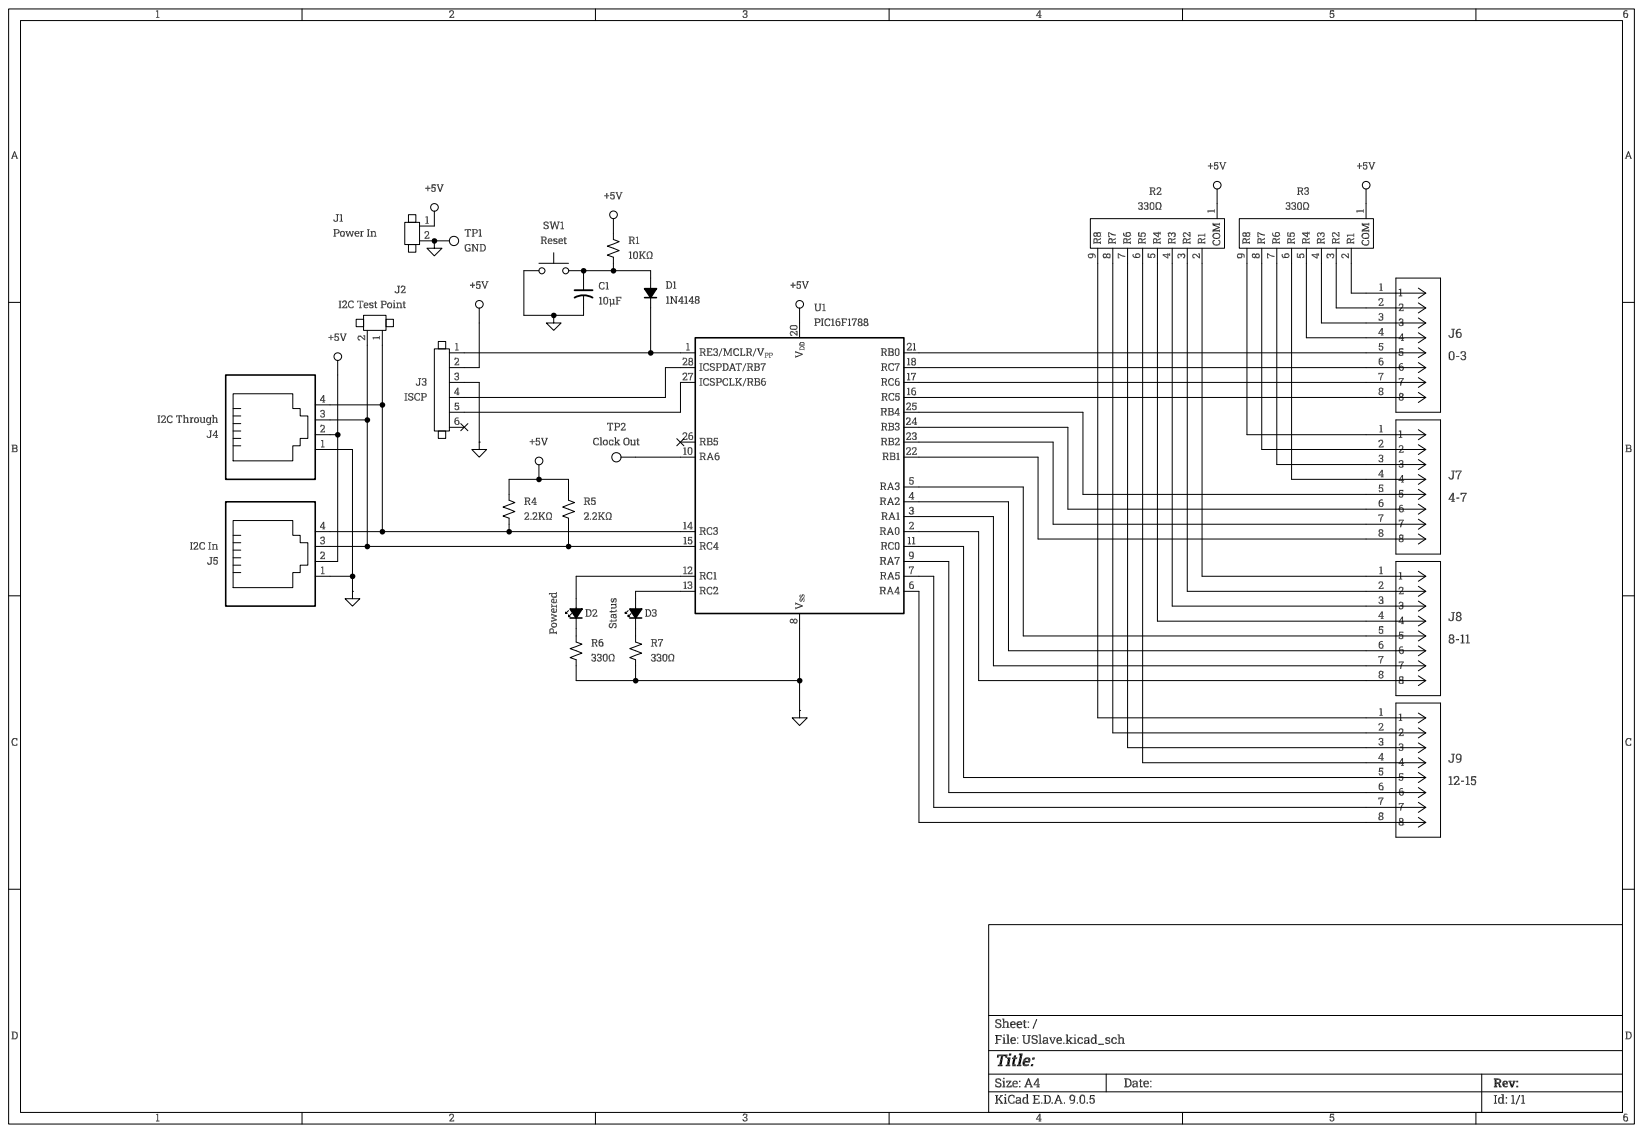
[picture p134: page 1]
