slacshan/MIDI-Projects/BassGuitar/Circuitry/F25/UniversalSolenoidRelay/UniversalSolenoidRelay_RevA.pdf

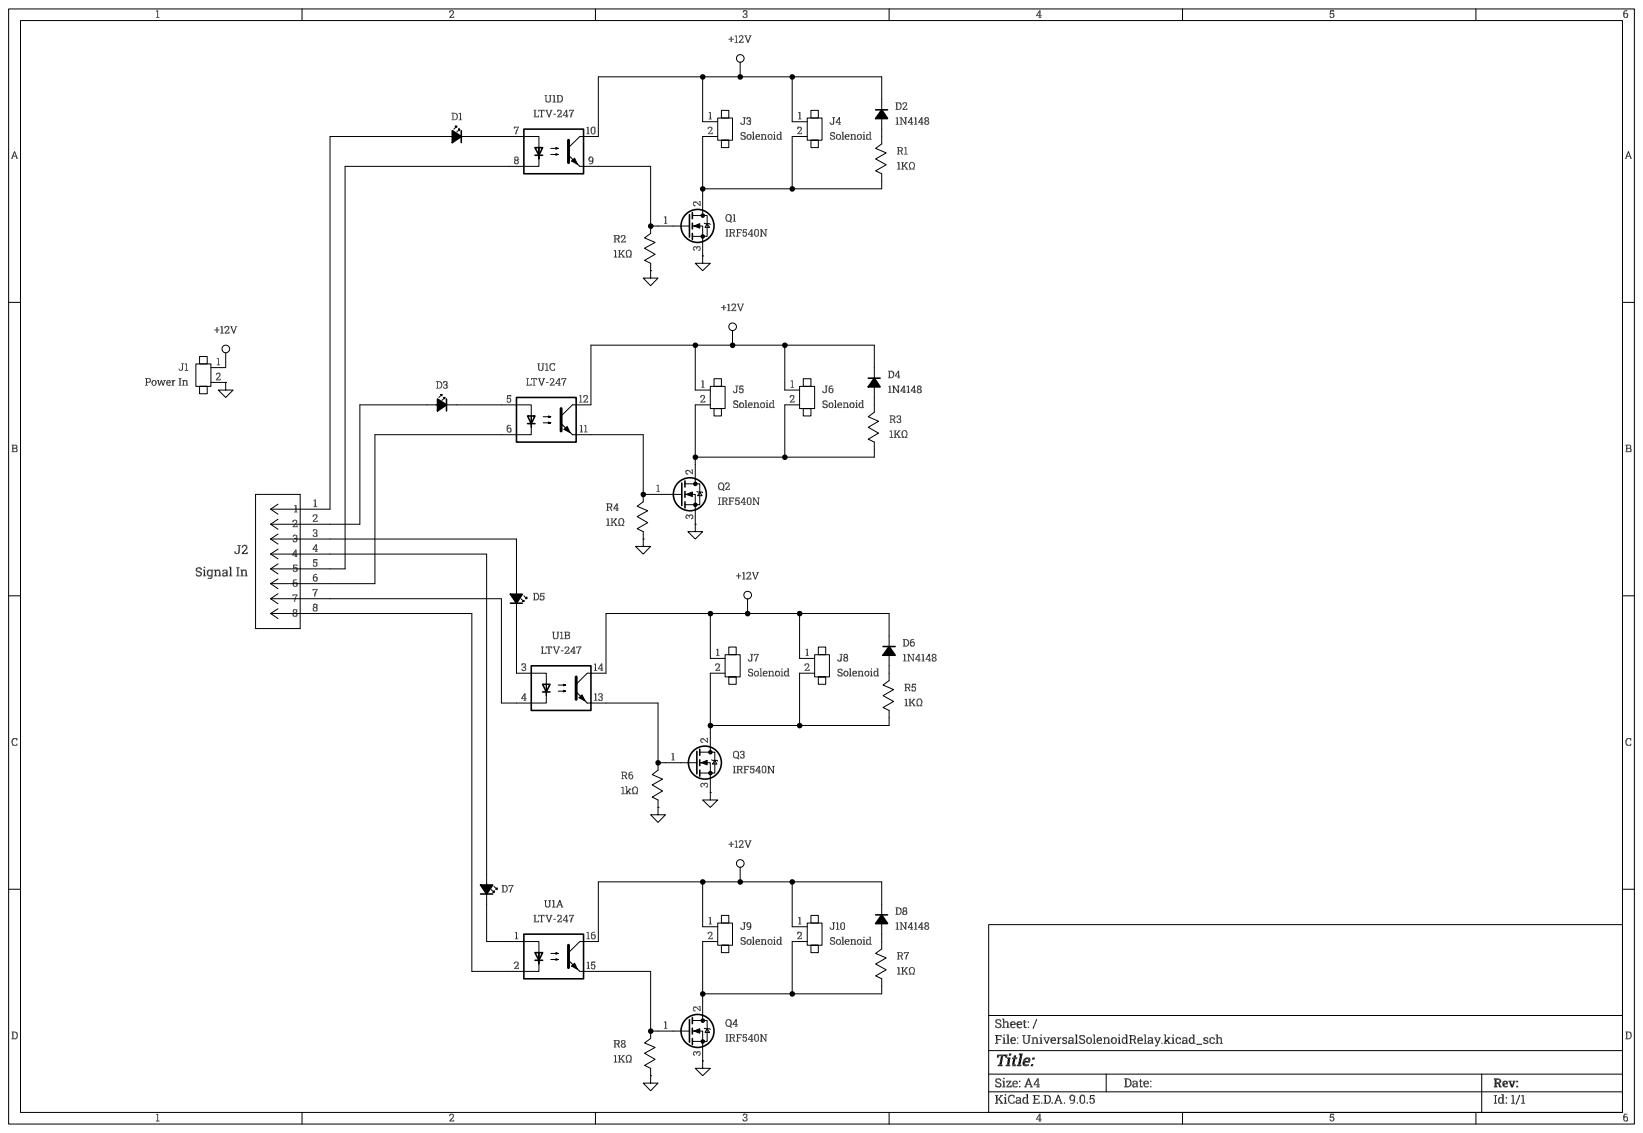
[picture p135: page 1]
