slacshan/MIDI-Projects/BassGuitar/Circuitry/S25/MotherBoard/MotherboardPCB.pdf

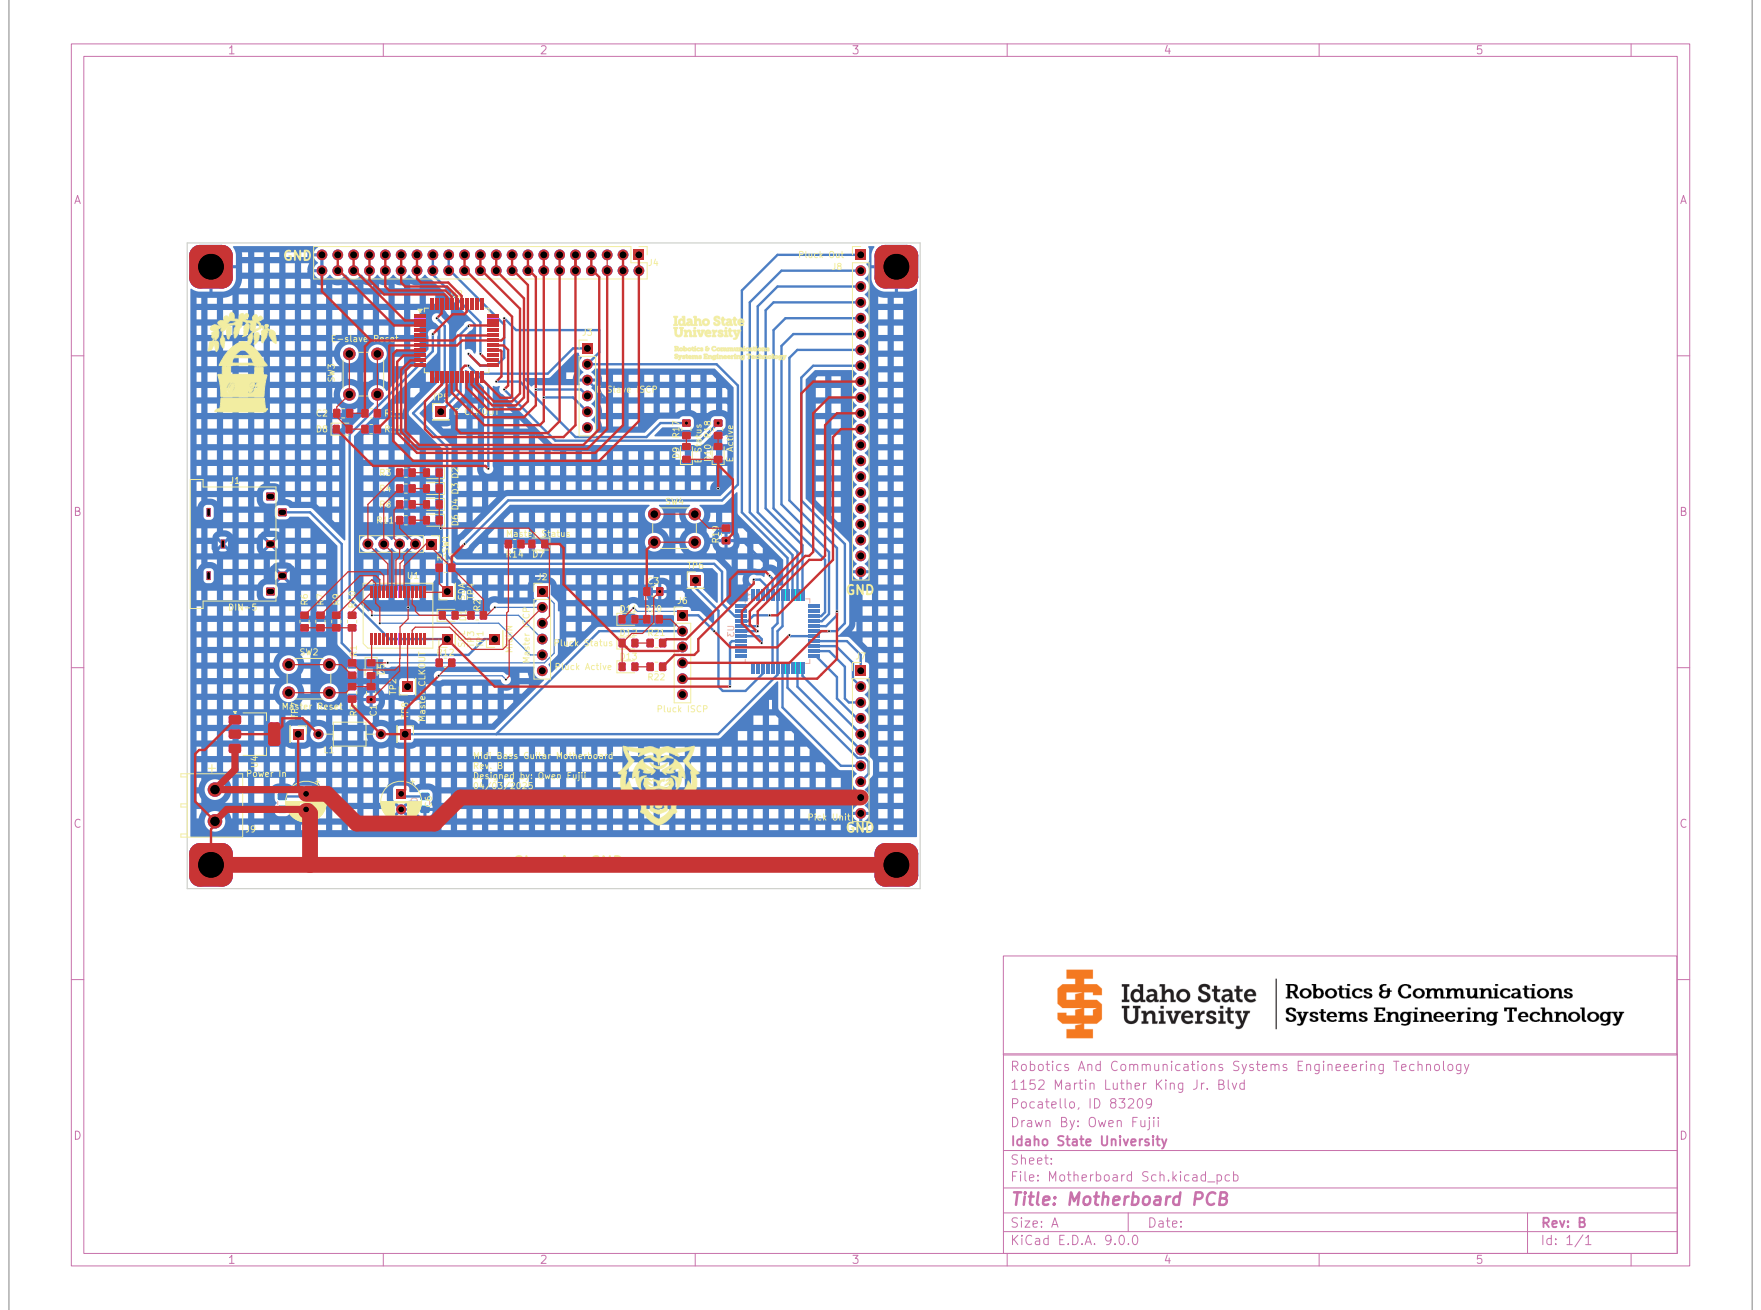
[picture p136: page 1]
