slacshan/MIDI-Projects/BassGuitar/Circuitry/S25/MotherBoard/MotherboardSch.pdf

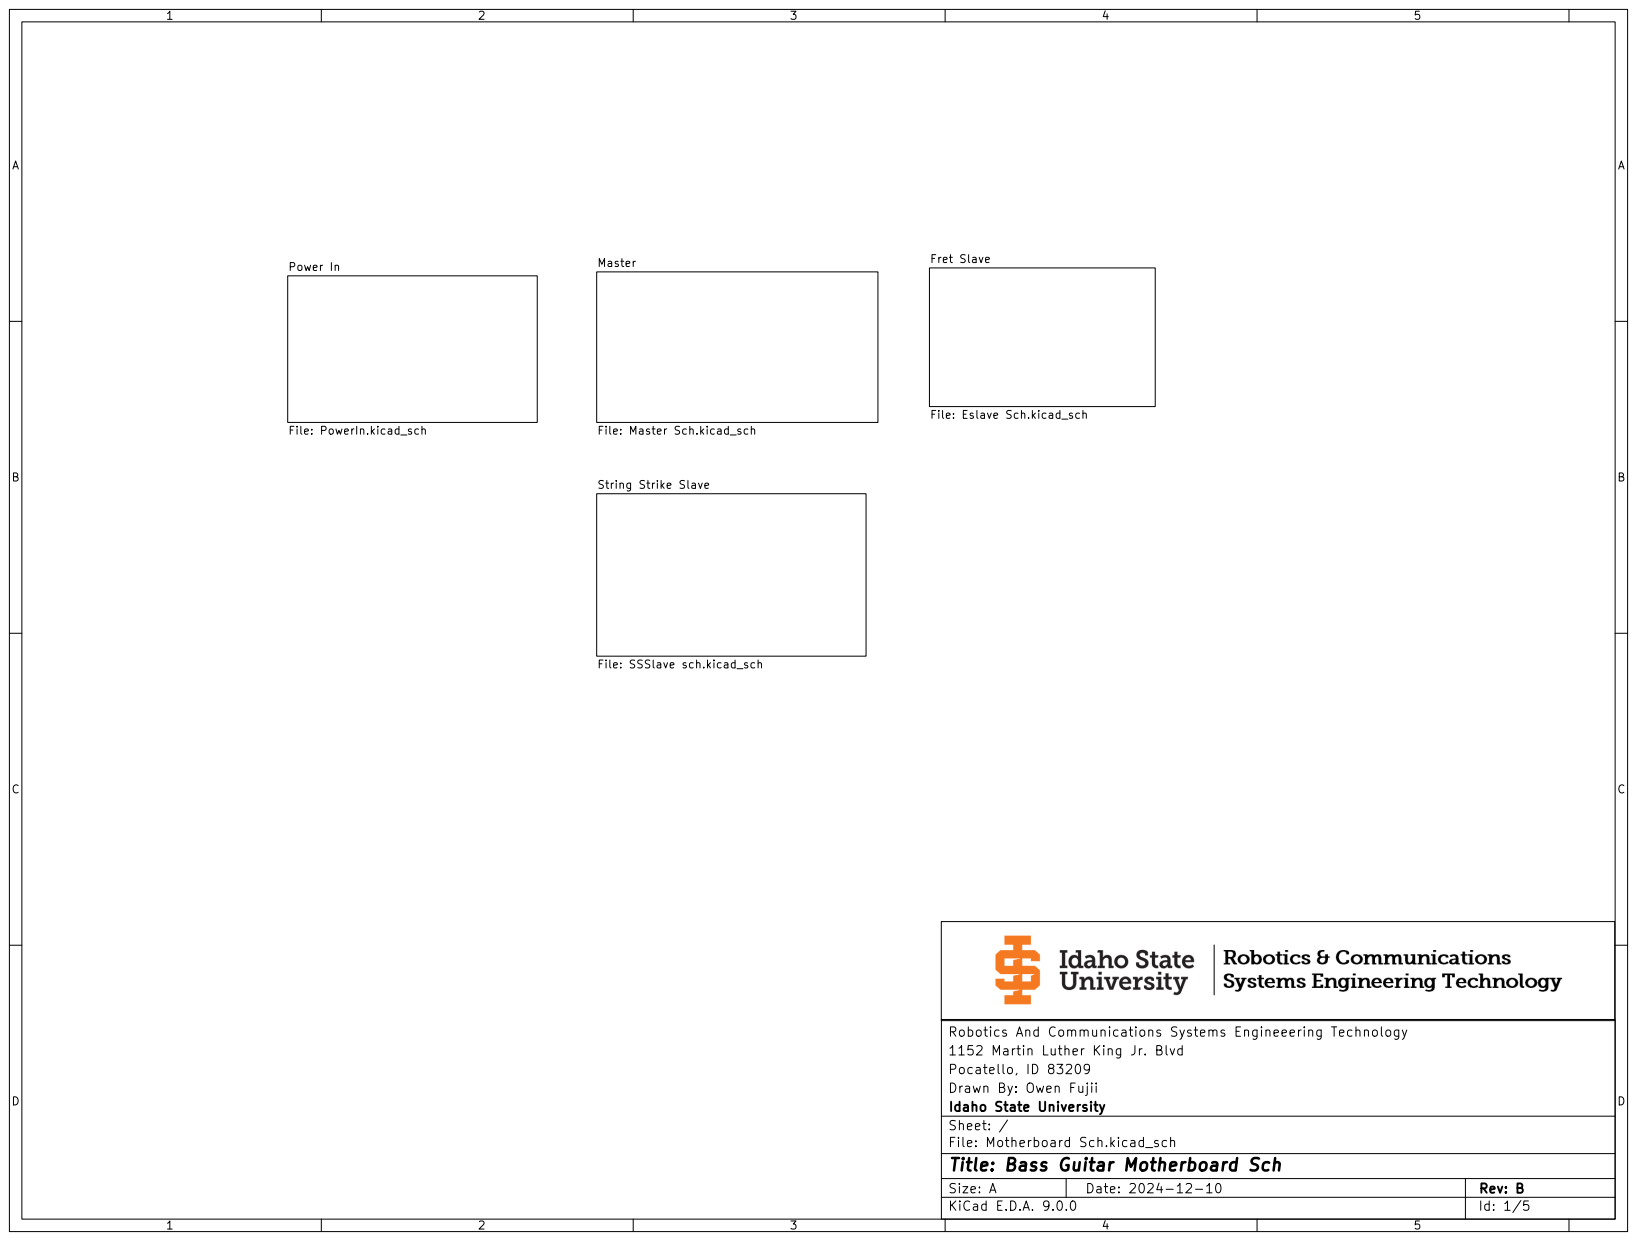
[picture p137: page 1]

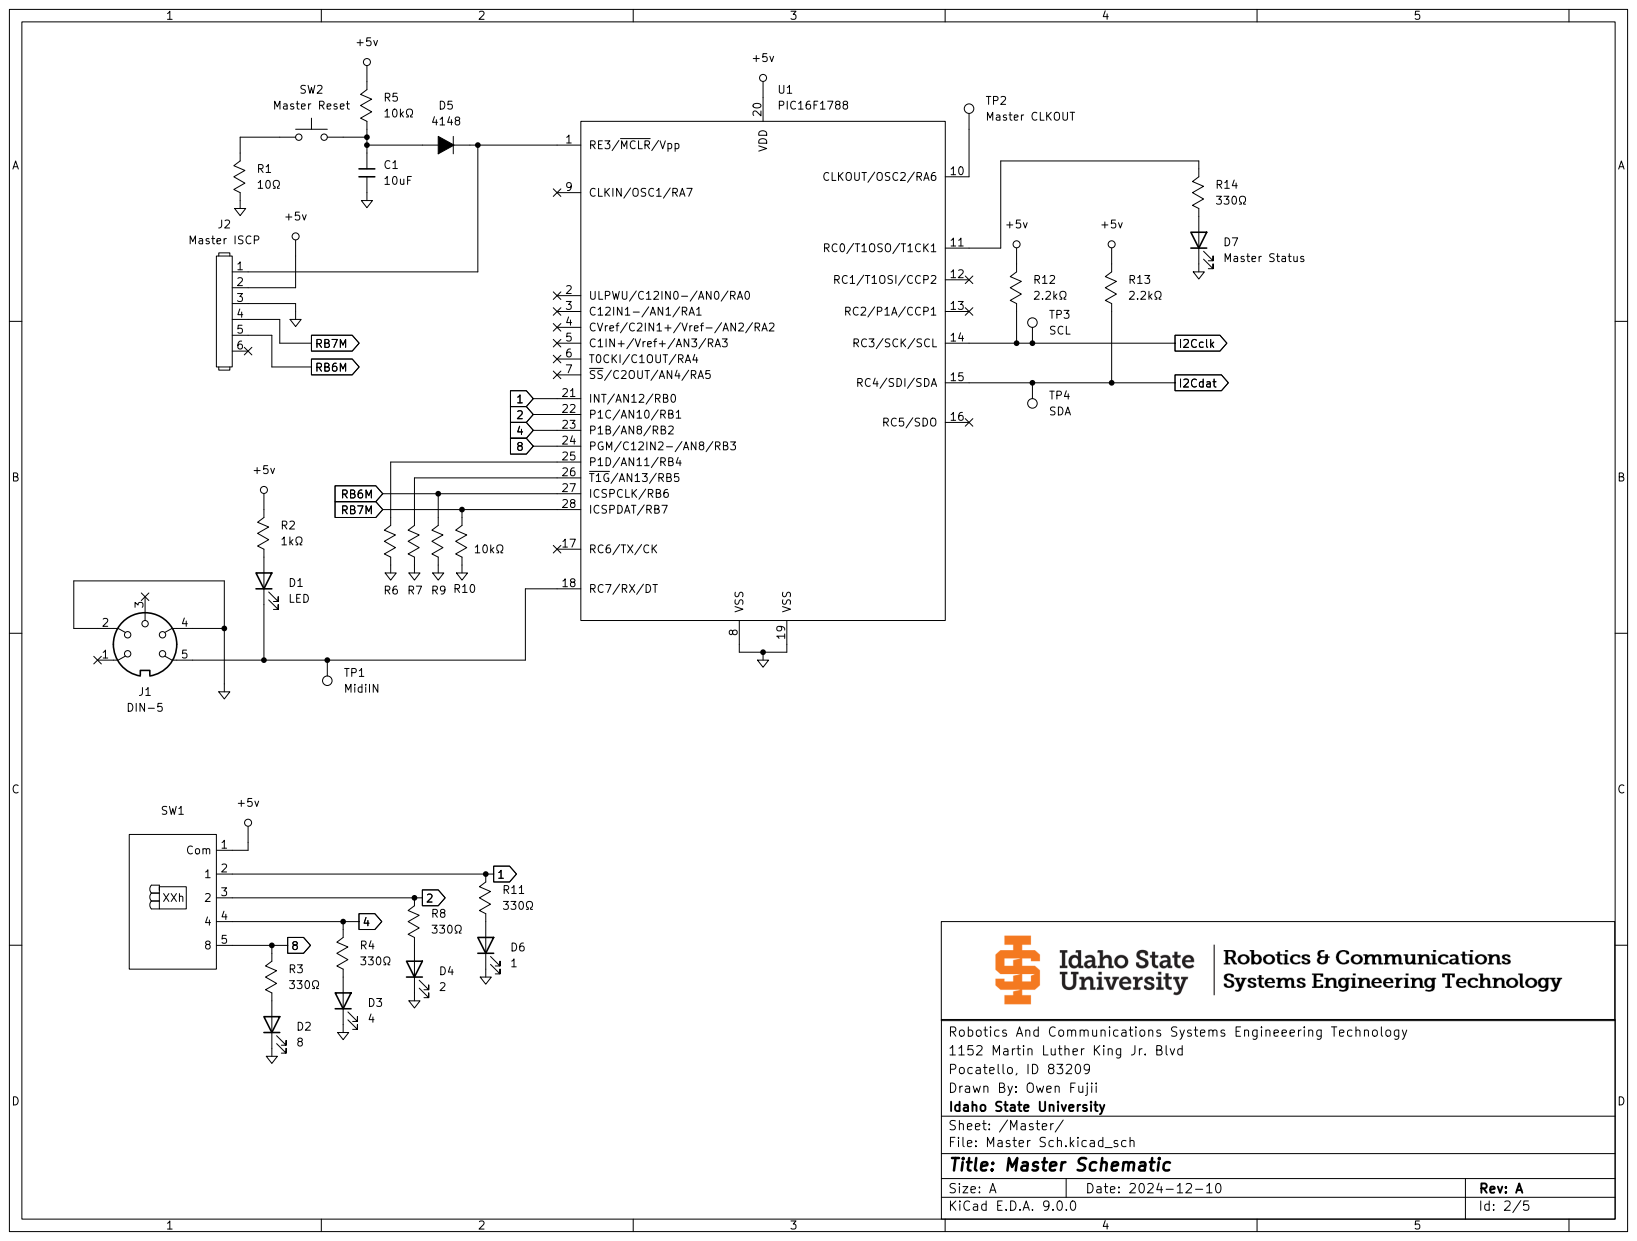
[picture p138: page 2]

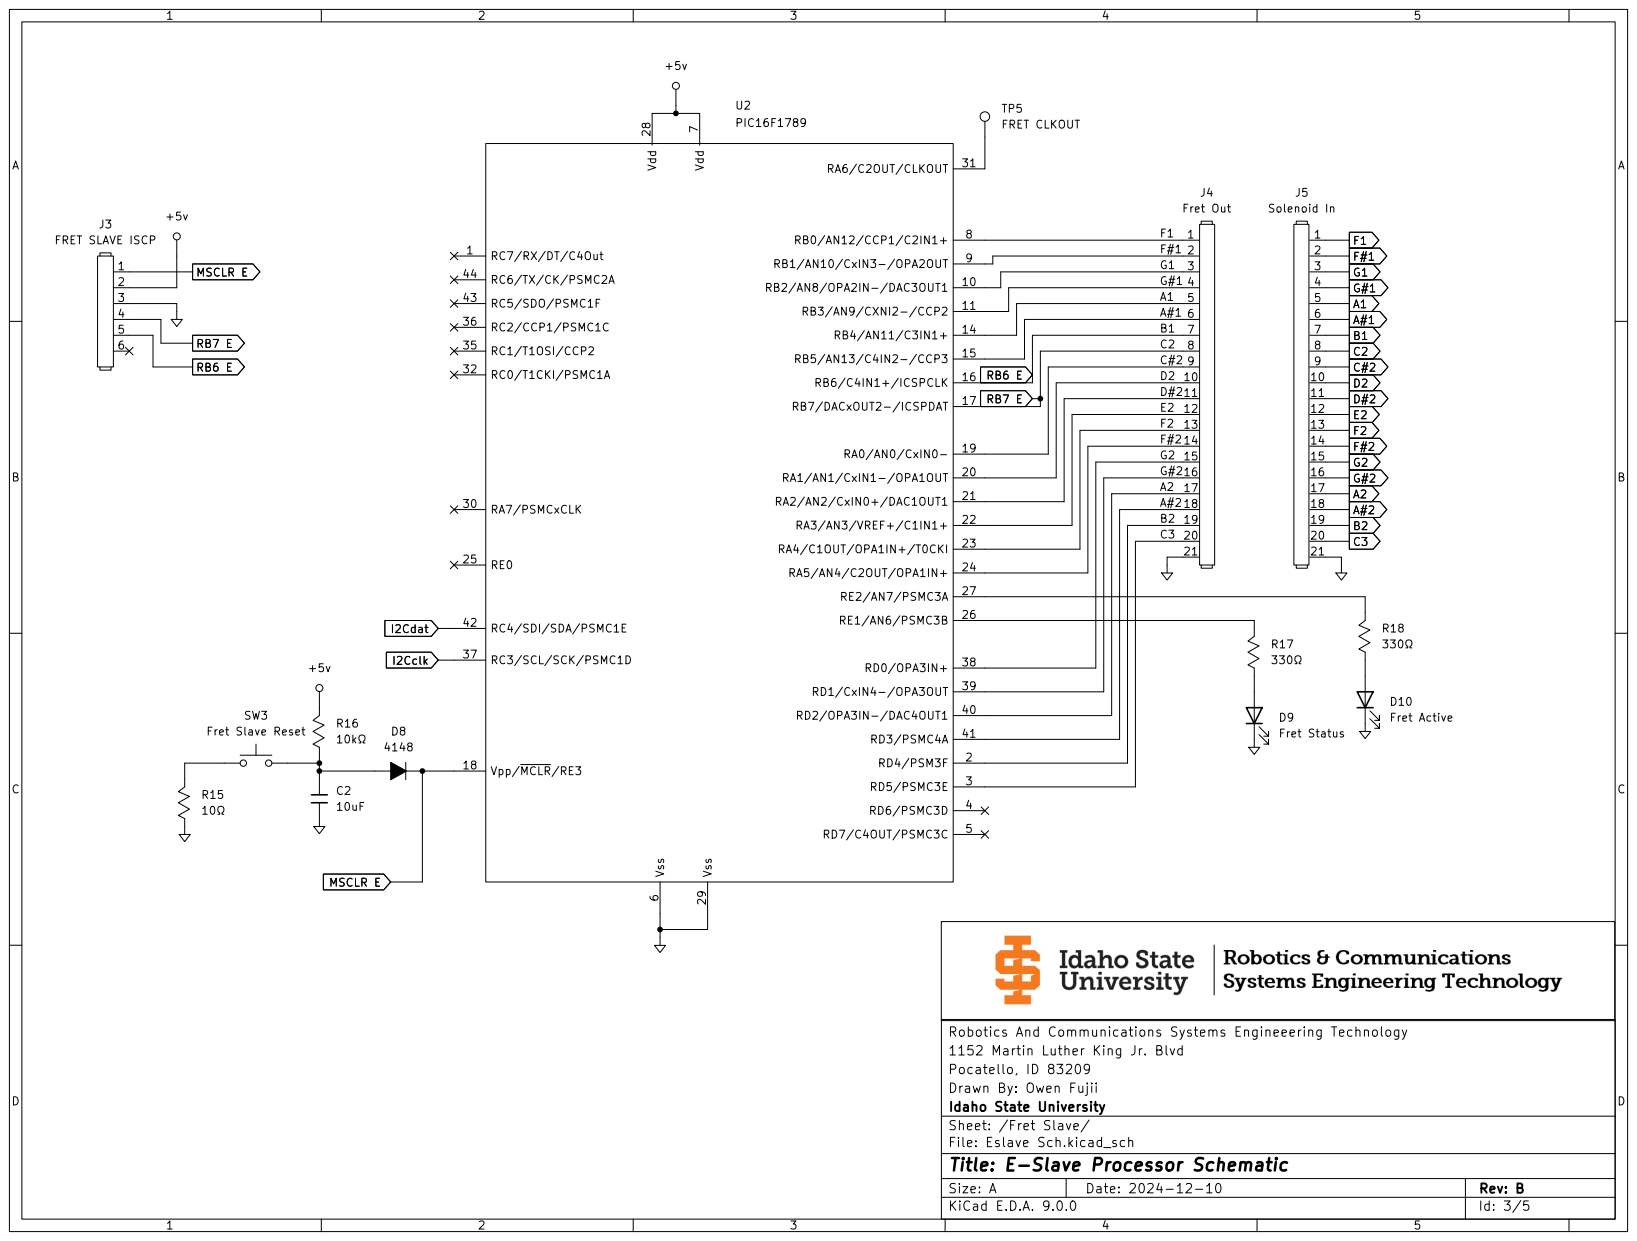
[picture p139: page 3]

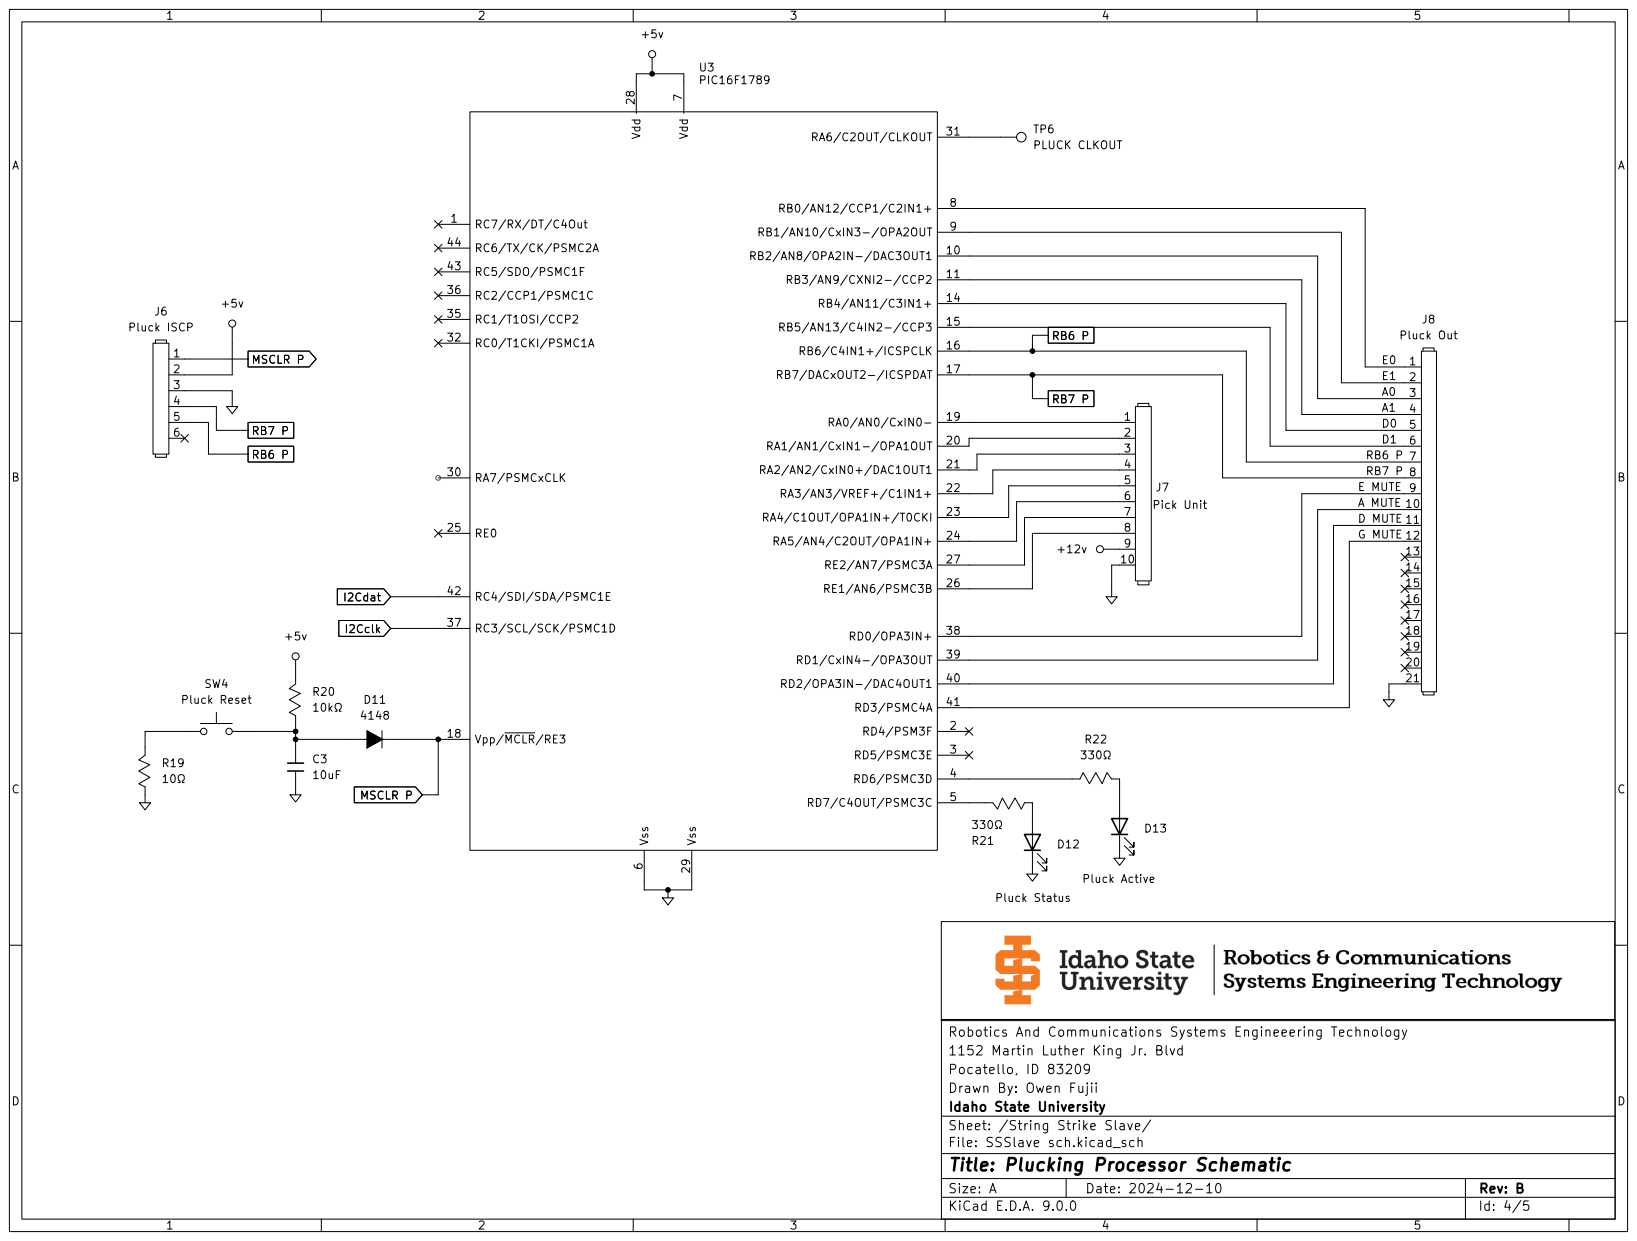
[picture p140: page 4]

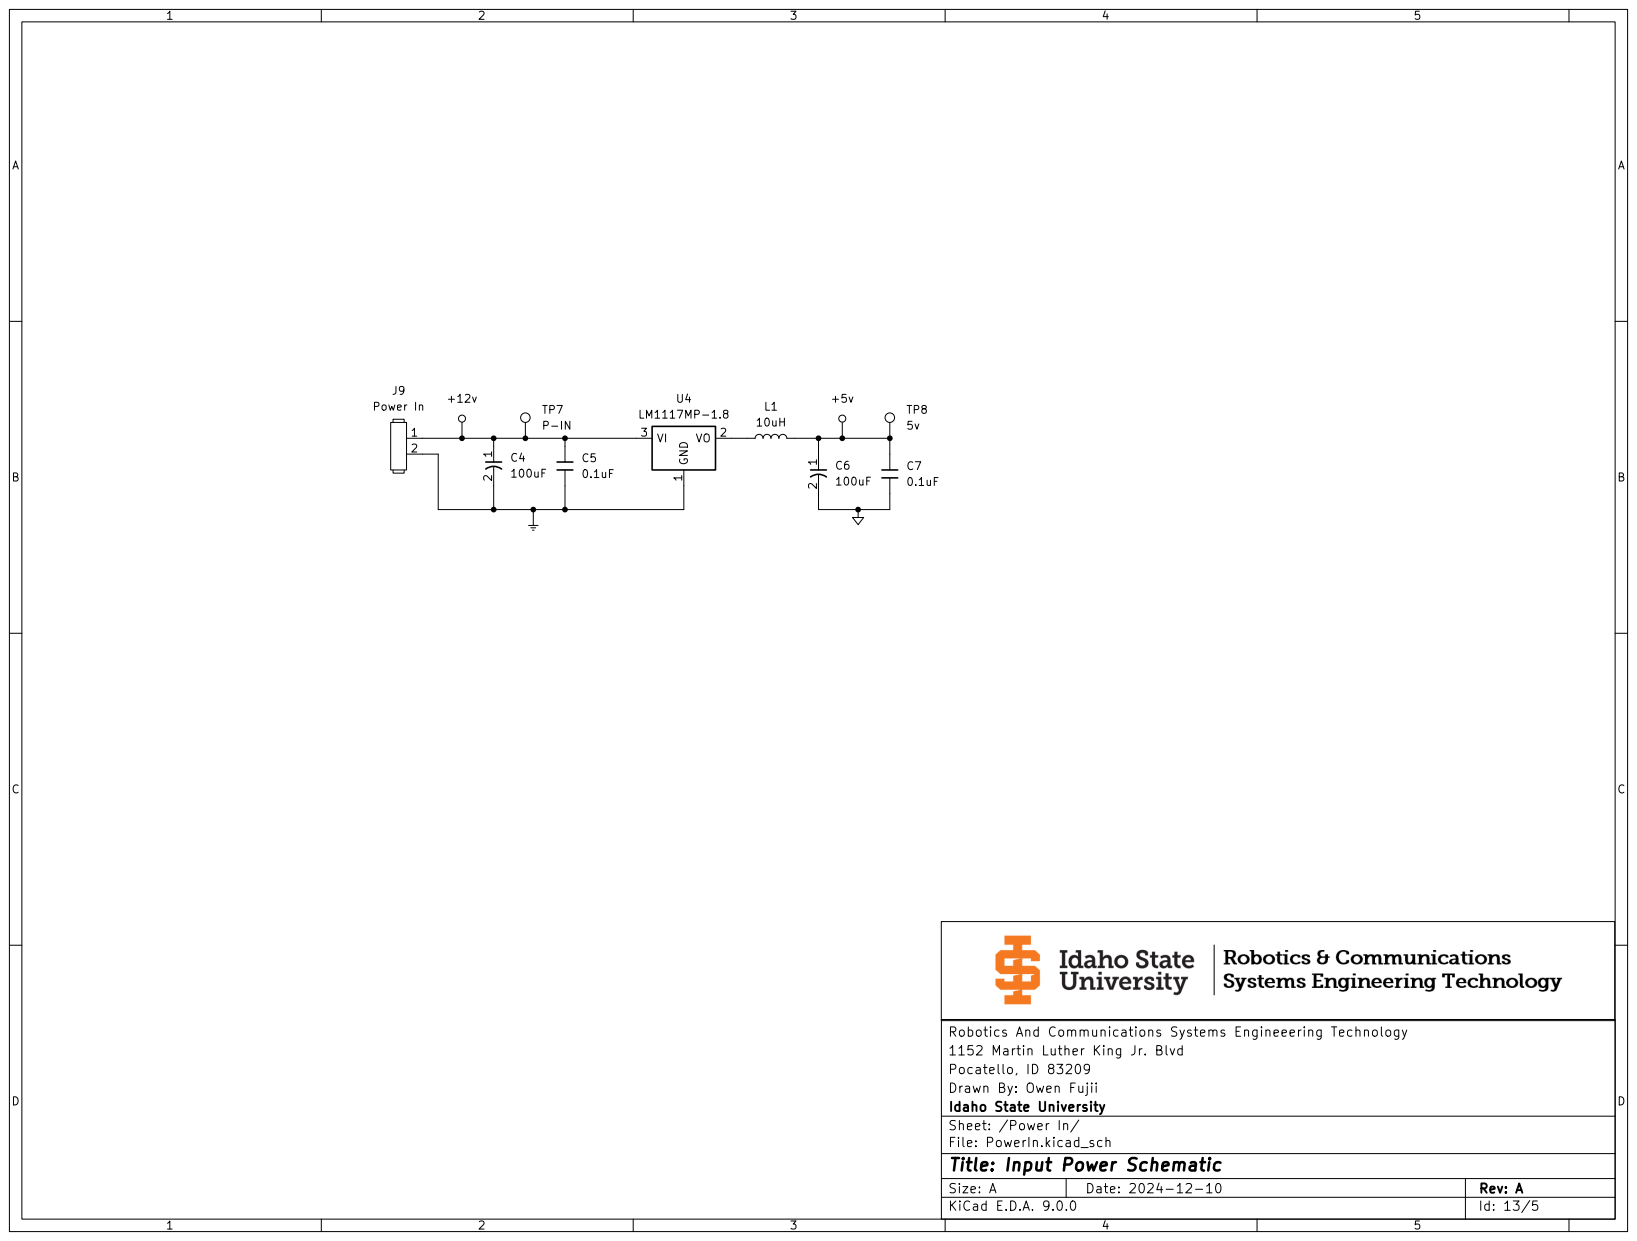
[picture p141: page 5]
