slacshan/MIDI-Projects/BassGuitar/CAD/F25/Fret/PDFs/NeckRest.pdf

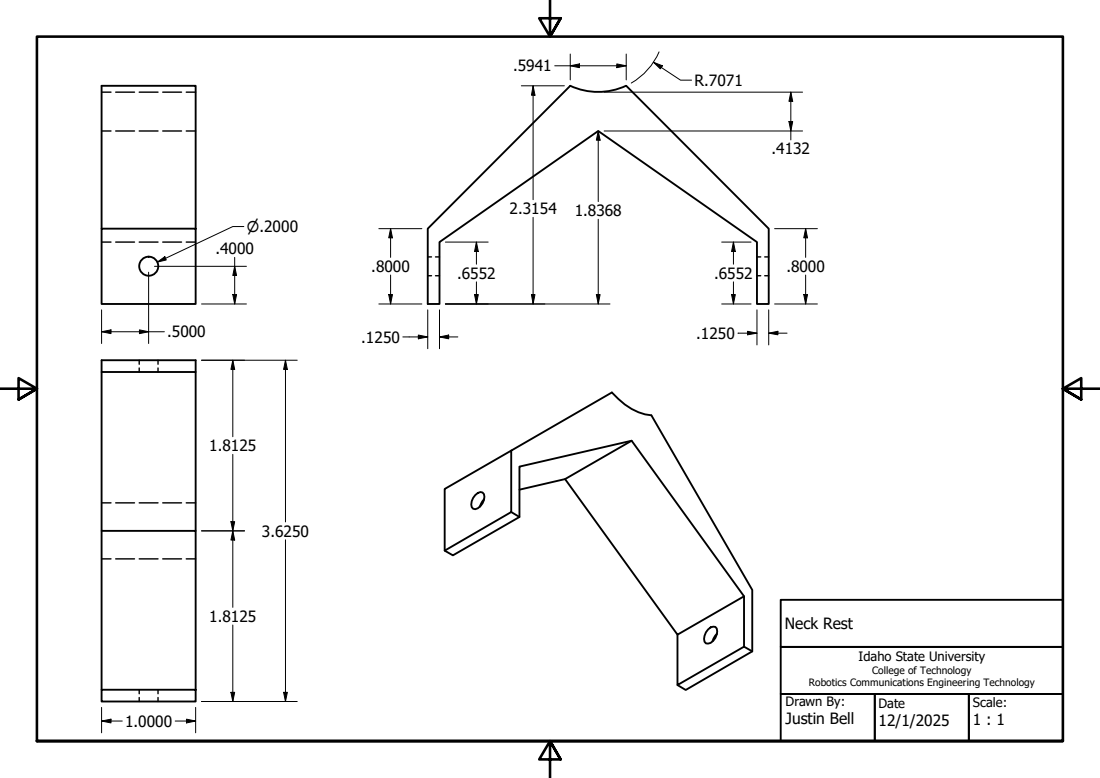
[picture p142: page 1]
Neck Rest

Idaho State University
College of Technology

Robotics Communications Engineering Technology
Drawn By:
Justin Bell
