slacshan/MIDI-Projects/Infrared/Rx/PDFs/IR_MIDI_Rx_Schematic_RevA.pdf

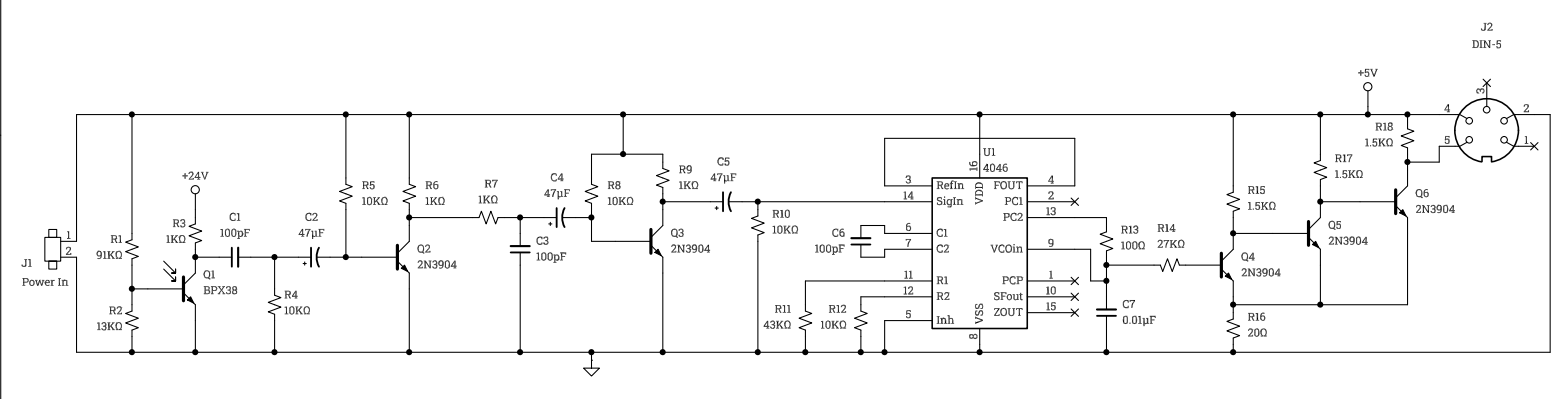
[picture p143: page 1]
