slacshan/MIDI-Projects/Infrared/Tx/PDFs/IR_MIDI_Tx_Schematic_RevA.pdf

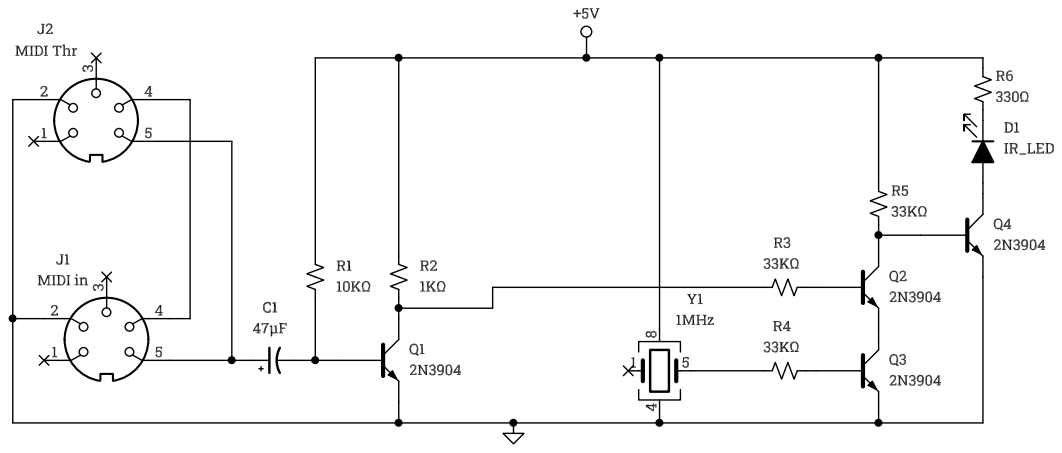
[picture p144: page 1]
