slacshan/MIDI-Projects/Infrared/Tx/PDFs/IR_MIDI_Tx_Schematic_RevB.pdf

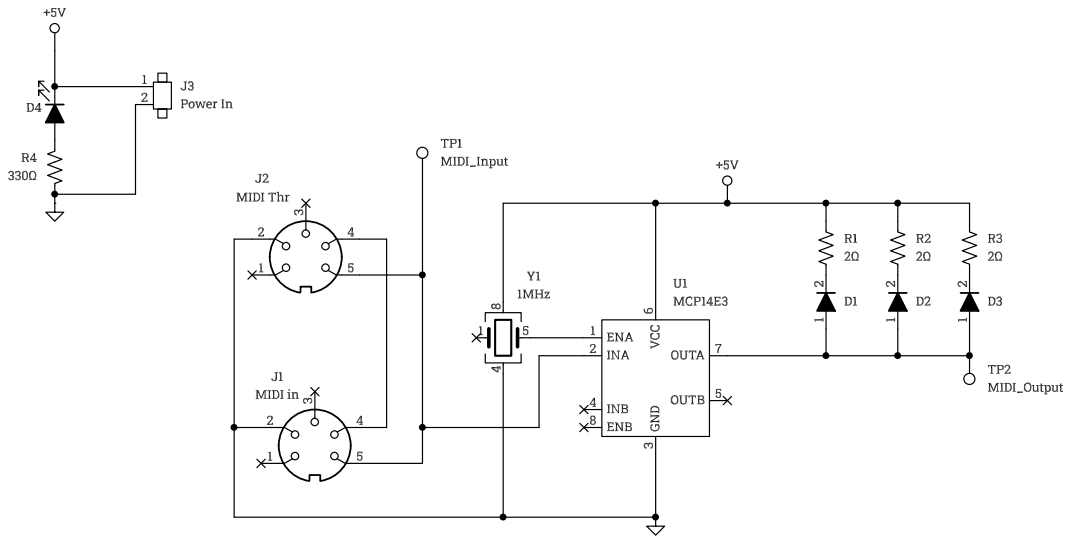
[picture p145: page 1]
