slacshan/MIDI-Projects/Universals/Slave/USlave.kicad_pcb

## KiCad design Universals/Slave/USlave.kicad_pcb (2025-12-18)

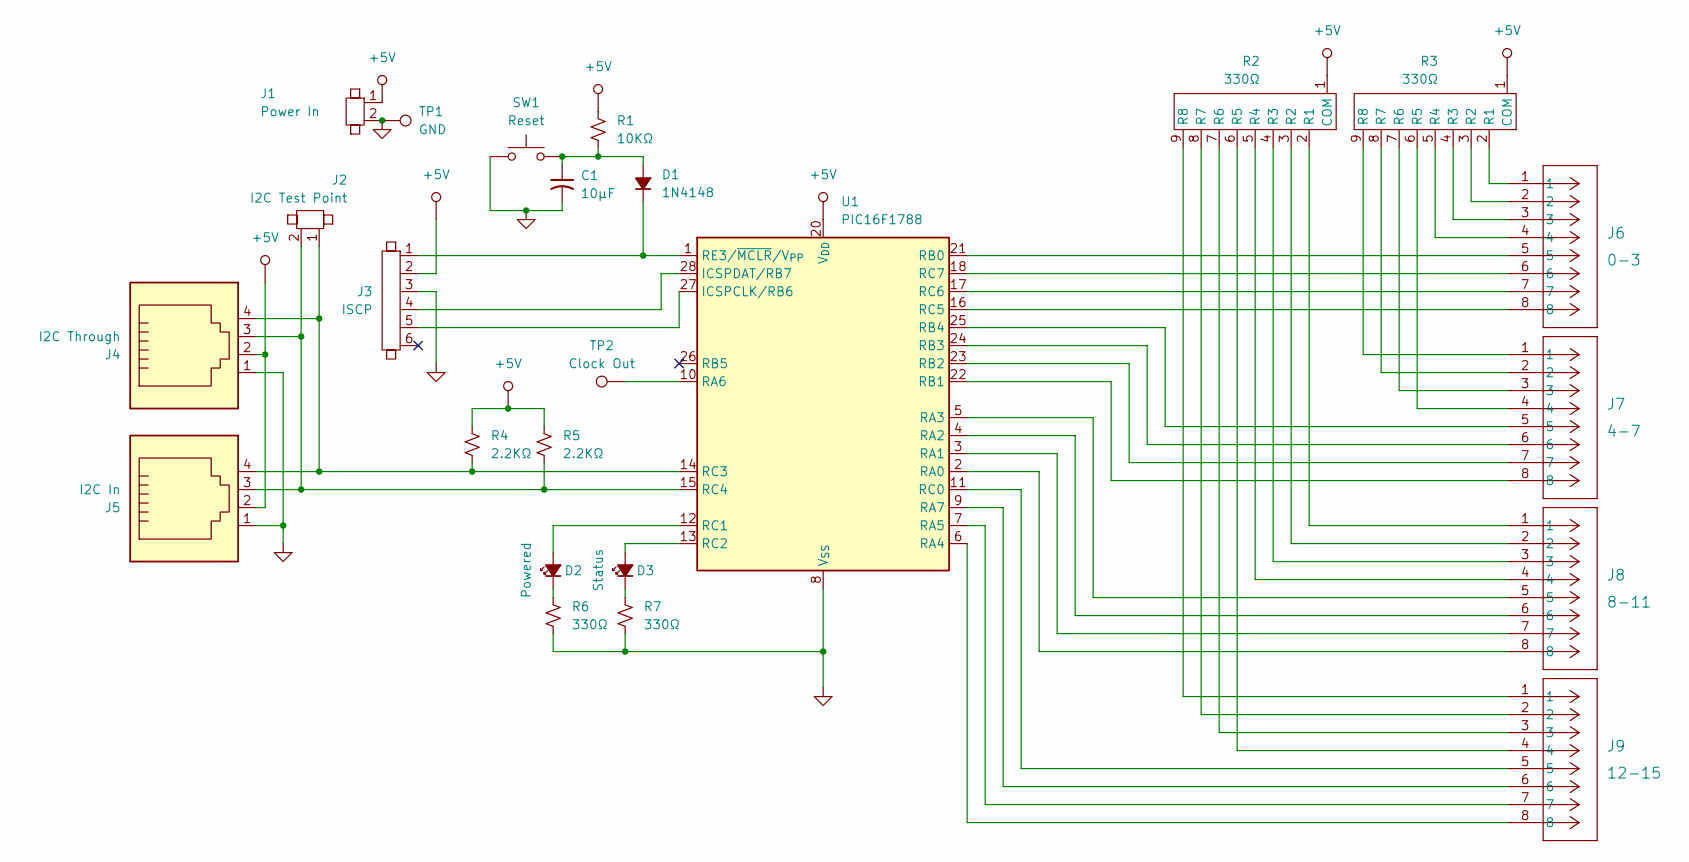
[picture p151: schematic USlave.kicad_sch]

Parts:
C1: 10µF; C_Radial_D6.3mm_H11.0mm_P2.50mm
D1: 1N4148; D_0805
D2: Powered; D_0805
D3: Status; D_0805
J1: Power In; 2PinMolex
J2: I2C Test Point; 1X2_100mil_Header
J3: ISCP; 1X6_100mil_Header
J4: I2C Through; RJ11
J5: I2C In; RJ11
J6: 0-3; 8PinMolex_3.00mmPitch
J7: 4-7; 8PinMolex_3.00mmPitch
J8: 8-11; 8PinMolex_3.00mmPitch
J9: 12-15; 8PinMolex_3.00mmPitch
R1: 10KΩ; C_0805
R2, R3: 330Ω; 1x9_100mil_Header
R4, R5: 2.2KΩ; C_0805
R6, R7: 330Ω; C_0805
SW1: Reset; SW_TH_Tactile_Omron_B3F-100x
TP1: GND; 1X1_100mil_Header
TP2: Clock Out; 1X1_100mil_Header
U1: PIC16F1788; QFN-28-1EP_6x6mm_P0.65mm_EP4.25x4.25mm

Connections:
GND: C1.2, J1.2, J3.3, J4.1, J5.1, R6.2, R7.2, SW1.1, TP1.1, U1.8 (V_{SS}), U1.19 (V_{SS})
unnamed: C1.1, D1.2 (A), R1.2, SW1.2
unnamed: D1.1 (K), J3.1, U1.1 (RE3/~MCLR/V_{PP})
unnamed: D2.2 (A), U1.12 (RC1)
unnamed: D2.1 (K), R6.1
unnamed: D3.2 (A), U1.13 (RC2)
unnamed: D3.1 (K), R7.1
unnamed: J8.1, R2.2 (R1)
unnamed: J8.2, R2.3 (R2)
unnamed: J8.3, R2.4 (R3)
unnamed: J8.4, R2.5 (R4)
unnamed: J9.4, R2.6 (R5)
unnamed: J9.3, R2.7 (R6)
unnamed: J9.2, R2.8 (R7)
unnamed: J9.1, R2.9 (R8)
unnamed: J6.1, R3.2 (R1)
unnamed: J6.2, R3.3 (R2)
unnamed: J6.3, R3.4 (R3)
unnamed: J6.4, R3.5 (R4)
unnamed: J7.4, R3.6 (R5)
unnamed: J7.3, R3.7 (R6)
unnamed: J7.2, R3.8 (R7)
unnamed: J7.1, R3.9 (R8)
unnamed: J3.5, U1.27 (ICSPCLK/RB6)
unnamed: J3.4, U1.28 (ICSPDAT/RB7)
unnamed: J8.8, U1.2 (RA0)
unnamed: J8.7, U1.3 (RA1)
unnamed: J8.6, U1.4 (RA2)
unnamed: J8.5, U1.5 (RA3)
unnamed: J9.8, U1.6 (RA4)
unnamed: J9.7, U1.7 (RA5)
unnamed: TP2.1, U1.10 (RA6)
unnamed: J9.6, U1.9 (RA7)
unnamed: J6.5, U1.21 (RB0)
unnamed: J7.8, U1.22 (RB1)
unnamed: J7.7, U1.23 (RB2)
unnamed: J7.6, U1.24 (RB3)
unnamed: J7.5, U1.25 (RB4)
unnamed: J9.5, U1.11 (RC0)
unnamed: J2.1, J4.4, J5.4, R4.2, U1.14 (RC3)
unnamed: J2.2, J4.3, J5.3, R5.2, U1.15 (RC4)
unnamed: J6.8, U1.16 (RC5)
unnamed: J6.7, U1.17 (RC6)
unnamed: J6.6, U1.18 (RC7)

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
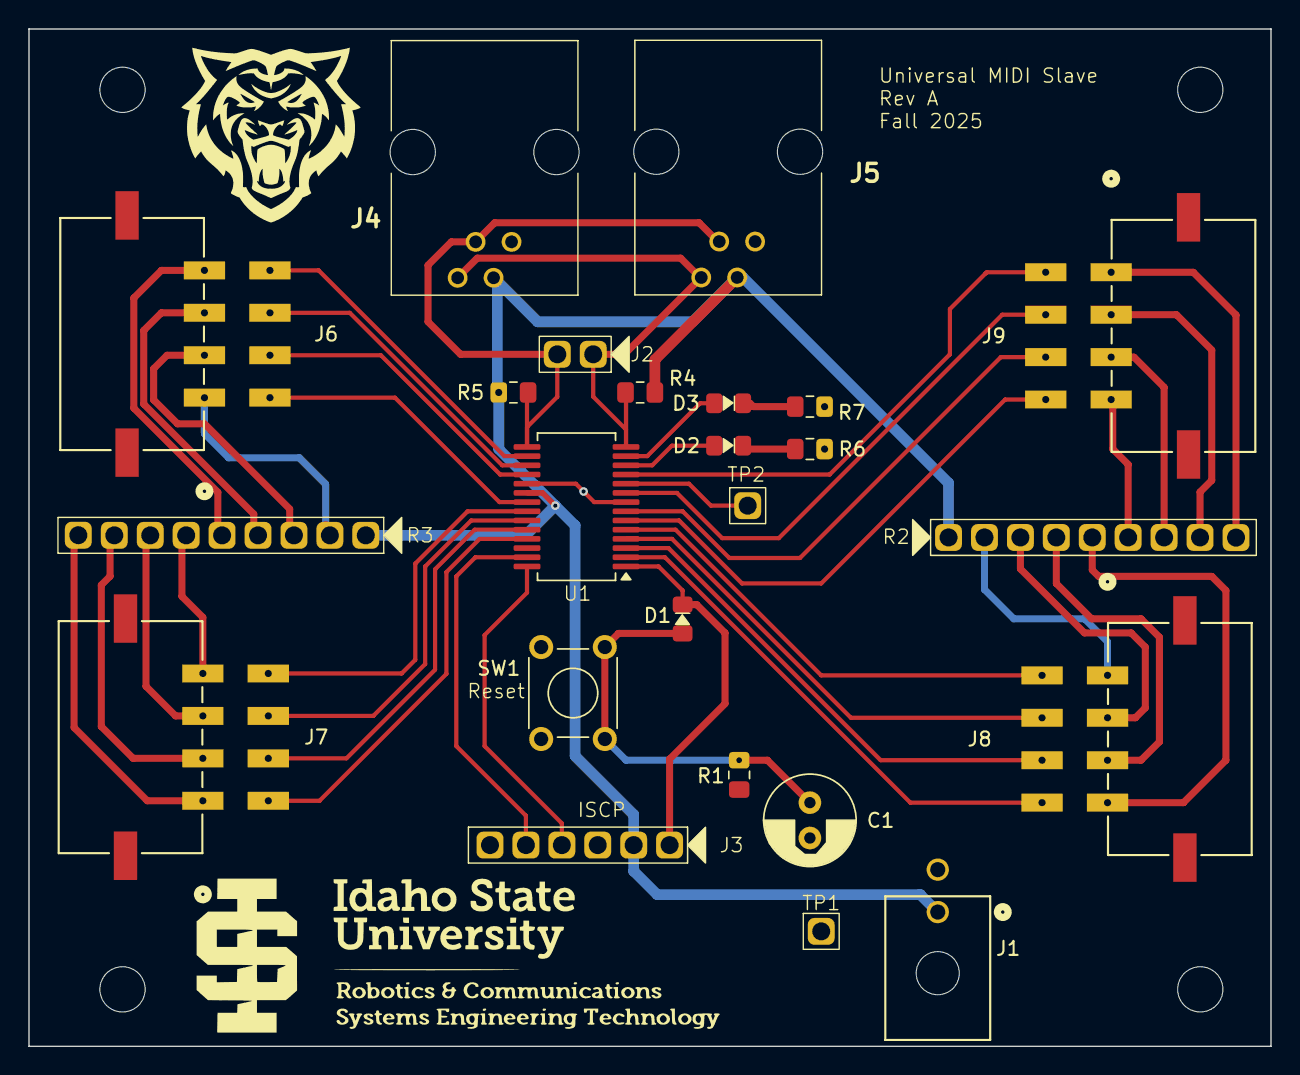
[picture p152: board USlave.kicad_pcb from above]

Board: 2 copper layers, 87.8 x 71.9 mm, 24 parts (0 on the bottom side), 45 nets.
