slacshan/MIDI-Projects/Infrared/Tx/Tx.kicad_pcb

## KiCad design Infrared/Tx/Tx.kicad_pcb (2025-12-18)

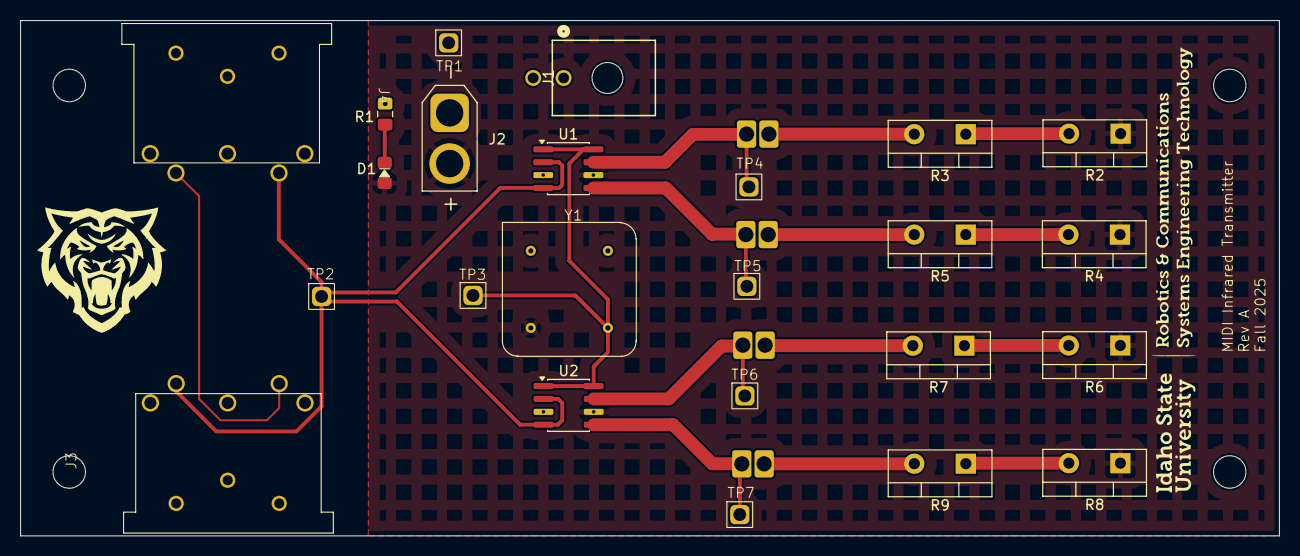
[picture p153: board Tx.kicad_pcb from above]

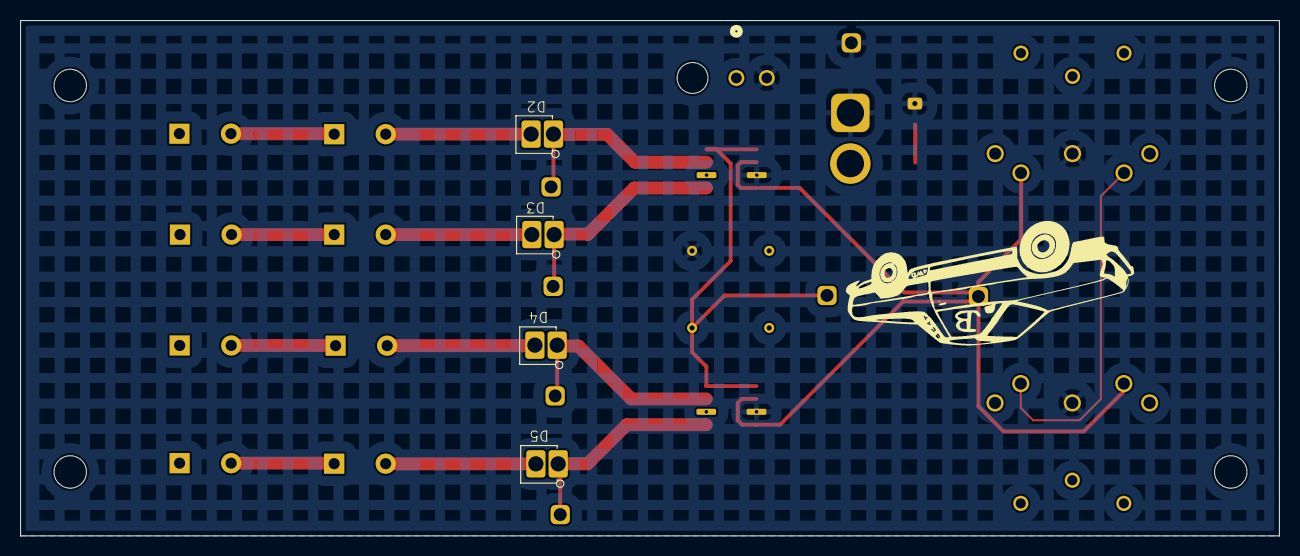
[picture p154: board Tx.kicad_pcb from below]

Board: 2 copper layers, 124.1 x 50.8 mm, 28 parts (4 on the bottom side), 18 nets.

Parts:
D1: LED_Filled; D_0805
D2, D3, D4, D5: D_Filled; Fat_2Pin_D
J1: FanPower; 2PinMolex
J2: Power In; AMASS_XT30U-F_1x02_P5.0mm_Vertical
J3: MIDI Thr; DIN-5PIN_MIDI
J4: MIDI in; DIN-5PIN_MIDI
R1: 330Ω; C_0805
R2, R3, R4, R5, R6, R7, R8, R9: 2Ω; TO-220-2_Vertical
TP1: GND; 1X1_100mil_Header
TP2: MIDI_Input; 1X1_100mil_Header
TP3: 1MHzTP; 1X1_100mil_Header
TP4: IR1; 1X1_100mil_Header
TP5: IR2; 1X1_100mil_Header
TP6: IR3; 1X1_100mil_Header
TP7: IR4; 1X1_100mil_Header
U1, U2: MCP14E3; SOIC-8_3.9x4.9mm_P1.27mm
Y1: 1MHz; 300x300Mil_4Pin_Y

Connections:
GND: J1.2, J2.1, J3.2, J4.2, R1.2, TP1.1, U1.3 (GND), U2.3 (GND), Y1.4
unnamed: D1.1 (K), R1.1
unnamed: D2.1 (A), R3.2
unnamed: D2.2 (K), TP4.1, U1.7 (~OUTA)
unnamed: D3.1 (A), R5.2
unnamed: D3.2 (K), TP5.1, U1.5 (~OUTB)
unnamed: D4.1 (A), R7.2
unnamed: D4.2 (K), TP6.1, U2.7 (~OUTA)
unnamed: D5.1 (A), R9.2
unnamed: D5.2 (K), TP7.1, U2.5 (~OUTB)
unnamed: J3.4, J4.4
unnamed: R2.2, R3.1
unnamed: R4.2, R5.1
unnamed: R6.2, R7.1
unnamed: R8.2, R9.1
unnamed: TP3.1, U1.1 (ENA), U1.8 (ENB), U2.1 (ENA), U2.8 (ENB), Y1.5
unnamed: J3.5, J4.5, TP2.1, U1.2 (INA), U1.4 (INB), U2.2 (INA), U2.4 (INB)
unnamed: D1.2 (A), J2.2, R2.1, R4.1, R6.1, R8.1, U1.6 (VCC), U2.6 (VCC), Y1.8
