slacshan/MIDI-Projects/BassGuitar/Circuitry/S25/SolenoidBreakoutBoard/Solenoid Breakout Board.kicad_pcb

## KiCad design BassGuitar/Circuitry/S25/SolenoidBreakoutBoard/Solenoid Breakout Board.kicad_pcb (2025-11-19)

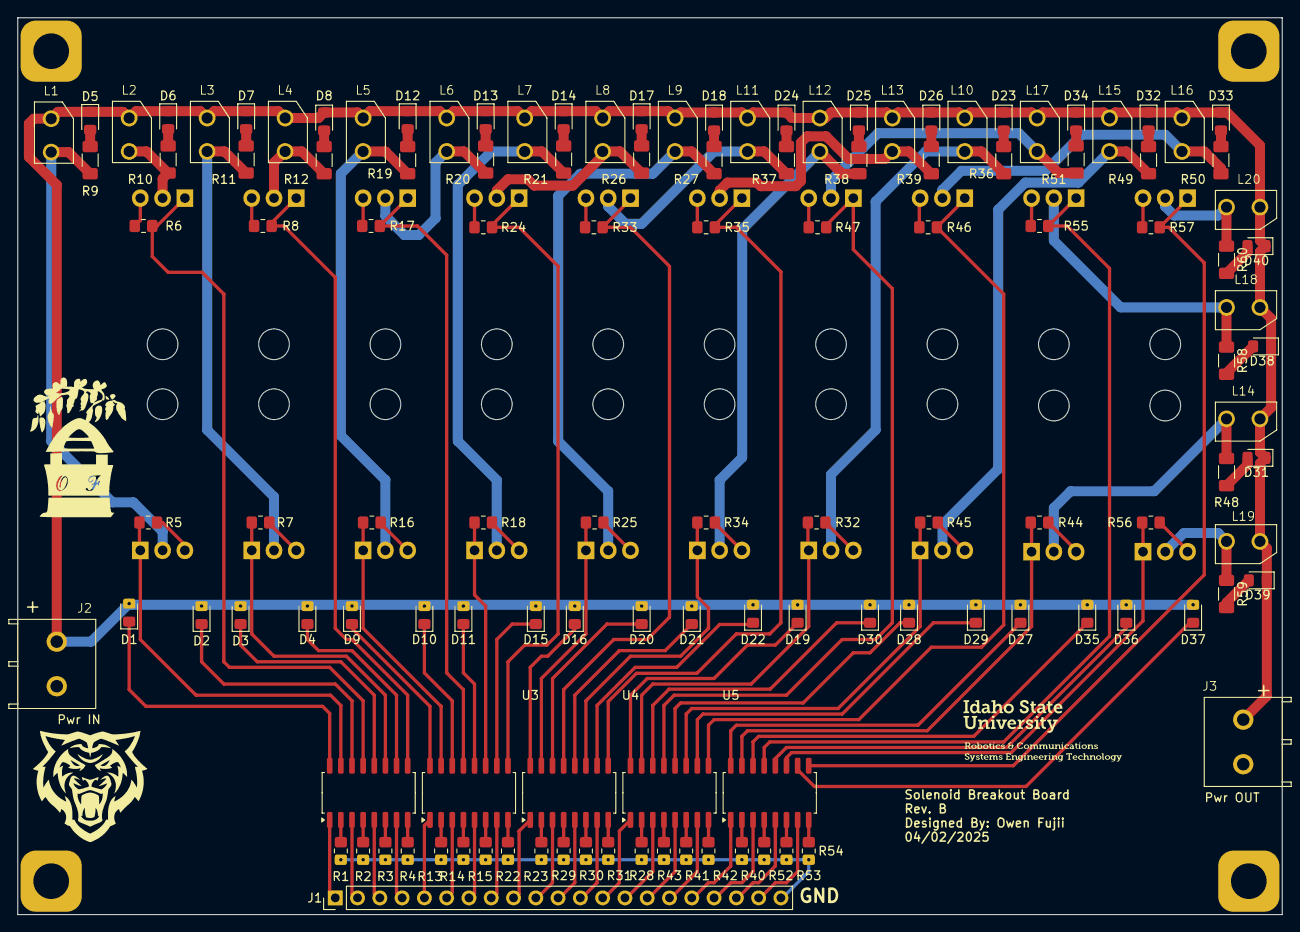
[picture p155: board Solenoid Breakout Board.kicad_pcb from above]

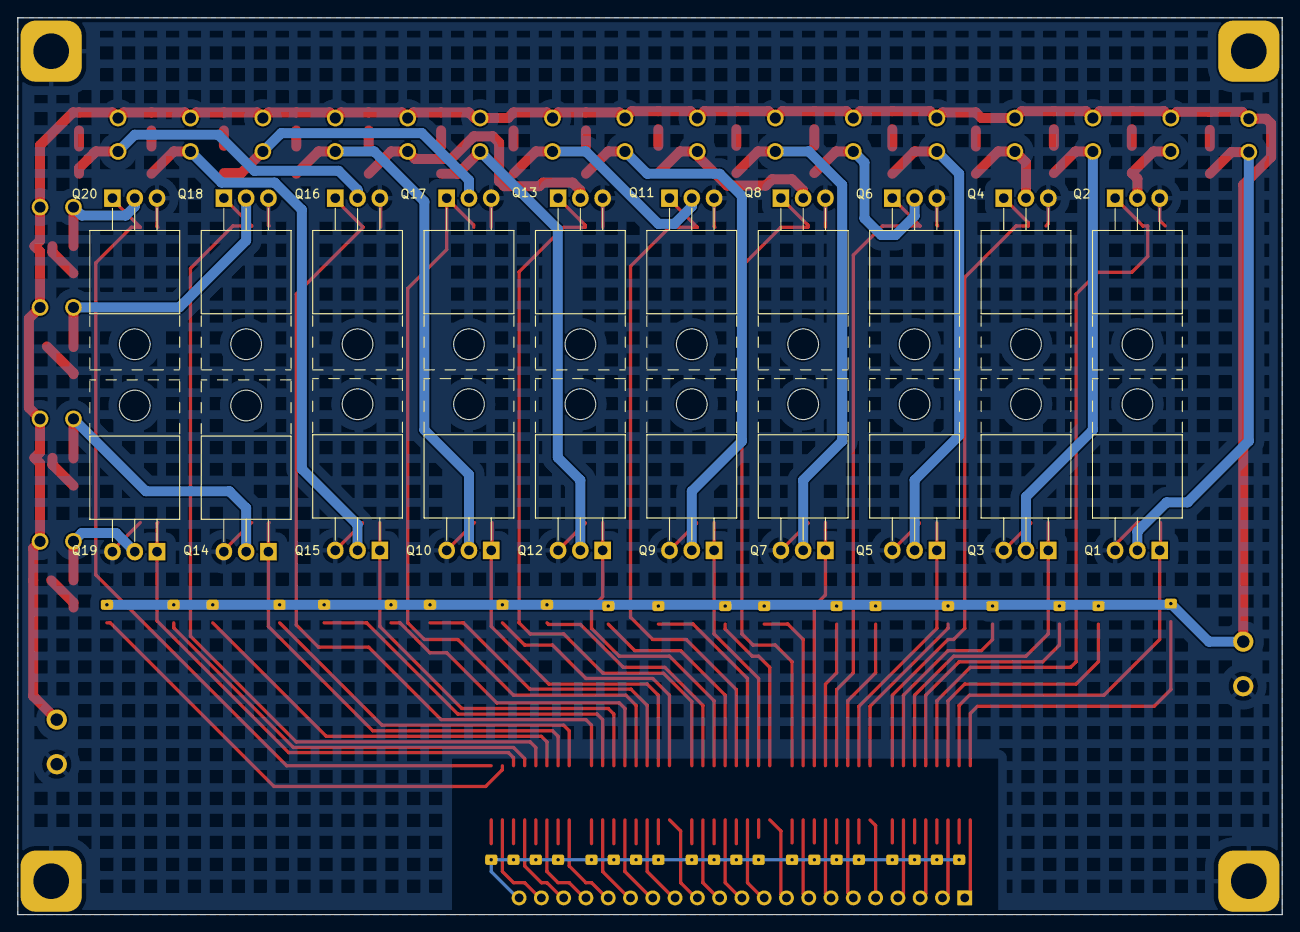
[picture p156: board Solenoid Breakout Board.kicad_pcb from below]

Board: 2 copper layers, 144.1 x 102.2 mm, 148 parts (20 on the bottom side), 123 nets.

Parts:
D1, D2, D3, D4, D9, D10, D11, D15, D16, D19, D20, D21, D22, D27, D28, D29, D30, D35, D36, D37: LED; LED_0805_2012Metric_Pad1.15x1.40mm_HandSolder
D5, D6, D7, D8, D12, D13, D14, D17, D18, D23, D24, D25, D26, D31, D32, D33, D34, D38, D39, D40: 1N4148; LED_0805_2012Metric_Pad1.15x1.40mm_HandSolder
J1: Solenoid In; PinHeader_1x21_P2.54mm_Vertical
J2: Pwr IN; Two_Pin_Screw_Terminal
J3: Pwr OUT; Two_Pin_Screw_Terminal
L1, L2, L3, L4, L5, L6, L7, L8, L9, L10, L11, L12, L13, L14, L15, L16, L17, L18, L19, L20: Solenoid; Small Expanded TH
Q1, Q2, Q3, Q4, Q5, Q6, Q7, Q8, Q9, Q10, Q11, Q12, Q13, Q14, Q15, Q16, Q17, Q18, Q19, Q20: IRF540N; TO-220-3_Horizontal_TabUp
R1, R2, R3, R4, R5, R6, R7, R8, R13, R14, R15, R16, R17, R18, R22, R23, R24, R25, R28, R29, R30, R31, R32, R33, R34, R35, R40, R41, R42, R43, R44, R45, R46, R47, R52, R53, R54, R55, R56, R57: 1kΩ; R_0805_2012Metric_Pad1.20x1.40mm_HandSolder
R9, R10, R11, R12, R19, R20, R21, R26, R27, R36, R37, R38, R39, R48, R49, R50, R51, R58, R59, R60: 1kΩ-P; R_1206_3216Metric_Pad1.30x1.75mm_HandSolder
U1, U2, U3, U4, U5: LTV-247; SOP-16_4.4x10.4mm_P1.27mm

Connections:
+12v: D1.2 (A), D2.2 (A), D3.2 (A), D4.2 (A), D5.1 (K), D6.1 (K), D7.1 (K), D8.1 (K), D9.2 (A), D10.2 (A), D11.2 (A), D12.1 (K), D13.1 (K), D14.1 (K), D15.2 (A), D16.2 (A), D17.1 (K), D18.1 (K), D19.2 (A), D20.2 (A), D21.2 (A), D22.2 (A), D23.1 (K), D24.1 (K), D25.1 (K), D26.1 (K), D27.2 (A), D28.2 (A), D29.2 (A), D30.2 (A), D31.1 (K), D32.1 (K), D33.1 (K), D34.1 (K), D35.2 (A), D36.2 (A), D37.2 (A), D38.1 (K), D39.1 (K), D40.1 (K), J2.1, J3.2, L1.1, L2.1, L3.1, L4.1, L5.1, L6.1, L7.1, L8.1, L9.1, L10.1, L11.1, L12.1, L13.1, L14.1, L15.1, L16.1, L17.1, L18.1, L19.1, L20.1
A1: J1.5, U2.1
A2: J1.17, U5.1
A#1: J1.6, U2.3
A#2: J1.18, U5.3
B1: J1.7, U2.5
B2: J1.19, U5.5
C2: J1.8, U2.7
C3: J1.20, U5.7
C#2: J1.9, U3.1
Chassis_GND: J2.2, J3.1, Q1.3 (S), Q2.3 (S), Q3.3 (S), Q4.3 (S), Q5.3 (S), Q6.3 (S), Q7.3 (S), Q8.3 (S), Q9.3 (S), Q10.3 (S), Q11.3 (S), Q12.3 (S), Q13.3 (S), Q14.3 (S), Q15.3 (S), Q16.3 (S), Q17.3 (S), Q18.3 (S), Q19.3 (S), Q20.3 (S), R5.1, R6.1, R7.1, R8.1, R16.1, R17.1, R18.1, R24.1, R25.1, R32.1, R33.1, R34.1, R35.1, R44.1, R45.1, R46.1, R47.1, R55.1, R56.1, R57.1
D2: J1.10, U3.3
D#2: J1.11, U3.5
E2: J1.12, U3.7
F1: J1.1, U1.1
F2: J1.13, U4.1
F#1: J1.2, U1.3
F#2: J1.14, U4.3
G1: J1.3, U1.5
G2: J1.15, U4.5
G#1: J1.4, U1.7
G#2: J1.16, U4.7
GND: J1.21, R1.1, R2.1, R3.1, R4.1, R13.1, R14.1, R15.1, R22.1, R23.1, R28.1, R29.1, R30.1, R31.1, R40.1, R41.1, R42.1, R43.1, R52.1, R53.1, R54.1
unnamed: D1.1 (K), U1.16
unnamed: D2.1 (K), U1.14
unnamed: D3.1 (K), U1.12
unnamed: D4.1 (K), U1.10
unnamed: D5.2 (A), R9.2
unnamed: D6.2 (A), R10.2
unnamed: D7.2 (A), R11.2
unnamed: D8.2 (A), R12.2
unnamed: D9.1 (K), U2.16
unnamed: D10.1 (K), U2.14
unnamed: D11.1 (K), U2.12
unnamed: D12.2 (A), R19.2
unnamed: D13.2 (A), R20.2
unnamed: D14.2 (A), R21.2
unnamed: D15.1 (K), U2.10
unnamed: D16.1 (K), U3.16
unnamed: D17.2 (A), R26.2
unnamed: D18.2 (A), R27.2
unnamed: D19.1 (K), U4.16
unnamed: D20.1 (K), U3.14
unnamed: D21.1 (K), U3.12
unnamed: D22.1 (K), U3.10
unnamed: D23.2 (A), R36.2
unnamed: D24.2 (A), R37.2
unnamed: D25.2 (A), R38.2
unnamed: D26.2 (A), R39.2
unnamed: D27.1 (K), U5.16
unnamed: D28.1 (K), U4.12
unnamed: D29.1 (K), U4.10
unnamed: D30.1 (K), U4.14
unnamed: D31.2 (A), R48.2
unnamed: D32.2 (A), R49.2
unnamed: D33.2 (A), R50.2
unnamed: D34.2 (A), R51.2
unnamed: D35.1 (K), U5.14
unnamed: D36.1 (K), U5.12
unnamed: D37.1 (K), U5.10
unnamed: D38.2 (A), R58.2
unnamed: D39.2 (A), R59.2
unnamed: D40.2 (A), R60.2
unnamed: L1.2, Q1.2 (D), R9.1
unnamed: Q1.1 (G), R5.2, U1.15
unnamed: L2.2, Q2.2 (D), R10.1
unnamed: Q2.1 (G), R6.2, U1.13
unnamed: L3.2, Q3.2 (D), R11.1
unnamed: Q3.1 (G), R7.2, U1.11
unnamed: L4.2, Q4.2 (D), R12.1
unnamed: Q4.1 (G), R8.2, U1.9
unnamed: L5.2, Q5.2 (D), R19.1
unnamed: Q5.1 (G), R16.2, U2.15
unnamed: L6.2, Q6.2 (D), R20.1
unnamed: Q6.1 (G), R17.2, U2.13
unnamed: L7.2, Q7.2 (D), R21.1
unnamed: Q7.1 (G), R18.2, U2.11
unnamed: L8.2, Q8.2 (D), R26.1
unnamed: Q8.1 (G), R24.2, U2.9
unnamed: L9.2, Q9.2 (D), R27.1
unnamed: Q9.1 (G), R25.2, U3.15
unnamed: L10.2, Q10.2 (D), R36.1
unnamed: Q10.1 (G), R32.2, U4.15
unnamed: L11.2, Q11.2 (D), R37.1
unnamed: Q11.1 (G), R33.2, U3.13
unnamed: L12.2, Q12.2 (D), R38.1
unnamed: Q12.1 (G), R34.2, U3.11
unnamed: L13.2, Q13.2 (D), R39.1
unnamed: Q13.1 (G), R35.2, U3.9
unnamed: L14.2, Q14.2 (D), R48.1
unnamed: Q14.1 (G), R44.2, U5.15
unnamed: L15.2, Q15.2 (D), R49.1
unnamed: Q15.1 (G), R45.2, U4.11
unnamed: L16.2, Q16.2 (D), R50.1
unnamed: Q16.1 (G), R46.2, U4.9
unnamed: L17.2, Q17.2 (D), R51.1
unnamed: Q17.1 (G), R47.2, U4.13
unnamed: L18.2, Q18.2 (D), R58.1
unnamed: Q18.1 (G), R55.2, U5.13
unnamed: L19.2, Q19.2 (D), R59.1
unnamed: Q19.1 (G), R56.2, U5.11
unnamed: L20.2, Q20.2 (D), R60.1
unnamed: Q20.1 (G), R57.2, U5.9
unnamed: R1.2, U1.2
unnamed: R2.2, U1.4
unnamed: R3.2, U1.6
unnamed: R4.2, U1.8
unnamed: R13.2, U2.2
unnamed: R14.2, U2.4
unnamed: R15.2, U2.6
unnamed: R22.2, U2.8
unnamed: R23.2, U3.2
unnamed: R28.2, U4.2
unnamed: R29.2, U3.4
unnamed: R30.2, U3.6
unnamed: R31.2, U3.8
unnamed: R40.2, U5.2
unnamed: R41.2, U4.6
unnamed: R42.2, U4.8
unnamed: R43.2, U4.4
unnamed: R52.2, U5.4
unnamed: R53.2, U5.6
unnamed: R54.2, U5.8
