slacshan/MIDI-Projects/(commit log)

2025-11-19 initial file uploads
    [10thFretBar.SLDPRT, 10thFretBar.STL, 11thFretBar.SLDPRT, 11thFretBar.STL, 12thFretBar.SLDPRT, 12thFretBar.STL, 14thFretBar.SLDPRT, 14thFretBar.STL]
2025-12-01 updating files
    [2020T.ipt, JustinHours.xlsx, MuteMount.0002.ipt, MuteMount.ipt, MuteMount.stl, NeckRest.ipt, PluckMount.ipt, PluckMount.stl]
2025-12-03 added the slave code for I2C 3 byte recive.
2025-12-04 Untracked files in the gitignore and updated the master code to now recive midi and send it via I2C. It still need to be formated and made to work with the 2 dip switches.
2025-12-05 master has code to filter by channel and I am currently working on getting the note filter to work now. -Payden
2025-12-08 week 7s work and updating hours
    [2020T.stl, BoarMountingPlate.dwg, GenrealBar.stl, JustinHours.xlsx, LongPluckMount.0001.ipt, LongPluckMount.0002.dwg, LongPluckMount.dwg, LongPluckMount.ipt]
2025-12-08 no longer using filter file, still working on the note filter. -payden
2025-12-09 possibly fixed the note filter but need to test and verify its operation. -payden
2025-12-09 added my flowchart for the master code. -Payden
2025-12-09 updated hours
    [2020DoubleT.0001.ipt, 2020DoubleT.dwg, 2020DoubleT.ipt, 2020DoubleT.stl, JustinHours.xlsx]
2025-12-10 new pcb mounting plate
    [BoarMountingPlate.dwg]
2025-12-16 updated cad files and hours
    [FretBar.0007.ipt, FretBar.ipt, FretBar.stl, JustinHours.xlsx, PluckTool.0005.ipt, PluckTool.ipt, PluckTool.stl]
2025-12-16 made BOM
    [BOM.xlsx, JustinHours.xlsx]
2025-12-17 added jasons and brandons slave code, added time sheets and test songs. -Payden
    [FinalProjectTimeSpent_Payden.xlsx]
2025-12-18 made pdfs for final report
    [2020T.0001.ipt, 2020T.dwg, 2020T.ipt, BOM.xlsx, BoarMountingPlate.dwg, FretBar.dwg, JustinHours.xlsx, MidiNotes&RealNotes.xlsx]
