slacshan/MIDI-Projects/Documentation/S25/Images/Master Pic ain breadboard.jpg

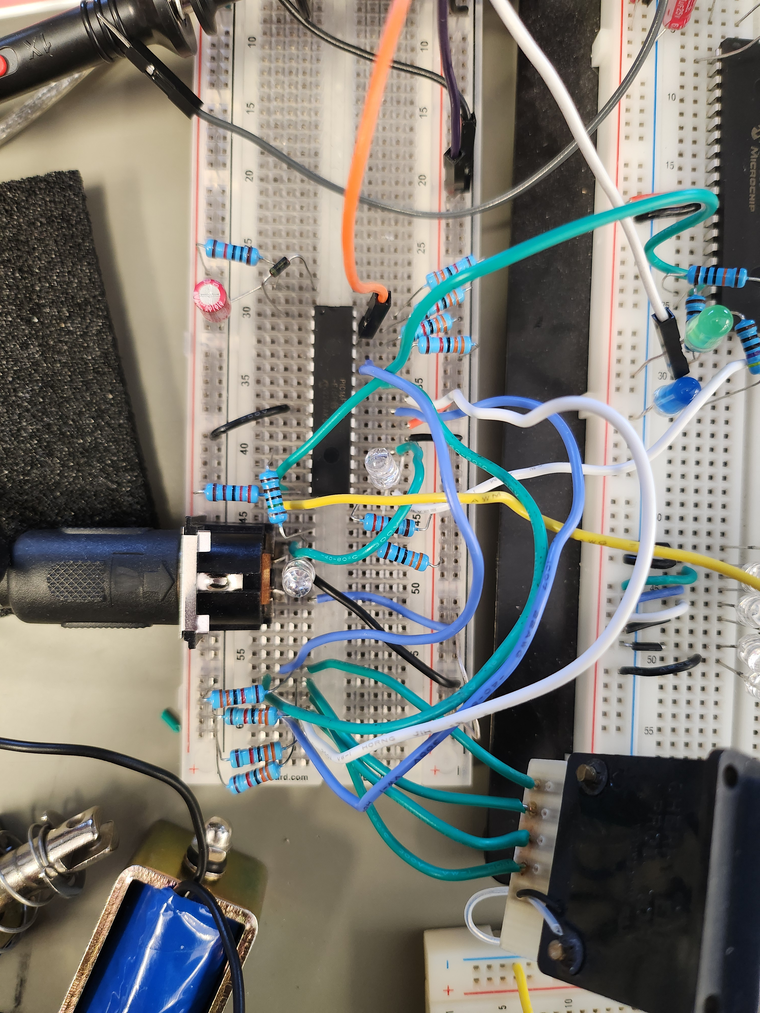
Documentation/S25/Images/Master Pic ain breadboard.jpg
